2AMLogic/gf180-temp-por/README.md

# gf180-temp-por

A temperature sensor + power-on-reset (POR) pair, targeting the
[gf180mcu](https://gf180mcu-pdk.readthedocs.io/) open PDK.

fleet burndown

## What this is

This is one of 2AM Logic's canary blocks: a small, self-contained analog
IP block used both as a real design deliverable and as a forcing function
for the open-source analog tooling it's built with. The design work —
architecture survey, device characterization, schematic entry, testbench
authoring, simulation, and (eventually) layout — is carried out by AI
agents driving an open-source flow end to end.

## Status: early-stage, in progress

Nothing here should be read as a finished or measured result — there is
no silicon yet, and no tapeout-ready sign-off. As of this writing the
project has:

- ratified a target specification and architecture direction through a
  series of recorded decisions (`spec/decision-records/`),
- characterized the relevant gf180mcu devices (vertical PNP, resistor
  flavors, MOS options) against a bootstrap simulation harness,
- recorded PVT-corner simulation evidence for the schematic-level design
  (`sim/`, append-only),
- entered the block's top-level schematic hierarchy and pad interface in
  xschem, with a reproducible ngspice netlist export (`design/`),
- brought up a repeatable, klayout-tools-driven DRC/LVS flow and drawn
  all four of the block's sub-circuits — `bias_core`, `por_comparator`,
  `por_output_chain` and `temp_core` — plus the top-level assembly
  `temp_por_top`, as real device geometry: DRC clean and LVS-matched
  against their schematic-derived netlists, with the reports committed
  under `layout/reports/` (issues #90, #91, #92, #93 for the cells and
  #97 for the reassembly, all closed), and
- re-run the whole verification suite against a parasitic-extracted
  netlist of that layout, recorded as new append-only evidence in `sim/`
  (issue #18 and its children #82–#87).

**Where that leaves the layout.** It is drawn and assembled. DRC is
clean on all five cells including `temp_por_top` (239 devices, 143
nets), and each is LVS-matched device-for-device and net-for-net against
its schematic-derived reference netlist — **whole**, with no device
excluded. The last exclusion was `temp_core`'s MiM compensation cap
`XCC`, spliced into post-layout netlists at its schematic value rather
than drawn; it is drawn and routed as of #259, executing
[DR-028](spec/decision-records/DR-028-temp-core-xcc-draw-it.md) (issue
#177), which found both of its recorded justifications expired. Nothing
in `layout/postlayout/` is spliced in ideal any more. Recorded `sim/`
results that predate it stay valid for the netlists they name, and say
so in their own provenance lines. The separate
[`ERC supply report`](layout/reports/temp_por_top/erc_supply.json) now
checks four declared well/substrate-tie classes: zero findings, all four
checked, none skipped. This checks connectivity using asserted tap/well
geometry; it does not establish implant correctness or latch-up sign-off.
[`layout/README.md`](layout/README.md#ercmissing_tie-now-computed-310)
documents that scope and the separate `klt` build used for this report.

**The assembled footprint measures 1.059 mm² (1334 × 794 µm), not "tiny."**
This block's stated reason to exist includes that a small, self-contained
design "rides along on any shuttle seat" — that claim had no number behind
it until now. The measured footprint is ~21× the ≤0.05 mm² wave-1 planning
budget `spec/target-spec.md#area` carried before layout (the sum of the
four sub-cells' own boxes is smaller, ~0.34 mm², still ~7× over). The
planning bound is recorded as **not met**, not deleted or relaxed — see
[DR-022](spec/decision-records/DR-022-area-post-layout-measurement.md) for
the measurement convention and the disposition, and
[`layout/reports/temp_por_top/stats.json`](layout/reports/temp_por_top/stats.json)
(regenerated by `layout/run_checks.sh`) for the regenerable evidence.

**Post-layout verification has run, and the suite is not green.** The
roll-up is
[`design/temp_por_top.md`](design/temp_por_top.md) § "Closing roll-up for
issue #18": every testbench with a DUT in the layout has been re-run
against the extracted netlist across the full 81-point PVT grid, and the
results are recorded rather than summarized away. Reset timing lengthens
by a uniform ~2 %, which costs no ratified corner. Several ratified rows
still fail — some from before layout (`spec/` decision records DR-011 and
DR-014/DR-017 own those), some newly under extraction — and each is
routed to its own open issue rather than absorbed. One target was
re-costed against measured evidence through a decision record (DR-018),
not quietly relaxed. And the block's cross-domain IR-drop and crosstalk
question is **not answered by anything in this repository**. The current
`klt 0.6.0` extraction models per-net resistance as a star and includes
vertical-overlap coupling, so first-order rail drop and coupling are now
represented. It still lacks distributed route resistance and lateral/fringe
coupling; the older records used a model with neither effect. As the
[`post-layout roll-up`](design/temp_por_top.md#1-the-ir-drop--crosstalk-watch-item-cannot-be-answered-by-this-repos-tooling-today)
explains, no record in `sim/` may be cited as cross-domain IR-drop or
crosstalk evidence.

Full testbench sign-off has not happened. Every claim this project makes
is expected to be backed by a testbench and by PVT corner data recorded
in `sim/`, not asserted without evidence — until a stage is checked off
above, treat it as not yet done.

## The agent-native build

This block is designed, simulated, and verified with AI agents as the
primary workers, driving the flow directly rather than assisting a human
doing the driving. Decisions are captured as they're made
(`spec/decision-records/`), and simulation results are recorded
append-only as evidence (`sim/`) rather than overwritten, so the design
history stays auditable end to end. That's not a caveat on the work —
it's the point of the project: proving out what an agent-driven,
open-tooling analog design flow can actually deliver.

## Toolchain

- **PDK**: [gf180mcu](https://github.com/google/gf180mcu-pdk) (open PDK)
- **Design / simulation**: [xschem](https://xschem.sourceforge.io/) +
  [ngspice](https://ngspice.sourceforge.io/)
- **Layout**: [klayout-tools](https://github.com/2AMLogic/klayout-tools),
  a companion open-source project built to make KLayout-based DRC/LVS and
  layout automation workable for an agent-driven flow. Wherever
  klayout-tools proves awkward or is missing a capability this design
  needs, that friction gets filed as a public issue there — this project
  is one of the reasons that tool exists.

## Chipalooza

This block is the Phase-1 entry for its class in
[Open Circuit Design's Chipalooza Challenge #3](https://opencircuitdesign.com/chipalooza/challenge-3.html)
(GF180MCU / Wafer.Space). The proposal document —
[`docs/chipalooza/challenge-3-proposal.md`](docs/chipalooza/challenge-3-proposal.md) —
re-derives every numeric claim from this repository's own `sim/` evidence at
the challenge's rails, and explicitly marks the rows and the rail (5.0 V)
that are not yet characterized.

## Layout of this repo

```
spec/          target specification + decision records
design/        schematics / netlists (xschem)
sim/           testbenches + PVT corner results (ngspice)
layout/        GDS + DRC/LVS reports (klayout-tools driven)
signoff/       machine-graded T1 evidence claim + verdict (klt signoff)
measurements/  silicon characterization (empty until tape-out)
```

The block's target specification — one row per spec line, with conditions,
binding corner, and the decision record each value comes from — is
[`spec/target-spec.md`](spec/target-spec.md); the decisions behind it are in
[`spec/decision-records/`](spec/decision-records/).

## Simulation

PVT corner runs go through the harness in `sim/` (stdlib python3, no venv;
needs `ngspice` and a gf180mcu PDK install):

```bash
python3 sim/run_corners.py --check-env     # is ngspice + the PDK present?
python3 sim/run_corners.py --list          # experiments, corners, corner sets
python3 sim/run_corners.py <experiment>    # run the full PVT grid, mint a record
bash sim/selftest.sh                       # prove the harness works end to end
source sim/env.sh                          # same PDK in an interactive ngspice/xschem
```

Every run writes an append-only evidence record under
`sim/<experiment-slug>/records/`. The record format is authoritative in
[`sim/README.md`](sim/README.md); how to run the harness and write a
testbench is in [`sim/harness/README.md`](sim/harness/README.md).

## Layout verification

DRC and LVS run headless through [`klt`](https://github.com/2AMLogic/klayout-tools)
(no GUI, no PDK install needed for the checks themselves):

```bash
bash layout/run_checks.sh --check-env      # which klt / deck / PDK
bash layout/run_checks.sh                  # DRC + LVS + both negative controls
```

Reports land under `layout/reports/` and are committed as evidence. What the
flow proves — and the curated-deck limits that bound it — is documented in
[`layout/README.md`](layout/README.md).

## Evidence maturity: where this block sits on the T1 ladder

klayout-tools defines a four-tier evidence ladder
([`docs/design-evidence-tiers.md`](https://github.com/2AMLogic/klayout-tools/blob/main/docs/design-evidence-tiers.md));
T1, "sim-validated", has an eleven-item checklist. **This repo's answer to
"how far along is it?" is graded mechanically, not written by hand:**

```bash
uv tool install --force klayout-tools==0.7.0   # the pinned grader
python3 signoff/check.py                        # re-grade; fails on evidence rot
```

- [`signoff/block-manifest.json`](signoff/block-manifest.json) is the claim —
  per checklist item, the evidence envelope that backs it.
- [`signoff/tier-report.json`](signoff/tier-report.json) is the verdict
  `klt signoff --manifest` rendered against it, committed as evidence.
- [`signoff/README.md`](signoff/README.md) reads that verdict out item by item,
  with the coverage gaps and disclosed exceptions each `met` row carries.

The verdict today is **`tier: null` — 8 of 11 items met**. That is deliberately
a stricter question than "does the repo contain the artifact?", and the report,
not any prose in this repo, is the answer of record. CI re-runs it on every
push and pull request, so a claim citing an artifact that has since changed
fails rather than quietly rotting.

## Independent verification (Chipalooza)

Written for someone who has never touched this repository. This is what the
Chipalooza schematic-design review's stated bar
([2AMLogic/2am#542](https://github.com/2AMLogic/2am/issues/542), quoted in
full in [issue #292](https://github.com/2AMLogic/gf180-temp-por/issues/292))
needs: clone this repository, install the prerequisites below, and reproduce
the full simulation campaign behind
[`docs/chipalooza/challenge-3-proposal.md`](docs/chipalooza/challenge-3-proposal.md)'s
§4 spec table from three single command-line invocations, with no step that
only works from this repository's already-checked-out state — plus two short
named derivation commands for five rows that need a manual second step (see
"[Mapping the proposal's spec table to output
files](#mapping-the-proposals-spec-table-to-output-files)" below).

### Prerequisites

| Tool | Version | Why | Install |
|---|---|---|---|
| `ngspice` | any recent release (`ngspice-46` is what this repo's own evidence and CI use) | circuit simulation | `apt-get install ngspice` / `brew install ngspice` |
| gf180mcu PDK | `open_pdks` commit `c6d73a35f524070e85faff4a6a9eef49553ebc2b` — the revision this repo's committed `sim/` evidence and `.github/workflows/ci.yml` are taken against | device models | `pip install volare && volare enable --pdk gf180mcu c6d73a35f524070e85faff4a6a9eef49553ebc2b`, or an equivalent [`ciel`](https://github.com/efabless/ciel)/[IIC-OSIC-TOOLS](https://github.com/iic-jku/iic-osic-tools)-provisioned install |
| `xschem` | ≥ 3.4.7 | schematic capture / netlist export — **not** needed to run `make check`/`make smoke`/`make characterize` below, which simulate the netlists already committed under `design/netlist/`; only needed to regenerate them | build from source per [`design/README.md`](design/README.md)'s Requirements note (Ubuntu's apt package below 3.4.7 has a netlisting regression) |
| python3 | ≥ 3.9 | the simulation harness itself | stdlib only — no pip packages needed for `make check`/`make smoke`/`make characterize` |
| `klayout-tools` (`klt`) 0.6.0, KLayout, Magic, Netgen | pinned in [`layout/toolchain.json`](layout/toolchain.json) | layout DRC/LVS/extraction | `uv tool install --force klayout-tools==0.6.0`; KLayout/Magic/Netgen themselves come bundled with a `ciel`/IIC-OSIC-TOOLS PDK install, or install separately per `klayout-tools`' own docs |

The last row is listed for completeness of the open-source flow this project
uses end to end ([`layout/README.md`](layout/README.md)); it is **not**
exercised by the three `make` targets below, which are simulation-only —
layout DRC/LVS is `bash layout/run_checks.sh` (previous section), a separate
entry point with its own toolchain pin. No tool anywhere in this flow is
proprietary.

**PDK environment.** The harness never hardcodes a PDK path. Set **one** of
`GF180_PDK_PATH=/path/to/gf180mcuD` (the variant directory itself) or
`PDK_ROOT=/path/to/pdk/root` (+ optionally `PDK=gf180mcuD`, the
open_pdks/OpenLane convention) before running any target below —
`python3 sim/run_corners.py --check-env` reports exactly what got resolved,
and `sim/harness/README.md`'s "Prerequisites" section documents the full
resolution order (`sim/harness/pdk.py`) if neither is set.

### The three make targets

Run these from the repository root.

| Target | What it does | Measured wall-clock (8-core host, this repo's own dry run below) | Exit code |
|---|---|---|---|
| `make check` | `sim/build_tb.py --check` (testbench fragments match `design/netlist/` exports) + `make test` (`sim/tests`/`layout/tests`/`signoff/tests`/`scripts/tests` unit tests) (headless, no PDK needed) + an explicit environment/PDK report (`sim/run_corners.py --check-env`) | ~2 s | non-zero on any failure, including a missing PDK or ngspice |
| `make smoke` | `sim/selftest.sh`: harness unit tests plus a full-PVT-grid (81-point) run of the harness's own acceptance testbench, `sim/smoke-bias/` (an ideal divider, a PDK poly-resistor/nfet bias, and the same vertical-PNP diode the sensing core's CTAT leg is built from) — proves ngspice, the PDK, and the corner-sweep mechanics all actually work, fast | ~3-4 s | non-zero on any failure |
| `make characterize` | The full campaign behind the proposal's §4 spec table: every **schematic-level** experiment discovered under `sim/*/testbench/` — the full 81-point PVT grid for a deterministic experiment (`sim/run_corners.py`), or the full N≥500-per-binding-point Monte Carlo sweep for one that carries an `"mc"` block (`sim/run_mc.py`) — each minting a new append-only evidence record | see "Fresh-clone dry run" below | non-zero if any experiment fails |

`make characterize` is `python3 sim/characterize.py`, a thin driver over the
two entry points above (`sim/characterize.py`'s module docstring has the
full rationale, including why `testbench-postlayout/` re-runs are
deliberately out of scope — they are triggered by a layout change, not by
routine characterization, and this project's post-layout re-run already
exists as separately-recorded evidence). List what a run would do without
running it (`python3 sim/characterize.py --list`), or run just one
experiment (`python3 sim/characterize.py --only <slug>`) — both useful for
checking one spec row without paying for the whole campaign.

### Where results land

Every `make characterize` run mints one new `<record-id>` per experiment and
writes, under `sim/<experiment-slug>/`:

- `records/<record-id>.md` — the append-only summary record (the field set
  [`sim/README.md`](sim/README.md) defines)
- `netlist-snapshots/<record-id>.spice` — the frozen netlist fragment that
  record was taken against
- `corners/<record-id>/<corner-id>.log` — raw ngspice output, one file per
  PVT point (or per Monte Carlo sample)

Records are **never overwritten**; re-running `make characterize` mints new
record-ids alongside whatever is already committed, per `sim/README.md`'s
append-only rule.

### Mapping the proposal's spec table to output files

[`docs/chipalooza/challenge-3-proposal.md`](docs/chipalooza/challenge-3-proposal.md)
§4's Evidence column already names, for every row, the exact
`sim/<slug>/records/<record-id>.md` file that row's number was measured
from. Because every `make characterize` run mints a **new** record-id by
design (the append-only rule above), the literal filename in that column is
not what your own run will reproduce — the stable mapping is the
**experiment slug**, the path component right after `sim/`. Read the slug
out of an Evidence citation (e.g. `sim/por-vth/records/...` → `por-vth`) and
look in `sim/<that-slug>/records/` for the record your run just wrote.
`python3 sim/run_corners.py --list` / `python3 sim/run_mc.py --list` print
every slug next to the spec claim it substantiates, and
`python3 sim/characterize.py --list` prints the same slugs in the order a
full campaign runs them.

**Two exceptions**, both disclosed at their row in the proposal's §4 table:
`sim/temp-accuracy-mc/`'s `-breakdown.md` attribution file (§4.1) and every
`sim/por-iq/*-derived.md` file (§4.3) are not written directly by
`make characterize` — each is a second, manual derivation step run against a
record `make characterize` did mint (`python3
sim/temp-accuracy-mc/analyze_breakdown.py <record-id> --write` and `python3
sim/por-iq/analyze_por_iq.py <temp-accuracy-vt-record-id> --write`,
respectively). `por-iq` itself has no `testbench/tb.json` and is not one of
the 22 slugs `sim/characterize.py --list` enumerates — do not look for it
there. (§4.4's footprint row is a third exception, but a categorically
different one: it is layout evidence, regenerated by
`bash layout/run_checks.sh`, not simulation evidence at all.)

### Fresh-clone dry run

Performed against a real `git clone --no-local` of this work into `/tmp`
(forces an actual file copy, not a hardlinked shortcut back to the
development checkout), with the environment stripped to `HOME`, `PATH`, and
`GF180_PDK_PATH` only (`env -i`) — nothing else carried over from the
development shell:

```
$ git clone --no-local <this-repo> /tmp/gf180-dry-run/repo    # 7.5s, 22,997 files
$ cd /tmp/gf180-dry-run/repo
$ env -i HOME="$HOME" PATH="$PATH" GF180_PDK_PATH=~/.volare/gf180mcuD make check    # 4.4s, exit 0
$ env -i HOME="$HOME" PATH="$PATH" GF180_PDK_PATH=~/.volare/gf180mcuD make smoke    # 4.6s, exit 0
$ env -i HOME="$HOME" PATH="$PATH" GF180_PDK_PATH=~/.volare/gf180mcuD make characterize
```

`make check` and `make smoke` both passed (exit 0) from a directory tree
that had never seen this repository's development checkout — no absolute
path, cached result, or machine-local script from that checkout was needed.

`make characterize` correctly drove `sim/characterize.py` against the fresh
clone: it discovered all 22 experiments, resolved the same PDK via
`GF180_PDK_PATH`, and began minting real per-corner ngspice logs for the
first experiment. **A clean single-number wall-clock total for the full
22-experiment campaign is not available from this dry run**: the host this
was performed on was, at the time, running roughly two dozen other
unrelated ngspice processes from other agents' concurrent work in sibling
worktrees (visible in `ps aux`) — on an 8-core machine, that is what
actually turned one PVT point's cost from the ~1.5 s measured in relative
isolation (below) into 10-20 s, not anything about this fresh clone or
`sim/characterize.py` itself. The run was stopped after 6m28s, 30/81 points
into the first of 22 experiments, rather than let it continue for an
unbounded time under that contention. A more honest wall-clock reference is
the two full-campaign-representative runs measured earlier in this same
session, in relative isolation, against the same PDK:

| Experiment | Grid | Measured wall-clock (`-j 4` default, 8-core host, uncontended) |
|---|---|---|
| `por-vth` (full-assembly, transient, 81-point PVT grid) | PVT | 127.4 s |
| `por-threshold-mc` (5 binding points × N=500 samples) | Monte Carlo | 181.4 s |
| `smoke-bias` (harness self-test, 81-point PVT grid) | PVT | 1.8 s |

Extrapolating those across the 20 discovered PVT-grid experiments (transient
lengths vary; `por-vth` is a heavier-than-typical full-assembly case, not
the average) plus the 2 Monte Carlo experiments puts a full
`make characterize` campaign at **on the order of 30-60 minutes on an
uncontended host** — this is an estimate from partial, isolated
measurements, not a single measured total, for the reason above. What *is*
directly verified, from this same dry-run clone and from the development
checkout alike: `sim/characterize.py --list` correctly enumerates all 22
experiments (`sim/tests/test_characterize.py`), `--only <slug>` correctly
restricts a run to one experiment, and a representative subset run
(`smoke-bias`, `por-threshold-mc`) completes and exits 0 end to end,
including minting real evidence records.

## License

Apache License 2.0 — see [LICENSE](LICENSE).
