2AMLogic/gf180-temp-por/layout/README.md

# layout/ — DRC/LVS flow for gf180mcu, driven by klayout-tools

This directory holds the block's layout artifacts and the **repeatable DRC/LVS
invocation** they are checked with. It is `klt`-driven end to end: no GUI, no
interactive KLayout session, no netgen/magic.

> **Status: the block's layout is drawn and assembled — as far as the deck can
> see it.**
> #16 brought the flow up on one two-device proof cell. #68 added `bias_core`
> (**34** MOS devices), #69 `por_comparator` (**18**), #70 `por_output_chain`
> (**28**, after issue #56's release latch) and #71 `temp_core` (**55** drawn:
> 39 schematic MOS split into
> interleaved fingers, plus 6 edge dummies). #72 assembles all four into
> **`temp_por_top`** — with the domain-seam moat, the perimeter guard ring and
> the `VDD`/`VSS` rails. #92 then drew `por_output_chain`'s **2 MiM caps** (5
> drawn units) as the first non-MOS devices in the block, and #93 folded
> `temp_core`'s PNP array and `R2` gain ladder into the extracted cell as real
> `bjt`/`ppolyf_u` devices (**114** drawn, up from 55), retiring the sibling
> top cells that used to hold them. #91 then drew `por_comparator`'s
> 3-segment sense divider as real `ppolyf_u_1k`-class poly resistors (**21**
> drawn, up from 18), and #90 drew `bias_core`'s **16**: 10 vertical PNPs, 4
> poly resistors (strung into 24 legs) and 2 MiM caps. Finally #259 drew
> `temp_core`'s own MiM cap `XCC` (**115** drawn, up from 114), which was the
> last golden device anywhere in the block that the layout did not draw.
> **Every sub-circuit is now whole at the *cell* level, with nothing left
> over** — every device in all four schematics is drawn, extracted and
> compared. `temp_por_top` has caught up with all four of #90/#91/#92/#93 and
> issue #56's release latch (#97): re-deriving its floorplan against the four
> grown sub-cell footprints (`por_comparator`'s divider and `bias_core`'s
> passives had each outgrown the #72-era gap between instances) took the
> assembly from **198** to **238** devices and **131** to **159** nets, and
> #259's cap takes it to **239** (the net count is **145** since #264 routed
> the MiM plates onto real nets) — same ratified 5-pad pinout, same
> guard-ring/rail/seam-moat treatment. Every cell under test is
> LVS-clean against the schematic-derived netlist with every applicable
> negative control detected (three per cell where a cell draws a resistor or a
> bipolar: topology, device-param, and passive-param). **DRC is clean
> everywhere, and the committed reports now say so.** `por_comparator`'s
> committed `drc.json` used to read `clean` while recorded under an older
> `klt` whose `"enclosing"` primitive missed zero-overlap escapes
> ([klayout-tools#318](https://github.com/2AMLogic/klayout-tools/issues/318),
> fixed upstream); that cell's *unchanged* committed GDS failed **2×
> `poly2.enclosing.contact.1`** under a newer deck — a real drawing defect
> that was always there, fixed by #102, root-caused by #103 (which also added
> the deck-hash guard that catches this class of stale-report drift), and
> confirmed clean again by #106's whole-flow re-regeneration (which also added
> the GDS-hash guard below, catching the same class of drift one level deeper —
> a report disagreeing with *its own* GDS rather than with another report's
> deck). `temp_por_top`'s own #97 re-derivation picks up that fix by
> rebuilding against `por_comparator`'s current (post-#102) GDS, so the
> reassembled top cell is DRC-clean too, not just its four sub-cells in
> isolation. Every committed report now names the one same `klt` deck and the
> one same GDS it was generated from — the `por_comparator` section and
> [Known deck limits](#known-deck-limits--what-a-clean-lvs-here-does-not-prove)
> have the full trace.
> `temp_core`'s own MiM cap is the one device still outside what the curated
> deck can extract, deliberately not drawn *into the extracted cell*, and
> inherited unchanged by `temp_por_top`, which therefore cannot be LVS'd whole
> either (see
> [The cells under test](#the-cells-under-test) and
> [Known deck limits](#known-deck-limits--what-a-clean-lvs-here-does-not-prove)).
> **What no check in this flow covers** is guard-ring and well-tie
> *correctness*: the deck has no tap or well-label layer, so a broken or
> floating ring is DRC-clean and LVS-match. `temp_por_top` therefore carries
> its own build-time geometric checks for that; see its section below.
> #17's floorplan sketch and matching plan — the ranked, #15-data-driven
> common-centroid/interdigitation/guard-ring plan this flow's cells implement —
> is [`layout/floorplan.md`](floorplan.md).

## Run it

```bash
bash layout/run_checks.sh              # every cell under layout/cells/
bash layout/run_checks.sh <cell>       # one cell
bash layout/run_checks.sh --check-env  # what klt/PDK am I about to use?
bash layout/run_checks.sh --regen-all  # re-stamp every cell onto
                                       # one deck (see 0b below)
```

Exit 0 means, for every cell: the committed GDS and reference netlist are
current, DRC is clean, extraction succeeded, LVS matches, **and** both LVS
negative controls were detected. Every JSON report is rewritten under
`layout/reports/` and committed as evidence.

### The pinned toolchain

Every report under `layout/reports/` is evidence for **one** `klt` build, and
which one is declared in [`layout/toolchain.json`](toolchain.json):

```json
"klt":  { "version": "klt 0.6.0", "install": "uv tool install --force klayout-tools==0.6.0",
          "release": { "package_version": "0.6.0", "git_tag": "v0.6.0", "git_commit": "c622e8ad…" } },
"deck": { "name": "gf180mcu", "content_hash": "sha256:95c2eb91…" }
```

The **deck content hash is the identity**, not the version string. A source
build of `klayout-tools` made after a release tag still reports that tag's
package version, so a post-tag build and the release it was built after both
say `klt 0.6.0` while shipping different decks — which is how this repo's
entire committed evidence base came to name a deck no release ships (#258; see
[Known deck limits](#known-deck-limits--what-a-clean-lvs-here-does-not-prove)
for the full account and the tool-side issue it was filed as). The pin moved
from `klt 0.2.0` to `klt 0.6.0` in #311/#312 — see "Known deck limits" below
for what changed in the deck between those two releases and what it meant for
this block's reference netlists.

Two gates enforce the pin, and they check different things:

- **Live**, before anything is written: `run_checks.sh` probes the `klt` on
  `PATH` (a throwaway `klt drc` on the smallest committed cell) and refuses to
  run unless the deck hash it reports *is* the pinned one. The error names the
  install command. This is what makes the pin a precondition rather than a
  note.
- **Committed**: `python3 layout/lvs_reference.py --check-deck-hash` requires
  every committed `drc.json` to name the pinned hash — not merely to agree
  with its neighbours, which is the check that passed all the way through the
  incident above.

Moving the pin is a deliberate act: edit `layout/toolchain.json`, install that
build, and run `bash layout/run_checks.sh --regen-all` to re-stamp every
cell onto it in one go.

### Prerequisites

| Need | Why | Check |
| ---- | --- | ----- |
| the **pinned** [`klt`](https://github.com/2AMLogic/klayout-tools) on `PATH` | runs DRC, extraction, LVS | `bash layout/run_checks.sh --check-env` |
| the `klayout` python module | only to *rebuild* `layout/cells/*.gds` | `python3 -c "import klayout.db"` |
| a gf180mcu PDK install | not required by this flow | `klt pdk find` |

`klt --version` is deliberately **not** the check in that first row: it cannot
tell the pinned release from a source build made after it. `--check-env`
reports the pin, the live deck hash, and whether they agree.

`run_checks.sh` finds the `klayout` module on `python3`, else on `klt`'s own
interpreter, else via `uv run --with klayout python3`; if none of those work it
skips only the GDS staleness check and still runs DRC/LVS.

The curated `gf180mcu` DRC and extraction decks are self-contained inside
`klt` — **no PDK install is read** by `klt drc`, `klt extract`, or `klt lvs`
here. That is why this flow runs in environments where the simulation flow
(`sim/`, which does need the PDK) cannot.

## What the flow does, step by step

Everything below is what `run_checks.sh` runs; it is spelled out so a step can
be run by hand while debugging a cell.

**0. Live-toolchain gate.** The very first thing, before any staleness check
and before any report is written: the `klt` on `PATH` has to be the one
[`layout/toolchain.json`](toolchain.json) pins, established by the deck
content hash it actually produces rather than by the version string it
reports. See ["The pinned toolchain"](#the-pinned-toolchain) above for why the
version string is not enough. `bash layout/run_checks.sh --check-env` runs the
same gate and prints both sides without running anything else.

**0a. Staleness gates.** Both generated inputs are regenerated and compared
against what is committed, so a recorded clean run can never be a run against
sources that have since moved:

```bash
python3 layout/build_cells.py   --check   # committed GDS still matches its source
python3 layout/lvs_reference.py --check   # reference netlist still matches design/
```

**0b. Deck-hash gate.** A recorded DRC-clean verdict is only meaningful
relative to one `klt` deck revision, so every committed
`layout/reports/*/drc.json` has to agree on `provenance.deck.content_hash` —
otherwise the evidence describes two different rule sets and a clean report
for one cell says nothing about another's — **and** that one hash has to be
the pinned one, or the whole directory can agree perfectly on a deck nobody
can install (#258). Unscoped even for a single-cell run, since it is a
property of the whole `layout/reports/` directory, not of any one cell:

```bash
python3 layout/lvs_reference.py --check-deck-hash
```

##### Repairing a split: `--regen-all`

The gate's remediation is "regenerate every cell's reports against
one deck" — but the command that does that is `run_checks.sh` itself, which
aborted *at the gate* before it could regenerate anything. A directory that had
legitimately drifted (two correct single-cell PRs landing days apart under
different `klt` builds, each regenerating only its own cell as the convention
below requires) therefore could not be repaired with the documented command, and
every invocation of the script — single-cell runs included — was blocked (#108).

`bash layout/run_checks.sh --regen-all` is the way out. It **defers** the gate
to after the per-cell loop rather than skipping it:

| | plain / single-cell run | `--regen-all` |
| --- | --- | --- |
| deck-hash gate | before any per-cell work | after the per-cell loop |
| on failure | aborts (`set -e`), nothing rewritten | non-zero exit, run is a failure |
| cells | as named (all, or the ones given) | every cell, always |

Deferring is not weakening, and the distinction is the whole point of the flag:

- it is opt-in and never the default — a plain run and a single-cell run still
  gate before touching anything, so a genuinely drifted `layout/reports/` fails
  loudly exactly as it did before;
- `--regen-all` rejects cell arguments (exit 2). It can only ever *establish*
  one shared deck across every cell, never re-stamp a subset — a
  partial regeneration is precisely what produces the drift it exists to fix;
- the same check still has to pass on the **result**, and a failure there fails
  the run. Nothing in the script can waive it.

Note that `--regen-all` defers only the deck-hash gate. The GDS-hash gate below
still runs before the per-cell loop on every invocation, including this one: it
guards a different invariant (a committed report describing a GDS it was not
generated from), and letting a regeneration run overwrite that evidence before
it is checked is exactly what it exists to prevent.

**0c. GDS-hash gate.** A recorded report only means something if it is a
description of the GDS actually committed alongside it. `por_comparator`'s
false-clean `drc.json` (`status: clean`, `violation_count: 0`, empty
`violations`) was textually indistinguishable from a genuine clean one before
#102's fix, because nothing in the report recorded which GDS bytes it was run
against — only manual inspection against a rebuilt stream caught it (#106).
Every committed `layout/reports/<cell>/{drc,extract,lvs,stats}.json` now pins a
digest of its source GDS (`drc.json`/`extract.json`/`stats.json`:
`provenance.gds_sha256`, spliced in by `run_checks.sh` right after `klt drc`/
`klt extract`/`klt stats` write the file, since none of them writes it itself;
`lvs.json`: `environment.layout_sha256`, already `klt lvs`'s own output), and
so does `extracted-parasitics.json` (`layout/postlayout.py --extract`'s own record,
which writes the digest itself — see "Post-layout netlists" below). This
recomputes `sha256(layout/cells/<cell>.gds)` and fails if it disagrees with
any of those, so a cell whose GDS moves without its extraction being re-run
cannot ship a post-layout netlist of a layout that no longer exists. Also unscoped even for a single-cell run:

```bash
python3 layout/lvs_reference.py --check-gds-hash
```

All three gates run before the first per-cell check, and `run_checks.sh` is
`set -e`, so a cell that fails one of them used to abort the whole script —
including the cells that were current (#102).

#### Freezing a cell

There is no cell-freeze mechanism any more. It held a cell's committed
artefacts at a pinned digest (`FROZEN_CELLS` in `lvs_reference.py`, read by both
`--check` paths and by a report guard in `run_checks.sh`) while a tracking issue
reworked it; `temp_por_top` was the only cell ever frozen, and that ended with
#97. With no entries it was dead scaffolding, so #411 removed it. If a future
cell needs a freeze, recover the design from history:
`git log -S"FROZEN_CELLS" -- layout/lvs_reference.py` (the removal is the PR
that closed #411).

**1. DRC.**

```bash
klt drc layout/cells/<cell>.gds --deck gf180mcu --format json
```

Exit 0 = clean, 3 = ran and found violations, 1 = failed to run.

**2. Extraction** — the layout side of the compare, recorded for `#18` to reuse:

```bash
klt extract layout/cells/<cell>.gds --deck gf180mcu \
  --top <cell> -o layout/reports/<cell>/extracted.spice --format json
```

**3. LVS** against the schematic-derived reference. `klt lvs` takes a *request
document*, not positional netlist args; the request re-extracts the layout
inline, so step 2 is recorded evidence rather than a dependency:

```bash
klt lvs layout/cells/<cell>.lvs.json --format json
```

Exit 0 = match, 3 = mismatch, 1 = failed to run.

**4. Footprint / drawn-area stats** — the regenerable source of
[`spec/target-spec.md#area`](../spec/target-spec.md#area)'s measured value
(see [DR-022](../spec/decision-records/DR-022-area-post-layout-measurement.md)):

```bash
klt stats layout/cells/<cell>.gds --format json
```

Needs no `--deck` — `klt stats` reads geometry only (bounding box, total
drawn/union-of-layers polygon area, density, polygon/vertex counts), not
device recognition, so it carries no `provenance.deck` block and sits outside
the deck-hash consistency gate above; only the GDS-hash gate applies to its
report (`stats.json`'s spliced-in `provenance.gds_sha256`, same convention as
`drc.json`/`extract.json`).

**5. Negative controls — the part that makes step 3 mean anything.** A
mis-wired LVS invocation that compares nothing also reports `match`, so a clean
run is not by itself evidence. `layout/lvs_reference.py --corrupt` re-derives
the same reference with exactly one defect injected, and the run **requires**
LVS to report a mismatch for both:

| Control | Defect injected | Catches |
| --- | --- | --- |
| `topology` | one device's source re-tied to the other's supply rail | a compare that ignores connectivity |
| `device-param` | one device's `W` doubled | a compare that checks the graph and ignores device sizes |

They fail independently — that is why there are two, per klayout-tools'
`docs/cli/lvs.md` § "Negative controls".

## Files

```
layout/
  run_checks.sh                  the repeatable invocation (source of truth)
  toolchain.json                 the pinned klt build + deck content hash
  build_cells.py                 builds cells/*.gds, byte-reproducibly
  lvs_reference.py               derives cells/*.reference.spice from design/netlist/
  postlayout.py                  derives postlayout/*.spice from the extraction
  cells/
    <cell>.gds                   the layout stream
    <cell>.reference.spice       generated -- do not edit
    <cell>.lvs.json              the klt lvs request document
    temp_por_top.erc-supply-spec.json  T1 item 11's klt erc supply spec (#300)
    temp_por_top.erc-supply-spec-NOTES.md  the spec's field-justification block
                                  (moved out of the spec itself: klt 0.7.0
                                  rejects unknown spec keys, #2243)
  postlayout/
    <cell>.spice                 the simulatable post-layout netlist
    audit.json / AUDIT.md        what is the layout's and what is not
  reports/
    environment.json             klt version + deck hash + release the reports
                                  were produced with (after the fact; the
                                  precondition is toolchain.json above)
    <cell>/drc.json              klt drc report
    <cell>/extract.json          klt extract report
    <cell>/extracted.spice       the layout-side netlist
    <cell>/lvs.json              klt lvs report
    <cell>/stats.json            klt stats report (bbox footprint + drawn area;
                                  spec/target-spec.md#area evidence, DR-022)
    <cell>/negative-controls.json both controls' verdicts
    <cell>/extracted-parasitics.*  the --parasitics extraction (postlayout.py)
    <cell>/postlayout-smoke.json   that cell's smoke result
    temp_por_top/erc_supply.json   T1 item 11's klt erc supply report (#300)
```

`postlayout.py` writes only the `extracted-parasitics.*` pair; the DRC/LVS
flow's own `extracted.spice` / `extract.json` are never touched by it, so the
byte-stability contract above is unaffected.

Reports are regenerated wholesale by `run_checks.sh` and are byte-stable across
runs (paths are repo-relative, digests are content-based), so a re-run that
changes nothing produces an empty `git diff` — that is the repeatability check.

That byte-stability is across runs with the **same** `klt`, which since #258 is
not left to chance: the committed set is homogeneous by construction, because
every report has to name the deck [`layout/toolchain.json`](toolchain.json)
pins and the live gate refuses to write one that would not. A PR that changes
one cell's geometry still regenerates **that cell's** reports and leaves the
rest alone — `reports/` is append-only evidence (`CLAUDE.md`), and restamping
five other cells' recorded runs as a side effect of touching one would destroy
exactly the provenance the directory exists to carry. What has changed is that
a single-cell regeneration can no longer land on a *different* deck than its
neighbours without the gate saying so. Moving to a new `klt` is therefore a
deliberate, separate act: move the pin, then
`bash layout/run_checks.sh --regen-all`.

Every report also records the GDS stream it was generated from
(`drc.json`/`extract.json`/`stats.json`: `provenance.gds_sha256`; `lvs.json`:
`environment.layout_sha256`) — see "0c. GDS-hash gate" above, and #106.

## Post-layout netlists

`layout/postlayout/<cell>.spice` is the layout of each cell as something
ngspice can run: the drawn devices at their drawn dimensions, the drawn
topology, first-order interconnect R/C, and the schematic's own net names.
It is what `sim/` records with **Netlist provenance: extracted** are run
against, and what #83–#87 consume.

#83's four temp-sensing-domain re-runs are among the consumers:
`sim/temp-core-designer-check/` `20260811-075055-b06af8e`,
`sim/temp-core-startup/` `20260811-074657-7c1c116`, `sim/temp-accuracy-vt/`
`20260811-084152-68c0017` and `sim/temp-accuracy-mc/`
`20260811-090721-3ec259f`. The three corner-sweep records each carry a
`<record-id>-postlayout-delta` derived record (`sim/postlayout_delta.py`)
differencing them against the schematic-level record they supersede; zero
checks regressed, and `design/temp_core.md`'s "Post-layout re-run" section
summarises all four.

```bash
python3 layout/postlayout.py --extract   # re-run klt (needs klt + the deck)
python3 layout/postlayout.py             # regenerate layout/postlayout/
python3 layout/postlayout.py --check     # committed artifacts current? (stdlib only)
```

### How it is built, and why there is a build step at all

`klt extract`'s output is a *comparison* netlist, not a simulation netlist,
and three things stand between the two. None of them is a judgement call;
each is either read out of the tool or derived from `lvs_reference.py`'s own
manifest, and all of them are enumerated per cell in
[`postlayout/AUDIT.md`](postlayout/AUDIT.md).

1. **Device cards name the deck's device classes, not the PDK's models.**
   `M$1 ... nfet L=8U W=1U` has to become an `nfet_03v3` subcircuit call.
   `klt extract --pdk` will do this, and it was tried first — it is not used
   because its bound MOS card **drops the extractor's own measured**
   `AS`/`AD`/`PS`/`PD` and the PDK subcircuit defaults all four to zero, i.e.
   the netlist simulates with no junction capacitance whatsoever. Filed as
   [klayout-tools#695](https://github.com/2AMLogic/klayout-tools/issues/695).
   Binding here instead also keeps this whole directory PDK-free, per
   "Prerequisites" above.
2. **Most nets are anonymous.** These cells label only their pins (and, in
   `temp_core`, its 30 tapped nodes), so the rest come out positional — `$10`.
   `klt lvs`'s `net_correspondence` is an LVS-verified map from every
   extracted net to its reference-netlist name, so `$10` becomes `SNS`. This
   is why the old plan of solving the layout↔schematic net correspondence
   here is gone: the tool reports it now
   ([klayout-tools#311](https://github.com/2AMLogic/klayout-tools/issues/311),
   landed in `klt` 0.2.0), and this flow reads it rather than re-deriving it.
   Every cell is required to be `status: match` with every net paired before a
   netlist is written.
3. **Body and well nets come out isolated.** The extraction deck's
   connectivity stack does not join an Nwell, a substrate ring or a bipolar
   base well to the routing that reaches it — which is why every `lvs.json`
   here carries `device.body_unverified`. Honest for a compare; unsimulatable.
   Each is tied to the net the *schematic* puts it on, taken from
   `lvs_reference.py`'s manifest (so a schematic change moves the tie with it)
   and listed per cell in `AUDIT.md` — 3 ties in `por_comparator`, 9 in
   `temp_por_top`. MiM plates used to need the same treatment
   ([klayout-tools#314](https://github.com/2AMLogic/klayout-tools/issues/314),
   **closed and fixed upstream**), but every drawn cap in the block is now
   routed onto its schematic nodes — `bias_core`'s and `por_output_chain`'s
   by #264, `temp_core`'s `XCC` by #259
   ([DR-028](../spec/decision-records/DR-028-temp-core-xcc-draw-it.md)) — so
   their plates are ordinary nets with nothing left to tie.

Two deck substitutions are also undone, both already documented under "Known
deck limits" below: a `ppolyf_u_3k` body recognised as `ppolyf_u_1k`
(klayout-tools#323) and a `..._m3m4_...` MiM recognised as `..._m4m5_...`
(klayout-tools#315). The drawn geometry is the schematic's in both cases and
only the deck's *name* for it differs, so the emitted card carries the
schematic's model at the **drawn** dimensions. Leaving the deck's name in
would simulate this block on a PDK option it is not built for — a 3× error on
every high-sheet-rho resistor, including the POR sense divider.

### What these netlists do and do not prove

| | |
| --- | --- |
| From the layout | every device and its dimensions; the whole topology; first-order R/C on every net with drawn routing (83–97 % of nets per cell — see `AUDIT.md`) |
| From the schematic | the body/well ties above, and net *names* |
| Not present | **nothing.** Every golden device in all four schematics is drawn, extracted and in the netlist; `AUDIT.md`'s "ideal (not drawn)" column reads 0 for every cell. `temp_core`'s `XCC` was the last exception and #259 drew it ([DR-028](../spec/decision-records/DR-028-temp-core-xcc-draw-it.md)) |

So a claim taken on one of these netlists is a post-layout claim about
interconnect loading and device geometry, and a schematic claim about anything
that turns on a body-tie assumption. `sim/README.md`'s **Netlist provenance**
field requires a record to say so. Records written before #259 name netlists
that did splice `XCC` in ideal, and stay valid for those netlists — the
`sim/` set is append-only, and the caveat in each of their provenance lines
still describes the netlist it names.

### Verification

* `klt lvs` must report `match` with every net paired — that is what makes the
  net correspondence, and therefore every net name in the emitted netlist,
  something other than a guess.
* `--extract` refuses to record an extraction whose `--parasitics` coverage
  reads zero (the shape of
  [klayout-tools#283](https://github.com/2AMLogic/klayout-tools/issues/283)),
  and the coverage is reported per cell in `AUDIT.md` so a future silent-zero
  regression is visible rather than merely absent.
* `layout/tests/test_postlayout.py` re-derives every committed artifact from
  the committed extraction and requires a byte-identical result, so the
  staleness gate runs in CI with no `klt`, no PDK and no ngspice. It also
  carries the negative controls: a corrupted net correspondence must move the
  netlist, an unpaired net must be rejected, a wrong emitter area must be
  rejected.
* The golden schematic netlist and the post-layout netlist are compared at
  **every** PVT corner by the `testbench-postlayout/` experiments under
  `sim/` and their `<record-id>-postlayout-delta` records
  (`sim/postlayout_delta.py`), not by a one-point smoke run. An earlier
  nominal-corner script (`postlayout_smoke.py`, with a `SMOKE.md` table) was
  removed once those landed; the `layout/reports/<cell>/postlayout-smoke.json`
  reports it wrote remain as results, and their `note` fields still name it.

The DC quantities agree with the schematic to within a few parts in a
thousand, which is expected and is not a null result. The parasitic model is
one resistive **star** per net — the net's own name is the hub, each device
terminal on it is a `<net>__t<k>` node, and the net's single lumped series
resistance is split across the `R<net>_t<k>` arms joining them, with the net's
lumped C on the hub and vertical-overlap coupling as a direct capacitor
between two nets (`AUDIT.md` → "The parasitic model"). A DC operating point is
therefore *nearly* invariant under it: only the drawn resistance between a
net's own terminals can move one, which is what the residual ≤0.3 % DC deltas
are. What the agreement proves is that the post-layout netlist is the *same
circuit* — `por_comparator`'s `SNS`/`SNSB` carry no drawn label at all, so
reproducing the schematic's 1.61228 V tap to within 0.01 % is only possible if
the correspondence, the divider's restored sheet rho and the body ties are all
right. The reset-release times are where the drawn interconnect actually
bites: `por_output_chain` +4.1 %, `temp_por_top` +4.0 % against the schematic.
Those are the measurements a post-layout claim should be taken on.

Both of those moved from ≈+2 % when the evidence here was regenerated against
the `klt` `layout/toolchain.json` pins (#314), and the reason is the model
rather than the layout: the previous release modelled a net's whole
interconnect as a *dangling* R–C leg (one series R to a synthetic `<net>__par`
node, one C from that node to the substrate), so its resistance sat in no
signal path at all and only its capacitance loaded the circuit. In the star
the same total resistance is in series between each device terminal and the
rest of its net, which is both a larger delay and a more faithful one.

## The cells under test

### `bias_core` — the shared bias/reference core, whole (#68, completed by #90)

`design/bias_core.sch`'s **50 devices** — all of them — drawn from
`design/netlist/bias_core.spice`. 434.9 × 285.7 µm, 3578 polygons.

**What a clean run here covers.** #68 drew the 34 MOS devices and left the
other 16 out, deliberately: the curated deck recognised `nfet`/`pfet` only, so
a drawn poly resistor body extracted as ordinary interconnect and **shorted its
own two terminal nets** (`NB`–`EC`, `VREF`–`ER`, `NBTOP`–`NB`, `NZ`–`N2`),
which then read as a layout bug in the part of the cell that *could* be
checked. The passive/bipolar area was a blank rectangle on annotation layer
200/0 instead. `klt 0.1.0` declares `bjt`, `ppolyf_u_1k` and
`cap_mim_2f0_m4m5_noshield` as well, so #90 drew them:

| Drawn as | Devices | Recognised by |
| --- | --- | --- |
| Vertical PNPs | `XQ1`, `XQ8A`…`XQ8H`, `XQR` (10) | one shared `Nwell` base, a `Comp` emitter window per device, a per-device `DRC_BJT` mark; collector = substrate, not drawn |
| Poly resistors | `XR1`, `XR2`, `XRT`, `XRZ` (4, folded into **24** legs) | `Poly2` + `RES_MK` + `SAB` + `Resistor`, with `Pplus` for the p+ implant; unmarked bends and heads are the terminals |
| MiM caps | `XCC`, `XCOK` (2) | `FuseTop` + `CAP_MK` + `MIM_L_MK` over a `Metal4` bottom plate |

The four formerly-shorted net pairs are now four pairs of **distinct extracted
nets**, and the reserved 200/0 rectangle is gone. Three DRC rules that used to
appear under `rules_skipped` because no stream drew their layers —
`bjt.separation.comp.1`, `mim.space.1`, `mim.enclosing.fusetop.1` — are now
actually exercised.

That the marker geometry is what does it, rather than the compare being
insensitive to it, was confirmed by rebuilding the same cell with one marker
layer moved to a layer no deck reads:

| Defect built | Result |
| --- | --- |
| `RES_MK` removed | 24 `ppolyf_u_1k` devices gone; **54 nets collapse to 30** — the documented short cascade, exactly the failure #68 avoided by not drawing |
| `DRC_BJT` removed | 10 `bjt` devices gone; the base well net disappears (54 → 53 nets) |

Consequences to carry forward, stated so nobody has to re-derive them:

- **Sheet resistance is the PDK's default option, not the schematic's.** The
  schematic instantiates `ppolyf_u_3k`. That whole family — `_1k`/`_2k`/`_3k` —
  is *one drawn device*; which sheet-rho a run gets is a deck-level `POLY_RES`
  option, not drawn geometry. `klt`'s deck models only the PDK's own default
  (`POLY_RES='1k'`), so a drawn leg is recognised as `ppolyf_u_1k` at
  1000 Ω/sq. The compare therefore answers for every leg's **drawn geometry**
  (2 µm wide, exactly the golden `r_length`/legs long) and not for the
  resistance the schematic intends. Known upstream, in
  [klayout-tools#299](https://github.com/2AMLogic/klayout-tools/issues/299)'s
  own non-goals.
- **A fold is N devices, not one.** The deck runs no device-combination step
  and cuts each *marked* leg out of poly separately, so a serpentine extracts
  as one two-terminal device per leg with the unmarked bends as anonymous
  nodes. `lvs_reference.py` emits the same N series legs — the same treatment
  `fingers` gives a multi-finger MOS — so both sides describe the same object.
- **A bipolar's base is an anonymous well and its collector is the substrate
  global.** The deck draws no collector layer and gf180mcu has no well-label or
  tap layer, so the schematic's `VSS` base/collector nodes are rewritten in the
  reference. The drawn Nwell tap ring that ties the base to `VSS` is a
  design-review claim, like every other tie in this repo
  ([klayout-tools#303](https://github.com/2AMLogic/klayout-tools/issues/303)).
- **MiM plates now own the schematic's own net.** At the deck this repo's
  evidence was first produced against, `klt` registered a recognised
  capacitor's plates outside its own metal/via stack, so no drawn routing
  could put a plate on a schematic net
  ([klayout-tools#314](https://github.com/2AMLogic/klayout-tools/issues/314) —
  **closed, fixed upstream** in the pinned `klt 0.2.0`). `XCC`'s two plates
  are now routed (`Metal4`→…→`Metal1` for the bottom plate, `FuseTop`→`Via4`→
  `Metal5`→`Via4`→a second `Metal4` island→…→`Metal1` for the top) onto
  `PG`/`NZ`, and `XCOK`'s onto `VDD`/`NOKX` — the two cards' own golden nodes
  (#264). The drawn device class is still the deck's `m4m5` stack where the
  schematic says `m3m4`
  ([#315](https://github.com/2AMLogic/klayout-tools/issues/315)), undone the
  same way as the resistor sheet-rho substitution above.
- Nothing here says the reference is 1.20 V, that `R2/R1` is 11.726, or that
  the 8:1 emitter ratio *achieves* its target ΔV_BE. Those are `sim/`'s claims,
  unchanged. What the layout now does say is that the 8× leg is drawn as eight
  identical devices centred on the 1× device, and that every resistor leg is
  drawn at the same width.

**Structure.** Routing is Metal1-only throughout; the scheme that makes a
50-device cell routable on one metal is **horizontal Poly2 tracks (one per
signal net) with vertical Metal1 risers**, so a riser crosses every track it
does not belong to with no contact. `VDD` and `VSS` are Metal1 rails above and
below the row (`VSS` now runs the full cell width, because the PNP array's well
tap ties to it). One drawn Nwell holds the whole PMOS row; a second, separate
one is the PNP array's shared base. The passive block sits to the right of the
device row with **its own eight-track band** below it — one track per net a
drawn passive touches — and the five nets that exist in both regions are
carried across by **one Metal1 jog column each**, in the 13 µm gap between
them. The jog columns rise in x with their row track's y, which is what keeps a
jog from ever descending across a track that reaches past it.

**Matching, where the cell actually has a ratio to hold.** `floorplan.md`'s
ranked common-centroid plan prescribes nothing for this cell, and nothing was
invented for the MOS row. The one place a centroid *is* drawn is the pair the
whole reference rests on: **`XQ1` sits at the centre of a 3×3 array whose
perimeter is `XQ8A`…`XQ8H`**, so the 8× leg's centroid is the 1× leg's.
`XQR` — the `VREF` branch's own separate 1× device, not part of that ratio —
takes a fourth column beside the middle row. A unit test asserts the centroid
and the adjacency from the drawn slot table rather than from this paragraph.

The resistors get the matching they *can* get and no more: every leg of every
fold is the golden netlist's own `r_width` (2 µm), the first-order matching
parameter. Leg **lengths** differ per device and have to — `R2/R1` is
4104/350, whose lowest terms need a 2 µm unit leg, i.e. 2227 legs across the
two devices. A non-integer design ratio is a schematic fact, and this layout
does not quietly "fix" it; the fold picks the closest exact division per
device instead (`lvs_reference.resistor_segments`, which also forces an even
leg count so both ends of a fold come out at the same edge).

**Matched pairs** in the MOS row get ordinary matched-pair practice — adjacent
placement, same orientation, identical drawn geometry, common well:
`XMI1`/`XMI2`, `XML1`/`XML2`, `XMOKA`/`XMOKB`, `XMOL1`/`XMOL2`, and the three
core mirror legs `XMP1`/`XMP2`/`XMP3`.

**Guard ring and well ties are drawn, and are a design-review claim, not a
checked one.** A continuous VSS-tied p-substrate guard ring (COMP + Metal1,
contacted at 1 µm pitch, no floating segment) surrounds the cell; the PMOS
Nwell has its own VDD-tied COMP strap and the PNP array's Nwell a VSS-tied tap
ring on three sides (open at the bottom, where every escape riser leaves). Per
[klayout-tools#303](https://github.com/2AMLogic/klayout-tools/issues/303) the
deck has no tap/well-label layer and no ring-continuity rule, so **a mis-tied,
untied, or physically broken ring would compare clean** — this flow does not
verify it. That now bites in one more place than it used to: the PNP base tie
is one of those ties, so a clean LVS says the ten bipolars' bases are one node,
not that that node is `VSS`.

Recorded result (`layout/reports/bias_core/`):

| Check | Result |
| ----- | --- |
| `klt drc --deck gf180mcu` | clean — 0 violations (`bjt.*` and `mim.*` rules now exercised, not skipped) |
| `klt extract --deck gf180mcu` | **70** devices (18 nfet, 16 pfet, 10 bjt, 24 ppolyf_u_1k, 2 MiM), 54 nets, 6 pins |
| `klt lvs` | **match** — 70/70 devices, 54/54 nets, 6/6 pins, 0 errors (2 `device.body_unverified` warnings) |
| negative control `topology` | detected (exit 3; `device.unmatched` 1, `topology` 6) |
| negative control `device-param` | detected (exit 3; `device.property` 5, `topology` 6) |
| negative control `passive-param` | detected (exit 3; `device.property` 11, `topology` 9) |

### `por_comparator` — the POR threshold comparator (#69, sense divider #91)

`design/por_comparator.sch`'s 21 devices, drawn from
`design/netlist/por_comparator.spice`. 445.0 × 164.7 µm, two cells (it
instances the proof cell below).

**All 21 devices are now drawn, extracted and compared.** 18 are MOS. The
other 3 are the sense divider `XRTOP`/`XRBOT`/`XRHYS` (schematic
`ppolyf_u_3k` poly resistors) — reserved as a blank floorplan rectangle
through #69, and drawn for real as of #91: `klt 0.1.0`'s extraction deck
recognises a drawn, `RES_MK`/`SAB`-marked poly resistor as a real
two-terminal device ([klayout-tools#219](https://github.com/2AMLogic/klayout-tools/issues/219)/[#222](https://github.com/2AMLogic/klayout-tools/issues/222)), but only
two flavors of gf180mcu's high-sheet-rho poly family are wired: the base
`ppolyf_u` (350 ohm/sq) and the PDK's own default `ppolyf_u_1k` (1000
ohm/sq, [klayout-tools#299](https://github.com/2AMLogic/klayout-tools/issues/299)). `_2k`/`_3k` are not — filed as
[klayout-tools#323](https://github.com/2AMLogic/klayout-tools/issues/323) since this design specifically needs `_3k`. So each
segment is drawn with `RES_MK`/`SAB`/`Resistor(62,0)` — exactly what a real
`ppolyf_u_3k` resistor's geometry would carry too, since the three flavors
are geometrically identical — and extracts as the deck's `ppolyf_u_1k`
class. `layout/lvs_reference.py`'s reference cards therefore compare each
segment's *drawn* length against the deck's modelled 1000 ohm/sq, not the
schematic's 3000 ohm/sq: a **documented, deliberate fidelity loss**, in the
same spirit as the NMOS/PMOS body-net rewrites below. It is still a
meaningful check for *this* divider specifically: all three segments are
the same poly flavor and width, so the sheet-rho substitution is a common
factor across all three — the check still proves each segment's drawn
length (so its resistance *ratio* against the other two, which is what the
hysteresis ratio actually depends on — `design/por_comparator.md`, "Why the
hysteresis is a resistor ratio") is exactly what the schematic asks for.
What it does not prove is the *absolute* resistance at the schematic's true
3000 ohm/sq corner; that remains `sim/`'s claim, unchanged.

Consequences to carry forward:

- `SNS` and `SNSB` now have **two** terminals each — one MOS (`XMINA`'s
  gate, `XMHSW`'s drain) and one resistor terminal — correcting a stale
  claim from #69 that each had only one (#82's curation of #91 found
  `SNS`/`SNSB` no longer matched that description at all).
- Nothing here says `RTOP/RBOT` is 1.16667, that V_hys is 150 mV, or that
  the three segments match to the schematic's absolute values. Those remain
  `sim/`'s claims.
- Each segment folds into a roughly-square zig-zag serpentine
  (`build_cells.py`'s `_resistor_leg_plan`/`_resistor_string`) whose drawn
  body AREA reconstructs the schematic's own `r_length` exactly (to
  floating-point noise), so no dimension is retyped from the golden
  netlist. The three strings sit side by side past the device row; the
  cell's footprint grew from #69's 313 × 230 µm placeholder-rectangle
  bounding box to 445 × 165 µm as a direct result of drawing real (rather
  than reserved) geometry.
- Routing `SNS`/`SNSB` out to the divider crosses Metal2, not Poly2: a
  Poly2 track spanning the whole divider width would physically cross
  every leg-to-leg gap of all three folded strings, filling each gap with
  unmarked-but-touching Poly2 and bridging every leg together — a real
  short, and the actual root cause of the "resistor shape ignored"
  extraction warnings hit while debugging #91 (the Poly2 track's own
  contacts land within 2, not 20+, distinct clusters once the crossing is
  removed). The two nets instead escape onto Metal2 just past the device
  row (one contact + Via1 each) and cross the divider on that layer, which
  cannot short to the resistor bodies no matter what it passes over. The
  `VDD`/`VSS` supply rails were a second instance of the same class of bug:
  extending either rail's Metal1 all the way to the divider's right edge
  (so `XRTOP`'s `VDD` end and `XRHYS`'s `VSS` end could each reach it with
  a plain riser) meant the rail's own Y-band crossed `XRBOT`'s and
  `XRHYS`'s *other* terminal risers on their way down to the Metal2
  trunks — shorting `SNS`/`SNSB` to `VDD`. Both rails now stop just past
  their own divider terminal instead of reaching the full width.
- That Metal2 escape's own two Poly2 landing contacts were the cell's last
  DRC violations, and the reason this cell is the one that proved a committed
  report can lie (#102): each net's Poly2 track *ended on* its landing
  contact's centre x, so the Poly2 covered only the contact's west half and
  left the east half bare — two `poly2.enclosing.contact.1` (DRM `CO.3`)
  violations in the committed stream, under a committed `drc.json` that said
  `clean`. The report was textually indistinguishable from a genuine clean one
  (`status: clean`, `violation_count: 0`, empty `violations`), which is exactly
  why nothing noticed. Both tracks now run *past* their contact by
  `build_cells.py`'s `_poly2_landing_x1`, which derives the overhang from
  `CO.3` and the contact size rather than from a hand-written coordinate, so
  the enclosure cannot silently go to zero again if the track pitch moves.
- [klayout-tools#288](https://github.com/2AMLogic/klayout-tools/issues/288)'s per-cell warning count for "poly shapes with the
  resistor-body signature but no marker layer at all" is **12** here, not
  lower than #69's baseline of 10 as originally hoped. Root cause: none
  of the 12 are divider geometry — the divider's own marked legs
  contribute *zero* to this count now (down from all of them, since they
  used to be undrawn and so not a factor at all). All 12 are the cell's
  ordinary multi-fanout Poly2 routing tracks (`TN`, `NA`, `CMPO`, `VDDA`,
  `N1`, `POR_RAW`, `NBG`, `IBIAS`, `BIAS_OK`, `BIAS_OKB`, and now `SNS` and
  `SNSB`), which this heuristic cannot distinguish from a resistor body —
  any unmarked Poly2 net touching 2+ separate contacts trips it, resistor
  or not (10 of these tracks already did on #69's committed cell, unrelated
  to the divider; `SNS`/`SNSB` are the two newly added, each because the
  Metal2 escape above gives them a second contact — the one at the
  MOS-gate/drain end they always had, plus the new one where the track
  meets its Via1). A real fix would need the deck to distinguish "this
  candidate is already accounted for by a recognised resistor a few
  microns away" from "this is genuinely unmodelled" — out of scope here.

**The `BIAS_OKB` inverter is instanced, not re-drawn.** `MENP`/`MENN` already
exist as `por_comparator_bias_okb_inv` below, so this cell places one instance
of it. Both `klt drc` and `klt extract` read layers through `begin_shapes_rec`
on the top cell, i.e. flattened, so the instance's geometry — labels included —
joins the parent's own connectivity graph. One consequence is visible in the
reference netlist: the sub-cell carries its own `BIAS_OKB` Metal1 label, a
named top-level net becomes a pin, so `BIAS_OKB` is a **pin** of this cell
rather than an internal node. The manifest declares it as such instead of
deleting a label from an already-proven cell.

**Matching plan — `floorplan.md` rank 4, followed as floorplanned:** standard
practice, **not** common-centroid, for both structures the plan names, because
#15's MC record measures `vth-rise`/`vth-fall`/`v_hys` passing at 100 % yield
regardless of the comparator's own 5.47–6.62 mV offset (the ratio-feedback
hysteresis cancels it architecturally). Concretely: `XMINA`/`XMINB` are
adjacent, same orientation, identical drawn geometry, one substrate context, no
finger splitting and no interleaving, with their gate nets (`SNS`/`VREF`) on
adjacent routing tracks and their drain nets (`NA`/`CMPO`) on the next adjacent
pair, so the two halves' routing differs by one 0.8 µm track pitch; the divider
keeps **W = 2 µm** with same-flavor same-width legs and ordinary serpentine
folding for area — no end-of-string dummy legs, a layout-quality nicety out
of scope for this bring-up pass rather than a tool limit or LVS requirement.
The load mirror `XMLA`/`XMLB` gets the same ordinary matched-pair treatment
although the floorplan names no plan for it. `layout/tests/test_lvs_reference.py`'s
`PorComparatorMatchingPlanTest` asserts each of those properties, so a later
edit that quietly breaks the plan fails a test rather than only a review.

**Guard ring and well ties are drawn, and are a design-review claim, not a
checked one** — same as `bias_core`: a continuous VSS-tied p-substrate ring
(COMP + Metal1, contacted at 1 µm pitch, no floating segment) surrounds the
cell and the parent Nwell has its own VDD-tied COMP strap, but per
[klayout-tools#303](https://github.com/2AMLogic/klayout-tools/issues/303) a
mis-tied, untied, or physically broken ring would compare clean. This cell sits on the always-on
POR domain's side of the block-level domain seam (`floorplan.md`, "Guard-ring /
isolation plan"), so that seam's correctness is exactly what review has to
carry. `klt 0.1.0` still does not emit the `device.body_unverified` warning
klayout-tools#285 added as an extract-time warning — it still only surfaces
as an LVS mismatch category (see the recorded result below).

**`temp_por_top` needed its own follow-up pass, done in #97.** Drawing the
divider for real grew this cell's footprint well beyond #69's placeholder
rectangle, which invalidated `temp_por_top`'s existing instance placement
(confirmed: a `temp_por_top` rebuilt against this change alone was DRC-dirty
at the `por_comparator`/neighbor-cell boundary). #97 re-derived that
placement once all four sub-cells' growth had landed rather than reworking
it once per change — see `temp_por_top`'s own section for the fix and the
2 pre-existing violations (below) it inherits, unrelated to the fix.

**The "clean" DRC row below used to be stale (#102, root-caused by #103, fixed
it; #106's whole-flow regeneration reconfirmed it under the current deck).**
The committed `layout/reports/por_comparator/drc.json` had been recorded
against an installed `klt` build whose `Region.enclosing_check`/
`enclosed_check`-backed `"enclosing"` check primitive only reported *marginal*
violations at facing edges of shapes that already partially overlap — a shape
of the enclosed layer with **zero** overlap with the enclosing layer (the
worst-case enclosure failure, not a lesser one) produced no violation at all.
Filed generically, with no design details, as
[klayout-tools#318](https://github.com/2AMLogic/klayout-tools/issues/318) and
fixed upstream (`klayout-tools` PR #327): the same primitive now also flags
that zero-overlap escape under the same rule id. Rerunning `klt drc` against
this cell's then-*unchanged* committed GDS with the fix installed reported 2
violations of `poly2.enclosing.contact.1` (DRM `CO.3`, 0.07 µm Poly2-over-
Contact — a threshold that has never moved: `gf180mcu.py`'s
`poly2.enclosing.contact.1` entry is unchanged since it was first authored),
both at the `SNS`/`SNSB` Metal2-escape landing contacts. So this was never a
clean layout that a rule tightened against — it was always 0.07 µm short of
the rule, and the "clean" report had been a false negative in the tool, not
evidence the layout ever met the rule. #102 root-caused the exact drawing
defect (`build_cells.py`'s `SNS`/`SNSB` Poly2 track landing its contact with
zero enclosure margin), fixed it, and regenerated this cell's reports; #106
then added `provenance.gds_sha256`/`--check-gds-hash` (see "Known deck
limits" below) precisely so a future recurrence of this class of drift — a
report silently outliving the GDS it was generated from — fails loudly
instead of relying on a manual rebuild-and-diff to catch it again.

Recorded result (`layout/reports/por_comparator/`):

| Check | Result |
| ----- | --- |
| `klt drc --deck gf180mcu` | clean — 0 violations (the #102 fix; reconfirmed under the current deck by #106's regeneration) |
| `klt extract --deck gf180mcu` | 21 devices (12 nfet, 6 pfet, 3 ppolyf_u_1k), 18 nets, 8 pins |
| `klt lvs` | **match** — 21/21 devices, 18/18 nets, 8/8 pins |
| negative control `topology` | detected (exit 3; `device.unmatched` 1, `topology` 2) |
| negative control `device-param` | detected (exit 3; `device.property` 5, `topology` 2) |

### `por_output_chain` — the reset output chain (#70, MiM caps added by #92)

`design/por_output_chain.sch`'s 28 MOS devices **and both of its MiM caps**,
drawn from `design/netlist/por_output_chain.spice`. 225.3 × 105.9 µm, 1493
polygons. The 28th MOS, `XMRLK`, is the release latch issue #56 added
([DR-016](../spec/decision-records/DR-016-por-ramp-rate-chatter-release-latch.md));
it is placed beside `XMDBNI`, whose gate net (`ND1`) and drawn geometry it
shares.

**What a clean run here covers, and what it does not.** The cell has 30
schematic devices and all 30 are drawn: 28 MOS (14 pfet, 14 nfet), plus `XCDG`
(11 × 11 µm) and `XCTIM` (4 × 28 × 28 µm). The extraction sees **33** devices,
because `XCTIM`'s `m=4` draws as four units and the curated deck models no
multiplier — the same treatment `temp_core`'s multi-finger MOS get.

The caps were reserved floor area until #92, when the deck grew a MiM device
class. What each half of the compare now answers for:

| Device | Drawn as | What LVS proves | What it does not |
| --- | --- | --- | --- |
| 28 MOS | Comp/Poly2/Contact/Metal1 | count, sizing, signal-net topology | body ties (see below) |
| 5 MiM units | `FuseTop` + `CAP_MK` + `MIM_L_MK` over `Metal4`, plates routed to `NDG`/`TIM`/`VSS` (#264) | count, **plate area → capacitance** (242 fF and 4 × 1.568 pF, from the golden `c_width`/`c_length`), **and connectivity** — each plate lands on the schematic node its golden card names | — |

The connectivity gap was the deck's, not the drawing's: at the `klt` revision
these plates were first drawn against, `klt` registered a recognised
capacitor's two plates as their own self-connected nodes *outside* its
metal/via stack, with the top plate's layer (`FuseTop`) not in that stack at
all, so **no drawn routing could put a MiM plate on a schematic net** — every
cap extracted as an isolated pair of nets whatever was drawn around it. Filed
generically:
[klayout-tools#314](https://github.com/2AMLogic/klayout-tools/issues/314) —
**closed and fixed upstream**: the deck's `CapacitorDevice` now declares
`top_plate_via` (`Via4`) / `top_plate_via_metal` (`Metal5`), so a routed plate
lands on the connectivity graph. #264 draws that routing: `XCDG`'s bottom
plate (`Metal4`→`Via3`→`Metal3`→`Via2`→`Metal2`→`Via1`→`Metal1`) reaches
`NDG`, and both cards' top plates (`FuseTop`→`Via4`→`Metal5`→`Via4`→a second
`Metal4` island→…→`Metal1`, strapped together on `Metal5` since the two cards
share `VSS`) reach `VSS`; `XCTIM`'s four bottom plates strap onto `TIM` on
`Metal3`. `lvs_reference.py`'s `cap_plate_nets` therefore returns each card's
own golden nodes directly rather than a synthesized per-instance net pair.

A second, smaller substitution: the schematics instantiate the PDK's
**4-metal-level** MiM (`cap_mim_2f0_m3m4_noshield`); the curated deck models
only the DRM's "10.4.2 MIM Option B" **5-metal-level** stack
(`cap_mim_2f0_m4m5_noshield`) and declares no other MiM class, so that is what
the layout draws. Same 2.0 fF/µm² device, same plate geometry, same extracted
capacitance — only the metal pair the stack sits on differs. Filed:
[klayout-tools#315](https://github.com/2AMLogic/klayout-tools/issues/315).

There is **no resistor in this cell** — `por_output_chain.md`'s only mention of
one is in the *negative*, explaining why the ≥1 ms one-shot is a current-starved
ramp rather than an RC ("1 ms into a 6 pF capacitor needs ~160 MΩ, which is not
buildable here"). Confirmed against the current schematic export: the golden
netlist's only non-MOS cards are the two `cap_mim_2f0_m3m4_noshield` calls
above. So the resistor half of the deck's coverage gap
([#222](https://github.com/2AMLogic/klayout-tools/issues/222)) does not bear on
this cell at all.

Even before #264 routed the plates, the (then-synthesized) plate-net gap
**cost no net** in the compare: `NDG` and `TIM` each carry MOS terminals as
well as a cap terminal, so every net in the schematic still existed on both
sides with every one of its MOS connections.
`layout/tests/test_lvs_reference.py` asserts that rather than leaving it to
this paragraph, so a future schematic edit that made a cap the sole owner of a
node fails loudly instead of quietly narrowing what LVS answers for. And the
two **capacitor values** — the deglitch dwell and the one-shot width — are no
longer purely `sim/`'s claim: both the drawn area behind them and, since #264,
the wiring that delivers them to `NDG`/`TIM` are checked against the
schematic.

**Structure.** Same scheme as `bias_core`: **horizontal Poly2 tracks (one per
signal net) with vertical Metal1 risers**. `VDD`/`VSS` are Metal1 rails above
and below the row; one drawn Nwell holds the whole PMOS row. Signal routing
stays Metal1-only — the scheme the cell was drawn with when the deck declared
one metal level, kept because redrawing a proven cell to use a capability it
does not need is a regression risk for no gain. The MiM block's `Metal4` is the
cell's only geometry above Metal1, and it is device geometry, not routing.

**Placement follows `floorplan.md` inside the cell, not just at block level.**
`floorplan.md` puts this cell nearest the `RESETn` pad, "shortest path from the
push-pull output driver", in the always-on POR domain. Both ends are honoured
in the drawn row:

- `XMON` — the push-pull pull-down — is its own region at the **right,
  pad-facing edge**, with `XMOP` the last device of the PMOS row immediately to
  its left. The `RESETn` pin label sits on `XMON`'s own drain riser, the
  right-most Metal1 in the cell on that net; nothing is placed between the
  driver and the pad edge.
- `XMBD` leads the NMOS row at the **left, `bias_core`-facing edge**, where
  `IBIAS` arrives. Per
  [DR-010](../spec/decision-records/DR-010-shared-ibias-disabled-consumer-contract.md)
  `XMBD` is ungated and always on, and is the element that *defines* the shared
  `IBIAS` node's operating point. It is drawn diode-connected (gate and drain on
  the `IBIAS` pin net, source on `VSS`) with **no series device anywhere in that
  path**, and the `IBIAS` pin label is on `XMBD`'s own drain riser, so there is
  nowhere for a gating element to hide. The only other device touching `IBIAS`
  is `XMN1`'s *gate* — a mirror read, not a series element. A unit test asserts
  each clause of that.

**Matched pairs** get ordinary matched-pair practice — adjacent placement, same
orientation, identical drawn geometry, common well: `XMPD`/`XMP2` (the 10 nA
PMOS reference and its copy), `XMPT`/`XMDBPT` (identical 0.5/10 legs off `PDN`),
`XMNAP1`/`XMNAP2` and `XMNAN1`/`XMNAN2` (the release NAND's pull-up pair and
pull-down stack). `floorplan.md`'s ranked common-centroid plan covers
`temp_core` (ranks 1–3) and `por_comparator` (rank 4) only — it prescribes
nothing for this cell, and nothing was invented here to fill the gap.

**Dummy edge devices are not drawn, and that is a tool limit, not a matching
call.** A drawn dummy MOS extracts as an ordinary device; the deck has no way
to mark one non-functional, so it would appear in the extracted netlist as a
device the schematic-derived reference does not have and fail LVS. The only
alternatives are to abandon LVS on the cell or to hand-add fudge devices to the
reference — which would end its mechanical derivability from the schematic and
give a real missing device somewhere to hide. Filed generically:
[klayout-tools#295](https://github.com/2AMLogic/klayout-tools/issues/295).

**Guard ring and well ties are drawn, and are a design-review claim, not a
checked one** — same as `bias_core`, and it matters more here because this cell
sits on the always-on POR domain's outer edge. A continuous VSS-tied
p-substrate guard ring (COMP + Metal1, contacted at 1 µm pitch, no floating
segment) surrounds the cell, and the Nwell has its own VDD-tied COMP strap. Per
[klayout-tools#303](https://github.com/2AMLogic/klayout-tools/issues/303) the
deck has no tap/well-label layer and no ring-continuity rule, so **a mis-tied,
untied, or physically broken ring would compare clean**; `klt 0.1.0` still does not emit the `device.body_unverified` warning
klayout-tools#285 added (`extract.json`'s `warnings` array is empty).

**MiM is drawn as separate floor area, still not stacked.** The two caps need
about 3.26 × 10³ µm² of plate. `design/por_output_chain.md` notes MiM sits high
in the stack and *may* be stackable over neighbouring circuitry, explicitly
deferring that to a DRC/layout call. #92 drew the plates; it did **not** make
that call in the optimistic direction. `XCTIM`'s four units are a 2 × 2 array
with `XCDG` in the column beside them, in the same place the pre-#92 reservation
occupied — above the VDD rail, inside the guard ring — and the block comes out
**74.0 × 60.2 µm** against the 70 × 62 µm that reservation predicted. Plate
spacing and bottom-plate enclosure are drawn to the DRM's own `MIMTM.1` (1.2 µm)
and `MIMTM.3` (0.6 µm) with margin, and `klt`'s `mim.space.1` /
`mim.enclosing.fusetop.1` are the two rules that check them — the whole of the
deck's MiM rule set. Stacking stays unanswered: the deck carries no inter-layer
rule that could say whether MiM over the device row is legal.

The 200/0 annotation rectangle this cell used to carry for that area is **gone**
— `extract.json`'s `ignored_layers` is now empty for this cell. `bias_core`'s is
gone too (#90), and `por_comparator`'s sense-divider reservation went with #91's
drawn divider — no reserved region is left anywhere in the block.

Recorded result (`layout/reports/por_output_chain/`):

| Check | Result |
| ----- | --- |
| `klt drc --deck gf180mcu` | clean — 0 violations (`mim.space.1` / `mim.enclosing.fusetop.1` now exercised) |
| `klt extract --deck gf180mcu` | 33 devices (14 nfet, 14 pfet, 5 `cap_mim_2f0_m4m5_noshield`), 30 nets, 6 pins |
| `klt lvs` | **match** — 33/33 devices, 30/30 nets, 6/6 pins, 0 errors (13 warnings: 2 `device.body_unverified`, 11 ambiguous-pairing `topology`) |
| negative control `topology` | detected (exit 3; `device.unmatched` 1, `topology` 12) |
| negative control `device-param` | detected (exit 3; `device.property` 5, `topology` 12) |

The 11 `topology` entries are `warning` severity, not errors: 10 of them are the
comparer reporting that it paired the 10 isolated MiM plate nets structurally
rather than by name (they are indistinguishable by construction — that *is* the
connectivity gap above), plus the one this cell already had. `klt lvs` still
exits 0 and reports `match`.

What moved in `drc.json`'s own `coverage` block, which is the check that the new
geometry is *checked* rather than merely tolerated:

- `mim.space.1` and `mim.enclosing.fusetop.1` left `rules_skipped` — they are
  now exercised, having previously appeared there only because no stream in the
  repo drew `Metal4`/`FuseTop`.
- `layers_checked` gained `46/0` and `75/0`; `layers_in_stream_without_rules`
  lost `200/0` (the reservation is gone) and gained `117/5` / `117/10`, the two
  marker layers — the extraction deck reads them, the DRC deck has no rule for
  them, and the DRM has none either.
- No new warning of any kind: `extract.json`'s `warnings` array is the same
  single #288 entry, with the same count (see the next section).

Note the deck has **no `metal4` width rule at all** — `mim.space.1` is the only
thing standing over `Metal4` geometry — so bottom-plate width is held to the DRM
by construction here, not by a check. Same posture as the Via1/Via2 sizes.

### `temp_core` — the PTAT/CTAT sensing core (#71, passives folded in by #93)

`design/temp_core.sch`'s 39 MOS devices, drawn from
`design/netlist/temp_core.spice` per `layout/floorplan.md`'s ranked matching
plan: the rank-1 amplifier input pair and load mirror and the rank-2 cascoded
gain mirror are each drawn as **interleaved unit fingers** on a uniform pitch
in the plan's common-centroid order, with edge dummy fingers. The curated deck
runs no device-combination step, so N parallel fingers stay N devices in the
extraction; `lvs_reference.py`'s `fingers` field splits the same schematic
device into the same N devices of W/N in the reference, and its `dummies` field
declares the edge fingers explicitly (they are not in the schematic, so a
derived dummy would be a device LVS accepts that no golden netlist asked for).
39 + 10 extra fingers + 6 dummies = **55** drawn MOS devices.

**The sibling-top-cell split is retired; the passives are folded into this
cell (#93).** Until #93 this GDS stream carried **three** top cells:
`temp_core` (the 55-device MOS network above, the only one `klt
extract`/`klt lvs` ever ran on) plus `temp_core_r2_ladder` and
`temp_core_pnp_array` as undrawn-device *siblings* — `klt drc` checks every
top cell in a stream, so the split let the rank-3 PNP array and the rank-2
`R2` gain ladder be DRC-checked without a drawn, unmarked poly-resistor body
shorting `PTAT` into `VSS` through the trim ladder (`klt extract`/`klt lvs`
take a single `--top` and so never saw them). That constraint was a *deck*
one: at the time, the curated `gf180mcu` extraction deck declared no
`resistor`/`bjt` device class at all, so a drawn resistor body would have
extracted as ordinary interconnect and a drawn bipolar as nothing.

`klt 0.1.0` removed it — `resistor` and `bjt` both landed
(klayout-tools#222/#223/#225) — which turned the split from a necessity into
59 real devices sitting permanently outside the only checks that could answer
for their wiring and sizing. **Decision: fold the PNP array and the `R2`
ladder into `temp_core` and retire the two sibling top cells**, rather than
add marker geometry to them in place and keep the split. A sibling is
DRC-checked but never extracted or LVS'd — keeping it would have kept a
resistor bank that can short `PTAT`/`VSS` and a PNP array with a schematic-set
8:1 ratio both outside the one check that reads device sizing, for no reason
once the deck could model them. Folding costs nothing this repo needs the
split for: the two former siblings carried no independent pin contract of
their own, and DRC on `temp_core` alone still covers the same geometry now
that it is drawn in one stream.

**What is drawn and how.** `XR1`/`XRISO`/`XRZ`/`XR2F`/`XR2T5..T0` (the `R2`
gain ladder plus the isolation and zero resistors) are drawn as
`ppolyf_u`-recognised bodies: `SAB` (49/0) + `RES_MK` (110/5) over Pplus'd
Poly2, so the deck cuts each body out of ordinary poly connectivity and
extracts a resistor instead of shorting its own two terminals. Every resistor
is a **series string of straight segments** at the schematic's own drawn
length (KLayout solves a resistor's `L`/`W` from its recognised region's own
area and perimeter, so a folded/serpentine body would extract the wrong
length), reached from the routing channel on **Metal2 risers rather than poly
crossunders** — deliberately, so the new geometry adds no poly shape that
touches contact at 2+ points and could be mistaken for another unmodelled
resistor body (see "Known deck limits" below). `XQ1`/`XQ8A..H` (the rank-3
PNP centroid array: `XQ1` centre, the eight `XQ8` units around it, both inside
a ring of unmarked dummy units) each get a per-emitter `DRC_BJT` (127/5)
patch scoped to their own emitter, not a blanket over the whole array — a
marker over the shared n+ base ring would extract a 26th device the golden
netlist never asked for, and marking the sixteen dummies would add sixteen
more.

**The MiM cap `XCC` is drawn too, as of #259 — this cell now draws every
golden device it has.** It was the last one out anywhere in the block, and the
last thing any post-layout netlist here spliced in **ideal**; both
`layout/postlayout/temp_core.spice` and `temp_por_top.spice` now read "No
ideal device: every golden device is drawn", and `postlayout/AUDIT.md`'s
"ideal (not drawn)" column is zero for every cell. A 12 × 12 µm plate from the
same `_mim_block()`/`_mim_cap()` helpers the other four cards use, in the free
band above the PMOS row, with its bottom plate routed onto `PG` and its top
plate onto `NZ` (the two nodes its golden card names) through the same
Via4/Metal5 escape #264 established — so the compare answers for its
connectivity, not only its capacitance.

[DR-028](../spec/decision-records/DR-028-temp-core-xcc-draw-it.md) is the
record that decided this, after finding that both blockers this section used
to cite as settled fact had expired:

* **the metal-flavour substitution is real but is not a differentiator.** The
  deck models exactly one MiM device (`cap_mim_2f0_m4m5_noshield`, the DRM's
  5-metal-level Option B) while this cell's cap is the `m3m4` flavour the
  schematic names (klayout-tools#315, closed without the `m3m4` variant being
  modelled). `lvs_reference.CAP_CLASS` already made exactly that substitution
  for the other four golden MiM cards in this block, so applying it to `XCC`
  accepts a fidelity loss this block had already accepted twice. It is the one
  property of this cap that is still not what the schematic names, and it is
  permanent.
* **the plate-net isolation is fixed at the tool, and at the drawing.**
  klayout-tools#314 is closed: the `gf180mcu` deck now carries
  `top_plate_via` (`Via4`) / `top_plate_via_metal` (`Metal5`) on its
  `CapacitorDevice`, so a *routed* MiM cap's plates reach the connectivity
  graph and can be LVS'd against their real schematic nets. "A drawn `XCC`
  would compare as a capacitor floating between two anonymous nets" no
  longer describes the tool, and #264 closed the drawing half too: the four
  other drawn cards' plates are routed onto their schematic nodes directly
  (`lvs_reference.cap_plate_nets` returns each card's own two nodes, not a
  synthesized isolated pair), which is the pattern `XCC` joined as the fifth.

DR-028 also made the sequencing binding, and it held: the drawing waited for
the migration of this repo's layout evidence onto a *published* `klt` release
(#258 — the committed reports used to name a deck content hash `klt deck
resolve` reports never shipped) and then for #264, which routed the four
already-drawn cards and so established the via stack this cap reuses. Both
landed first; #259 is the geometry.

Two deck-imposed rewrites apply to the folded-in passives, mirroring the ones
`lvs_reference.py`'s module docstring already states for the MOS bodies: a
`ppolyf_u` resistor's bulk terminal is rewritten to the deck's global
substrate net (no drawn tap layer to derive anything else from), and a
vertical bipolar's **collector** goes to that same global (the DRM's vertical
device has no drawn collector layer — its collector *is* the substrate) while
its **base** goes to the drawn Nwell's anonymous per-well net (the deck never
joins `Nwell` to `Contact`, so the base ring's `VSS` tie is invisible to it).
The schematic ties both to `VSS`; the layout does too, and no check in this
flow proves it.

Recorded result (`layout/reports/temp_core/`):

| Check | Result |
| ----- | --- |
| `klt drc --deck gf180mcu` | clean — 0 violations |
| `klt extract --deck gf180mcu` | 115 devices (27 nfet, 28 pfet, 50 `ppolyf_u`, 9 `bjt`, 1 `cap_mim_2f0_m4m5_noshield`), 73 nets, 30 pins |
| `klt lvs` | **match** — 115/115 devices, 73/73 nets, 30/30 pins, 0 errors (2 `device.body_unverified` warnings). 114 devices and the same 73 nets before #259 drew `XCC`: the cap landed on `PG`/`NZ`, two nets the compare already had, so it added a device and no net. |
| negative control `topology` | detected (exit 3; `device.unmatched` 1, `topology` 1) |
| negative control `device-param` | detected (exit 3; `device.property` 5, `topology` 1) |
| negative control `passive-param` | detected (exit 3; `device.property` 11, `topology` 3) |

`passive-param` is new here (#93): it doubles the first resistor's value and
halves the first bipolar's emitter area, so a clean run is evidence the
compare reads the passives' **sizes**, not just their topology — the same
role `device-param` plays for the MOS devices, extended to the two device
classes this cell just started drawing. `bias_core` draws marked passives too
(#90) and runs the same control; `por_comparator` and the two MOS-only cells
draw none, so the control reports `n/a` there (see `run_checks.sh`'s per-cell
output).

**The klayout-tools#288 poly-shape warning does not drop, and that is the
expected result, not a regression.** `temp_core`'s `extract.json` still
reports the same **110** "poly shapes with the resistor-body signature" both
before and after this change (see "Known deck limits" below for what the
warning actually counts): those 110 shapes are the routing channel's own
Poly2 gate-to-track crossunders, unrelated to the resistor bank, which was
never drawn as unmarked poly inside this cell before #93 (it lived in the
now-retired siblings). The new resistor and bipolar geometry deliberately
reaches the channel on Metal2 risers rather than poly crossunders
specifically so it cannot add to this count — the same "count is unmoved by
an unrelated device change" result #92 already recorded for
`por_output_chain`'s MiM caps (16 before, 16 after). Drawing the channel's own
tracks on a marked layer would be wrong: they are real interconnect, not
resistor bodies, and marking them would make the deck extract devices no
golden netlist has.

### `temp_por_top` — the block-level assembly (#72, floorplan re-derived #97)

All four sub-circuits instanced into one cell, with the two guard rings, the
`VDD`/`VSS` rails and the ratified 5-pad pinout (`VDD`, `VSS`, `PTAT`, `CTAT`,
`RESETn`). **No sub-circuit is modified to fit**: each of the four functions
this cell calls still produces its own committed GDS byte-for-byte, so
`temp_por_top` inherits their recorded results rather than re-opening them.

**Routing.** This is the first cell in the repo to route above Metal1, and it
is why the "single metal level" limit below now reads differently: the
installed `klt 0.1.0`'s extraction deck declares the full Metal1–Metal5 /
Via1–Via4 stack. Discipline: Metal2 horizontal, Metal3 vertical, one Metal2
trunk per crossing net at its own `y`, one Metal3 column per pin escape at its
own `x`; Metal1 is used **only** for the two guard rings. Every crossing net
reaches an instance by landing a Via1 on that instance's own Metal1 pin
strap — nothing abuts, nothing is redrawn.

The direct consequence, and the reason it matters here: **no guard ring in
this cell has a notch in it.** In a single-metal regime the `IBIAS`
feedthrough would have to break the domain-seam moat to cross it. On Metal3 it
crosses *over* the moat instead, with the moat continuous end to end — which is
what `layout/floorplan.md`'s isolation plan asks for and what a notched ring
only approximates.

**What actually crosses the seam, exactly.** Four left-margin Metal3 columns
straddle the moat's `y`, all of them inside the moat's own `x`-span: two
signals — `IBIAS` (`x = -60`, up to `temp_core`) and `RESETn`/`EN` (`x = -56`) —
and two supplies — `VSS` down to the bottom rail (`x = -48`, which is also the
rings' tie net) and the POR domain's own `VDD` riser up to the top rail
(`x = -64`). `temp_core`'s `VDD` tap (`x = -52`) is the one left-margin column
that does not cross, because the top rail is on its side of the seam. The
isolation claim does not rest on the *count*: it rests on **none of the four
being drawn on Metal1/COMP**, the layers the moat is made of, so every crossing
passes over an unbroken ring rather than through a notch in it. `IBIAS` is
still the only *bias* net that crosses into the temp-sensor domain — `VREF` and
`BIAS_OK` stay POR-domain-internal — which is the part of `floorplan.md`'s plan
that is about coupling rather than about ring continuity.

**The check the deck cannot do.** A guard ring that is broken, or drawn but
never tied to `VSS`, is DRC-clean and LVS-match — both were built and confirmed
clean while developing this cell, and the tool gap is filed generically as
[klayout-tools#303](https://github.com/2AMLogic/klayout-tools/issues/303). `build_cells.py`
therefore checks the geometry itself, at build time, and refuses to write the
stream otherwise:

| Build-time check | What it catches |
| --- | --- |
| every net this cell draws is **one connected group** across the via stack | a guard ring drawn but never joined to `VSS`; any open |
| every connected group carries **one net name** | a via bridging two nets; two same-layer shapes overlapping |
| different-net shapes respect the deck's own spacing rule | under-spacing DRC would catch, caught earlier and by name |
| each guard ring merges to **one polygon with exactly one hole** | a ring with a gap in one segment — still connected, still on `VSS`, but no longer a ring |
| every Via1/Via2 is covered by metal on **both** levels | a via drawn a hair off its landing pad (an open, not a short) |

Each of these was negative-controlled by deliberately introducing the defect it
describes and confirming the check fires. What is *still* a design-review claim,
and the only one left, is that `VSS` is the right net to tie the rings to.

**Coverage — whole.** #97 caught this assembly up with every one of
#90/#91/#92/#93 and issue #56's `XMRLK` in one pass, rather than reworking the
floorplan once per sub-cell change. Extraction being flat, every sub-circuit's
drawn devices flow straight into this compare: `bias_core`'s
`XQ1`/`XQ8A..H`/`XQR` PNPs, `XR1`/`XR2`/`XRT`/`XRZ` resistors and
`XCC`/`XCOK` MiM caps (#90); `por_comparator`'s `XRTOP`/`XRBOT`/`XRHYS`
divider (#91); `por_output_chain`'s `XCDG`/`XCTIM` MiM units (#92) and its
`XMRLK` release latch (issue #56); `temp_core`'s PNP array and `R2` gain
ladder (#93), and its MiM cap `XCC` (#259, executing
[DR-028](../spec/decision-records/DR-028-temp-core-xcc-draw-it.md)). The
**239** devices below are every device in all four schematics, with none left
over: the count moved 238 → 239 when `XCC` was drawn, and the block's
ideal-device count became zero at the same time.

**The floorplan re-derivation itself.** #91's divider and #90's passives each
grew their cell's footprint well past the #72-era placeholder-sized gap
`TOP_PLACEMENT` left for it: rebuilding the assembly against `build_cells.py`
unchanged since #72 (i.e. with every sub-cell's real, grown geometry but the
original instance placement) DRCs **dirty** at 92 violations
(`contact.space.1` ×79, `poly2.enclosing.contact.1` ×11, `contact.width.1`
×2) — a placement collision at the `por_comparator`/`por_output_chain`
instance boundary (`por_comparator` grew from a 313 µm-wide placeholder to a
real 445.0 µm, eating the entire 57 µm gap the old floorplan left and then
75 µm more), not a defect in any individual sub-cell. #97 re-derives only
what needs to change: `TOP_PLACEMENT`'s `por_output_chain` entry moves its
`dx` from 820 to 920, reopening a clean ~25 µm gap past `por_comparator`'s new
right edge, and the perimeter ring / `VDD`-`VSS` rails / domain-seam moat's
right edges (`TOP_PERIM`, `TOP_RAIL_X1`, `TOP_SEAM_X1`, `TOP_RIGHT_PAD_X`) all
move the same +100 µm so each keeps the same margin past the shifted instance
it held before. Every other instance and every adjacency
`layout/floorplan.md`'s ranked plan asks for — `temp_core` alone above the
seam, `bias_core` at the POR row's seam-facing left edge, `por_output_chain`
at the row's `RESETn`-facing right edge — is unchanged; `bias_core`'s own #90
growth already cleared `por_comparator`'s left edge with a 15.1 µm gap, so
that boundary needed no change. See `build_cells.py`'s `TOP_PLACEMENT` comment
for the full derivation and the gap sweep (0–105 µm past the old value) that
picked a value with comfortable margin on both sides rather than the
narrowest one that merely stopped complaining.

**Zero residual violations.** Rebuilding with the re-derived floorplan first
dropped the 92 placement-collision violations to 2 — both
`poly2.enclosing.contact.1`, inherited from `por_comparator`'s own
independent divider-contact finding (#102/#103), reproducing on its committed
GDS whether DRC'd standalone or assembled here. That finding was fixed at the
source (#105, landed in `por_comparator`'s own drawing) before this floorplan
rework itself merged; rebuilding the assembly against the fixed
`por_comparator.gds` needed no further floorplan change — the divider's
contact geometry was a local fix, not a footprint change — and takes the
count from 2 to 0.

Recorded result (`layout/reports/temp_por_top/`):

| Check | Result |
| ----- | --- |
| `klt drc --deck gf180mcu` | **clean** — 0 violations (was 92 before the floorplan re-derivation, then 2 inherited from #102/#103 until #105 fixed `por_comparator` at the source) |
| `klt extract --deck gf180mcu --top-cell-pins` | 239 devices (71 nfet, 64 pfet, 50 `ppolyf_u`, 27 `ppolyf_u_1k`, 19 `bjt`, 8 `cap_mim_2f0_m4m5_noshield`), 145 nets, 6 pins |
| `klt lvs` | **match** — 239/239 devices, 145/145 nets, 6/6 pins, 0 errors (2 warnings: `device.body_unverified`). Net count dropped from 159 to 145 when #264 routed the 7 already-drawn MiM caps' 14 plates onto their schematic nets instead of 14 synthesized isolated ones; #259's 8th cap (`temp_core`'s `XCC`) added a device but no net, landing on `PG`/`NZ`, which the compare already had. |
| negative control `topology` | detected (exit 3; `device.body_unverified` 2, `device.unmatched` 1, `topology` 2) |
| negative control `device-param` | detected (exit 3; `device.body_unverified` 2, `device.property` 5, `topology` 2) |
| negative control `passive-param` | detected (exit 3; `device.body_unverified` 2, `device.property` 11, `topology` 5) |

`bash layout/run_checks.sh temp_por_top` runs end to end unattended and
exits 0 — DRC clean, extraction recorded, LVS match, every applicable
negative control detected.

The 6 pins are the ratified 5 pads plus the deck's `vsubs` global. That set is
exactly what `layout.top_cell_pins` produces: the five Metal2 labels this cell
draws itself are its only labels, and every sub-circuit's own labels stay below
the top cell and stay internal. `lvs_reference.py` asserts the reference's own
port list against `design/netlist/temp_por_top.spice`'s `.subckt` line, in
order — the same ratified-pinout assertion `design/netlist.py --check` makes at
the schematic level.

**Footprint / area — [`spec/target-spec.md#area`](../spec/target-spec.md#area)'s
measured value ([DR-022](../spec/decision-records/DR-022-area-post-layout-measurement.md)).**
`klt stats layout/cells/temp_por_top.gds` (run by `run_checks.sh` step 4,
recorded at `layout/reports/temp_por_top/stats.json`):

```
top_cell: temp_por_top
bbox_um: (-140.0, -540.0) - (1194.0, 254.0)  1334.0 x 794.0
area_um2: 369261.93960000004
density: 0.3486247489605323
```

Three defensible numbers, all measured off the same committed GDS, differ by
up to ~3× — which one the target-spec row means is stated explicitly there,
not left implicit:

| Measure | Value | Source |
| --- | ---: | --- |
| **This cell's bounding-box footprint (the row's measurement convention)** | **1334.0 × 794.0 µm = 1 059 196 µm² ≈ 1.059 mm²** | `stats.json`'s `bbox_um` |
| Sum of the four sub-cells' own bounding boxes (`bias_core` 434.9 × 285.7, `por_comparator` 445.0 × 164.7, `por_output_chain` 225.3 × 105.9, `temp_core` 569.25 × 211.355 µm) | 341 716 µm² ≈ 0.342 mm² | each cell's own `stats.json` |
| Drawn (union-of-layers) polygon area — not a footprint, most of the bbox is unfilled space between instances, rails and the guard rings | 369 262 µm² | `stats.json`'s `total.area_um2` |

The footprint is ~3.1× the sum of the sub-cells' own boxes; the gap is
floorplan spacing (`TOP_PLACEMENT`'s instance layout, the full-width rails,
the perimeter guard ring and the domain-seam moat — see "The floorplan
re-derivation itself" above), not a stray shape inflating the box. Both the
footprint and the sub-cell sum are over the `≤0.05 mm²` wave-1 planning
budget `spec/target-spec.md#area` carried before this measurement (21.2× and
6.8× respectively) — see DR-022 for the full reasoning and the ratified
disposition.

### `por_comparator_bias_okb_inv` — the flow's original proof cell (#16)

`por_comparator_bias_okb_inv` — the local inverter that produces `BIAS_OKB`
inside `por_comparator` (`MENP` / `MENN` in that cell's device table). Two
devices, both gates on one drawn poly strip, both drains on one Metal1 strap.

It was chosen because it is the smallest piece of this block that the curated
`gf180mcu` extraction deck can represent **completely** — every device in it is
a plain single-finger MOS, so a clean LVS is a statement about the whole cell
rather than about the subset the deck happens to understand. Sizing is not
retyped here: `lvs_reference.py` reads `L`/`W` out of
`design/netlist/por_comparator.spice`, which `design/netlist.py` exports from
the schematic. Change the schematic and the reference netlist goes stale, and
`run_checks.sh` fails until it is regenerated.

Recorded result (`layout/reports/por_comparator_bias_okb_inv/`):

| Check | Result |
| ----- | --- |
| `klt drc --deck gf180mcu` | clean — 0 violations |
| `klt extract --deck gf180mcu` | 2 devices (1 nfet, 1 pfet), 6 nets, 5 pins |
| `klt lvs` | **match** — 2/2 devices, 6/6 nets, 5/5 pins, 0 mismatches |
| negative control `topology` | detected (exit 3, mismatch) |
| negative control `device-param` | detected (exit 3, mismatch) |

## Known deck limits — what a clean LVS here does *not* prove

`klt`'s `gf180mcu` decks are curated starter subsets, not the full DRM/LVS rule
set. The limits below are the ones that bear on reading these reports. Each was
hit during this bring-up and, where it is a tool gap rather than a fact of life,
filed upstream per this repo's friction protocol.

- **Device coverage is MOS-only.** The extraction deck recognises `nfet`/`pfet`
  and nothing else in the version this flow was brought up on, so a cell
  containing poly resistors, MiM caps, or vertical bipolars cannot be LVS'd
  whole. That is why the proof cell is an all-MOS one and why `bias_core`'s
  16 non-MOS devices are **not drawn** rather than drawn-and-ignored — a
  drawn poly resistor body extracts as interconnect and shorts its own
  terminal nets. `por_output_chain`'s 2 MiM caps and `por_comparator`'s
  3-segment sense divider were in the same boat through #70/#69; they are
  drawn for real as of #92/#91 (see their own sections above) — the first
  of this block's non-MOS devices to cross out of this bullet.
  **Re-checked at `klt 0.1.0` for #72** — and this has moved. The installed
  deck now *declares* `['nfet', 'pfet', 'bjt', 'cap_mim_2f0_m4m5_noshield',
  'resistor']` (every `lvs.json` records it), so
  [klayout-tools#219](https://github.com/2AMLogic/klayout-tools/issues/219) and
  its sub-issues #222 (resistors) / #225 (MiM caps) have landed here. What did
  **not** move at #72 was these cells: recognising a resistor or a MiM cap needs
  marker layers (`SAB`/`RES_MK`, `CAP_MK`/`MIM_L_MK`) that none of the drawn
  cells carried, and the drawn geometry that *would* become those devices was
  laid out for a deck that could not model them. That left a **drawing** gap
  this repo owns, not a tool gap.
  **#92 closed the first of it**: `por_output_chain` now draws both MiM caps for
  real (`FuseTop` + `CAP_MK` + `MIM_L_MK` over `Metal4`), and they extract as 5
  `cap_mim_2f0_m4m5_noshield` devices with the right capacitance instead of as
  reserved floor area. Two residual tool gaps surfaced doing it, both filed
  generically:
  **~~[klayout-tools#314](https://github.com/2AMLogic/klayout-tools/issues/314)
  — a recognised capacitor's plates sat off the deck's metal/via connectivity
  stack, so no drawn routing could put a MiM plate on a schematic net; the
  compare answered for plate area, never for plate connectivity.~~ Closed and
  fixed upstream** — the deck's `CapacitorDevice` now declares
  `top_plate_via` (`Via4`) and `top_plate_via_metal` (`Metal5`), so a routed
  plate reaches the connectivity graph and a MiM cap can be compared on its
  nets as well as its area. **#264 routes them**: `bias_core`'s `XCC`/`XCOK`
  and `por_output_chain`'s `XCDG`/`XCTIM` are now wired — bottom plate on
  `Metal4`→`Via3`→`Metal3`→`Via2`→`Metal2`→`Via1`→`Metal1`, top plate on
  `FuseTop`→`Via4`→`Metal5`→`Via4`→a second `Metal4` island→…→`Metal1` — onto
  the schematic nodes their golden cards name, and **#259 draws and routes
  `temp_core`'s `XCC` the same way**, so today's compare here answers for
  plate connectivity as well as plate area for every MiM card in the block.
  And
  [klayout-tools#315](https://github.com/2AMLogic/klayout-tools/issues/315) —
  the deck models exactly one of the PDK's MiM stack variants, so a schematic
  instantiating the other (`..._m3m4_...`) has to be drawn as the modelled one.
  **#91, #93 and #90 closed the second, for every cell that has one.**
  #91: `por_comparator` now draws its 3-segment sense divider for real
  (`RES_MK`/`SAB`/`Resistor(62,0)` over `Poly2`), extracting as 3
  `ppolyf_u_1k` devices instead of reserved floor area. #93: `temp_core`'s
  `R2` gain ladder and its rank-3 PNP array are now drawn with `SAB`/`RES_MK`
  and `DRC_BJT` markers and extract as 50 `ppolyf_u` + 9 `bjt` real devices
  instead of sitting outside the compare in retired sibling top cells. #90:
  `bias_core`'s 4 poly resistors, 10 vertical PNPs and 2 MiM caps extract as
  24 `ppolyf_u_1k` + 10 `bjt` + 2 MiM, which makes that cell whole. (See each
  cell's own section above for its marker geometry and drawing decision.)
  **#259 closed the last of it.** `temp_core`'s own MiM cap `XCC` used to be
  the one golden device left out anywhere; it is drawn now, executing
  [DR-028](../spec/decision-records/DR-028-temp-core-xcc-draw-it.md), and it
  is routed onto `PG`/`NZ` rather than floating — the fifth card through the
  via stack the closed #314 opened up and #264 established on the other four.
  **No cell in this block leaves a golden device undrawn any more**, which is
  what takes `temp_por_top` from 238 to 239 devices and every `AUDIT.md`
  ideal-device count to zero.
  Two deck-*option* limits surfaced doing this, neither a missing capability:
  - **The high-rho poly resistor's sheet resistance is a deck option, not
    drawn geometry.** `ppolyf_u_1k`/`_2k`/`_3k` are geometrically identical —
    one `SAB` + `RES_MK` + `Resistor` stack — and which one a run extracts is
    the official runset's `POLY_RES` build option. `klt` models the PDK's own
    default (`_1k`) only, so this repo's `ppolyf_u_3k` devices, in both
    `bias_core` and `por_comparator`, are drawn at their schematic dimensions
    and recognised at 1000 Ω/sq. (`temp_core`'s plain `ppolyf_u` devices are
    unaffected: that class carries no `Resistor` ID layer and the deck's own
    350 Ω/sq applies. `lvs_reference.py`'s single `RESISTOR_CLASS` table
    carries both families and both sheet rhos.) An explicit non-goal of
    [klayout-tools#299](https://github.com/2AMLogic/klayout-tools/issues/299)
    and filed as
    [klayout-tools#323](https://github.com/2AMLogic/klayout-tools/issues/323);
    it is the exact analogue of #315's MiM-stack substitution, and like it, it
    costs the *value* and not the geometry.
  - **A string of marked bodies is N devices.** The deck cuts each *marked*
    body out of poly separately and runs no device-combination step, so a
    resistor drawn as a string of legs extracts as one two-terminal device per
    leg. That is arguably correct behaviour rather than a gap — it is the same
    "no combination step" this repo already handles for multi-finger MOS
    (`fingers`) and multiplied MiM caps — so it is handled the same way, by
    declaring the same N devices in the reference, and no new issue was filed
    for it. It also leaves a cell a genuine choice, and this block makes it
    both ways: `por_comparator` serpentines one continuous body per resistor
    (1 device each, area-derived), `bias_core` and `temp_core` string separate
    legs (N devices each). Both go through the one
    `lvs_reference.resistor_segments()`, with the style and the leg
    ceiling/target in each manifest entry's `resistor_fold`, so the code that
    draws the bodies and the reference that declares them can never disagree.
  The *silence* has moved too, in the right direction:
  [klayout-tools#288](https://github.com/2AMLogic/klayout-tools/issues/288) is
  live in this build — every cell's `extract.json` now carries a warning naming
  the count of poly shapes with "the resistor-body signature" that were
  absorbed into interconnect.
  **These counts are mostly `Poly2` routing tracks, not undrawn devices**, and
  #91/#92/#93/#90 each confirmed it, from four different directions. #92:
  `por_output_chain`'s count is **16 before and 16 after** drawing its MiM
  caps — 16 is exactly the number of horizontal Poly2 signal tracks the cell
  routes on (`POR_OUTPUT_CHAIN_TRACKS`), each a poly run contacted at both ends
  and touching no recognised gate, i.e. the heuristic's stated signature, so it
  flags the routing scheme rather than a missing device; MiM geometry cannot
  move it in either direction. #93: `temp_core`'s is **110 before and 110
  after** folding in its resistor bank and PNP array — because that geometry
  reaches the routing channel on Metal2 risers rather than poly crossunders
  precisely so it draws no *new* poly shape the heuristic could flag; same
  signature, same non-effect. #91: `por_comparator`'s moved from **10 to 12**
  drawing its divider — *up*, not down, and none of the 12 is divider geometry
  (the divider's own marked legs contribute zero); two pre-existing routing
  tracks (`SNS`, `SNSB`) newly trip the heuristic because reaching the divider
  gives each of them a second contact where none existed before. #90:
  `bias_core`'s went **19 → 28** across drawing its 16 devices — again *up*,
  while the cell went from 16 undrawn devices to zero — because the passive
  block adds its own eight-track distribution band and two row tracks (`NB`,
  `VREF`) gained a second contact by finally having a second device to reach.
  Every one of the 28 was enumerated; not one is a device.
  What #90 also showed is that the markers are load-bearing: rebuilding the
  same `bias_core` geometry with `RES_MK` moved to a layer no deck reads drops
  all 24 resistors, collapses **54 nets to 30** — the documented short
  cascade — and pushes that cell's #288 count to 32 as the four folds finally
  trip it. So the heuristic flags the *routing scheme*, and the only way to
  drive these counts toward zero would be to route on a metal the sub-cells
  deliberately do not use. Current per-cell counts: 28 in `bias_core`, 12 in
  `por_comparator`, 16 in `por_output_chain`, 110 in `temp_core` — and, since
  #97 caught `temp_por_top` up with all four, **166** there too, exactly the
  sum of the per-cell counts above (extraction being flat, the same shapes
  counted once each).
  The false-positive rate is filed generically as
  [klayout-tools#324](https://github.com/2AMLogic/klayout-tools/issues/324) —
  which also carries the *other* half of what #90 hit: a correctly recognised
  resistor's own unmarked terminal head is flagged too, if it carries more than
  one contact. That one changed this layout. Each drawn head in `bias_core` has
  **exactly one contact**, not the contact array a 2 µm-wide head would
  normally get, purely to keep the diagnostic quiet — a worse layout for no
  electrical reason, which is precisely the kind of thing this repo exists to
  report.
- **There is no dummy-device concept**, so matched-pair *dummy edges* cannot be
  drawn on any cell that must also LVS: a drawn dummy MOS extracts as a real
  device the schematic-derived reference does not have. The cells here
  therefore stop at adjacency/orientation/geometry matching and draw no
  dummies — a layout decision made by a tool limit, which is exactly the kind
  of thing this repo exists to surface. Filed by #70:
  [klayout-tools#295](https://github.com/2AMLogic/klayout-tools/issues/295).
- **There is no annotation-layer contract.** Every reserved region this block
  ever drew is now gone — #92 replaced `por_output_chain`'s with drawn MiM
  caps, #91 `por_comparator`'s with a drawn divider, and #90 `bias_core`'s
  with its drawn passives and bipolars — so `extract.json` reports an empty
  `ignored_layers` for each of them. The 200/0 layer those regions sat on was
  chosen because no deck reads it today, not because any deck promises not to,
  which is why the gap is still worth tracking even with nothing on it. Filed:
  [klayout-tools#289](https://github.com/2AMLogic/klayout-tools/issues/289).
  Re-check after a `klt` upgrade: if `klt drc`'s or `klt extract`'s layer set
  ever grows to include it, the reports move and `run_checks.sh` says so.
- **A sub-cell's labels become the parent's pins.** Extraction is flat, and it
  ends by promoting *every named net* to a top-level pin — including nets that
  are named only because a label sits inside an instanced sub-cell. So
  `por_comparator` instancing `por_comparator_bias_okb_inv` inherits its
  `BIAS_OKB` label and `BIAS_OKB` becomes a **pin** of `por_comparator`, even
  though the schematic calls it an internal node. Filed:
  [klayout-tools#291](https://github.com/2AMLogic/klayout-tools/issues/291) —
  **now fixed in this build**, and load-bearing for #72: `klt extract
  --top-cell-pins` / `"top_cell_pins": true` in the `klt lvs` request promotes
  only labels drawn *directly in the top cell*. Without it `temp_por_top` would
  have inherited every one of `temp_core`'s 27 routing-channel labels as a
  top-level pin and could not have been compared against the ratified 5-pad
  pinout at all. A cell that instances others should set it (see
  [Adding a cell](#adding-a-cell-for-17--18)); `por_comparator` predates the fix
  and still declares `BIAS_OKB` as a port in its manifest, which remains
  correct for that cell as drawn.
- **Body terminals are synthetic — except where a cell's own drawn taps now
  resolve them, as of #312, and that is a per-cell fact, not a global one.**
  At `klt 0.2.0` the deck drew no substrate/pwell tap layer at all, so NMOS
  bodies, BJT collectors and poly-resistor bulks always landed on a global
  `vsubs` net and `lvs_reference.py` rewrote the schematic's own body nodes to
  match, unconditionally, on every cell. `klt 0.6.0` resolves a *drawn* tap
  where one exists, and whether one exists is a fact about each cell's own
  layout, not about the device class — so #312 made the rewrite conditional,
  declared explicitly per cell in `lvs_reference.BODY_TIES_RESOLVED_CELLS`
  (the shared P+ substrate tie: NMOS body, BJT collector, resistor bulk) and
  `lvs_reference.BJT_WELL_RESOLVED_CELLS` (the separate, local Nwell tie: BJT
  base only). The two do not move together — see the per-cell table below —
  and both are checked against the GDS actually committed, not assumed:

  | cell | substrate tie (NMOS body / BJT collector / resistor bulk) | BJT base (local Nwell tie) |
  | --- | --- | --- |
  | `bias_core` (standalone) | not resolved — no local tap drawn | not resolved — no local Nwell tap drawn |
  | `por_comparator`, `por_comparator_bias_okb_inv`, `por_output_chain` (standalone) | not resolved — no local tap drawn | n/a — no bipolars |
  | `temp_core` (standalone or instanced) | **resolved** — draws its own taps (#93) | **resolved** — draws its own Nwell tap (#93) |
  | `temp_por_top` (the assembly) | **resolved for every instanced sub-cell**, `bias_core`/`por_comparator`/`por_output_chain` included — the block's own continuous seam-ring tie reaches every substrate-tied terminal regardless of which sub-cell drew it | **resolved only for `temp_core`'s own instance** (`xtemp`) — `bias_core`'s instance (`xbias`) still has no local Nwell tap of its own, and the seam ring does not substitute for one (an Nwell tie is a separate, local connection, not a substrate-wide one) |

  The `temp_por_top` row's split is the one genuinely surprising result, and
  it is measured, not assumed: `bias_core`'s ten PNPs, instanced inside
  `temp_por_top`, have their **collector** resolve to the real `VSS` (the
  assembly's own seam ring reaches it, like every other substrate-tied
  terminal in the block) while their shared **base** stays the anonymous,
  deck-synthesized well net — confirmed directly in
  `layout/reports/temp_por_top/extracted.spice`: `Q$136 VSS \$52 ...`
  (collector real, base still `$52`), against `temp_core`'s own instanced
  PNPs a few lines later, `Q$146 VSS VSS ...` (both real). A design that
  collapsed `BODY_TIES_RESOLVED_CELLS` and `BJT_WELL_RESOLVED_CELLS` into one
  flag reproduced this exact split as a false `device.unmatched` ×10 /
  `net.split` pair against a live `klt lvs` run — caught only by that run,
  not by the stdlib unit suite, which has no way to know a geometric fact
  like this one (now covered by `test_lvs_reference.py`'s
  `test_bjt_collector_and_base_resolve_independently`).

  **What a clean LVS proves, stated plainly, for each cell today:**
  - `bias_core`, `por_comparator`, `por_comparator_bias_okb_inv`,
    `por_output_chain` (standalone): exactly what a clean LVS proved before
    #312 — device count, sizing, MiM plate area/geometry (hence
    capacitance) and the nets its plates land on, drawn resistor and bipolar
    geometry, signal-net topology. **Not** NMOS body, BJT collector/base or
    resistor-bulk ties, and **not** a PMOS well tie (never proven on any
    cell in this block, resolved or not — see the next paragraph).
  - `temp_core` (standalone): everything above, **plus** NMOS body, BJT
    collector *and* base, and resistor-bulk ties, for real — this cell's own
    drawn taps carry every one of those terminals to the schematic's own
    `VSS`, and the compare now runs against that real connectivity instead of
    a deck-synthesized stand-in.
  - `temp_por_top` (the assembly): everything the four sub-cells each prove
    on their own, **plus** NMOS body, BJT collector and resistor-bulk ties for
    *every* instanced device regardless of which sub-cell drew it (the seam
    ring's own doing), **plus** BJT base ties for `temp_core`'s own instance
    specifically — **not** BJT base ties for `bias_core`'s instance, which
    still answers only to the anonymous `bjt_well` net the way it does
    standalone.

  **PMOS wells are unaffected by any of this, on every cell in this block,
  resolved or not.** gf180mcu's curated deck still has no well-label or tap
  layer for an Nwell body tie at all, drawn or not, so an extracted Nwell is
  always an anonymous net — confirmed by `device.body_unverified` still
  naming every drawn `pfet` on `temp_core`/`temp_por_top` after #312, same as
  before it, while the `nfet` entry that used to sit beside it is simply
  gone. **Consequence, unchanged by #312: a mis-tied, untied, or physically
  broken PMOS guard ring still compares clean everywhere**, and — outside
  `temp_core`/`temp_por_top`'s own now-resolved terminals — so does an NMOS
  one. Both were built and confirmed during #72: a `temp_por_top` whose seam
  moat is drawn but never tied to `VSS`, and one whose perimeter ring has a
  10 µm gap in a segment, are each `klt drc` clean and `klt lvs` **match**.
  Filed: [klayout-tools#303](https://github.com/2AMLogic/klayout-tools/issues/303)
  — that is the issue that tracks this gap, with those two defect builds as its
  evidence.
  The older [klayout-tools#281](https://github.com/2AMLogic/klayout-tools/issues/281)
  (synthetic body nets) is **closed**, resolved by #285, and its curated scope
  was narrowed to that one warning — so it does **not** track ring continuity or
  the tie, and should not be cited for them. #285 **is** live in this build:
  every `lvs.json` still carries a `device.body_unverified` warning naming
  every PMOS body that went to an anonymous well net (and, on a cell not in
  `BODY_TIES_RESOLVED_CELLS`, every NMOS body that went to `vsubs` alongside
  it). That is a real signal — it says the compare did not check that
  terminal — but it is not a *tie* check, and it says nothing at all about a
  guard ring. So ring correctness stays outside the deck regardless of
  resolution state. `temp_por_top` answers it with build-time geometric
  checks instead (see its section above); every other cell's ring remains a
  design-review claim.
- **The reference netlist has to be converted, not just pointed at.** `klt lvs`
  needs plain-element SPICE (`M1 d g s b nfet L=0.5U W=1U`); `design/netlist.py`
  emits the ngspice simulation form (`XM1 d g s b nfet_03v3 L=0.5u ...`).
  Pointing LVS at the raw export does not error — it silently produces a
  net-merge cascade that reads like a layout bug. `lvs_reference.py` is this
  repo's converter. Filed:
  [klayout-tools#280](https://github.com/2AMLogic/klayout-tools/issues/280).
- **A parameter-only defect is poorly localised on a small cell** — and #68
  measured the size at which that stops being true. On the two-device proof
  cell the `device-param` control is *detected* but reported as
  `device.unmatched` + a `net.unmatched` cascade rather than the documented
  `device.property` entry naming the wrong parameter, so the report points at
  connectivity when the defect is a width. On the 34-device `bias_core` the same
  control reports **`device.property` ×5**, i.e. it classifies correctly — which
  is the first evidence in this repo for the "classifies correctly once the
  circuit is larger" expectation rather than an assumption about it. #70's
  27-device `por_output_chain` and #69's 18-device `por_comparator` both
  reproduce that (`device.property` ×5), so it is not a one-off and the
  cross-over sits below 18 devices, not somewhere between 2 and 34. Filed:
  [klayout-tools#282](https://github.com/2AMLogic/klayout-tools/issues/282).
- **~~Single metal level.~~ Lifted — re-checked at `klt 0.1.0` for #72.**
  #68, #69 and #70 each re-checked this and each found `metals=((34, 0),)`.
  #72 re-checked it again and found the installed build now declares the full
  stack — `metals=((34,0),(36,0),(42,0),(46,0),(81,0))`,
  `vias=((35,0),(38,0),(40,0),(41,0))` — i.e.
  [klayout-tools#220](https://github.com/2AMLogic/klayout-tools/issues/220) /
  #238 have landed here. The DRC deck's `metal2`/`metal3` width and space rules
  are real and now actually exercised (they used to appear under
  `rules_skipped` only because no stream drew those layers).
  Consequences, in order of how much they matter:
  - `temp_por_top` routes on Metal2/Metal3 and so needs **no notch in either
    guard ring** — see its section above. This is the single biggest thing the
    lifted limit bought.
  - `por_comparator` is **unchanged**: it routes on Metal1 with Poly2
    crossunders, its committed GDS is byte-identical, and its recorded results
    stand. Nothing about the lifted limit obliges a redraw, and redrawing a
    proven cell to use a capability it does not need would be a regression risk
    for no gain. `por_output_chain` and `bias_core` keep the same Metal1-only
    *signal* routing too; #92 and #90 added `Metal4` to them only as MiM
    bottom-plate geometry. `temp_core`'s MOS network is likewise unchanged;
    #93 added its `R2` ladder and PNP array on Metal2 risers rather than Poly2
    crossunders specifically to keep the klayout-tools#288 poly-shape count
    from moving (see `temp_core`'s own section above) — the one cell here where
    the lifted limit *was* used, and by choice, not by need.
  - The MiM caps stopped being undrawn: the gf180mcu MiM stack (`Metal4` +
    `FuseTop` + the two marker layers) is in the deck's layer set, which is what
    let #92 draw `por_output_chain`'s and #90 `bias_core`'s. `temp_core`'s cap
    was the last one missing that marker geometry — a gap in *that* cell, not
    in the deck, left by #93, which drew its resistor and bipolar markers but
    deferred the cap. #259 closed it, per
    [DR-028](../spec/decision-records/DR-028-temp-core-xcc-draw-it.md), and
    used the lifted limit for the plate's own `Metal2`–`Metal5` escape route
    (see `temp_core`'s own section above) — the second cell here to route
    above Metal1 inside itself, and again by choice of the device, not of the
    signal routing.
  `layout/floorplan.md`'s "Routing / metal-level note" carries the same
  re-check.
- **DRC is a curated subset.** Width/space/enclosure across Poly2/Comp/Contact/
  Metal1–Metal5, plus Nwell spacing/enclosure, two MiM rules and one BJT rule.
  As of #90 every rule in the deck except the `metal5`/`metaltop` pairs is
  actually exercised by some cell in this repo — `bjt.separation.comp.1`,
  `mim.space.1` and `mim.enclosing.fusetop.1` left `rules_skipped` with the
  geometry that finally drew their layers. Clean here still means clean against
  *that subset*: there is no rule at all for `Pplus`, `SAB`, `RES_MK` or the
  `Resistor` ID layer, so nothing in this flow checks a drawn resistor's own
  DRM rules. It is not a tapeout-grade signoff, and no claim in this repo
  should be written as if it were.
- **~~`"enclosing"`/`"enclosed"` checks missed zero-overlap escapes.~~ Fixed
  upstream, found via `por_comparator` (#102/#103).** `klt drc`'s `"enclosing"`
  check kind (`poly2.enclosing.contact.1` among others) used to dispatch
  straight onto KLayout's `Region.enclosing_check`, which only reports
  *marginal* violations at facing edges of shapes that already partially
  overlap — a shape of the enclosed layer with **zero** overlap with the
  enclosing layer (the worst-case enclosure failure) produced no violation at
  all, so a layout that missed a contact's enclosure entirely could still
  read `status: clean`. Found rerunning `por_comparator`'s committed,
  unchanged GDS through a newer `klt` build and seeing it go from clean to 2
  violations with no layout change on this side. Filed generically (tool gap,
  no design details) as
  [klayout-tools#318](https://github.com/2AMLogic/klayout-tools/issues/318)
  and already fixed upstream (`klayout-tools` PR #327): the same rule id now
  also reports the zero-overlap escape. `por_comparator`'s own section above
  has the full trace; the drawing defect itself (not a tool problem) is #102.
- **Committed reports can silently drift onto two different `klt` deck
  revisions.** `provenance.deck.content_hash` (below) is a hash of the deck's
  own source module, so any change to the file that defines the `gf180mcu`
  deck — including one scoped to extraction, nothing to do with DRC rules —
  moves it, and nothing used to check that every committed
  `layout/reports/*/drc.json` names the *same* one. That is exactly how the
  zero-overlap-escape fix above went undetected here for as long as it did:
  `por_comparator`'s report was regenerated once, under an older deck, and
  never again. #103 added `python3 layout/lvs_reference.py --check-deck-hash`
  (wired into `run_checks.sh`, unscoped even for a single-cell run) so this
  fails loudly instead of drifting silently.
- **A report can also silently drift from *its own* GDS.** The deck-hash
  guard above catches two reports disagreeing with *each other*; it says
  nothing about whether a single report still describes the GDS committed
  alongside it. That is exactly the shape #102's incident took: nothing in
  `drc.json`/`extract.json` recorded which GDS bytes they were run against,
  so a stale report and a fresh one were textually identical. #106 added
  `provenance.gds_sha256` to `drc.json`/`extract.json` (mirroring
  `lvs.json`'s pre-existing `environment.layout_sha256`) and
  `python3 layout/lvs_reference.py --check-gds-hash` (also wired into
  `run_checks.sh`, also unscoped).
- **`klt --version` is not a build identity, and this repo learned it the hard
  way.** *(Diagnosed and fixed by #258; the entry stays because the failure is
  a property of the tool's identity surface, not a one-off mistake.)* A source
  build of `klayout-tools` made *after* a release tag still carries that tag's
  package version, so a post-tag build and the release it was built after both
  self-report the same `klt <version>` string while shipping **different**
  decks. Nothing in this flow could tell them apart, and the whole committed
  evidence base was recorded against an unreleased build: every report named
  `klt 0.1.0` and deck content hash `sha256:be1a89e0…872b1d`, which `klt deck
  resolve` — the tool's own hash → release lookup — reports **no released deck
  ships**. The deck-hash gate did not catch it, because the reports all agreed
  with *each other*; what none of them agreed with was a *release*. Two things
  follow, both now in the flow:
  - **The pin.** [`layout/toolchain.json`](toolchain.json) names the one `klt`
    build this evidence is for, by deck content hash and by release
    coordinates (package version, git tag, git commit) — see
    ["The pinned toolchain"](#the-pinned-toolchain) above. `run_checks.sh`
    probes the live `klt` and refuses to produce evidence against anything
    else, *before* writing a report; `--check-deck-hash` requires every
    committed report to name the pinned hash, not merely to agree with its
    neighbours.
  - **A residual tool gap**, filed generically as
    [klayout-tools#1202](https://github.com/2AMLogic/klayout-tools/issues/1202):
    a consumer has no cheap, first-class way to ask which deck revision the
    installed tool will use. `run_checks.sh` gets it by running a throwaway
    `klt drc` on a committed cell and reading
    `provenance.deck.content_hash` back out of the report — correct, but a
    full DRC run as a version probe. And the release a consumer must pin to in
    order to reproduce this evidence (`klt 0.2.0`) predates `klt deck resolve`
    itself, so the pinned build cannot resolve its own pin; `run_checks.sh`
    runs the resolver opportunistically and reports rather than fails when it
    is absent.

  Every "`klt 0.1.0`" elsewhere in this file and in `layout/floorplan.md` names
  that same unreleased build. Those statements are still accurate about *when*
  a capability first appeared in this repo's working environment; they are not
  statements about a published release, and nothing should be reproduced
  against them. The pinned `klt 0.2.0` is what the committed evidence answers
  to.

  The three failures this was first mistaken for are recorded in #258 and were
  measured against that same unreleased build, not against `klt 0.2.0`: under
  the pinned release every cell is DRC-clean and LVS-match. One of them was a
  real drawing defect all the same — 11 × `metal1.enclosing.contact.1`, the
  0.22 × 0.01 µm contact-landing slivers a `w = 0.5 µm` device's Metal1 riser
  left uncovered — and it is fixed in the drawn geometry
  (`build_cells.RISER_BASE_Y_UM`), so the cells are clean under the newer deck
  that carries the rule as well as under the pinned one. The other two were
  properties of that build, not of this layout: its `CapacitorDevice` refines
  the MiM capacitance model with a perimeter/fringe term the pinned deck does
  not have, which is why `lvs_reference` now writes the deck's law in full
  (`MIM_AREA_CAP_F_UM2` **and** `MIM_PERIM_CAP_F_UM`, the latter pinned at the
  pinned deck's own zero) rather than hard-coding the area-only special case.
  **Update (#312):** the pin has since moved past that point — `klt 0.6.0`'s
  deck carries exactly this perimeter/fringe term (`area_cap_f_um2=1.99e-15`,
  `perim_cap_f_um=2.383e-16`, transcribed from gf180mcu's own
  `sm141064.ngspice` model card), so the "pinned deck's own zero" above is
  itself now historical. `lvs_reference.py`'s `MIM_AREA_CAP_F_UM2`/
  `MIM_PERIM_CAP_F_UM` were re-transcribed to it, and `build_cap_cards` now
  also declares each MiM card's own extracted `A`/`P` geometry parameters,
  which the v0.2.0 deck never checked and the v0.6.0 deck does.

`layout/reports/environment.json` records the `klt` version, the deck content
hash and the release each report was produced with, because several of the
limits above are version-dependent — but it records them *after the fact*,
which is exactly why the pin above exists as well. Re-run `run_checks.sh`
after moving the pin and commit the refreshed reports; `run_checks.sh` checks
that every committed cell's `drc.json` names the pinned deck before running
anything else, so a report regenerated against a different `klt` for only some
cells is caught immediately rather than becoming this section's next entry.
Once that gate is already failing, `bash layout/run_checks.sh --regen-all` is
what repairs it (the plain command aborts at the gate before it can regenerate
anything — #108, extended to the GDS-hash gate by #258 so a deliberate
geometry change can bootstrap too); see "Repairing a split" above for why
deferring the gates that way does not weaken them.

## Item 11 — power delivery (structural): the `klt erc` supply read (#300)

T1 checklist item 11, "Power delivery (structural)"
([klayout-tools#2025](https://github.com/2AMLogic/klayout-tools/issues/2025)),
grades whether a declared supply reaches what it powers as one electrical
island, using a `klt erc` **supply spec** run
([`docs/cli/erc.md`](https://github.com/2AMLogic/klayout-tools/blob/main/docs/cli/erc.md)).
This repo had neither the spec nor the report until #300; both now exist —

- [`layout/cells/temp_por_top.erc-supply-spec.json`](cells/temp_por_top.erc-supply-spec.json)
  — the spec. It carried an inline top-level `_comment` block justifying
  every `stackup` entry, every `label_layer` and the `devices[]` carve-out
  (cross-checked against this block's own merged GDS with `klt layers
  --flattened --include-text`, and against the installed PDK's own
  `libs.tech/klayout/tech/gf180mcu.lyp`, not assumed from another block's
  spec); `klt 0.7.0` rejects any key outside the erc spec schema
  ([klayout-tools#2243](https://github.com/2AMLogic/klayout-tools/issues/2243))
  and has no comment convention, so that block moved verbatim to the sidecar
  [`layout/cells/temp_por_top.erc-supply-spec-NOTES.md`](cells/temp_por_top.erc-supply-spec-NOTES.md)
  when the report was regenerated on the released tool (see the second
  toolchain note below).
- [`layout/reports/temp_por_top/erc_supply.json`](reports/temp_por_top/erc_supply.json)
  — the committed run, `provenance.input.content_hash ==
  sha256:a119a12b1fa2daff64772a4a804a0ea14f17c68dc9357fe167dfd287df0628fd`,
  matching the committed `layout/cells/temp_por_top.gds` (`shasum -a 256`),
  and `provenance.spec.content_hash ==
  sha256:773047b13bc8e858ee6a284d0f6e00843a727bd0bb177267ca8bca24d616b170`,
  matching the committed spec (first recorded for #300, moved by #310's
  `ties[]` additions, and moved again by the `_comment` removal above — see
  "`erc.missing_tie`: now computed" below for what #310 changed and why the
  hash moved then).

**The run is clean: `erc_finding_count: 0`.** Both declared supplies —
`VDD` and `VSS`, each `"kind": "supply"` — resolve to exactly one
electrical island each: zero `erc.unconnected_net` (which fires both on a
net no geometry carries *and* on a net split into islands that never
touch), and zero `erc.supply_short`. That is item 11's structural pass
condition, and it is not the report's overall `status` field, which reads
`not_checked` for an unrelated reason — see "Reading the `status` field"
below.

Getting there took two passes, and the first one is worth keeping on the
record: the original run of this spec (#303) reported one
`erc.supply_short` naming `VDD`/`VSS`, which was *not* a power-delivery
defect but a consequence of `klt erc` having no way to represent a drawn
device body. The section after next explains what changed.

### Toolchain note: why this report was not produced with the pinned `klt 0.5.0`

`signoff/toolchain.json` pins `klt 0.5.0` as this repo's grader, and, **at the
time this report was produced**, `layout/toolchain.json` pinned `klt 0.2.0` as
the build the DRC/LVS evidence under `layout/reports/` answered to (#311/#312
have since moved that pin to `klt 0.6.0` — see "The pinned toolchain" above —
for reasons unrelated to `klt erc`; this report itself has not been
re-examined against the new pin, and may or may not still need a build past
it). This one report answered to neither pin in force at the time, and
deliberately so — it needed two `klt erc` capabilities that postdated both:

1. **`provenance`** (and `status`), added by `klayout-tools#1984`/`#2049`.
   `klt 0.5.0`'s `klt erc` emits neither; its JSON is just
   `{schema_version, file, spec, pdk, gate_role, gate_count, gates,
   erc_findings, erc_finding_count}`, with no way to pin the report to the
   GDS bytes it was run against. Item 11's own acceptance bar requires a
   content-hash-pinned report, so the pinned grader cannot produce one.
2. **`devices[]`**, added by
   [klayout-tools#2205](https://github.com/2AMLogic/klayout-tools/pull/2205)
   at commit `ddf47e78` (2026-09-20), closing
   [klayout-tools#2183](https://github.com/2AMLogic/klayout-tools/issues/2183).
   Without it this block's supply verdict is structurally unavailable, not
   merely unpinned — see the next section.

The committed report was therefore produced with `klayout-tools` built from
`main` at commit `99a5716c` (`klt 0.5.0+g99a5716ccccb`, `klayout_version:
"0.30.12"`), which is the first state of the tree carrying both. `klt
--version` cannot distinguish that build from the released `0.5.0` — the
same identity trap #258 already cost this repo once — so the build is named
here by git commit and echoed in the report's own
`provenance.klt_version`, which carries the `+g99a5716ccccb` suffix.

This mirrors the same class of gap `layout/toolchain.json` vs.
`signoff/toolchain.json` already documents for `klt lvs`'s own missing
`provenance.input` (worked around there by `lvs_reference.py
--check-gds-hash`) — a producer needing a newer, unreleased build than the
grader it will eventually be read by. Nothing else under `layout/reports/`
was regenerated against `99a5716c`; the deck-hash gates that protect the
DRC/LVS evidence are untouched, and this report names no deck at all
(`provenance.deck: null`) because `klt erc` reads only the spec's own declared
layers, never a curated deck — restated, for both toolchain notes together, in
the parenthetical that closes the next section.

### Toolchain note (#310): why `ties[]` needed a build past `klt 0.6.0` too

`layout/toolchain.json` now pins `klt 0.6.0` (moved there by #311/#312,
unrelated to `klt erc`), and at first glance that release looks sufficient
for `ties[]`: it already carries `tap_boxes` (#2234) and `well_layer: null` +
`well_boxes` (#2255), both load-bearing for this spec's `substrate_tie`
entry. It is **not** sufficient for the other three entries, confirmed by
reading `klt erc`'s source directly at the `v0.6.0` tag (commit `c622e8ad`,
2026-09-22): `well_requires`/`well_excludes` (issue #2339, the device-body/
PNP-base class selector) and `well_requires_boxes`/`well_excludes_boxes`
(issue #2540, the same selector for a tub with no marker layer to narrow by —
needed for `nw2_tail_well`'s own well selection) both merged to `main` on
2026-09-30, eight days after the tag. Running this spec against the released
`v0.6.0` reproduces exactly the failure that absence predicts: 16 false
`erc.missing_tie` findings, one per merged polygon the selector could not
narrow, because the unrecognised selector key is accepted but has no effect —
every tie grades every shape of its `well_layer`, the pre-#2339 behaviour.

This re-run therefore answers to `klayout-tools` built from `main` at commit
`af8d6c54312e` (`klt 0.6.0+gaf8d6c54312e`, `klayout_version: "0.30.12"`),
echoed in `provenance.klt_version`, which carries the `+gaf8d6c54312e` suffix
precisely so it is never mistaken for the tagged `v0.6.0` release. As before,
nothing else under `layout/reports/` was regenerated against this build —
`layout/run_checks.sh`'s `toolchain_gate` probes only `klt drc`'s curated
deck (never `klt erc`, which reads only this spec's own declared layers and
names no deck at all), and `layout/lvs_reference.py`'s `GDS_HASH_FIELDS` does
not list `erc_supply.json`, so neither gate is affected by this report
answering to a different build than the one that produced the DRC/LVS
evidence beside it.

### Update (PR #351): the report now answers to the released `klt 0.7.0`

The `af8d6c54312e` build above was the last `klt` that could grade this
spec's `ties[]` declarations when they were written. `klt 0.7.0` has since
been released carrying both selector families (#2339 and #2540), and the
operator ruling on
[PR #351](https://github.com/2AMLogic/gf180-temp-por/pull/351) declined to
keep item 11 graded on an unreleased build: the report was regenerated with
the released `klt 0.7.0` (`provenance.klt_version: "0.7.0"`, no build
suffix). The verdict is unchanged — zero findings, all four ties `checked`,
same GDS pin — and the two notes above stand as the record of why the runs
before this one answered to `main` builds. The regeneration did move the
spec's content hash once more: `klt 0.7.0` enforces strict spec-key
validation ([klayout-tools#2243](https://github.com/2AMLogic/klayout-tools/issues/2243))
and the spec schema has no comment convention, so the inline `_comment`
justification block moved verbatim to the sidecar
[`temp_por_top.erc-supply-spec-NOTES.md`](cells/temp_por_top.erc-supply-spec-NOTES.md)
(`provenance.spec.content_hash` is now `sha256:773047b1…`). `signoff/README.md`'s
item 11 section carries the claim-side half of this account, including the
spec-declaration coverage disclosure (`layers_in_stream_without_declaration`)
that the `klt 0.7.0` tiers doc asks a `met` claim to quote.

**A methodology note worth recording alongside the toolchain one.** Every
`tap_boxes` entry in the committed spec is a narrow, independently-verified
assertion — never the bare, un-narrowed `tap_layer` a quick `tap_is_dedicated:
true` probe would accept. This is not merely the `klayout-tools#2199`
degeneracy rule (an unnarrowed tap on an implant-free stream always grades
`degenerate_tap_declaration`, never `checked`) forcing the hand that wrote it.
Verified directly against this block's own GDS: an un-narrowed tap registered
into `klt erc`'s connectivity graph can **merge unrelated nets** on a stream
whose `_mos_finger` draws no implant layer at all — a drawn gate does not cut
a comp region registered as one conductor, so a well-wide tap conducts across
every source/drain terminal that well's row draws, not just the real tie. A
throwaway two-tie probe against `bias_core.gds` with both taps
`tap_is_dedicated: true` and no narrowing merged `BIAS_OK`/`IBIAS`/`VDD`/
`VREF` into one electrical net and reported *every* declared well tied to
*every* declared net, including a vertical-PNP base tub whose real tie is
`VSS`, not `VDD`. Narrowing every `tap_boxes` entry to the specific comp this
spec's own commentary names (never the whole device row, never a ring's
enclosing rectangle) is what keeps this report's `erc_status: clean` a
statement about real taps rather than an artifact of how broadly they were
declared — confirmed by deleting, one region at a time, the tap box(es) that
tie a single well/tub/ring (leaving the rest of that entry's `tap_boxes`
intact) and checking that exactly that region's `erc.missing_tie` finding
reappears, scoped to its own bbox alone, with every other declared tie —
including ones sharing its `well_layer`, its `net`, or both — unaffected.
Verified that way for each of `device_body_wells`' five wells, each of
`pnp_base_tubs`' two base tubs, and a whole `substrate_tie` ring: one finding
each, `erc_coverage.skipped` still empty.

**Two things that probe does *not* show**, spelled out because the obvious
first experiment runs into both:

- **Emptying a whole `tap_boxes` array reports no finding at all.** A tap
  assertion that narrows nothing grades `degenerate_tap_declaration`
  ([klayout-tools#2199](https://github.com/2AMLogic/klayout-tools/issues/2199)),
  so the entry moves into `erc_coverage.skipped` and `erc_status` degrades to
  `clean_partial` while `erc_findings` / `erc_finding_count` — the fields
  "Reading the `status` field" below names as the ones carrying the verdict —
  stay at zero. Confirmed for all four entries. That is still a real guard,
  because the degradation is loud rather than a silent clean, but it is a
  *coverage* signal, not a verdict finding: item 11's pass condition is
  therefore zero findings **and** `erc_coverage.skipped: []` **and**
  `erc_status: clean`, never the finding count alone.
- **Deleting a single segment of a multi-segment tie leaves the report fully
  clean** (`erc_status: clean`, `skipped: []`) — by construction, not as a
  gap: each `substrate_tie` ring is asserted by four edge segments and the
  remaining three still tie it, and NW2 carries six finger taps for the one
  well. The sensitivity this declaration has is per-region, not per-segment.

The complementary probe — declaring a tie's `net` *wrong* rather than removing
its tap — does report `erc.missing_tie`, under a different description
("well/tub tap is not connected to declared net …"): declaring
`nw2_tail_well`'s net as `VDD` instead of `NT` yields exactly one finding, on
NW2's own bbox. That is the independent check that `NT`, not the supply, really
is that well's body tie.

(The DRC/LVS evidence beside this report is untouched by either toolchain
note above, and this report names no deck at all — `provenance.deck: null`
— because `klt erc` reads only the spec's own declared layers, never a
curated deck.)

### How the false `erc.supply_short` was resolved: `devices[]`

`klt erc`'s connectivity model traces wire/via connectivity only; it
registers **no device extraction** — unlike `klt extract`'s deck-based LVS
extraction, which *does* recognise this PDK's poly-resistor devices
(`docs/cli/erc.md`, "Connectivity model"; this repo's own "Known deck
limits" section above documents the LVS side of that same distinction, and
the pre-#219 era where the LVS deck had the identical gap). This block
draws real `ppolyf_u`/`ppolyf_u_1k` poly-resistor devices whose two
terminals are declared nets — `temp_core`'s R2 gain ladder
(`design/netlist/temp_por_top.spice`: `XR2F PTAT T5 VSS ppolyf_u ...`,
`XR2T5 T5 T4 VSS ppolyf_u ...`, ... down to `XR2T0 T0 VSS VSS ppolyf_u
...`), `bias_core`'s bias resistors, and `por_comparator`'s supply-sensing
sense divider. With no device model, `klt erc` read each resistor's poly
body as a plain wire joining its two terminal nets — which, chained across
an analog bias/reference network and a divider drawn deliberately across
the rails, joins `VDD` and `VSS` into one island. That was the finding the
first committed run reported.

It was filed upstream, generically, as
[klayout-tools#2183](https://github.com/2AMLogic/klayout-tools/issues/2183)
(reopened by that work with an independent second reproduction): *"klt erc
reads a drawn resistor body as a wire, so any rail-to-rail device string
reports a false erc.supply_short."* **Upstream fixed it** in
[klayout-tools#2205](https://github.com/2AMLogic/klayout-tools/pull/2205)
(commit `ddf47e78`, 2026-09-20) by adding an optional `devices[]` array to
the spec: each entry names a drawn device-body **marker** layer and the
`stackup`/`vias` role that body sits on, and that region is subtracted from
the role's conductor region *before* connectivity is registered — so the
body breaks the net instead of bridging it. Crucially it is a declaration
in the spec, not a pre-processing step on the stream: the committed report
still describes the committed GDS byte-for-byte, which a hand-edited stream
would have destroyed.

This spec's declaration is one entry:

```json
"devices": [
  { "name": "poly_resistor_bodies", "body_layer": "110/5", "on": "poly2" }
]
```

**`110/5` is `RES_MK`, and it is deliberately not `62/0`.** #300's own
guidance proposed `62/0` (this repo's `RESISTOR_ID`), which does clear the
finding — but `62/0` is only the *class selector* that picks `ppolyf_u_1k`
out of the resistor family. In this GDS it is drawn on 251 shapes, all in
`bias_core` (24) and `por_comparator` (227) and **none** in `temp_core`,
whose R2 gain-ladder segments are plain `ppolyf_u` bodies marked
`Pplus`/`SAB`/`RES_MK` only (`layout/build_cells.py`'s `_r_segment`).
`RES_MK` is the deck's resistor-*candidate* marker, required for every
recognised flavour, and is drawn on all 301 body shapes (`bias_core` 24 +
`por_comparator` 227 + `temp_core` 50). Measured on this GDS:

| region | area |
| --- | --- |
| `RES_MK ∩ Poly2` (what `110/5` removes) | 50526.34 µm² |
| `Resistor(62/0) ∩ Poly2` (what `62/0` would remove) | 41858.34 µm² |
| difference — real resistor body `62/0` leaves modelled as wire | 8668.00 µm² |

Both declarations clear the false short; only `RES_MK` describes the layout
completely, so `RES_MK` is what is committed.

**Over-coverage cross-check.** `klt erc`'s own docs warn that the
subtraction is purely geometric — "it cuts, so declare it where the device
is" — and that a marker over-covering real routing typically shows up as a
new `erc.unconnected_net` or `erc.floating_gate`. Measured directly:
`RES_MK ∩ (Poly2 ∩ Comp) = 0.000 µm²`, i.e. the carve-out removes no gate
region at all, and the run reports zero findings of either kind. Note that
the report's own `provenance.devices[0].body_area_um2` reads `53126.74`,
which is `RES_MK`'s *own* merged area rather than the 50526.34 µm² actually
subtracted from Poly2 — the 2600.40 µm² difference is `_r_segment`'s
deliberate ±0.3 µm marker overhang in x, sitting over no conductor and so
subtracting nothing. The field documenting itself as the subtracted area
while reporting the marker area is an upstream reporting gap, filed
generically by this work as
[klayout-tools#2226](https://github.com/2AMLogic/klayout-tools/issues/2226);
it does not affect this verdict, but it is why the areas above were measured
independently rather than read out of the report.

### Why the cleared verdict is trustworthy, not just quieter

A carve-out that clears a finding is only as good as the reason it cleared.
Three independent checks — all of which predate `devices[]` and none of
which use `klt erc` — agree that `VDD` and `VSS` are genuinely separate
here, so the cleared run is reporting the truth rather than hiding a defect:

- **`klt lvs`** (`layout/reports/temp_por_top/lvs.json`) reports `status:
  match` over 145/145 nets with device recognition switched on — `VDD` and
  `VSS` both appear in `net_correspondence` as distinct, correctly matched
  nets, paired against the SPICE reference's own `VDD`/`VSS` (which is also
  what item 11's analog column asks for: a supply appearing in an LVS
  reference's `net_correspondence`, which a SPICE reference satisfies by
  construction).
- **Incremental stackup growth localized the mechanism**, back when the
  finding was still present. A Poly2+Metal1-only spec (Contact via only)
  resolved `VDD`/`VSS` into several disconnected islands each — no short.
  Adding Metal2+Via1 is what produced the single `erc.supply_short` — i.e.
  the merge traced to the resistor ladder's own contacts and metal taps, not
  to the top-level VDD/VSS rails' geometry. `klt components` (an independent
  code path, same connectivity contract) corroborated this directly:
  building the identical conductor/via graph by hand and asking which
  component carries both the `VDD` and `VSS` labels found exactly one, whose
  bounding box is a small, localized region — not the full-width supply
  rails. That is precisely the region `devices[]` now carves out.
- **DRC is clean** (`layout/reports/temp_por_top/drc.json`) — no shorted-rail
  spacing violation on Metal1/Metal2, which a real physical short of two
  full-width rails would be expected to produce.

No `erc.floating_gate` finding appears in the committed run, and none
appeared in the pre-`devices[]` run at this build either — the carve-out is
not what removed them. They show up only at the released `klt 0.5.0`, whose
`klt erc` lacks the `active_layer` (`poly ∩ diff`) gate test and therefore
counts four extra "gates" that are not gates: `temp_core`'s intentional,
uncontacted edge-dummy poly legs (`layout/build_cells.py`'s
`_R_DUMMY_LEGS`, "unmarked, uncontacted edge legs at each end of the
bank"), which are matching devices rather than electrical nets, so having no
connected geometry above the gate layer is by design. Item 11's own text
excludes a floating-gate finding from its scope regardless
(`docs/design-evidence-tiers.md` item 11: *"An antenna verdict or a
floating-gate finding in the same report is a real defect but is not this
item's subject and does not block it"*).

`gate_count` moves between runs for a related but distinct reason, and is
not a verdict either: 43 at the original `f2f1d14e` build, 43 at this build
without `devices[]`, and **48** with it — the five extra are poly nets the
resistor bodies previously merged into their neighbours, now separated by
the carve-out.

### Reading the `status` field: `not_checked` is about antennas, not supplies

The committed report's top-level `status` is `not_checked`, and the process
exit code is `4`. Neither is a supply verdict. `klt erc` grades a
*coverage envelope* whose `scope` is `antenna`, and this run was invoked
without `--pdk`, so all 240 per-gate/per-layer antenna checks are recorded
as `skipped` with `reason: "missing_antenna_pdk"` and nothing is `checked`.
Zero checks performed plus zero findings is `not_checked`, not `clean`.

Item 11 is explicit that its pass condition is *not* the overall `status`
(`docs/design-evidence-tiers.md`: every declared supply resolving to exactly
one electrical island, no `erc.unconnected_net` and no `erc.supply_short`
naming it), and equally explicit that an antenna verdict in the same report
"is a real defect but is not this item's subject and does not block it".
The antenna gap is real and separately owned — gf180mcu's antenna rules are
not in this flow's reach today — but it is not what item 11 grades. The
fields that carry item 11's verdict are `erc_findings` and
`erc_finding_count`, and both are empty/zero.

### `erc.missing_tie`: now computed (#310)

The spec declared no `ties[]` until #310, per
[klayout-tools#2169](https://github.com/2AMLogic/klayout-tools/issues/2169):
on the `klt` build this repo could reach at the time, declaring one collapsed
a real design into one electrical island and reported a *different* false
`erc.supply_short`. That bug is fixed upstream (the fix is in every `klt`
build this repo can reach, including the released `v0.6.0` — see "Toolchain
note (#310)" above for the *different* feature gap that build still has), so
the spec now declares four `ties[]` entries and `erc.missing_tie` is
**computed**: zero findings, every tie graded `checked` (none in
`erc_coverage.skipped`), confirmed in the committed report.

The four entries, and what each one is about:

- **`device_body_wells` -> VDD** — every ordinary PMOS device-body Nwell in
  the design (`temp_core`'s NW1, `bias_core`'s and `por_comparator`'s and
  `por_output_chain`'s PMOS rows, `por_comparator_bias_okb_inv`'s own small
  well), via `well_excludes: ["127/5"]` (drops the two PNP base tubs) and
  `well_excludes_boxes` (drops `temp_core`'s NW2 — see `nw2_tail_well`
  below). `tap_boxes` names each well's own dedicated VDD tie-strap comp (or,
  for `temp_core`'s NW1, which draws no separate strap, the source-side half
  of a real VDD-sourced device's own comp) — this stream draws no implant
  layer on any MOS device at all, so `tap_requires` cannot name a real tap
  boolean here (klayout-tools#2199/#2234).
- **`pnp_base_tubs` -> VSS** — the two vertical-PNP arrays' own base tubs
  (`temp_core`'s and `bias_core`'s), selected by `well_requires: ["127/5"]`
  (klayout-tools#2339): both are diode-connected to their own collector
  substrate ring, so the base ties to VSS rather than VDD, unlike every
  device-body well above.
- **`nw2_tail_well` -> NT** — `temp_core`'s differential-pair well, which
  this design deliberately body-ties to the pair's own shared tail node
  rather than to a supply (a standard body-effect-cancellation move),
  confirmed from `_TEMP_CORE_ROW`: none of NW2's six fingers names VDD, and
  `NT` carries its own Metal1 label inside `temp_core`, so the tie is
  independently checkable rather than merely asserted.
- **`substrate_tie` -> VSS**, `well_layer: null` + `well_boxes`
  (klayout-tools#2255) — every native-substrate tie in the design: the outer
  perimeter guard ring, the domain-seam moat, each sub-circuit's own guard
  ring, and the PNP arrays' outer (Pplus) collector rings. The deck draws no
  p-well/p-substrate layer at all (this repo's own "Known deck limits"
  section, item 4's disclosure in `signoff/README.md`), so these ties have
  nothing to name as a drawn well; `well_boxes` asserts each ring's own four
  edge segments (never a ring's enclosing rectangle — for the outer
  perimeter ring that is within 1% of the whole top cell's own extent and
  would grade `degenerate_well_assertion`).

See the spec's own `_comment` block for the full per-entry justification,
including the falsifiability checks run against this GDS before any of the
above was combined into one spec (each class verified to produce a real
`erc.missing_tie` finding when the tap box(es) tying one of its wells/tubs/
rings are deliberately deleted, with every other declared tie unaffected —
and the two near-miss probes that do *not* produce a finding, emptying a whole
`tap_boxes` array and dropping a single segment of a multi-segment ring, which
the methodology note under "Toolchain note (#310)" above spells out) and the
connectivity-corruption risk an unnarrowed tap would have posed on this
specific, implant-free stream.

What this supersedes, from before #310: `layout/floorplan.md`'s guard-ring/
moat prose account is now corroborated by a computed `erc.missing_tie`
result rather than standing in for one, and the gf180mcu curated deck's own
gap — it draws no distinct substrate/well-tap marker layer at all, so
unlike `gf180-drone-fc`'s digital flow (whose fill-tie cell's own `VNW`/
`VPW` well-pin labels are cited as standing-in evidence) this block has no
PDK-marked well/tap geometry to cite directly — is why `substrate_tie`
above asserts the ring geometry with `well_boxes` instead of selecting a
drawn well layer. `layout/build_cells.py`'s own `_top_assert_connected`
build-time check (every via this cell draws is asserted to land inside
metal on both of the levels it bridges) and LVS's independent confirmation
of the same vias are unaffected and still apply.

### Reproducing

```bash
# The build this report answers to -- NOT the pinned `klt`, on purpose (see
# "Toolchain note (#310)" above). Use a throwaway environment: this build
# must not become the `klt` that layout/run_checks.sh sees on PATH.
python3 -m venv /tmp/klt-erc && /tmp/klt-erc/bin/pip install \
  "git+https://github.com/2AMLogic/klayout-tools.git@af8d6c54312e"

/tmp/klt-erc/bin/klt erc layout/cells/temp_por_top.gds \
  layout/cells/temp_por_top.erc-supply-spec.json --format json \
  | diff -u layout/reports/temp_por_top/erc_supply.json - && echo reproduced
```

(The original, `ties`-less version of this report instead answered to commit
`99a5716c` — still the commit named in "Toolchain note: why this report was
not produced with the pinned `klt 0.5.0`" above, which that paragraph's own
history is about, not this one's.)

Exit code `4` (`not_checked`) is expected and is not a failure of item 11 —
see "Reading the `status` field" above. The assertions that matter are
`erc_finding_count == 0` and `provenance.input.content_hash` matching
`shasum -a 256 layout/cells/temp_por_top.gds`.

The area cross-checks quoted above are not produced by `klt erc`; they were
measured directly from the committed GDS:

```python
import klayout.db as db
ly = db.Layout(); ly.read("layout/cells/temp_por_top.gds")
top, dbu = ly.top_cell(), ly.dbu

def region(layer, datatype):
    r = db.Region(top.begin_shapes_rec(ly.find_layer(layer, datatype)))
    r.merge()
    return r

def um2(r):
    return r.area() * dbu * dbu

poly, comp = region(30, 0), region(22, 0)
res_mk, resistor_id = region(110, 5), region(62, 0)
print(um2(poly & res_mk), um2(poly & resistor_id), um2((poly & comp) & res_mk))
# 50526.34  41858.34  0.0
```

## Adding a cell (for #17 / #18)

1. Add a builder function to `layout/build_cells.py` and register it in `CELLS`;
   run `python3 layout/build_cells.py --cell <name>` to write the GDS.
2. Add a manifest entry to `layout/lvs_reference.py`'s `CELLS` — the golden
   netlist it derives from, the devices to take, the layout's own pin set
   (`ports`), its unlabelled internal nets (`internal`), and which PMOS devices
   share which drawn Nwell (`wells`), plus any non-MOS devices the cell draws:
   `caps` (MiM — plate nets are the card's own declared nodes, on the
   assumption the plates are drawn routed onto them (#264); a cell that still
   draws a MiM cap's plates floating needs its own per-instance isolated net
   synthesis instead of `cap_plate_nets`'s current one-line return, because
   the deck cannot connect an unrouted plate to anything), `resistors` (+ an
   optional
   `resistor_fold` — the leg count comes from `resistor_segments`, and the
   nodes between legs are synthesized the same way) and `bipolars` +
   `bjt_well` (vertical bipolars — the collector is rewritten to the substrate
   global and the base to the drawn well, and `AE` is declared from the PDK
   subcircuit's own emitter size; a `Q` card without it does not pair). Run it to
   write the reference. On a cell with more than two devices, check that
   `devices[0]` and `devices[1]` do not share a source net — if they do, the
   `topology` negative control corrupts nothing and silently stops controlling
   anything.
3. Copy an existing `cells/<cell>.lvs.json` and point it at the new names.
   **If the cell instances other cells**, set `"top_cell_pins": true` in its
   `layout` block — otherwise every label inside every instanced sub-cell
   becomes a pin of yours, and the compare is against a pin set nobody
   designed. `run_checks.sh` mirrors that flag onto the recorded `klt extract`
   run and onto both negative-control requests, so all three see the same
   compare.
4. `bash layout/run_checks.sh <name>` — and do not treat a clean LVS as real
   until both negative controls report detected.

An **assembly** cell (one that instances others, like `temp_por_top`) differs in
two further ways:

- Its `lvs_reference.py` manifest lists no devices. It carries an `assembly`
  field naming `(instance, cell)` pairs, and the reference is composed from
  those cells' own manifests with each instance's nets renamed through the
  golden top-level netlist's own instance lines — a formal port maps to whatever
  the top level wires it to, every other net is prefixed with the instance name,
  and the deck's substrate global is never renamed. Nothing is retyped, so the
  assembled reference cannot drift from the cells it assembles.
- Nothing in this flow checks a guard ring, a well tie, or a different-net
  overlap on the same layer (all three are DRC-clean and LVS-match — see
  [Known deck limits](#known-deck-limits--what-a-clean-lvs-here-does-not-prove)).
  If your cell draws rings or rails, check the geometry yourself at build time
  and refuse to write the stream otherwise; `temp_por_top`'s `_TopRoutes.check`
  and `_top_guard_ring` are the pattern, and `layout/tests` covers them without
  needing `klt` or a PDK.

Keep the friction protocol running while you do it: every time `klt` is
awkward, missing something, or wrong, file it generically at
`2AMLogic/klayout-tools` — the tool gap, never the design.
