2AMLogic/gf180-temp-por/sim/harness/README.md

# sim/harness — the PVT corner runner

Reproducible ngspice simulation against the gf180mcu PDK. This document covers
**how to run** the harness and **how to write a testbench**.

The *output* of a run — directory layout, record-id format, the summary record
field set, and the append-only rule — is defined by
[`sim/README.md`](../README.md), not here. That convention is authoritative;
this harness exists to produce records that conform to it.

Ported from the `2AMLogic/gf180-bandgap` sister repo (their issue #2 / PR #23)
per CLAUDE.md's harness-bootstrap rule. Deliberate divergences are recorded in
[`spec/decision-records/DR-006-sim-harness-port.md`](../../spec/decision-records/DR-006-sim-harness-port.md)
— the notable one being that **`full` is this repo's default corner set**,
not `mos`.

```
sim/
  run_corners.py            CLI entry point (stdlib python3, no venv)
  run_mc.py                 Monte Carlo mismatch entry point (see "Monte Carlo" below)
  env.sh                    `source sim/env.sh` to export the same PDK to your shell
  selftest.sh               harness acceptance test (unit tests + end-to-end PVT run)
  pdk.json                  committed PDK defaults (variant, extra search roots)
  harness/                  the runner itself (this directory)
  tests/                    harness unit tests (no PDK, no ngspice required)
  .work/                    generated ngspice decks (git-ignored, disposable)

  <experiment-slug>/        one per claim under test -- see sim/README.md
    testbench/              tb.json + netlist fragment      <- you write these
    netlist-snapshots/      frozen netlist per record       <- the harness writes these
    corners/<record-id>/    raw <corner-id>.log per PVT point
    records/<record-id>.md  append-only summary record
```

## Quick start

```bash
python3 sim/run_corners.py --check-env     # is ngspice + the PDK present?
python3 sim/run_corners.py --list          # experiments, corners, corner sets
python3 sim/run_corners.py smoke-bias      # run the full PVT grid, mint a record
bash sim/selftest.sh                       # prove the harness works (writes nothing)

python3 sim/run_mc.py --list               # Monte Carlo experiments + binding points
python3 sim/run_mc.py temp-accuracy-mc     # N samples per binding point, mint a record
```

## Prerequisites

| Tool | Why | Install |
|---|---|---|
| `ngspice` | simulation | `brew install ngspice` / `apt-get install ngspice` |
| gf180mcu PDK | device models | `pip install volare && volare enable --pdk gf180mcu <hash>` |
| `xschem` | schematic capture (optional for simulation) | `brew install xschem` / distro package |
| python3 ≥ 3.9 | the harness | stdlib only, no packages |

The harness never hardcodes a PDK path. It resolves one, in order:

1. `GF180_PDK_PATH` — the *variant* directory, e.g. `~/.volare/gf180mcuD`
   (the one containing `libs.tech/`).
2. `PDK_ROOT` (+ `PDK`, default `gf180mcuD`) — the open_pdks / OpenLane convention.
3. `sim/pdk.local.json` — machine-local, git-ignored.
4. `sim/pdk.json` — committed defaults.
5. Built-in search roots: `~/.volare`, `~/.ciel`, `/usr/share/pdk`,
   `/usr/local/share/pdk`, `~/share/pdk`, `/opt/pdk`.

If nothing is found the runner exits 3 with install instructions rather than
producing a misleading result. `sim/run_corners.py --print-env` emits the
resolved paths as shell exports; `source sim/env.sh` applies them so that an
interactive ngspice or xschem session uses the identical PDK.

## The PVT grid

`CLAUDE.md` requires PVT corners on every recorded result. The defaults are
baked into `corners.py` and are what a testbench gets unless its manifest says
otherwise:

- **Temperature**: −40, 27, 125 °C (the README spec table's rated range)
- **Voltage**: nominal ±10 % — 3.3 V flavor per DR-001, so 2.97 / 3.3 / 3.63 V
- **Process**: see below

gf180mcu has no single global corner switch — each device family carries its
own `.lib` section in `sm141064.ngspice`, so a named corner here is a bundle of
six sections (MOS, resistor, BJT, diode, MOS cap, MIM cap):

| Corner | Meaning |
|---|---|
| `tt` | everything typical |
| `ff` / `ss` | every device family fast / slow |
| `fs` / `sf` | fast-N/slow-P and slow-N/fast-P, passives typical |
| `res_ff` / `res_ss` | resistor sheet rho skewed, rest typical |
| `bjt_ff` / `bjt_ss` | BJT skewed, rest typical |

Corner sets: `tt` (1), `mos` (5), `full` (9 — **the default in this repo**).
`full` × 3 temperatures × 3 supplies = 81 operating points, about half a
minute at full host parallelism (`-j` matched to the host's logical core
count — see "Job parallelism (`-j`/`--jobs`)" below for what the default
actually resolves to).

`full` is the default here because both circuits in this block ride on
passives, not just on the MOS skew: the sensing core is a vertical-PNP
VBE/ΔVBE pair scaled by a resistor ratio (so `bjt_ff`/`bjt_ss` and
`res_ff`/`res_ss` move the answer directly), and the POR threshold is a
resistor-divided VDD tap compared against that same reference. A `mos`-only
sweep would look green while never touching the devices that set the spec.
`--corner-set mos` remains available for a quick MOS-only iteration, but a
recorded claim should use the default.

Each point becomes one `<corner-id>` — `<process>_<temp>c_<supply>v`, the
naming `sim/README.md` ratifies — and one raw log under
`corners/<record-id>/`.

Override any axis from the command line:

```bash
python3 sim/run_corners.py smoke-bias --corner-set mos -j 4
python3 sim/run_corners.py smoke-bias --corners tt res_ss --temps -40 125
python3 sim/run_corners.py smoke-bias --supply 5.0 --supply-tol 0.10   # 5 V flavor
```

### Job parallelism (`-j`/`--jobs`)

Leave `-j` unset unless you have a specific reason to override it. Both entry
points (`run_corners.py` via `harness/cli.py`, and `run_mc.py`) default to
`sim/harness/cliutil.py`'s `default_jobs()`: half the host's logical cores
(floor), minimum 1 — headroom, not a claim on every core.

**This is a per-process default.** It cannot see other `run_corners.py` /
`run_mc.py` invocations running concurrently on the same host — a second
worktree's designer-check sweep, a third agent's Monte Carlo run, and so on.
N concurrent invocations each independently pick this same per-process
number, so host load still scales with N; halving the per-process default
only buys headroom for a handful of concurrent agents, not an unbounded
number. A host-wide budget shared *across* concurrently running agents is a
fleet-orchestration concern this repo cannot implement on its own — see
[rjwalters/loom#5979](https://github.com/rjwalters/loom/issues/5979).

If you do need to override it (e.g. a known-idle host, or a shared host
where even the default is too much), pass `-j N` explicitly — an explicit
value always wins over the default.

### ngspice's own thread parallelism (and why it must stay off)

A locally-built ngspice can link `libgomp` and, by default, open an OpenMP
team sized to the host's logical core count for device-model loading. That is
a **second, nested** layer of parallelism underneath this harness's own
process-level `-j` — one that only adds contention, since `-j` already runs
one ngspice process per point. Measured on one post-layout point (21.6 ms
transient, 8-core host, #216): 83.9 s wall with ngspice's default thread team
vs. **3.7 s** with `set num_threads=1` — 22x slower, bit-identical results
either way. Across a full grid the effect compounds badly enough to blow past
`--timeout` on every point (`DEFAULT_TIMEOUT_S = 300`) without producing a
single measurement.

**`OMP_NUM_THREADS` does not fix this.** ngspice's own `num_threads` control
variable calls `omp_set_num_threads()` itself at startup, overriding whatever
the environment set. The only lever that works is `set num_threads=1` inside
a `.spiceinit` ngspice reads at startup (or a deck's own `.control` block).

`run_point()` (`sim/harness/runner.py`) handles this for you: before invoking
ngspice, it writes a `.spiceinit` into the point's work directory forcing
`set num_threads=1`. `run_mc_point()` (`sim/harness/montecarlo.py`, the Monte
Carlo path driven by `sim/run_mc.py` and its own `-j`-parallel
`run_mc_grid()`) does the same, via the identical `runner.write_run_spiceinit`
call (#229) -- it is exposed to the same nested-OpenMP contention as the
deterministic-grid path, since it runs under the same process/thread `-j`
model. Because ngspice reads *either* a project-local
`./.spiceinit` *or* `$HOME/.spiceinit` at startup — never both — that per-run
file also carries forward whatever your own `$HOME/.spiceinit` sets verbatim
(the host that surfaced #216 needs `set wnflag=1` there for gf180mcu model
binning; losing it silently would abort every deck). Generated decks
(`sim/.work/<slug>/<record-id>/<corner-id>.spice`) are unaffected — this is a
process-level override, not a deck-text change, so reproducing a failing
corner by hand still needs the same `.spiceinit` alongside it if your
`$HOME/.spiceinit` carries settings the deck depends on.

`sim/run_corners.py --check-env` reports whether this override is actually
taking effect on your host (`threads : OK ... num_threads=1`); a `WARN` there
— on a genuinely broken host, or if you're invoking ngspice by some other
path that bypasses `run_point()` — is the one-call diagnostic for a grid that
would otherwise silently blow through `--timeout` on every point.

**Subsets need a reason.** `sim/README.md` requires every record's *Corner
matrix run* field to be the full mandated matrix "unless the record states why
a subset was used". The runner enforces that: if the grid you asked for is
missing a mandated temperature, a mandated supply, or has fewer than three
process corners, it refuses to write a record unless you supply
`--subset-reason '<why>'` (which is copied verbatim into the record), or pass
`--no-write` because you are only debugging.

```bash
# debugging: runs, records nothing
python3 sim/run_corners.py smoke-bias --corners tt --temps 27 --supply-tol 0 --no-write

# a deliberate, justified subset: runs and records, with the reason on the record
python3 sim/run_corners.py smoke-bias --corners tt --temps 27 \
    --subset-reason "nominal-only mismatch sweep; distribution claim, see Statistical convention"
```

## Writing a testbench

Create `sim/<experiment-slug>/testbench/` with a manifest and a netlist
fragment. The slug is the experiment directory from `sim/README.md`: one per
distinct claim under test, kebab-case.

`tb.json`:

```json
{
  "name": "my-experiment",
  "description": "one line, shows up in --list and in the record",
  "claim": "spec/target-spec.md#temp-accuracy-untrimmed",
  "netlist": "my_tb.spice",
  "nominal_supply_v": 3.3,
  "supply_tolerance": 0.1,
  "temperatures_c": [-40, 27, 125],
  "corners": ["full"],
  "analyses": ["op"],
  "params": {"ibias": "5u"},
  "options": ["reltol=1e-5"],
  "measure": {"vptat": "v(vptat)", "iq_ua": "-i(vsup)*1e6"},
  "checks": {"iq_ua": {"max": 20.0}}
}
```

`claim` is the default for the record's **Claim** field — the ratified spec
line this experiment substantiates. `--claim` overrides it per run.

`netlist_provenance` (optional, default `"schematic"`) and
`netlist_provenance_note` (required, non-empty, when `netlist_provenance` is
`"extracted"`) set the record's **Netlist provenance** field and its caveat —
see `sim/README.md`'s "Netlist provenance" for the convention and what the
note must say. A post-layout re-run of an existing testbench (issues #86,
#84) lives in a sibling `<experiment-slug>/testbench-postlayout/` directory
rather than editing `testbench/` in place — a `POSTLAYOUT_FRAGMENTS` entry in
`sim/build_tb.py` builds its fragment from `layout/postlayout/<cell>.spice`
(sharing the schematic sibling's `testbench/stimulus.spice`), and
`sim/run_corners.py sim/<slug>/testbench-postlayout` (a testbench *directory*
argument, not the bare slug, since `--list`/`discover()` only walk
`testbench/`) runs it.

The netlist is a **fragment**, not a complete deck. It must not contain
`.include`, `.lib`, `.temp`, `.control`, `.endc` or `.end` — the harness owns
all of those, which is what lets one netlist sweep the whole grid unedited.
The loader rejects fragments that break this rule instead of silently pinning
every corner to 27 °C. The harness hands the fragment:

| Parameter | Value |
|---|---|
| `vdd_val` | supply for this PVT point |
| `vdd_nom` | nominal supply, for ratio measurements |
| `temp_c` | temperature for this PVT point (also applied via `.temp`) |

Each `measure` entry becomes `let m_<name> = <expr>` followed by `print` inside
the control block, so the expression must reduce to a **scalar**: fine for
`op`; for `tran`/`ac` reduce with `maximum()`, `mean()`, `v(out)[0]`, etc.
POR work is inherently transient (ramp, brownout dip, reset pulse width), so
expect `"analyses": ["tran 10u 5m"]` plus reducing measure expressions there.

`checks` are evaluated after the sweep:

| Key | Applies to | Meaning |
|---|---|---|
| `min` / `max` | every point | hard limit; failure names the offending corner-id |
| `max_spread_pct` | the grid | `(max−min)/\|mean\|` must stay under the limit |
| `min_spread_pct` | the grid | must *exceed* it — asserts the sweep really moved |

`min_spread_pct` is a harness-integrity check: if `.temp` or a `.lib` section
silently failed to apply, a strongly PVT-sensitive measurement would come back
flat, and this catches that instead of reporting a suspiciously perfect result.
For a temperature sensor that check is doing real work — a PTAT output that
does not move with temperature is broken, not perfect.

## What a run writes

One run mints one `<record-id>` (`<YYYYMMDD>-<HHMMSS>-<short-git-sha>`) and
writes, under `sim/<experiment-slug>/`:

| Path | Contents |
|---|---|
| `records/<record-id>.md` | the append-only summary record (the nine fields from `sim/README.md`, plus an Environment section with PDK / ngspice / harness / git provenance and the per-corner model sections) |
| `netlist-snapshots/<record-id>.spice` | verbatim frozen copy of the testbench fragment, with its sha256 |
| `corners/<record-id>/<corner-id>.log` | raw ngspice output, one file per PVT point |

Nothing is ever overwritten: the runner refuses to write over an existing
record or snapshot, and mints a later record-id if one is somehow already
taken. Corrections and re-runs get a new record-id and reference the prior one
with `--supersedes <record-id>`. Do not edit or delete anything under
`records/`, `netlist-snapshots/` or `corners/` — see the append-only rule in
`sim/README.md`.

**A run where every point failed writes nothing.** If not one point in the
grid produced a measurement — most often because `--timeout` was too short
for the deck's own transient span, so every point died from the same
environmental cause rather than from anything about the circuit — the runner
refuses to write `records/`, `netlist-snapshots/` or `corners/` at all,
including any `--supersedes` the run was asked to record, and exits `3`. That
mirrors the unjustified-subset gate above: a wall-clock timeout is a property
of the machine and the flags, not of the circuit, so it is closer to an
environment problem than to simulation evidence, and it must never be able to
supersede a passing record. `--no-write` (debugging) still runs and reports
normally; it just never had anything to refuse. A record with *some* passing
points and some failed/errored ones is unaffected by this — it still writes,
still reports `status: ERROR`, still exits `2`; only the total-failure case is
refused.

A run taken against a dirty working tree says so in the record's **Netlist
provenance** field and is not citable as a clean-tree result.

Exit codes: `0` pass · `1` a check failed · `2` a simulation failed or did not
converge (including a partial failure — some points ok, some not) · `3`
environment problem (no ngspice, no PDK, bad manifest, unjustified PVT
subset, or every point in the grid failed).

Generated decks land in `sim/.work/<experiment-slug>/<record-id>/` and are
git-ignored, so a failing corner can be reproduced by hand with
`ngspice -b sim/.work/<slug>/<record-id>/<corner-id>.spice`.

## Monte Carlo mismatch (`sim/run_mc.py`)

Everything above sweeps a **deterministic** PVT grid with mismatch off
(`sw_stat_mismatch=0`, the default `design.ngspice` ships). That answers *how
far does the systematic/corner term move the answer*. `spec/target-spec.md` §2
additionally ratifies a **[3σ]** basis for the accuracy and threshold rows —
*process plus local mismatch, Monte Carlo, N ≥ 500, evaluated at the row's
binding corner* — which is a different question and gets a different entry
point:

```bash
python3 sim/run_mc.py --list                    # MC experiments + their binding points
python3 sim/run_mc.py temp-accuracy-mc -j 12    # N per binding point, mint a record
python3 sim/run_mc.py por-threshold-mc --n 20 --no-write   # fast deck iteration
```

| | `run_corners.py` | `run_mc.py` |
|---|---|---|
| grid | process × temperature × supply (81 points, `full`) | binding point × sample (N ≥ 500 each) |
| process | swept, mismatch off | **held** at each row's own named binding corner |
| mismatch | off | **on** (`sw_stat_mismatch=1`) + per-sample `.option seed=` |
| verdict | per-corner pass/fail | per-(binding point, measurement) distribution: mean, σ, empirical yield, parametric mean ± 3σ vs the ratified limits |
| record | `report.py` | `mc_report.py` — same nine `sim/README.md` fields, distribution-shaped Result |

`sw_stat_global` stays at `design.ngspice`'s default `0` on purpose: global
die-to-die spread is exactly what the deterministic corner sweep already
covers, so randomizing it too would double-count the same variation. The two
records compose — the corner sweep owns the process/temperature/rail axis, the
MC record adds the local-mismatch axis on top of it, at the same binding
points.

A testbench opts in by adding an `mc` block to its `tb.json`; `run_corners.py`
ignores the key entirely.

```json
"mc": {
  "n": 500,
  "seed_base": 20260802,
  "derive": "temp_trim",
  "binding_points": [
    {"label": "vth-rise-max", "corner": "ss", "temp_c": -40, "vdd": 3.63}
  ]
}
```

- **`binding_points`** — named, not a grid. Each entry is one row's own "binds
  at" text from `spec/target-spec.md` §4, resolved against the same `CORNERS`
  table `corners.py` defines. A row whose min and max edges bind at different
  corners contributes two entries.
- **`n`** — samples per binding point. A **recorded** run enforces the N ≥ 500
  floor §2 ratifies; `--no-write` lifts it so a deck can be iterated on
  quickly (the same split `run_corners.py --no-write` / `--subset-reason`
  uses).
- **`seed_base`** — seeds are `seed_base + binding_index*100000 + sample`, so
  the sample set is a pure function of the manifest and re-running reproduces
  it exactly.
- **`derive`** *(optional)* — a hook in `montecarlo.DERIVE_HOOKS` that adds
  per-sample computed quantities to each sample's measurements before
  summarization (e.g. `temp_trim`, which renormalizes each die against *its
  own* 25 °C reading to model a one-point production trim).
- `analyses` lines additionally accept Python `%(temp_c)g` / `%(vdd)g`
  placeholders, substituted before the line reaches ngspice — needed because
  ngspice's own `{expr}` substitution is netlist-elaboration-time and does not
  reach into `.control` commands like `dc temp <lo> <hi> <step>`.

One MC sample is one ngspice invocation with its own seed and its own log
under `corners/<record-id>/<label>_<corner>_<temp>c_<vdd>v_s<NNNN>.log`, so a
2000-sample distribution is reproducible from the repository rather than
transcribed into a summary table.

## Batch backend (`--backend batch`)

Local `ngspice -b` stays the default. `klt_batch.py` adds an explicit, fail-closed
path that submits decks through `klt sim --backend batch` (the Spot batch fleet)
instead, for hosts that must not run SPICE grids themselves.

```bash
python3 sim/run_corners.py <testbench> --backend batch
python3 sim/por-brownout-slew/control/run_net_attribution.py --backend batch
python3 sim/por-output-chain-deglitch/control/run_dwell_sweep.py --backend batch
```

* Selection: `--backend local|batch|auto`. `auto` (the default) reads
  `$KLT_SIM_BACKEND` (`local` or `batch`; anything else is an error) and
  otherwise means local. Library calls (`runner.run_grid`, `run_deck`,
  `run_deck_raw`) are local unless called with `backend="batch"` and a
  `klt_batch.BatchConfig`, so importing the harness never changes a caller.
* Once batch is selected there is no local fallback: a missing `klt`, refused
  submission, invalid report, timeout, missing/duplicate/unrequested corner,
  non-`pass` corner, missing log or missing measurement is an `error` result
  (or an exception for `run_deck*`), never `ok`. A report without
  `environment.remote.job_id` is rejected as "not executed on the fleet".
* Runner/client skew: a report whose `environment.remote.runner_compatibility`
  is anything but `match` is rejected, and every later request in the same run
  is refused without being submitted, so a grid does not burn one fleet job
  per deck on a runner that cannot run it. `--klt EXE` selects the `klt`
  client used for submission (default `klt` on `PATH`); point it at a client
  that matches the fleet runner when they differ.
* An aborted analysis is never an absent measurement: a corner whose raw log
  carries ngspice's `simulation(s) aborted` trailer, or for which no requested
  measurement produced a value at all, is an `error` even where an absent
  measurement is otherwise tolerated (below).
* Raw logs: each returned ngspice log is copied byte-for-byte to the path the
  local run would have written (`corners/<record>/<corner>.log`,
  `control/logs/<deck>.log`) and parsed by the existing parsers.
* `klt sim` owns the `.control` block, `.lib`/`.temp` and the analysis, so a
  composed deck is taken apart by `klt_batch.translate_deck()`: the design
  include is inlined, `.lib` sections become a process bundle, `.temp` the
  temperature axis, the analysis and `.meas`/`let`/`print` become the request's
  analysis and measurements (a `let` vector used by a `meas` command is inlined
  as `par('...')`). Anything else in a `.control` block (`write`, `wrdata`,
  `alter`, ...), an include that does not resolve on the host, or a foreign
  `.lib` is rejected before submission.
* `klt sim` runs the analysis as a `.control` command, where ngspice does not
  expand `.param` braces (`tran 2e-06 {stop_s}` is a TSTOP of zero there). A
  `{name}` in the analysis line is therefore replaced with the deck's own
  plain-number `.param` text; an expression, an unknown name or a lifted
  per-corner parameter is rejected before submission.
* The control scripts treat an absent measurement as "never happened" (for
  example `t_trip`), so for `run_deck*` a corner whose only error diagnostics
  are `measurement`/`no_such_vector` stays `ok` with the value absent;
  `run_grid` is strict and requires every measurement.
* Scratch (staged body, `request.json`, klt artifacts) goes under
  `control/batch/` (git-ignored) or `<workdir>/batch/`; `run_grid` also copies
  `klt-*.request.json` / `klt-*.report.json` next to the record's logs.
* Each control deck is its own request (their measurement cards differ), so a
  60- or 324-deck control is that many fleet submissions, bounded by `--jobs`
  / the script's worker count; a fleet concurrency-cap refusal is retried with
  bounded jittered backoff.

Reuse `klt_batch.translate_deck()` / `run_units()` for other `run_deck*`
callers rather than re-implementing request staging.

Before a full grid goes to the fleet, submit one deck first (for example
`run_dwell_sweep.py --backend batch --smoke`) and compare it with the
committed local log of the same deck. A runner/client mismatch or a request
shape that does not translate then shows up after one job instead of 324.

## smoke-bias

`sim/smoke-bias/` is the harness acceptance test, not a circuit deliverable and
not a spec claim. Three independent branches, each proving a different part of
the plumbing and each using a device family this block genuinely depends on:

1. an ideal resistor divider — must read exactly 0.5·vdd at all 81 points,
   proving parameter substitution and measurement parsing (and standing in for
   the POR threshold tap, which is a divider off VDD);
2. a PDK `ppolyf_u` resistor into a diode-connected `nfet_03v3` — proves the
   MOS and resistor `.lib` sections load and actually change between corners;
3. a diode-connected vertical `pnp_10p00x10p00` at 10 µA — V_EB is strongly
   CTAT (~ −2 mV/°C), so it proves `.temp` and the BJT corner take effect. This
   is the same device the sensing core's CTAT leg is built from (DR-005).

Run it end to end with `bash sim/selftest.sh` (no evidence written) or
`bash sim/selftest.sh --record` (mints a record under
`sim/smoke-bias/records/`).

## xschem

`source sim/env.sh` exports `PDK_ROOT`, `PDK`, `GF180_PDK_PATH`,
`GF180_MODELS` and an `XSCHEM_USER_LIBRARY_PATH` covering `design/` and every
`sim/<experiment-slug>/testbench/`, so an interactive xschem or ngspice
session resolves exactly the PDK the corner runner picked:

```bash
source sim/env.sh
cd design && xschem
```

Schematic entry (#8) owns `design/xschemrc` and the netlist-export flow; this
harness does not require xschem at all. To simulate a schematic, strip its
export to a fragment (or netlist a testbench schematic without its
`.control`/`.end` block) and point a `tb.json` at it — the corner runner is
agnostic about whether the fragment was typed or generated.

### `sim/build_tb.py` — inlining an exported cell into a fragment

A fragment may not `.include` anything, so simulating a `design/` cell means
inlining its `.subckt` export into the fragment. Doing that by hand lets the
evidence trail drift silently away from the schematic, so it is generated
instead:

```bash
python3 sim/build_tb.py           # regenerate every experiment's fragment
python3 sim/build_tb.py --check   # fail if any committed fragment is stale
```

Each participating experiment keeps a hand-written
`testbench/stimulus.spice` (sources, loads, probes) and a **generated**
`testbench/<name>.spice` = stimulus + a verbatim copy of one or more
`design/netlist/<cell>.spice`, with each source's sha256 in the header. Add an
experiment by adding a row to `FRAGMENTS` in `sim/build_tb.py`.

`build_tb.py --check` needs neither xschem nor the PDK, so it runs in the
headless CI job; `design/netlist.py --check` (which does need both) closes the
other half of the chain by proving the export reproduces from the `.sch`.
