2AMLogic/gf180-temp-por/design/bias_core.md

# `bias_core` — shared bias / reference core

Sizing rationale, startup analysis and Iq apportionment for
`design/bias_core.sch` (issue #11). Topology per
[DR-005](../spec/decision-records/DR-005-temp-por-architecture-survey.md);
device choices per [`sim/devchar/SUMMARY.md`](../sim/devchar/SUMMARY.md)
(issue #4, PR #22); targets per
[`spec/target-spec.md`](../spec/target-spec.md), ratified via DR-008 on #1.
**This document does not change any ratified value.** Where a ratified row is
not met, it says so and names the owner of the re-cost, which is what
`target-spec.md` §5 asks this issue to do.

Every number below that is not a device dimension comes from a recorded
evidence run, not from an estimate:

| Evidence | What it substantiates |
| --- | --- |
| [`sim/bias-core-designer-check/`](../sim/bias-core-designer-check/) | settled `VREF`, `IBIAS`, always-on Iq against [`por-iq`](../spec/target-spec.md#por-iq), absence of a degenerate DC solution, reference settling and dropout, the rail at which the assembled block would release, and the starved-loop window on a fast ramp and after a brownout — 81-point PVT grid (9 corners × 3 temperatures × 3 supplies) |
| [`sim/bias-core-ibias-sharing/`](../sim/bias-core-ibias-sharing/) | the shared `IBIAS` net in the reset-asserted state, with a disabled `temp_core` and `por_comparator` wired exactly as `design/netlist/temp_por_top.spice` wires them, against a control without `temp_core` — same 81-point grid |
| [`sim/por-output-chain-ibias-sharing/`](../sim/por-output-chain-ibias-sharing/) | the **magnitude** half of the same net that the row above answers the liveness half of: all four cells spliced, a zero-volt ammeter on every `IBIAS` pin, so the current *split* between the consumer diodes is measured leg-by-leg in both `RESETn` states rather than inferred from the node's voltage — same 81-point grid, both netlist levels. Added by #221 / DR-024 |
| [`sim/temp-por-top-release/`](../sim/temp-por-top-release/) | this cell inside the **full four-cell assembly**: whether the shared node survives the reset-asserted state, whether `RESETn` releases and enables the sensor, and the assembled block's `por-iq` — same 81-point grid. Added by #41 / DR-010 |
| [`sim/bias-core-startup/`](../sim/bias-core-startup/) | branch-tracking, **quasi-static transient** rail ramp (not a per-point solve): whether a continuously rising rail leaves this cell on the correct branch and asserts `BIAS_OK` exactly once, whether the answer is ramp-rate independent, and whether all of it repeats after a full rail collapse — 81-point grid (27 distinct corner/temperature combinations, each at three bit-identical supply replicates by construction). Opened as a defect report by #43; **re-founded on a transient and closed by #46** — see [Resolved](#resolved-the-bias_ok-quasi-static-failure-was-a-testbench-artefact-issues-43-46) |

All are **deterministic corner** records: `design.ngspice` sets
`sw_stat_mismatch=0`, so everything below bounds the **systematic + corner**
term only. Local mismatch on the 8:1 PNP ratio, the `R2/R1` ratio and the
amplifier's input pair is issue #15's Monte Carlo job. Full
ramp-rate/brownout envelope against a real assembled block is #14's.

**Two of the recorded checks fail on purpose, and a third — reported by issue
#43 — turned out not to be a circuit defect at all:**

1. [`por-iq`](../spec/target-spec.md#por-iq) **was < 1 µA and not met; it is
   now re-costed to < 3.0 µA and met** — see
   [Iq apportionment](#iq-apportionment) and
   [DR-018](../spec/decision-records/DR-018-por-iq-recost.md).
2. A **starved-loop window** exists at the ratified fast end of
   [`por-ramp-rate`](../spec/target-spec.md#por-ramp-rate) and after a
   brownout, during which `BIAS_OK` can read a false valid — see
   [The starved-loop window](#the-starved-loop-window).
3. ~~**`BIAS_OK` fails to assert, or asserts non-monotonically, at every one
   of the 27 corner/temperature combinations on a quasi-static (branch-
   tracking) rising rail.**~~ **Not a defect in this cell.** Root-caused by
   #46 to the reporting testbench's own `gmin = 1 nS` convergence aid, which
   injected **0.563 nA** of *differential* error into a settle comparator
   whose whole signal is **0.247 nA** (measured by the committed control
   experiment, `sim/bias-core-startup/control/`). Re-measured on a
   quasi-static **transient** ramp at
   ngspice's default `gmin`, the cell asserts `BIAS_OK` exactly once, before
   the ratified release threshold, at **all 81 points** — and does the same
   after a full rail collapse. See
   [Resolved](#resolved-the-bias_ok-quasi-static-failure-was-a-testbench-artefact-issues-43-46).
   **No schematic change was made, and none is warranted on this evidence.**

Plus one integration defect that no single-cell testbench could see, which
this issue surfaced and **#41 has since fixed**:

4. ~~The **shared `IBIAS` net is clamped to `VSS` in the reset-asserted
   state**, which is a closed bias-vs-POR lockup at the top level.~~
   **Resolved** by
   [DR-010](../spec/decision-records/DR-010-shared-ibias-disabled-consumer-contract.md):
   a disabled consumer of the shared node must present high impedance to it,
   so `temp_core`'s `XMDIB` clamp is gone. The shared node now sits at
   0.568–0.861 V in the reset-asserted state (was 1.0–6.6 mV) and the
   assembled block releases `RESETn` at every one of the 81 points — see
   [The shared IBIAS net](#the-shared-ibias-net-–-resolved-by-dr-010). The
   two checks in `sim/bias-core-ibias-sharing/` that were written as the
   requirement and had been failing now pass on their own, exactly as that
   testbench's `tb.json` predicted they would.

## What this cell is and is not

- It is the **always-on** bias/reference core: no enable pin, no off state,
  live from the first millivolt of rail. Everything it draws is therefore
  charged to `por-iq` by `target-spec.md` §5 rule 1, with no apportionment
  argument available or needed.
- It owns **its own startup kick** (DR-005 step 3). The separate below-floor
  `RESETn` pull-down is `por_output_chain`'s (#12, DR-004).
- It owns **`BIAS_OK`** (DR-005 step 4) — the flag that stops
  `por_comparator`'s threshold decision from becoming authoritative before
  the reference is valid. It does **not** own the full startup-ordering AND
  with the pulse timer, which is #12's.

## Interface

Unchanged from the ports-only placeholder committed in PR #29; this issue
replaced the internals only, so `design/bias_core.sym` is untouched.

| Pin | Dir | Meaning |
| --- | --- | --- |
| `VDD`, `VSS` | inout | 3.3 V core-flavour supply pair (DR-001) |
| `IBIAS` | out | shared bias-mirror node. Convention set by #9/#10 and honoured here: `bias_core` **sources 0.5 µA** (nominal, tt/27 °C/3.30 V) **into** the pin. Current output; compliance `V(IBIAS) ≤ VDD − 0.2 V`. |
| `VREF` | out | absolute reference, **1.20 V nominal** — the value `design/por_comparator.md` sized its divider ratio against, so that sizing stands with no re-ratio. |
| `BIAS_OK` | out | "shared core is up and settled", **active high**, rail-to-rail. |

## Topology

```
              VDD ──┬─────┬─────┬──────────────────────────── VDD
                  ┌─┴─┐ ┌─┴─┐ ┌─┴─┐                8u/4u pfet, 100 nA each
             PG ──┤MP1├─┤MP2├─┤MP3├── PG            (+ MPBN, 1/4 scale)
                  └─┬─┘ └─┬─┘ └─┬─┘
                    NA  NBTOP  VREF ──────────────► VREF pad
                    │     │     │
                    │    RT    R2 = 6.30 M
                    │     │     │
                    │     NB   ER
                    │     │     │
                    │    R1    QR                   pnp_10p00x10p00, 1x
                    │     │     │
                   Q1    EC    VSS
                  (1x)   │
                    │  Q8A..Q8H  (8x)
                   VSS   VSS

     NA, NB ──► error amplifier ──► PG        forces V(NA) = V(NB)
     NA, NBTOP ──► settle comparator ──► BIAS_OK
     PB (secondary bias rail) ──► IBIAS output leg, all amplifier tails
```

The amplifier forces `V(NA) = V(NB)`, so the voltage across `R1` is exactly
the emitter-area-ratio ΔV_EB and the branch current is

```
I     = ΔV_EB / R1 = (kT/q)·ln(8) / R1                     (PTAT)
VREF  = V_EB(XQR) + (R2/R1)·ΔV_EB                          (first-order flat)
IBIAS = 20 · (I/4)                                          (via PB)
```

Three properties fall out of writing it this way, and all three are
load-bearing:

- **`VREF` depends on `R2/R1`, not on R.** The absolute value and the
  temperature coefficient of the poly resistor cancel in a same-flavour
  ratio (`sim/devchar/SUMMARY.md` establishes this at the model level). The
  `res_ff`/`res_ss` corners move `R1` by ±25 % and move `VREF` by 0.6 %.
- **The amplifier's inputs are PNP-clamped.** `NA` is a V_EB and `NB` is a
  V_EB plus ΔV_EB, so neither can rail no matter how far the mirror
  over-drives. An earlier revision of this cell used a Kuijk arrangement
  with the amplifier sensing the tops of two large resistors instead; over-
  driving the mirror pushed both inputs to `VDD`, the input pair went into
  triode, the differential signal vanished and the loop sat in a stable
  high-current state at 17–90 µA. Measured on the same grid, not
  hypothetical. The three-leg arrangement here cannot reach that state,
  which is why it was chosen over the two-leg one despite costing an extra
  100 nA branch.
- **The reference leg is separate from the loop.** `XMP3`/`R2`/`XQR` is a
  matched third leg, so `VREF` railing (which it does transiently on a fast
  ramp) cannot destabilise the loop.

## Device sizing and why

### Vertical PNPs — `pnp_10p00x10p00`, 8:1, ~100 nA/branch

Unit cell and ratio come straight from `sim/devchar/SUMMARY.md`
("Recommendation: sensing core"): `pnp_10p00x10p00` in an **8:1
emitter-area pair**, built as **eight unit-cell instances wired in
parallel** (`XQ8A..XQ8H`), not one instance with `par=8` — that parameter
scales only the model's mismatch term, not `Is`. `XQR` is a ninth,
identical device carrying the same current, so its V_EB matches `XQ1`'s by
construction in a deterministic corner.

**Deviation from DR-005's bias-point estimate, stated explicitly.** DR-005
estimates 1–5 µA/branch for the shared core. This cell runs **~100 nA/branch**
at tt/27 °C — 10–50× below that estimate — because the estimate predates
[`por-iq`](../spec/target-spec.md#por-iq)'s original <1 µA row being written
down. Even at 100 nA/branch the row was not met against that original budget
(see below; it is met against the current, DR-018-recosted <3.0 µA budget),
so 1 µA/branch was never a candidate. The property the 8:1 recommendation rests on still holds
at 100 nA: measured ΔV_EB is **41.86 / 53.90 / 71.50 mV** at −40/27/125 °C
against **41.75 / 53.79 / 71.30 mV** of theory — a **0.20–0.29 % error**,
comparable with the 0.33 % `sim/devchar` measured at 10 µA.

### Resistors — `ppolyf_u_3k`, W = 2 µm

| Device | Drawn L | Squares | R at tt/27 °C | Sets |
| --- | ---: | ---: | ---: | --- |
| `R1` | 350.0 µm | 175.0 | 537.6 kΩ | `I = ΔV_EB/R1` = 100 nA |
| `R2` | 4104.0 µm | 2052.0 | 6.304 MΩ | `R2/R1` = 11.726 → the PTAT term that flattens `VREF` |
| `RT` | 17.5 µm | 8.75 | 26.9 kΩ | `RT/R1` = 0.05 → the settle-detect offset |
| `RZ` | 1016.0 µm | 508.0 | 1.561 MΩ | Miller nulling resistor, ≈ 1/gm(`XMS2N`) |

`ppolyf_u_3k` rather than `temp_core`'s `ppolyf_u`: at ~3 kΩ/□ it is the
highest-sheet flavour `sim/devchar` measured, and a `ppolyf_u` `R2` would
need 8.5× the area for the same value. `VREF` only depends on the **ratio**
`R2/R1`, and `SUMMARY.md` shows the body-resistor temperature factor is a
multiplicative function of flavour alone, so the −1545 ppm/°C TC and the
±25 % sheet corner cancel in the ratio exactly as they do for
`por_comparator`'s divider. What does *not* cancel is the effect on the
absolute current — see [Iq apportionment](#iq-apportionment).

`RT` is the only unusual one. It is a 5 % tap on `R1`, placed between
`XMP2`'s drain (`NBTOP`) and `NB`, so that

```
V(NBTOP) − V(NA) = I·(R1 + RT) − ΔV_EB
```

which is **negative until the loop current reaches `R1/(R1+RT)` = 95.2 % of
its settled value** and is `+I·RT` — a PVT-stable, PTAT **2.1 / 2.7 / 3.6 mV**
at −40/27/125 °C — once settled. That is the settle detector's input, and it
is a ratio of same-flavour resistors times ΔV_EB, so it carries no corner
spread of its own. Its cost to the mirror is a 2.1–3.6 mV V_DS mismatch
between `XMP1` and `XMP2`, i.e. under 0.03 % of ratio on a 4 µm-long device.

### Mirror and the secondary bias rail `PB`

| Device | W/L | Role |
| --- | --- | --- |
| `MP1`, `MP2`, `MP3` | 8 µm / 4 µm | the three matched core legs, ~100 nA each |
| `MPBN` | 2 µm / 4 µm | 1/4-scale leg that generates `NBG` → `PB` |
| `MBN`, `MBN2` | 2 µm / 4 µm | `NBG` diode and its mirror into `XMBP` |
| `MBP` | 2 µm / 4 µm | diode-connected pfet defining `PB` |
| `MPIB` | 40 µm / 4 µm | `IBIAS` output leg, 20:1 against `XMBP` → 0.5 µA |

**Only the four core legs hang off `PG`.** Every other current source in the
cell is gated from `PB` instead. That is a compensation decision, not a
stylistic one: `PG` is the amplifier's output node, and `XMPIB`'s gate alone
is 160 µm² of poly. With `XMPIB`, the amplifier tail, the second-stage load
and the settle-comparator tail all on `PG`, the loop's second pole sat about
a decade **below** its unity-gain frequency and the loop **oscillated** —
measured, as a 180 µs-period relaxation with `VREF` swinging 0.46…2.5 V at
every corner. Moving the wide-gate sources to `PB` (a low-impedance diode
node that is not in the loop) cut `C(PG)` by ~4× and the same loop settles
monotonically at all 81 points.

### Error amplifier

PMOS input pair, NMOS mirror load, NMOS common-source second stage,
Miller-compensated with a nulling resistor — the same structure as
`design/temp_core.sch`'s amplifier.

| Device | W/L | Role |
| --- | --- | --- |
| `MPT` | 2 µm / 4 µm | tail from `PB`, ~26 nA |
| `MI1`, `MI2` | 16 µm / 4 µm | input pair, gates on `NA`, `NB` |
| `ML1`, `ML2` | 4 µm / 8 µm | NMOS mirror load |
| `MS2N` | 8 µm / 8 µm | second stage, gate `N2` |
| `MS2P` | 2 µm / 4 µm | second-stage load from `PB` |
| `CC` + `RZ` | 20 × 20 µm MIM (0.8 pF) + 1.56 MΩ | Miller compensation with nulling zero |

A PMOS input pair is required, not preferred: the inputs sit at a V_EB,
which falls to **0.36 V at 125 °C** (measured), far below an NMOS pair's
usable common-mode floor. `XMS2N` is a current-density copy of `XML1`, so
stage 1's output sits at the diode node's own V_GS and the *systematic*
input offset is structurally near zero — measured `|V(NA) − V(NB)| ≤ 1 µV`
in the settled state at every corner.

`RZ` ≈ 1/gm(`XMS2N`) moves the right-half-plane zero out of the way; without
it that zero sits about 2× above the unity-gain frequency and costs ~26° of
phase.

## Startup

A ΔV_EB loop has a degenerate zero-current solution as well as its intended
one. Two independent pieces of evidence say this cell does not sit in it:

- **`vref_op_v`** samples `VREF` in the operating point ngspice solves
  *before* the transient starts, with the static branch already at full
  rail — the same analysis that caught #9's first revision sitting in its
  dead state. Measured **1.18759…1.21024 V at all 81 points**, i.e. bit-identical
  to the settled value: the solver finds the intended solution from cold,
  before the kick has done anything.
- **`bo_shallow_ppm` / `bo_deep_ppm`** compare `VREF` before and after a dip
  to 0.5 V (rail below dropout, nodes still charged — the classic latch
  trap) and after a full collapse to 0 V. Measured **0…13 ppm at 79 of 81
  points**; the two exceptions are recovery-time artefacts, not latches (see
  [The starved-loop window](#the-starved-loop-window)).

  **Both of those checks sample after a recovery, so they can only report a
  latch once the recovery has finished, and issue #185 is what happens when
  it has not.** On the *extracted* netlist the recovery is up to an order of
  magnitude slower, and a fixed wall-clock sample taken mid-recovery reads
  −5·10⁵ ppm — which looks exactly like the latch this bullet is here to rule
  out, and is not one. The deck now samples at 29.9 ms, and the one corner it
  still does not clear was taken out to 120 ms in
  [`control/results.md`](../sim/bias-core-designer-check/control/results.md):
  the reference comes back to **0.000 ppm** of its pre-event value there too.
  The no-latch statement therefore stands under real parasitics — it just
  needs a longer look. See
  [The post-layout brownout regression](#the-post-layout-brownout-regression--it-was-the-deck-issue-185).

The kick itself is a **current-referenced dead-loop detector**, the same
principle `design/temp_core.md` arrived at:

| Device | Size | Role |
| --- | --- | --- |
| `KS0..KS4` | nfet 1 µm / 8 µm ×5, diode-connected | five-deep stack from `VDD`: a rail-referenced pull-up on `NKG`, deliberately deep in subthreshold |
| `KA` | pfet 1 µm / 4 µm, gate `PB` | replica that delivers current only while the loop is biased |
| `KAN` / `KPD` | nfet 2 µm / 4 µm, nfet 8 µm / 4 µm | mirror it into a 4× pull-down on `NKG` |
| `KICK` | nfet 1 µm / 4 µm, gate `NKG` | the kick: pulls the mirror gate `PG` down |

Loop alive: `KPD` beats the stack, `NKG` ≈ 0, `KICK` idle. Loop dead: `PB`
collapses to `VDD`, `KA` delivers nothing, the stack pulls `NKG` up and
`KICK` pulls `PG` down until the loop restarts. The stack is sized so its
current — the only *static* cost of the whole startup block — is **≤ 17.5 nA
at ff/125 °C/3.63 V** and never zero at any corner.

**The comparison is loop current versus a rail-referenced current, not a
voltage level on `VREF`.** An earlier revision gated the detector on
`V(VREF) > Vt` and left the core parked near zero current for ~200 µs after a
deep brownout at `fs`/−40 °C, because 0.7 V of a not-yet-settled `VREF`
already looks like "alive" to an nfet gate — and `BIAS_OK` stayed stale-high
throughout. Measured, then fixed, then re-measured.

`XMOKC` closes the same hole on the `BIAS_OK` side: it forces the settle
comparator's output low whenever `NKG` says the loop is dead. Without it a
collapsed core leaves that output stale — there is no tail current to move
it — and `BIAS_OK` reads a false valid for as long as the restart takes.

## `BIAS_OK`

The settle detector is a PMOS pair comparing `NBTOP` against `NA` (i.e. the
`RT` tap described above), an NMOS-loaded gain stage, and a deliberately
skewed output inverter.

**It is one-sided on purpose.** It asserts when the loop current is **above**
95.2 % of target and says nothing about the current being too high. That is
the correct asymmetry:

- A reference that is **low** lowers `por_comparator`'s threshold
  (`VPOR↑ = 2.16667·VREF`) and releases reset **early**, below the ratified
  [`por-vth-rise`](../spec/target-spec.md#por-vth-rise) minimum. This is the
  failure mode, and it is what the detector catches.
- A reference that is **high** raises the threshold and **delays** release,
  which [`por-reset-pulse`](../spec/target-spec.md#por-reset-pulse)
  explicitly does not bound ("no maximum specified in wave 1").

On a rising ramp the amplifier lags in the direction that over-drives the
loop, so the error is on the safe side — and the record measures that rather
than asserting it.

### The release guard

Timing `BIAS_OK` against `VREF` in isolation is the wrong question, because
`BIAS_OK` going valid while `VREF` is still **rail-limited** is harmless: a
rail-limited `VREF` makes `2.16667·VREF` larger than `VDD` by construction.
The record therefore measures the thing that matters — the rail at which
(`BIAS_OK` is a valid high) **and** (`VDD ≥ 2.16667·VREF`) first hold
together, i.e. the `VDD` at which the assembled block would actually release:

| | Measured over the 81-point grid | Bound |
| --- | --- | --- |
| `relv_slow_v` (500 µs ramp) | **2.800…3.117 V** | ≥ 2.47 V ✅ |
| `relv_fast_v` (1.0 V/µs ramp) | **= VDD at every point** (2.97/3.30/3.63 V) | ≥ 2.47 V ✅ |
| `okf_at_1v_mv` (`BIAS_OK` at VDD = 1.0 V, fast ramp) | **−0.088…+0.107 mV** | ≤ 300 mV ✅ |

The `relv_slow_v` numbers sit **above** the ratified 2.60 V typ, by
93…239 mV (`err_at_relv_mv`). That is not a threshold error: it is the
reference reading high while the rail is still slewing, and it is a *late*
release. Its coefficient is worth stating because #14 needs it —

> **Ramp-rate feedthrough.** The mirror gate `PG` has to track `VDD`, so the
> Miller capacitor injects `Cc·dVDD/dt` into the amplifier's stage-1 output,
> which the loop can only absorb as an input-referred offset of
> `(Cc/gm1)·dVDD/dt`.
>
> **Measured directly on `bias_core` alone — not inferred from a downstream
> threshold — across the full 81-point PVT grid, on both ramp directions**
> ([issue #208](https://github.com/2AMLogic/gf180-temp-por/issues/208),
> [`control/ramp_feedthrough_results.md`](../sim/bias-core-designer-check/control/ramp_feedthrough_results.md)).
> This supersedes the single **≈ 2.4 µs** figure this note previously quoted,
> which undershoots the measured coefficient at **every** corner in the
> grid — not only at the `ss`/-40 °C corner issue #208 was filed from:
>
> | | Up-ramp (`VREF` high) | Down-ramp (`VREF` low) |
> | --- | --- | --- |
> | Schematic | **17.31…47.45 µs** | **17.54…51.08 µs** |
> | Extracted | **17.31…47.40 µs** | **17.59…51.27 µs** |
>
> The coefficient's **sign reverses with ramp direction** — toward more loop
> current (`VREF` high) on a rising rail, toward less (`VREF` low) on a
> falling one — rather than "always toward more loop current", which this
> note previously stated on the strength of a rising-ramp-only measurement.
> The worst corner in both directions is `ss`/-40 °C, which independently
> reproduces [`sim/por-vth/control/results.md`](../sim/por-vth/control/results.md)'s
> own **~49 µs** figure (measured indirectly, through the full four-cell
> assembly, issue #187/#218/[DR-021](../spec/decision-records/DR-021-por-hysteresis-quasi-static-scope.md))
> to within ~1 µs on both netlists — two independent methodologies agreeing
> at the one point they share. `ff`/125 °C is the best corner in both
> directions, at roughly a third of `ss`/-40 °C's magnitude: the coefficient
> tracks the reference's own node impedances, which rise at cold/slow
> corners for the same reason a nA-scale bias network's settling time does.

`BIAS_OK` itself asserts at `t_ok_us` = **193…307 µs** into the 500 µs ramp,
with the reference then **45…407 mV** from its settled value
(`err_at_ok_mv`) — almost all of that being the feedthrough term above.
`ok_droop_mv` ≤ 0.016 mV: the flag is a hard rail-to-rail logic level for
`por_comparator`'s inverter, never a partially resolved analog one.

### Settling and dropout

| Property | Measured | Note |
| --- | --- | --- |
| Settling after the rail stops moving (`t_settle_us`) | **10.9…33.4 µs** | to within 0.1 % of the settled value |
| Core minimum operating voltage (`vdd_ref90_v`) | **1.127…1.788 V** | rail at which `VREF` first reaches 90 % of settled |
| Brownout recovery (`t_bo_recover_us`) | **0…655 µs** | rail return → `BIAS_OK` valid again, after a full collapse |

The dropout number is the important one for block self-consistency: at
≤ 1.79 V it sits comfortably below
[`por-vth-fall`](../spec/target-spec.md#por-vth-fall)'s 2.22 V minimum, so on
a falling rail the assert edge is set by `por_comparator`'s divider, not by
the reference collapsing underneath it.

## Resolved: the `BIAS_OK` quasi-static failure was a testbench artefact (issues #43, #46)

**Issue #43 reported, and record `20260801-111049-bc599be` measured, that
`BIAS_OK` fails to assert or asserts non-monotonically at every one of the 27
corner/temperature combinations on a quasi-static rising rail. Issue #46
root-caused that result to the reporting deck's own convergence aid. The cell
is not defective; the deck was. No change was made to
`design/bias_core.sch`.**

This section replaces the "Open defect" write-up PR #47 put here. The
superseded finding is not deleted — its record, its raw per-corner logs and
its netlist snapshot all remain under `sim/bias-core-startup/`, because
`sim/` is append-only. What changed is the *interpretation*, and the
interpretation is now backed by a controlled experiment rather than by
inference.

### The root cause, in one paragraph

The superseded deck swept the rail with `.dc` and could only be made to
converge by raising `gmin` from ngspice's default `1e-12` to `1e-9`. `GMIN`
is a conductance the simulator places across **every device junction** to
keep the Jacobian non-singular. At 1 nS and 3.3 V of rail that is **~2.7 nA
per junction**. The settle comparator this experiment exists to test runs its
input pair at **4.728 and 4.481 nA**, and the whole signal it resolves is the
**0.247 nA** difference between them — a fraction of one junction's worth of
aid. Worse, the aid is not common-mode: the comparator's output node `NOKO`
carries one junction its reference-side counterpart `NOKL` does not
(`XMOKC`'s drain, the dead-loop detector's forced-low path), so **0.563 nA**
of the injected current appears as a pure **differential** error, of the sign
that opposes assertion — more than twice the signal. The deck was measuring
its own crutch.

### The controlled experiment

One variable, one deck, `tt` / −40 °C / `VDD` = 3.3 V, plain `op` on
`design/netlist/bias_core.spice` with the same `IBIAS` consumer-diode load
the testbenches use. The only difference between the two columns is the
`.options gmin` line.

**The experiment is committed and re-runnable** —
`sim/bias-core-startup/control/`: the stimulus fragment, the script that
composes and runs both variants in one process, the two exact decks as run,
both raw ngspice logs, and
[`control/results.md`](../sim/bias-core-startup/control/results.md), which is
generated from those logs. Every number in this section is transcribed from
`results.md` and from nowhere else; re-run it with

```
python3 sim/bias-core-startup/control/run_gmin_control.py
```

It is a *diagnosis*, not a recorded result — one PVT point cannot substantiate
a spec row — so it deliberately does not mint a record; see `sim/README.md`,
"Control experiments". The corner-grid evidence is the 81-point record below.

| | ngspice default (`gmin = 1e-12`) | the superseded deck (`gmin = 1e-9`) |
| --- | ---: | ---: |
| `V(NOKO)` — settle comparator output | **1.643 V** (resolved high) | **0.605 V** (unresolved) |
| `V(NOKL)` — its diode-load reference | 0.602 V | 0.626 V |
| `V(NOKX)` — threshold-stage output | 94 µV | 3.256 V |
| **`BIAS_OK`** | **3.29999985 V — asserted** | **1.54 µV — not asserted** |
| `VREF` | 1.1978 V | 1.2121 V (+1.2 %) |
| `I(XMOKA)` (gate `NA`) | 4.728 nA | 7.799 nA |
| `I(XMOKB)` (gate `NBTOP`) | 4.481 nA | 7.247 nA |
| `I(XMOL1)` (diode load, mirrors `XMOKB`) | 4.483 nA | 9.295 nA |
| `I(XMOL2)` (mirror output, loads `XMOKA`) | 4.727 nA | 9.284 nA |

Read the last four rows as KCL and the artefact is explicit. At the default
`gmin` the loads carry what the input pair delivers, to three digits
(4.483 vs 4.481 nA; 4.727 vs 4.728 nA) — the comparator sees only its own
signal, **`I(XMOKA) − I(XMOKB)` = +0.247 nA**, and `NOKO` resolves high. At
`gmin = 1e-9` the loads carry **2.048 nA and 1.485 nA more** than the pair
delivers; the **0.563 nA** difference between those two excesses is the
unbalanced part, and it is `XMOKC`'s drain junction hanging on `NOKO` with no
counterpart on `NOKL` (`V(NOKO)` × 1 nS = 0.605 nA of `gmin` current at that
one junction). That 0.563 nA exceeds even the 0.552 nA the pair delivers *at
the perturbed operating point*, and it is more than twice the 0.247 nA of
real signal at the true one, so the comparator lands on the wrong side.

Those last two figures are the number this document previously reported two
ways, and they are two different quantities: **0.247 nA is the signal** — what
the pair produces in the circuit as it actually operates — while 0.552 nA is
what the pair produces in the deck the aid has already displaced, and is not
a property of the circuit at all. The claim "the aid is larger than the
signal" holds on either, by 2.3× on the one that matters.

`VREF` moving 1.2 % between the two columns is the same effect on the main
loop, and it is why the superseded record's "`VREF` settles correctly at
every point that could be measured" was true only approximately.

### Why the `.dc` sweep could not simply be re-run without the aid

It does not converge. At `gmin = 1e-12` the `.dc` continuation hits the
harness's 300 s per-point timeout at **all 27** corner/temperature
combinations. A DC continuation is the wrong tool for a circuit whose
operating point below ~1 V of rail has the startup stack and all three main
legs near cutoff simultaneously. The experiment therefore had to change
method, not just options.

### What replaces it

`sim/bias-core-startup/` is now a **quasi-static transient rail ramp** at
ngspice's default `gmin` — the same "slow ramp, not a DC sweep" argument
`sim/por-output-chain-floor/` already makes in this repo — with three DUTs in
one `tran`:

| DUT | Rail | Purpose |
| --- | --- | --- |
| `xqs` | 0 → 3.63 V over 30 ms (**121 V/s**) | the primary quasi-static cold start; every branch-tracking, ordering and release-rail measurement |
| `xqf` | the same, 4× faster (**484 V/s**) | measures ramp-rate independence, i.e. proves the primary result really is in the quasi-static limit |
| `xbo` | the `xqs` ramp, then a **full collapse to 0 V**, 3 ms of dead rail, then the same quasi-static ramp again | the brownout-restart branch #43's acceptance criteria asked for and #46 inherited |

Both rates sit 3–4 decades below the **0.36 V/µs** boundary at which this
document's own [starved-loop window](#the-starved-loop-window) measures the
loop starting to lag, and inside the ratified
[`por-ramp-rate`](../spec/target-spec.md#por-ramp-rate) envelope — whose full
sweep remains #14's chartered row and is deliberately not pre-empted here.

### The result: 81 of 81 points pass

Record `20260801-230642-c320628` (`sim/bias-core-startup/records/`), full
81-point grid, **status PASS, every check green at every point**. This
record **supersedes** the original 27/27-FAIL record
`20260801-111049-bc599be` via `--supersedes`, closing issue #50's evidence-
hygiene gap: the record that first reported this 81/81 PASS result,
`20260801-144500-ab081eb`, carried `Supersedes: (none)`, so a reader landing
on `bc599be` had no pointer in `sim/` to the record that corrects it. Every
measurement in the table below is bit-identical between `ab081eb` and
`c320628` — the re-run changes only the record's evidence-chain metadata, not
the circuit result:

| | Measured over the 81-point grid | Bound |
| --- | --- | --- |
| `ok_chatter_mv` — rail between the first and last upward crossing of `BIAS_OK` | **0 at all 81 points** | ≤ 1.0 mV ✅ |
| `v_bias_ok_v` — rail at which `BIAS_OK` asserts | **1.000…1.581 V** | ≤ 2.45 V ✅ |
| `release_margin_v` — how far below the ratified 2.47 V minimum it asserts | **0.889…1.470 V** | ≥ 0.02 V ✅ |
| `relv_qs_v` — rail at which the assembled block would actually release | **2.583…2.629 V** | ≥ 2.47 V ✅ |
| `vref_at_ok_pct` — `VREF` at the instant the flag asserts, vs. its settled value | **78.6…107.0 %** | ≥ 70 % ✅ |
| `vref_final_v` | **1.1876…1.2090 V** | 1.14…1.26 V ✅ |
| `noko_final_v` — the settle comparator's own resolved output level | **1.376…1.817 V** | ≥ 1.0 V ✅ |
| `nkg_final_v` — startup kick idle at the top of the ramp | **≤ 5.5 mV** | ≤ 0.5 V ✅ |
| `qs_rate_delta_mv` — assertion rail, 484 V/s minus 121 V/s | **0.001…131.7 mV** | ±250 mV ✅ |
| `v_core_up_v` — rail at which `VREF` first reaches 1.10 V | **1.145…1.569 V** | ≤ 1.9 V ✅ |

Two of those rows say more than their tick does.

**`relv_qs_v` is stronger than "above the minimum".** At 2.583–2.629 V it
sits inside the *full* ratified
[`por-vth-rise`](../spec/target-spec.md#por-vth-rise) window — 2.47 / **2.60**
/ 2.73 V — and within 30 mV of its **typical**, at every one of the 81 points.
The check only asks that the assembled block not release below the 2.47 V
minimum; what the grid actually shows is a release rail landing on the
ratified target, not merely on the legal side of its edge.

**`vref_at_ok_pct` is bounded as of issue #50**, having been recorded
unbounded in the #46 revision (`ab081eb`) and checked against the bound for
the first time in the `--supersedes` re-run cited above (`c320628`) — the
78.6…107.0 % row clears the new floor by 8.6 points. It needs a bound of its
own because
`relv_qs_v` is a *conjunction*: at the 9 hot combinations `BIAS_OK` reads a
valid high from about 1.0 V of rail, so the `v(bias_okq) > 0.5·v(vddq)` term
in `Brelq` is satisfied from the bottom of the ramp and `relv_qs_v` is set
**entirely** by the `VDD ≥ 2.16667·VREF` term. That is harmless — a
rail-limited `VREF` makes `2.16667·VREF` exceed `VDD` by construction, which
is the argument [The release guard](#the-release-guard) makes — but at those
points `relv_qs_v` carries no information about whether the *flag* is early,
and `vref_at_ok_pct` was then the only evidence on that question: recorded,
argued, untested. The bound is a floor on "the reference is substantially
there when the flag goes true", set 8.6 points below the worst measured point
(78.6 % at `res_ff`/125 °C). It is not spec-derived — no ratified row is
involved, and `relv_qs_v` remains the pass/fail that carries `por-vth-rise`.

and, on the brownout-restart branch:

| | Measured over the 81-point grid | Bound |
| --- | --- | --- |
| `ok_bo_dip_mv` — `BIAS_OK` with the rail collapsed to 0 V | **−61.2…+33.6 mV** | ±300 mV ✅ |
| `v_bias_ok_restart_v` — rail at which it re-asserts on the restart ramp | **1.000…2.338 V** | ≤ 2.45 V ✅ |
| `ok_bo_end_droop_mv` — `VDD` − `BIAS_OK` after the restart | **≤ 0.015 mV** | ≤ 1.0 mV ✅ |
| `vref_bo_end_delta_ppm` — `VREF` after the restart vs. after the cold start | **−0.83…+0.83 ppm** | ±1000 ppm ✅ |

That last row is the strongest single statement in the record. Two
quasi-static approaches to the same rail — one from a cold cell, one from a
cell that has been up, fully collapsed and restarted — land on the same
reference to **better than one part per million**. A second reachable
operating branch cannot survive that. What it does *not* say is that the
restart began from a completely discharged cell: `vref_bo_dip_v` measures
`VREF` still at **0.518 V** two-thirds of the way through the 3 ms dead-rail
window at `ss`/−40 °C, so the restart is a genuine repeat, not a proof that no
second branch exists. That stronger statement is
`sim/bias-core-designer-check/`'s `vref_op_v`, which *seeds* the DC solve in
the degenerate zero-current state at all 81 points.

#### The one tight number

`v_bias_ok_restart_v` = **2.338 V at `ss`/−40 °C** leaves **112 mV** to its
2.45 V bound. That is the tightest rail margin in the record — its only peer
is `relv_qs_v`'s 113 mV above the ratified 2.47 V floor (2.583 V at
`bjt_ff`/125 °C), and the same flag on the *cold* start clears the *same*
2.45 V bound by 869 mV. The restart therefore asserts roughly **750 mV
later** than the cold start at that corner. It passes, and
the mechanism is understood — `ss`/−40 °C is the slowest corner, and after a
collapse the cell restarts from a partly-discharged state with the same
nA-class currents having to re-charge `PG` and the settle comparator's nodes —
but it is the number to watch. Anything that slows the restart further (a
larger `XCC`, a weaker startup kick, a colder or slower corner added to the
grid) spends this margin first, and it is the only measurement in the record
where a modest regression would cross a bound. It is called out in
`tb.json`'s own check description for the same reason.

`qs_lag_est_mv` — the residual distance between the primary 121 V/s result
and the true quasi-static limit, extrapolated from the two measured rates —
is **≤ 43.9 mV of rail**, against release margins of about a volt. The
method's own error is three orders of magnitude smaller than the margin it is
measuring.

### No regression in the sibling records

`design/bias_core.sch` is untouched, so `design/netlist/bias_core.spice` is
byte-identical (sha256 `87b6f943…`) and the two sibling experiments cannot in
principle have moved. Both were re-run anyway, on a clean tree, because
"cannot in principle" is not evidence:

| Experiment | Re-run record | Result | Against its pre-#46 record |
| --- | --- | --- | --- |
| `sim/bias-core-designer-check/` | `20260801-150709-5a013e8` | **FAIL**, unchanged — `por-iq` and the starved-loop window, the two conflicts this document already owns | **Bit-identical to `20260801-053019-732a894`**: every measurement's min, max, mean, spread and the corner each extremum lands on |
| `sim/bias-core-ibias-sharing/` | `20260801-152327-b72c10c` | **PASS**, 81/81, unchanged | Identical to `20260801-073555-8b7e57f` on six of eight measurements; the two that differ are `por_raw_shared_droop_mv` / `por_raw_control_droop_mv`, whose extremes move by **1 µV** against a 20 mV bound |

That 1 µV is **not unexplained nondeterminism**: the two records' own
environment blocks say the baseline `20260801-073555-8b7e57f` ran on
**ngspice-42 / Linux / python 3.12.3** and the re-run
`20260801-152327-b72c10c` on **ngspice-46 / macOS / python 3.14.6**, against
the *same* testbench netlist (sha256 `072b8fc4…`) and the same pinned PDK. A
1 µV difference on a 20 mV bound between two simulator versions on two
platforms is the floating-point noise floor of the measurement, and it is the
only place a re-run on the same netlist can move at all. The harness records
that environment on every run precisely so a reader can settle this question
from the evidence rather than by assumption.

### What changed in the testbench's checks, and why

The method change forced a re-derivation of the check bounds, and three of
them moved. All three are stated here rather than left in the diff, because
"a bound moved and the result now passes" is exactly the thing a reader
should be suspicious of. Every bound that carries a **ratified spec row** is
unchanged.

| Check | Was | Now | Why |
| --- | --- | --- | --- |
| `v_bias_ok_v` | min 1.5 V, max 2.45 V | **max 2.45 V only** | The max is spec-facing and unchanged. The min assumed the core's dropout is above 1.5 V. It is not — this document's own `vdd_ref90_v` measures **1.127–1.788 V**, and quasi-statically the loop is up and merely rail-limited from ~0.95 V at hot corners, so a *correct* flag legitimately asserts near 1.0 V there. Replaced by `relv_qs_v`. |
| `startup_margin_v` | min 0.1 V | **recorded, unbounded** | In the quasi-static limit this is not a margin. `v_core_up_v` and `v_bias_ok_v` are two points on the *same* steep transition, so demanding 100 mV of rail between them demands that the flag be **late**. The old bound encodes a 500 µs-ramp intuition — the very lag this experiment exists to remove. Measured: **−0.181…+0.045 V**. |
| `ok_at_140_mv` | max 300 mV | **removed; `ok_at_100_mv` recorded, unbounded** | Its stated premise, "1.40 V of rail is below the core's dropout at every corner", is contradicted by `vdd_ref90_v` above. There is no fixed rail at which "the core is definitely not up" holds across all 27 combinations *and* the output stage is still driven, so no honest fixed-rail bound exists. Replaced by `relv_qs_v`. |

All three removals are covered by **one** new check that is strictly stronger
because it is *reference-referred* instead of rail-referred:

> **`relv_qs_v ≥ 2.47 V`** — the rail at which (`BIAS_OK` is a valid high)
> **and** (`VDD ≥ 2.16667·VREF`) first hold together, i.e. the rail at which
> the assembled block would actually release. It fails if and only if
> `BIAS_OK` vouches for a reference low enough to pull `por_comparator`'s
> threshold below the ratified
> [`por-vth-rise`](../spec/target-spec.md#por-vth-rise) minimum. A `BIAS_OK`
> that goes valid while `VREF` is still merely **rail-limited** cannot trip
> it — correctly, because a rail-limited `VREF` makes `2.16667·VREF` larger
> than `VDD` by construction, which is the argument
> [The release guard](#the-release-guard) already makes. Same B-source
> construction as `sim/bias-core-designer-check/`'s `relv_slow_v`, evaluated
> in the quasi-static limit instead of on a 500 µs ramp.

Five further checks are **added**, not relaxed: `qs_rate_delta_mv`
(ramp-rate independence), `noko_final_v` (below), and the three
brownout-restart checks `ok_bo_dip_mv`, `v_bias_ok_restart_v` and
`vref_bo_end_delta_ppm`.

### The permanent guard against this recurring

`noko_final_v` is new and deliberately chosen. `NOKO` is the settle
comparator's own output — the node the `RT` tap's 2.1–3.6 mV differential is
amplified to before `XMOK2` turns it into a logic level. Because that first
stage is a **linear OTA, not a regenerative comparator**, `NOKO`'s settled
level *is* the margin: it has to sit well above the ~0.6 V at which `XMOK2`
starts to conduct, or the assertion is a coin flip. It is also the single
number that separates the artefact from the circuit at `tt`/−40 °C —
**0.605 V** with the aid, **1.643 V** without — so any future re-introduction
of a nA-scale numerical crutch, or any erosion of the comparator's drive,
fails this check first instead of surfacing as an unexplained `BIAS_OK`
failure. Measured: **1.376…1.817 V** across the grid.

### What this does *not* claim

- It does **not** claim the settle comparator has generous margin. It has
  0.78–1.22 V of `NOKO` headroom over `XMOK2`'s threshold, from a
  2.1–3.6 mV input differential amplified by a single stage. That is enough
  in a deterministic corner and it is now measured on every run, but **local
  mismatch on the comparator's input pair and load mirror is #15's Monte
  Carlo job**, not this record's, and a few millivolts of random offset is
  the same size as the signal. #15 should treat this pair as a priority
  instance.
- It does **not** retract [the starved-loop window](#the-starved-loop-window).
  That is a separate, still-open, *fast*-ramp finding measured by
  `sim/bias-core-designer-check/` at the default `gmin`, and it is untouched
  by any of this.
- It does **not** claim the superseded record was worthless. It is the
  evidence that produced the question, and its raw logs are what made the
  root cause findable. The lesson it carries forward is narrower and more
  useful than "the cell is broken": **a convergence aid whose injected
  current is comparable with the signal under test is not a convergence aid,
  it is a different circuit** — and at this block's nA-class bias currents,
  ngspice's default `gmin` is already 2.7 pA/junction at 2.7 V, so the
  headroom to abuse is smaller here than in almost any other analog block.

## The starved-loop window

**This is a measured defect, not a modelling artefact, and it is the second
of the two conflicts this document exists to surface.**

At the ratified fast end of
[`por-ramp-rate`](../spec/target-spec.md#por-ramp-rate) — **1.0 V/µs** — the
amplifier cannot slew `PG`. `PG` must track `VDD`, `C(PG)` is ~0.45 pF plus
0.8 pF of Miller capacitor, and the second stage sources ~26 nA: the
available slew rate is ~21 mV/µs against a rail moving at 1000 mV/µs. The
loop is therefore driven far past its operating point during the ramp,
parks at a small fraction of its intended current when the ramp stops, and
crawls back over hundreds of microseconds to milliseconds. Worst observed:
`VREF` sitting at **0.54 V** (45 % of nominal) for **4.4 ms** at `sf`/−40 °C.

While it is parked, **every** recovery mechanism in the cell is starved with
it — the amplifier tail, the settle comparator's tail and the dead-loop
detector's replica are all biased from the loop — so the settle comparator's
high-impedance output cannot be pulled down and `BIAS_OK` reads a **false
valid**. Measured, as the time-integral of (`BIAS_OK` valid) ∧ (`VREF` more
than 100 mV below settled):

| Branch | `t_false_ok_*_us` over the 81-point grid | Bound |
| --- | --- | --- |
| 500 µs ramp (≤ 7.3 V/ms) | **0…45.7 µs** (45.7 µs at `ff`/125 °C only; 0 at 78 of 81 points) | ≤ 5 µs ❌ at 3 points |
| 1.0 V/µs ramp | **11…1989 µs** | ≤ 5 µs ❌ at all 81 points |
| brownout branch (0.5 V dip, then full collapse) | **326…1567 µs** | ≤ 5 µs ❌ at all 81 points |

> **The two figures above that end near 2 ms are floors, not measurements
> (issue #185).** They were taken on a 2 ms transient, and the window they
> measure is longer than that at the cold corners — the same 4.4 ms this
> paragraph already quotes. On the 30 ms deck that replaced it, and against
> the *extracted* netlist, the fast-ramp branch reads **27.99…6584.96 µs** and
> the brownout branches **359.267…39866.3 µs**. The conclusion is unchanged
> and the direction is unchanged; only the magnitude was being clipped. See
> [The post-layout brownout regression](#the-post-layout-brownout-regression--it-was-the-deck-issue-185).

**Measured boundary.** Correct at ramps of **0.36 V/µs and slower** (10 µs
to full rail) at every corner, including −40 °C; false-valid at 1.0 V/µs.
`por-ramp-rate` ratifies 1 V/µs, so the cell is **~3× short of the ratified
fast limit**.

#### The same window on a *falling* rail — and it is far narrower (#55)

Issue #55 root-caused `sim/por-brownout/`'s 0/81 failure to this same
mechanism, running the other way. On a brownout the rail falls, `PG` again
cannot follow, and `V_sg` — the overdrive on the whole PMOS mirror bank —
does not merely shrink but **inverts**: measured **776.2 mV pre-dip →
−74.4 mV** 8 µs into a 1 µs edge. The bank is driven fully off, every bias
derived from it dies, and (as on the rising edge) the settle comparator dies
with it, so `BIAS_OK` reads a **false valid** for the whole collapse.

The falling boundary is **much lower than the rising one**, and this is the
number that matters for [`por-brownout`](../spec/target-spec.md#por-brownout):

| Direction | Boundary (correct behaviour at or below) | Source |
| --- | --- | --- |
| Rising (`por-ramp-rate`) | **0.36 V/µs** | `sim/bias-core-designer-check/`, 81 points |
| Falling (`por-brownout`) | **3.40 mV/µs**, binds at `ss`/−40 °C/2.97 V (FAIL confirmed from 3.4795 mV/µs) | `sim/por-brownout-slew/`, full 81-point grid (#60) |

The ~31× asymmetry is expected rather than surprising: on a rising rail the
loop is driven toward *more* current and recovers by settling down onto its
operating point, while on a falling rail it is driven toward *less* and
recovers only by charging `PG` back up through a second stage that the
collapse has already starved. The falling boundary sits at roughly half this
document's own independently derived ~21 mV/µs `PG` slew capability, which is
the corroboration that the two are the same mechanism rather than two
coincidences.

Two consequences worth stating plainly:

- **The dip's depth is not what breaks it.** A dip to 2.30 V — above
  `vdd_ref90_v`'s 1.788 V worst case at every corner — fails identically to
  one at 1.0 V. The "below its own operating floor" caveat DR-005 wrote, and
  which `design/bias_core.md` inherited, names the wrong variable: the
  collapse is dynamic, not static.
- **Waiting does not help.** Held below VPOR↓,min for 5 ms at a 1 µs edge —
  500× the then-ratified 10 µs `T_dip,min`, 167× the 30 µs [DR-027](../spec/decision-records/DR-027-por-brownout-tdip-recost.md) re-cost it to — the loop never recovers while the rail stays down, so
  reset still never asserts. Only the *recovery* edge restarts it.

The boundary above was originally a **one-corner** number, not fit to ratify
against; [DR-011](../spec/decision-records/DR-011-brownout-falling-slew-limit.md)
recorded it as `[TBD-#60]` pending an 81-point characterization. #60's full
grid (`sim/por-brownout-slew/`) has since supplied that characterization:
the boundary binds at `ss`/−40 °C/2.97 V, PASS at every one of 81 corners
confirmed at 3.40 mV/µs and FAIL (that same corner, and its 3.30/3.63 V
siblings) confirmed from 3.4795 mV/µs — a knife-edge, non-monotonic
transition rather than a single clean threshold (see
`sim/por-brownout-slew/records/*-boundary.md`), so the ratified bound sits on
the safe side of the whole transition band rather than at a bisected
midpoint. The "why it cannot be fixed inside this cell's Iq budget"
arithmetic below applies unchanged — it is the same detector that would be
needed.

**The non-monotonic band's mechanism, root-caused (#74).** A follow-up
characterization — three additional full-grid rungs at 3.42/3.44/3.46 mV/µs
(the last one moving the earliest observed failure down from 3.4795 to
**3.46 mV/µs**, at `ss`/−40 °C/3.30 V) plus an event-timing control at the
binding corner family — confirms the transition-zone hypothesis above and
turns it into a concrete mechanism rather than an analogy. It is a race
between two things this same starved loop drives: the dip window (fixed by
the falling edge's own duration) and `por_output_chain`'s deglitch dwell
(`design/por_output_chain.md`), realized here not at its documented
1.86–8.88 µs ceiling but at whatever current survives a bias collapse that is
**still in progress** when `POR_RAW` trips — the near-boundary edge has not
finished falling, so the deglitch tail keeps losing current for hundreds of
microseconds after the decision instant, stretching the measured dwell to
several hundred microseconds and, in a few cases, past 1 ms. That is
materially slower than either `design/por_output_chain.md`'s own
IBIAS-envelope characterization or
[DR-011](../spec/decision-records/DR-011-brownout-falling-slew-limit.md)'s
control C (valid-low in 3.70–7.30 µs down to zero `IBIAS`) — neither of which
is contradicted, because both hold the rail static once collapsed, and this
regime never gets there before the window closes. Because the collapse
trajectory behind that race differs slightly with the starting supply
(a higher `vdd_val` buys a longer absolute edge for the same mV/µs), the
race's winner is not a function of slew rate alone: `ss`/−40 °C/3.30 V and
/3.63 V cross it at slightly different slews, which is the non-monotonicity
itself. Full data, the per-supply event timeline, and the "is it the solver"
check that rules out an integration artefact are in
[`sim/por-brownout-slew/records/20260802-134958-dd0cd60-transition-band.md`](../sim/por-brownout-slew/records/20260802-134958-dd0cd60-transition-band.md).
This does not touch the ratified 3.40 mV/µs bound — every PASS margin at or
below it is 108.7 µs or more, well clear of the band, which only opens at
3.46 mV/µs — and it is not a claim that `por_output_chain` is defective: its
own characterization and DR-011's control both stand for the static condition
they measured.

#### An intermediate falling-slew band with a different symptom (#61)

DR-011's Consequences section flagged, but deliberately left open, a second
falling-edge finding: at falling rates **slower** than the boundary above
(so `RESETn` does reach a valid low and the dip is not the DR-005-owned
below-`vdd_ref90_v` failure), `POR_RAW` can still assert at a rail **above**
`VPOR-uparrow,max` = 2.73 V — a spurious reset while the supply is still
comfortably inside the ratified operating range.
[DR-013](../spec/decision-records/DR-013-por-brownout-spurious-assert.md)
confirms this across the full 81-point grid, and it is pervasive rather than
a corner curiosity: **45/81 (56 %)** of corners fail at 7.67 mV/µs, **74/81
(91 %)** at 2.30 mV/µs, and even the control's own "correct" 0.77 mV/µs
reference point fails at **15/81 (19 %)** of corners — overwhelmingly
`−40 °C` combined with the two higher supplies. The assert rail **tracks
`VDD`** rather than sitting at a fixed absolute threshold: holding process
and temperature fixed and sweeping only supply, the 2.30 mV/µs branch's
assert rail sits within 9 mV of 160 mV below whichever `VDD` it started
from, while the supply itself moves by 660 mV across the grid's three
points — a ratiometric trip, not a threshold pinned to a device voltage.

The obvious candidate explanation — this section's own ramp-rate `VREF`
feedthrough coefficient, extended to a falling edge — **substantially closes
once corner- and direction-matched, though not completely**
([DR-025](../spec/decision-records/DR-025-bias-core-ramp-feedthrough-grid-and-dr013-recheck.md),
issue #208). DR-013's original check used the single ≈2.4 µs figure this
section used to quote, which "Ramp-rate feedthrough" above now shows was
wrong at every corner in the grid, applied with the rising-edge sign to a
falling event. Using the corner- and direction-matched coefficient instead —
**−30.7 µs** at `tt`/27 °C/3.30 V (schematic), not +2.4 µs — the predicted
`VREF` offset is **−235 mV** at the 7.67 mV/µs branch and **−71 mV** at the
2.30 mV/µs branch, against DR-013's own measured **−467 mV** and **−81 mV**:
within a factor of ~2 and within 13 % respectively, not one to two orders of
magnitude off, and now the **same sign** — `VREF` depressed in both the
prediction and the measurement. That resolves the "wrong order of magnitude"
and "wrong sign of the `VREF` offset" objections DR-013 raised.

**It does not resolve the separate paradox DR-013 also raised.** A depressed
`VREF` still predicts, via the static `VPOR-downarrow = VREF ·
(RTOP+RBOT+RHYS)/(RBOT+RHYS)` divider algebra in `design/por_comparator.md`,
a *lower* assert threshold — yet the assert rail measures *above*
`VPOR-uparrow,max`. That is a property of the comparator/divider's dynamic
response during a fast dip, not of this cell's own reference feedthrough,
and it remains unidentified — see DR-025.

### Not the same defect as `por-ramp-rate`'s release-edge chatter (issue #56)

`sim/por-ramp-rate/records/20260802-000004-32fbaa0.md`'s full-assembly sweep
also measures `RESETn` **chattering** (crossing its release threshold more
than once) at up to 60 of 81 points per rate, at all four tested rates
including the two slow ones (1 V/s, 10 V/s) where this section's slew-rate
argument does not apply. It was an open question whether that is this window
operating at smaller scale on a slow ramp, or a distinct effect. **It is
distinct, and it is not owned by this cell.** `sim/por-ramp-rate/control/`
traces the release path on a slow ramp and finds `VREF`/`BIAS_OK`/`POR_RAW`
each cross their threshold once, cleanly, well before `RESETn` starts
toggling — this cell is settled throughout the chatter window, and the
mechanism is ramp-rate independent (same window width a decade apart in
rate), the opposite signature from this section's slew-limited one.

**What it actually is** (
[DR-016](../spec/decision-records/DR-016-por-ramp-rate-chatter-release-latch.md),
superseding DR-015's narrower localisation): a relaxation loop through the
**shared `IBIAS` node**. `RESETn`'s release enables `temp_core`, whose mirror
diode joins the shared node and steps it down by ~34 mV; `por_output_chain`'s
nA starve references follow, walking its trip detector's decision point back
until `RESETn` re-asserts — which disables `temp_core` again. Cutting the
`RESETn` → `temp_core.EN` → `IBIAS` path in a control arm removes the chatter
without any device in `por_output_chain` changing. Fixed by a release latch
(`XMRLK`) inside `por_output_chain`; see
[`design/por_output_chain.md`, "The release-edge chatter"](por_output_chain.md#the-release-edge-chatter--a-relaxation-loop-through-the-shared-ibias-node-not-a-local-instability).

**This cell is implicated only as the shared node's owner, not as the
defect.** The ~34 mV step is the correct, expected behaviour of a sub-µA
mirror reference when a third diode load is switched onto it — the arithmetic
in [Why it cannot be fixed inside this cell's Iq budget](#why-it-cannot-be-fixed-inside-this-cells-iq-budget)
applies equally to any proposal to stiffen the node so the step goes away.
The defence belongs downstream, in whichever consumer's decision the step can
walk back.

### Why it cannot be fixed inside this cell's Iq budget

The obvious fix is a "core is starved" detector that does not depend on the
core's own bias — i.e. a rail-referenced reference current. There is no such
thing available in this PDK at this current level, and the arithmetic says
so rather than the intuition:

- The only rail-referenced element that costs nA is a subthreshold
  diode-connected MOS stack. The five-deep stack used for the kick measures
  **12.6 pA (ss/−40 °C) … 17.5 nA (ff/125 °C)** — a **1390:1** corner
  spread. A four-deep stack is worse (**19.8 pA … 181 nA**, 9100:1).
- For a detector that trips at a fixed fraction of the loop current, the
  reference must satisfy `k·I_min > S_max` (so it does not fire when the
  loop is healthy at its weakest corner) and `k·0.001·I_max < S_min` (so it
  *does* fire when the loop is parked at its strongest corner). With
  `I` spanning 8…25 nA per unit leg and `S` spanning 12.6 pA…17.5 nA, those
  two inequalities require `k > 2.19` and `k < 0.50` simultaneously. **No
  value of `k` exists.**
- A resistor is the corner-stable alternative (±25 %, not 1390:1), but a
  rail-referenced 20 nA needs ~150 MΩ, which is ~49 000 □ of `ppolyf_u_3k` —
  about **twice the entire `area` planning budget** for one bias element.
- The remedy that does work is **more amplifier current**: the slew problem
  scales directly with the second stage's drive, and a detector referenced
  to a 100 nA-class rail current is buildable. That is exactly the budget
  [`por-iq`](../spec/target-spec.md#por-iq) has already run out of.

**So this is an architecture-level tension between two ratified rows**, not a
sizing miss: `por-iq` (originally <1 µA) and `por-ramp-rate`'s 1 V/µs fast
limit cannot both be met by a bandgap-referenced always-on core in gf180mcu
at this scale, **for the incremental Iq a rail-referenced starve detector
would need on top of what the cell already draws**. `target-spec.md` §5
already withdrew the <0.3 µA stretch with the words "requires architecture
revision"; this is the same finding one row further out. Resolving it is a
decision-record question for #1/#14, and the options are:

1. **Re-cost `por-iq`** upward (the §5 mechanism, and see
   [Iq apportionment](#iq-apportionment) — the row is already missed by 2.3×
   for unrelated reasons). **Partially taken by
   [DR-018](../spec/decision-records/DR-018-por-iq-recost.md)**: it re-costs
   `por-iq` to <3.0 µA, which covers the "unrelated reasons" apportionment
   overrun above (2371 nA measured, 20.5 % margin under the new ceiling) —
   but DR-018 explicitly does **not** fold in any additional current for a
   rail-referenced starve detector, because none has been designed or built.
   Whether the ~615 nA of headroom DR-018 leaves at the binding corner
   (3000 − 2385 nA) is enough for that detector, or whether `por-iq` would
   need a further re-cost to afford one, remains open — see DR-018's
   Consequences and the still-open starved-loop window below.
2. **Re-cost `por-ramp-rate`**'s fast limit down to the measured 0.36 V/µs.
   Still open; DR-018 explicitly declines to take this option (see that
   record's "Alternatives considered" — recasting the ramp-rate row, on its
   own, would not reduce the currently-measured `por-iq` by any amount, since
   no detector current is in that measurement today).
3. **Change the architecture.** ~~E.g. a `RESETn`-gated `IBIAS` (see below),
   which frees ~1 µA of budget that could be spent on amplifier drive.~~
   **That particular architecture change is now ruled out**: DR-010 rejects a
   `RESETn`-gated `IBIAS` because `por_comparator` and `por_output_chain`
   consume `IBIAS` precisely while `RESETn` is asserted, so gating it there
   would starve the POR decision itself. The ~1 µA it appeared to free is the
   current that biases them. Some other architecture change may still do it;
   this one does not.

Nothing here relaxes either row to make the result pass. The static
apportionment overrun (why `por-iq` misses regardless of ramp-rate) is closed
by DR-018; the starved-loop window itself (why a fast ramp or brownout can
read a false-valid `BIAS_OK`) is not, and remains open for a future decision
record.
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
