2AMLogic/gf180-temp-por/layout/cells/temp_por_top.erc-supply-spec-NOTES.md

# `temp_por_top.erc-supply-spec.json` — why each field is shaped this way

This file is the justification block that used to live inside the spec
itself as a top-level `_comment` key. `klt 0.7.0` rejects unknown spec keys
(klayout-tools#2243 strict spec validation) and its erc spec schema has no
comment convention, so the text moved here verbatim when the report was
regenerated on the released tool. The spec file cannot even name this
sidecar (any key outside the schema is a hard error); it is found by name.
The text below is unchanged from the `_comment` block the #310-era run read.

---

klt erc supply spec for the merged top cell -- T1 checklist item 11
('Power delivery, structural', klayout-tools#2025/#2057) requires a
supply-net read of this shape for every block (issue #300). See
layout/README.md's 'Item 11' section for the full account of what this
run showed and does not show; this block only justifies each field.

Run it against the committed top-cell GDS:

    klt erc layout/cells/temp_por_top.gds \
      layout/cells/temp_por_top.erc-supply-spec.json --format json

producing layout/reports/temp_por_top/erc_supply.json.

Why each field is shaped this way:

- `stackup[0]` MUST carry `role: "gate"` (klt erc's own contract), so the
  stack starts at Poly2 rather than at Metal1. `active_layer` (Comp) makes
  the gate-identification test `poly AND diff` instead of raw poly area,
  which is what keeps this block's poly-resistor legs (temp_core's R2
  ladder and bias_core's bias resistors -- real poly with no gate oxide)
  out of `gates[]` (klayout-tools docs/cli/erc.md, 'Gate area: poly n diff
  vs. raw poly area', issue #1979). This block has no filler/filltie
  masters (it is hand-drawn analog, not a placed-and-routed standard-cell
  flow), but the same poly-without-oxide shape appears here as resistors.
- Metal1 through Metal5 is this block's full drawn interconnect stack
  (layout/build_cells.py's own header comment: 'Nwell 21/0 . Comp 22/0 .
  ... Metal1 34/0 . Metal2 36/0 ... Via3 40/0 . Via4 41/0 . Metal5 81/0'),
  so the supply read has to cover every level a rail or a riser could be
  drawn on, not just the levels the top-level VDD/VSS rails happen to use.
- `label_layer` is declared on Metal1 (34/10) and Metal2 (36/10), and
  deliberately NOT on Metal3/Metal4/Metal5 -- verified against this
  block's own merged GDS with `klt layers --flattened --include-text`
  rather than assumed from another block's spec:
    * 34/10 carries 48 text occurrences, including 5 VDD + 5 VSS --
      layout/build_cells.py's per-sub-cell internal net labels (each
      sub-cell's own VDD/VSS pin, dropped on its own Metal1 riser; see
      METAL1_LABEL, e.g. the bias_core/por_comparator/por_output_chain/
      temp_core instances' own `b.label("VDD", ...)` / `b.label("VSS",
      ...)` calls).
    * 36/10 carries 5 text occurrences: CTAT, PTAT, RESETn, VDD, VSS --
      this is `_top_cell`'s own METAL2_LABEL set, i.e. the block's
      RATIFIED 5-PAD PINOUT (layout/build_cells.py: 'the ratified 5-pad
      pinout ... VDD/VSS are labelled on their rails ... the *only*
      labels drawn directly in this cell'). This is the label set
      `top_cell_pins` (klayout-tools#291) turns into the chip's own pin
      list.
    * Metal3 (42/0), Metal4 (46/0) and Metal5 (81/0) carry NO text at
      all in this GDS (`text_count: 0` for every layer/datatype pair on
      those levels) -- Metal5 in particular is drawn only as the MiM
      capacitor plates' Via4 escape route in bias_core and
      por_output_chain (layout/build_cells.py: 'Via3 40/0 . Via4 41/0 .
      Metal5 81/0 (the drawn MiM units' plate routing, #264 -- ... the
      top plate's only escape is Via4 -> Metal5 -> a second Via4 down a
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
