2AMLogic/gf180-temp-por/sim/por-brownout-slew/control/net_attribution_results.md

# Which extracted nets carry the post-layout falling-slew shift — results

> **Which netlist and which parasitic model these rows belong to** (hand-added
> by [#316](https://github.com/2AMLogic/gf180-temp-por/issues/316),
> 2026-10-02; the next re-run regenerates this file and drops this note).
> Every row below was measured against `layout/postlayout/temp_por_top.spice`
> at **sha256 `b04ec65d9bdc…`**, named in the "Anchor netlists" bullet below —
> the extraction as it stood before
> [#314](https://github.com/2AMLogic/gf180-temp-por/issues/314) regenerated it
> against the `klt` pinned in `layout/toolchain.json`. That netlist used the
> **dangling-leg** parasitic model (`R<net> <net> <net>__par` plus `C<net>
> <net>__par VSS`, with every device terminal left on `<net>` itself), which
> is what §1 below describes and what "comments out that pair" means there.
> The committed netlist today is a per-net **star** and hashes differently, so
> these rows are evidence about the netlist they name and not about the one in
> `layout/postlayout/` now. `sim/` is append-only: the way to get rows for the
> current netlists is to re-run the control, which mints a new version of this
> file (`run_net_attribution.py`'s manipulation was re-derived for the star
> model in #316; the re-run itself is a PVT-grid job and has not been made).
>
> **The re-run is now a named gap, not an open-ended one**
> ([#321](https://github.com/2AMLogic/gf180-temp-por/issues/321), split out of
> [#319](https://github.com/2AMLogic/gf180-temp-por/issues/319) 2026-10-02).
> `run_net_attribution.py` spawns its 60 decks as local `ngspice -b`
> subprocesses at a hardcoded 8-way parallelism (`runner.run_deck` →
> `subprocess.run([NGSPICE, "-b", …])`), with no concurrency knob and no
> remote/batch path, so it cannot be taken from a shared dispatch host; #321
> carries both the re-run and the execution-path decision. When it lands, it
> must also say whether the per-net attribution **ranking** moved — the star
> model can express in-path resistance between a net's own device terminals,
> which is a term the dangling-leg model these rows were measured under had
> no way to represent.

**Generated by `run_net_attribution.py`. Do not edit — re-run it.** Every number below is read out of `logs/na-*.log` by that script; nothing here is transcribed by hand.

[DR-019](../../../spec/decision-records/DR-019-brownout-falling-slew-postlayout-recost.md) re-cost `spec/target-spec.md#por-brownout` clause (c)'s `dVDD/dt|fall,max` from 3.4 mV/µs to 2.3 mV/µs on the extracted netlist's measured transition edge, and left open which nets' parasitics carry the shift. This control answers that one question by making named nets' interconnect ideal, one group at a time, and re-running the binding family at the two rungs that bracket the disagreement. **It does not, and cannot, change DR-019's ratified bound** — that is settled on the corner-grid records under `../records/`; what is decided here is only whether a *better* bound is reachable by re-routing.

- PVT points: `ss` / -40 °C / 2.97 V, 3.3 V, 3.63 V (one corner family — a control is not corner evidence, see `sim/README.md`; the corner-grid evidence for the post-layout transition edge is the rung records under `../records/`)
- Rungs: 2.5 mV/µs, 3.4 mV/µs
- PDK: `gf180mcuD` @ `c6d73a35f524070e85faff4a6a9eef49553ebc2b`
- Harness version: `0.1.0`
- Solver options (from `../testbench/tb.json`): `reltol=1e-4`, `abstol=1e-13`, `vntol=1e-8`, `method=gear`
- Anchor netlists: `sch` = `design/netlist/temp_por_top.spice` (sha256 `ae7021b9e44f…`); `ext` = `layout/postlayout/temp_por_top.spice` (sha256 `b04ec65d9bdc…`), which carries `layout/postlayout/AUDIT.md`'s `temp_por_top` caveats — 238 drawn devices, 1 ideal (`temp_core`'s undrawn `XCC`, #177, not on any node in this path), 136/159 nets carrying parasitics.
- `PASS`/`FAIL` is `resetn_ratio_min_in_dip ≤ 0.1`, the grid's own checked discriminator, recomputed from this control's own trace over the same window `../testbench/tb.json` uses.

## 1 — what each arm made ideal

`layout/postlayout.py` models a net's whole drawn interconnect as one lumped series R to a `<net>__par` stub plus one lumped C from that stub to `VSS`, and nothing else in the netlist references the stub. Each arm below comments out that pair for the named nets and changes nothing else — the generated netlists under `netlists/` diff against the source in exactly 2 × *nets* lines, so those nets carry no interconnect load and every other net keeps the extraction's.

| arm | nets made ideal | ΣC removed (fF) | ΣR removed (Ω) | share of cell ΣC | what it is |
|---|---:|---:|---:|---:|---|
| `sch` | — | — | — | — | the schematic export — upper anchor |
| `ext` | — | — | — | — | the extraction, untouched — lower anchor |
| `pg` | `xbias__PG` | 68.1 | 5084 | 1.2 % | `bias_core`'s PMOS mirror gate — the node DR-011 measures the starved-loop collapse on |
| `nbg` | `xbias__NBG` | 55.9 | 4872 | 0.9 % | `bias_core`'s NMOS mirror gate |
| `nz` | `xbias__NZ` | 25.5 | 2787 | 0.4 % | `bias_core`'s compensation node (`XCC`/`XRZ`) |
| `ibias` | `IBIAS` | 122.6 | 10642 | 2.1 % | the top-level bias current the other three cells run on |
| `loop` | `xbias__PG`, `xbias__NBG`, `xbias__NZ`, `IBIAS` | 272.1 | 23385 | 4.6 % | all four of the above together |
| `bias` | 44 nets | 1582.8 | 132948 | 26.9 % | every net `bias_core` owns (`xbias__*`), plus the top-level nets it drives |
| `por` | 13 nets | 522.9 | 53563 | 8.9 % | every net `por_output_chain` owns (`xpor__*`) — the deglitch ramp that never starts |
| `all` | 136 nets | 5880.2 | 280923 | 100.0 % | every parasitic-carrying net — the method control |

Cell total for reference: 5880.2 fF of interconnect capacitance over 136 nets.

## 2 — does the boundary come back?

Supply points passing out of 3, per arm per rung. The question the whole control exists to answer is the 3.4 mV/µs column: `sch` passes all three there and `ext` fails all three, so an arm that passes all three has given the pre-DR-019 bound back, and an arm that still fails all three has not.

| arm | 2.5 mV/µs | 3.4 mV/µs | worst min `V_sg` at 3.4 mV/µs (mV) | reading at 3.4 mV/µs |
|---|---:|---:|---:|---|
| `sch` | 3/3 | 3/3 | -116.0 | the upper anchor |
| `ext` | 2/3 | 0/3 | -297.5 | the lower anchor |
| `pg` | 2/3 | 0/3 | -291.3 | not the carrier |
| `nbg` | 2/3 | 0/3 | -304.9 | not the carrier |
| `nz` | 2/3 | 0/3 | -298.3 | not the carrier |
| `ibias` | 2/3 | 0/3 | -296.6 | not the carrier |
| `loop` | 2/3 | 0/3 | -296.8 | not the carrier |
| `bias` | 3/3 | 0/3 | -106.9 | dominant, not sufficient alone |
| `por` | 3/3 | 0/3 | -297.6 | not the carrier |
| `all` | 3/3 | 1/3 | -106.8 | dominant, not sufficient alone |

## 3 — margin at each point

All times are µs after the dip starts. *window closes* is `edge + 50 µs dwell`, the end of the window `../testbench/tb.json` measures `resetn_ratio_min_in_dip` over, so a positive margin is a PASS at that point and a negative one — or a `RESETn` that never reaches valid-low — is the FAIL the grid records.

| rung (mV/µs) | supply | arm | window closes | `POR_RAW` asserts | `PGDG` falls | `RESETn` valid-low | margin | Δ vs `ext` | verdict |
|---:|---:|---|---:|---:|---:|---:|---:|---:|---|
| 2.5 | 2.97 V | `sch` | 838.0 | 67.6 | 499.9 | 501.1 | +336.9 | +381.9 | PASS |
| 2.5 | 2.97 V | `ext` | 838.0 | 143.5 | 813.3 | 883.0 | -45.0 | — | **FAIL** |
| 2.5 | 2.97 V | `pg` | 838.0 | 143.8 | 813.0 | 882.8 | -44.8 | +0.2 | **FAIL** |
| 2.5 | 2.97 V | `nbg` | 838.0 | 143.5 | 814.7 | 884.1 | -46.1 | -1.1 | **FAIL** |
| 2.5 | 2.97 V | `nz` | 838.0 | 143.3 | 813.6 | 883.3 | -45.3 | -0.3 | **FAIL** |
| 2.5 | 2.97 V | `ibias` | 838.0 | 143.5 | 813.6 | 883.3 | -45.3 | -0.3 | **FAIL** |
| 2.5 | 2.97 V | `loop` | 838.0 | 143.7 | 814.8 | 884.2 | -46.2 | -1.2 | **FAIL** |
| 2.5 | 2.97 V | `bias` | 838.0 | 73.7 | 621.3 | 632.8 | +205.2 | +250.2 | PASS |
| 2.5 | 2.97 V | `por` | 838.0 | 143.5 | 533.2 | 534.6 | +303.4 | +348.4 | PASS |
| 2.5 | 2.97 V | `all` | 838.0 | 73.7 | 496.5 | 497.6 | +340.4 | +385.4 | PASS |
| 2.5 | 3.30 V | `sch` | 970.0 | 67.9 | 581.6 | 582.8 | +387.2 | +170.5 | PASS |
| 2.5 | 3.30 V | `ext` | 970.0 | 144.2 | 743.8 | 753.3 | +216.7 | — | PASS |
| 2.5 | 3.30 V | `pg` | 970.0 | 144.5 | 743.9 | 753.4 | +216.6 | -0.1 | PASS |
| 2.5 | 3.30 V | `nbg` | 970.0 | 144.3 | 743.9 | 753.5 | +216.5 | -0.2 | PASS |
| 2.5 | 3.30 V | `nz` | 970.0 | 144.1 | 743.6 | 753.1 | +216.9 | +0.2 | PASS |
| 2.5 | 3.30 V | `ibias` | 970.0 | 144.2 | 743.9 | 753.5 | +216.5 | -0.2 | PASS |
| 2.5 | 3.30 V | `loop` | 970.0 | 144.4 | 744.0 | 753.6 | +216.4 | -0.3 | PASS |
| 2.5 | 3.30 V | `bias` | 970.0 | 74.2 | 673.4 | 675.8 | +294.2 | +77.5 | PASS |
| 2.5 | 3.30 V | `por` | 970.0 | 144.2 | 622.0 | 623.1 | +346.9 | +130.2 | PASS |
| 2.5 | 3.30 V | `all` | 970.0 | 74.2 | 575.4 | 576.6 | +393.4 | +176.7 | PASS |
| 2.5 | 3.63 V | `sch` | 1102.0 | 68.1 | 656.2 | 657.4 | +444.6 | +139.4 | PASS |
| 2.5 | 3.63 V | `ext` | 1102.0 | 144.6 | 794.7 | 796.8 | +305.2 | — | PASS |
| 2.5 | 3.63 V | `pg` | 1102.0 | 144.9 | 794.8 | 796.9 | +305.1 | -0.1 | PASS |
| 2.5 | 3.63 V | `nbg` | 1102.0 | 144.7 | 794.8 | 796.9 | +305.1 | -0.1 | PASS |
| 2.5 | 3.63 V | `nz` | 1102.0 | 144.5 | 794.8 | 796.9 | +305.1 | -0.1 | PASS |
| 2.5 | 3.63 V | `ibias` | 1102.0 | 144.6 | 794.7 | 796.8 | +305.2 | +0.0 | PASS |
| 2.5 | 3.63 V | `loop` | 1102.0 | 144.8 | 795.1 | 797.1 | +304.9 | -0.3 | PASS |
| 2.5 | 3.63 V | `bias` | 1102.0 | 74.2 | 742.6 | 743.8 | +358.2 | +53.0 | PASS |
| 2.5 | 3.63 V | `por` | 1102.0 | 144.6 | 700.3 | 701.5 | +400.5 | +95.3 | PASS |
| 2.5 | 3.63 V | `all` | 1102.0 | 74.2 | 644.9 | 646.2 | +455.8 | +150.6 | PASS |
| 3.4 | 2.97 V | `sch` | 629.4 | 74.0 | 504.0 | 520.1 | +109.3 | +637.9 | PASS |
| 3.4 | 2.97 V | `ext` | 629.4 | 1109.6 | 1158.0 | 1158.0 | -528.6 | — | **FAIL** |
| 3.4 | 2.97 V | `pg` | 629.4 | 1098.5 | 1159.2 | 1159.3 | -529.9 | -1.3 | **FAIL** |
| 3.4 | 2.97 V | `nbg` | 629.4 | 1124.0 | 1153.8 | 1153.9 | -524.5 | +4.1 | **FAIL** |
| 3.4 | 2.97 V | `nz` | 629.4 | 1119.7 | 1155.9 | 1155.9 | -526.5 | +2.1 | **FAIL** |
| 3.4 | 2.97 V | `ibias` | 629.4 | 1109.6 | 1157.7 | 1157.7 | -528.3 | +0.3 | **FAIL** |
| 3.4 | 2.97 V | `loop` | 629.4 | 1123.1 | 1154.6 | 1154.6 | -525.2 | +3.4 | **FAIL** |
| 3.4 | 2.97 V | `bias` | 629.4 | 83.5 | 1154.8 | 1154.9 | -525.5 | +3.1 | **FAIL** |
| 3.4 | 2.97 V | `por` | 629.4 | 1110.5 | 1164.8 | 1164.8 | -535.4 | -6.8 | **FAIL** |
| 3.4 | 2.97 V | `all` | 629.4 | 83.7 | 1158.1 | 1158.2 | -528.8 | -0.2 | **FAIL** |
| 3.4 | 3.30 V | `sch` | 726.5 | 72.6 | 541.4 | 545.4 | +181.1 | — | PASS |
| 3.4 | 3.30 V | `ext` | 726.5 | 1256.9 | **never** | **never** | — | — | **FAIL** |
| 3.4 | 3.30 V | `pg` | 726.5 | 1255.9 | **never** | **never** | — | — | **FAIL** |
| 3.4 | 3.30 V | `nbg` | 726.5 | 1299.3 | **never** | **never** | — | — | **FAIL** |
| 3.4 | 3.30 V | `nz` | 726.5 | 1286.2 | **never** | **never** | — | — | **FAIL** |
| 3.4 | 3.30 V | `ibias` | 726.5 | 1257.8 | **never** | **never** | — | — | **FAIL** |
| 3.4 | 3.30 V | `loop` | 726.5 | 1303.2 | **never** | **never** | — | — | **FAIL** |
| 3.4 | 3.30 V | `bias` | 726.5 | 81.7 | **never** | **never** | — | — | **FAIL** |
| 3.4 | 3.30 V | `por` | 726.5 | 1256.9 | **never** | **never** | — | — | **FAIL** |
| 3.4 | 3.30 V | `all` | 726.5 | 81.7 | **never** | **never** | — | — | **FAIL** |
| 3.4 | 3.63 V | `sch` | 823.5 | 71.5 | 601.2 | 602.9 | +220.6 | — | PASS |
| 3.4 | 3.63 V | `ext` | 823.5 | 1342.0 | **never** | **never** | — | — | **FAIL** |
| 3.4 | 3.63 V | `pg` | 823.5 | 1335.9 | **never** | **never** | — | — | **FAIL** |
| 3.4 | 3.63 V | `nbg` | 823.5 | 1362.6 | **never** | **never** | — | — | **FAIL** |
| 3.4 | 3.63 V | `nz` | 823.5 | 1355.4 | **never** | **never** | — | — | **FAIL** |
| 3.4 | 3.63 V | `ibias` | 823.5 | 1343.0 | **never** | **never** | — | — | **FAIL** |
| 3.4 | 3.63 V | `loop` | 823.5 | 1365.9 | **never** | **never** | — | — | **FAIL** |
| 3.4 | 3.63 V | `bias` | 823.5 | 79.5 | **never** | **never** | — | — | **FAIL** |
| 3.4 | 3.63 V | `por` | 823.5 | 1342.1 | **never** | **never** | — | — | **FAIL** |
| 3.4 | 3.63 V | `all` | 823.5 | 79.1 | 735.1 | 800.3 | +23.2 | — | PASS |

## 4 — the state behind it, at 3.4 mV/µs

`V_sg` (= VDD − `PG`) is the overdrive on `bias_core`'s PMOS mirror bank — the state variable [DR-011](../../../spec/decision-records/DR-011-brownout-falling-slew-limit.md) measures the starved-loop collapse on, where a NEGATIVE value means the bank is driven fully off and every bias below it is dead. *recovered* is the fraction of the `sch`−`ext` gap in that number the arm gives back: 1.00 would be the schematic's own collapse, 0.00 the extraction's. It is computed on `V_sg` rather than on the margin because `V_sg` is defined for every run, including the ones where `RESETn` never reaches valid-low and the margin has no value at all. `ndg_r_max` is how far `por_output_chain`'s deglitch ramp got inside the window (≈0.6–0.7 is the level the PASS rows cross; 0.000 means it never moved).

| arm | min `V_sg` (mV), 2.97 V | min `V_sg` (mV), 3.3 V | min `V_sg` (mV), 3.63 V | recovered, 2.97 V | recovered, 3.3 V | recovered, 3.63 V | peak `NDG`/VDD, 2.97 V | peak `NDG`/VDD, 3.3 V | peak `NDG`/VDD, 3.63 V |
|---|---|---|---|---|---|---|---|---|---|
| `sch` | +22.7 | -85.8 | -116.0 | +1.00 | +1.00 | +1.00 | 0.626 | 0.670 | 0.706 |
| `ext` | -100.5 | -252.4 | -297.5 | +0.00 | +0.00 | +0.00 | 0.000 | 0.000 | 0.000 |
| `pg` | -31.5 | -199.4 | -291.3 | +0.56 | +0.32 | +0.03 | 0.000 | 0.000 | 0.000 |
| `nbg` | -101.1 | -257.8 | -304.9 | -0.00 | -0.03 | -0.04 | 0.000 | 0.000 | 0.000 |
| `nz` | -92.3 | -249.0 | -298.3 | +0.07 | +0.02 | -0.00 | 0.000 | 0.000 | 0.000 |
| `ibias` | -100.5 | -251.8 | -296.6 | -0.00 | +0.00 | +0.01 | 0.000 | 0.000 | 0.000 |
| `loop` | -19.7 | -186.0 | -296.8 | +0.66 | +0.40 | +0.00 | 0.000 | 0.000 | 0.000 |
| `bias` | +17.7 | -89.0 | -106.9 | +0.96 | +0.98 | +1.05 | 0.458 | 0.416 | 0.475 |
| `por` | -100.7 | -252.4 | -297.6 | -0.00 | -0.00 | -0.00 | 0.000 | 0.000 | 0.000 |
| `all` | +18.1 | -89.2 | -106.8 | +0.96 | +0.98 | +1.05 | 0.493 | 0.510 | 0.574 |

## 5 — the reading, arm by arm

Each row states what shorting that arm's nets did to the 3.4 mV/µs boundary, classified from the two columns above and nothing else:

- **restores the bound** — passes all 3 supply points at 3.4 mV/µs. The loss is dominated by these nets and is a layout problem.
- **dominant, not sufficient alone** — still fails, but gives back ≥ 50% of the `V_sg` gap at every supply.
- **contributes** — gives back ≥ 10% of the gap at every supply, but not the bulk of it.
- **not the carrier** — gives back < 10% of the gap at one or more supplies. Removing this net's parasitics entirely does not move the boundary; the loss is elsewhere, or spread.

| arm | nets | worst recovered | verdict at 3.4 mV/µs | reading |
|---|---:|---:|---:|---|
| `pg` | 1 | +0.03 | 0/3 | not the carrier |
| `nbg` | 1 | -0.04 | 0/3 | not the carrier |
| `nz` | 1 | -0.00 | 0/3 | not the carrier |
| `ibias` | 1 | -0.00 | 0/3 | not the carrier |
| `loop` | 4 | +0.00 | 0/3 | not the carrier |
| `bias` | 44 | +0.96 | 0/3 | dominant, not sufficient alone |
| `por` | 13 | -0.00 | 0/3 | not the carrier |
| `all` | 136 | +0.96 | 1/3 | dominant, not sufficient alone |

*worst recovered* is over the supply axis, because the binding point is the one that fails hardest, not the average: an arm that gives the collapse back at 2.97 V and nothing at 3.63 V has not moved the boundary, and the per-supply columns in section 4 are where that asymmetry is visible.

**Read `all` first.** It is the method control: it makes every one of the 136 parasitic-carrying nets ideal at once, which is the most any amount of re-routing could ever recover. If `all` does not restore the bound, then no subset of it can, and the residue is not carried by interconnect parasitics at all — it is one of the other ways the extraction differs from the schematic export (per-device junction areas and perimeters taken from drawn geometry rather than from the schematic's formulas, plus `layout/postlayout/AUDIT.md`'s substitutions), which this control does not decompose further.

**Bottom line, from the two tables above.** The method control `all` passes 1/3 at 3.4 mV/µs against `sch`'s 3/3, so removing every parasitic in the extraction does not reproduce the schematic arm's behaviour at this rung and no subset of those nets can either. The best single net is `pg` at +0.03 worst recovered. Note that at this rung the block is inside the non-monotonic PASS/FAIL band `results.md` (#74) documents, so a partial pass count is a knife-edge, not a graded improvement — which is exactly why the `V_sg` column, and not the pass count, is what the classification above is computed from.

### The 2.5 mV/µs rung — a different question

3.4 mV/µs asks whether the PRE-DR-019 bound is recoverable. 2.5 mV/µs asks something else and more immediately useful: it is the extracted netlist's own transition edge — the lowest rung #188 recorded a failure at — so it is the rung that put DR-019's bound at 2.3 mV/µs rather than higher. An arm that converts its failure is a lever on the ratified number even if it does nothing at 3.4 mV/µs. Δ margin is against `ext` at the same point; only the supplies where `ext` does not already pass can move.

| arm | margin at 2.97 V (µs) | margin at 3.3 V (µs) | margin at 3.63 V (µs) | passing | changes the 2.5 mV/µs edge? |
|---|---:|---:|---:|---:|---|
| `sch` | +336.9 (+381.9) | +387.2 (+170.5) | +444.6 (+139.4) | 3/3 | anchor |
| `ext` | -45.0 | +216.7 | +305.2 | 2/3 | anchor |
| `pg` | -44.8 (+0.2) | +216.6 (-0.1) | +305.1 (-0.1) | 2/3 | no |
| `nbg` | -46.1 (-1.1) | +216.5 (-0.2) | +305.1 (-0.1) | 2/3 | no |
| `nz` | -45.3 (-0.3) | +216.9 (+0.2) | +305.1 (-0.1) | 2/3 | no |
| `ibias` | -45.3 (-0.3) | +216.5 (-0.2) | +305.2 (+0.0) | 2/3 | no |
| `loop` | -46.2 (-1.2) | +216.4 (-0.3) | +304.9 (-0.3) | 2/3 | no |
| `bias` | +205.2 (+250.2) | +294.2 (+77.5) | +358.2 (+53.0) | 3/3 | **yes — converts every point `ext` fails** |
| `por` | +303.4 (+348.4) | +346.9 (+130.2) | +400.5 (+95.3) | 3/3 | **yes — converts every point `ext` fails** |
| `all` | +340.4 (+385.4) | +393.4 (+176.7) | +455.8 (+150.6) | 3/3 | **yes — converts every point `ext` fails** |

`ext` fails 2.97 V at 2.5 mV/µs; `sch` passes every point. An arm marked **yes** above removes the parasitics that carry that failure — which is a layout lever on where the extracted transition edge sits, and therefore on how much of the 2.3 mV/µs bound is recoverable. Where the edge would land after such a re-route is not answered here: two rungs bracket a boundary, they do not locate it, and locating it is a corner-grid ladder's job (`../records/`), not a control's. That is filed as [#232](https://github.com/2AMLogic/gf180-temp-por/issues/232), which proposes re-laddering against this control's own `netlists/na-por.spice` first, before any layout is touched.

## 6 — probe integrity

`run_band_mechanism.internal()` resolves the sub-cell node paths for either netlist flavour, and its docstring names the failure this section exists to rule out: if a probe below the cell boundary does not resolve, ngspice reports *vector … is not available*, the derived `let` fails, and the row reads as "the deglitch never started" rather than as "this arm never looked". Every generated netlist is a flat extraction with the same net names as its source, so the paths should resolve identically — this table is the check, not the claim.

| arm | decks with all of `vsg_pre`, `vsg_min`, `pgdg_r_min`, `ndg_r_max` |
|---|---:|
| `sch` | 6/6 |
| `ext` | 6/6 |
| `pg` | 6/6 |
| `nbg` | 6/6 |
| `nz` | 6/6 |
| `ibias` | 6/6 |
| `loop` | 6/6 |
| `bias` | 6/6 |
| `por` | 6/6 |
| `all` | 6/6 |

## 7 — ss/-40°C/2.97V ideal-`por`-interconnect edge check
<!-- run_por_edge_check.py:2026-08-11 -->

**Generated by `run_por_edge_check.py` on 2026-08-11. Do not edit — re-run it.** Sections 1–6 above are `run_net_attribution.py`'s and are not touched by this script; this section is appended, and a rerun on the same date replaces only this section (see the marker comment above), per `sim/`'s append-only-evidence convention.

[#232](https://github.com/2AMLogic/gf180-temp-por/issues/232) asks how far past 2.50 mV/µs the `por`-ideal edge reaches, at the one supply where `ext` fails at 2.5 mV/µs (2.97 V — the other two, 3.30 V and 3.63 V, already pass there, see §3 above). This is a cheap gate-check ahead of any layout re-route, not a corner-grid ladder: it does not touch `spec/target-spec.md`, DR-019, or any `../records/` entry.

- PVT point: `ss` / -40 °C / 2.97 V only — the failing corner, not the three-supply family §2–§6 keep (one supply is not corner evidence either; see `sim/README.md`)
- Rungs: 2.5 mV/µs (reproduction) and 2.8, 3 mV/µs (new), `por` arm; 2.5 mV/µs only, `ext` arm
- PDK: `gf180mcuD` @ `c6d73a35f524070e85faff4a6a9eef49553ebc2b`
- Harness version: `0.1.0`
- Solver options (from `../testbench/tb.json`): `reltol=1e-4`, `abstol=1e-13`, `vntol=1e-8`, `method=gear`
- `PASS`/`FAIL` is `resetn_ratio_min_in_dip ≤ 0.1`, the grid's own checked discriminator, recomputed from this control's own trace over the same window `../testbench/tb.json` uses.
- `por` = `netlists/na-por.spice` (`run_net_attribution.py`'s 13-net, 522.9 fF / 8.9 % ΣC ideal-`por_output_chain`-interconnect netlist); `ext` = `layout/postlayout/temp_por_top.spice`, untouched.

### Reproduction check

Before trusting the new 2.8, 3 mV/µs points, 2.5 mV/µs must reproduce `net_attribution_results.md` §3's already-published baselines at 2.97 V: `ext` −45.0 µs **FAIL**, `por` +303.4 µs PASS.

| arm | margin at 2.5 mV/µs (µs) | verdict | published margin (µs) | published verdict | reproduces? |
|---|---:|---|---:|---|---|
| `ext` | -45.0 | **FAIL** | -45.0 | FAIL | yes |
| `por` | +303.4 | PASS | +303.4 | PASS | yes |

### `por`-ideal edge: 2.5–3.00 mV/µs

All times are µs after the dip starts, same convention as §3. A positive margin is a PASS within the window; `ext` is included at 2.5 mV/µs only, for the Δ column.

| rung (mV/µs) | arm | window closes | `POR_RAW` asserts | `PGDG` falls | `RESETn` valid-low | margin | Δ vs `ext` @ 2.5 | verdict |
|---:|---|---:|---:|---:|---:|---:|---:|---|
| 2.5 | `ext` | 838.0 | 143.5 | 813.3 | 883.0 | -45.0 | +0.0 | **FAIL** |
| 2.5 | `por` | 838.0 | 143.5 | 533.2 | 534.6 | +303.4 | +348.4 | PASS |
| 2.8 | `por` | 753.6 | 151.9 | 567.6 | 575.6 | +178.0 | +223.0 | PASS |
| 3 | `por` | 706.7 | 1172.4 | 1286.4 | 1286.4 | -579.7 | -534.7 | **FAIL** |

### Go / no-go

**GO on further characterization, NO-GO on drawing a re-route from this control alone.** `por` passes through 2.8 mV/µs and fails by 3 mV/µs, so the ideal-`por`-interconnect edge is bracketed between 2.8 and 3 mV/µs — already at or above the ~2.6 mV/µs this issue's own order-of-magnitude estimate treated as the not-worth-it threshold, and meaningfully past the extracted netlist's own 2.45–2.5 mV/µs edge (+0.3 mV/µs at the lower bound alone). That is far enough past 2.5 mV/µs to justify scoping a corner-grid re-ladder against a real re-route candidate before any layout is drawn — but this control only brackets the edge between 2.8 and 3 mV/µs, it does not locate it, and it says nothing about whether 522.9 fF / 8.9 % of `por_output_chain`'s ΣC is actually drawable (#214 found no single dominant net in this group to widen or shield).

*This section answers only the pre-layout gate-check step 1 of #232's own "Suggested approach" — it does not decide whether a re-route is drawable (step 2) or ratify any spec change (step 3, which needs its own decision record and its own corner-grid ladder). DR-019's 2.30 mV/µs bound is unchanged by this control.*
