2AMLogic/gf180-temp-por/sim/por-output-chain-deglitch/control/dwell_results.md

# por-output-chain-deglitch qualifying-dip dwell sweep — generated, do not edit

Generated by `sim/por-output-chain-deglitch/control/run_dwell_sweep.py` (issue #251). Re-run it to regenerate this file, the decks under `decks/` and the raw ngspice logs under `logs/`. Every number quoted elsewhere for this sweep — the record minted at the value pinned below, `spec/target-spec.md#por-brownout`, DR-027 — is transcribed from here, and from nowhere else.

This is a **control experiment, not a record**: it is overwritten in place on every run, and it substantiates no spec row on its own. The append-only corner-grid evidence for [`por-brownout`](../../../spec/target-spec.md#por-brownout) is the record `sim/por-output-chain-deglitch/` mints at the value pinned here (`sim/README.md`, "Control experiments"). It covers the full 81-point grid, which most controls do not, because the quantity it looks for is a worst-**corner** one.

- ngspice: `ngspice-46 : Circuit level simulation program`
- PDK: `gf180mcuD@c6d73a35f524070e85faff4a6a9eef49553ebc2b` (search_root:~/.volare)
- harness: `0.1.0`
- probe dip: 600 µs (open-ended — the crossing time, not the dip, is what is read)
- stress bias: 91.0251 nA (`sim/por-output-chain-ibias-sharing/`, DR-024); nominal reference arm: 500 nA (DR-005)
- trip point: `PGDG` = 1 V falling, the same threshold `../testbench/tb.json`'s own check is written on

## The pinned value

The rule, fixed in the script before the sweep ran (see its module docstring): `T_dip,min(new)` is the smallest multiple of 5 µs that is at least 1.1× the slowest crossing time measured at the stress bias, across both netlist levels and all 81 points.

- Slowest measured crossing (stress bias): **23.110 µs**
- **`T_dip,min(new)` = 30 µs**
- Realized margin over the slowest corner: **29.8 %** (6.890 µs)

Every one of the 324 (point, netlist, bias) runs reached the trip point inside the 600 µs probe dip — DR-027 §1's reading (the filter is still on its way down when the old 10 µs window closes, not sitting on an asymptotic floor above trip) holds across the whole grid, and §5's contingency is not triggered.

## Part A — crossing time, full grid

How long `POR_RAW` must stay low before `PGDG` falls through 1 V. Nothing in the filter depends on when the dip *ends*, so this crossing time **is** the minimum qualifying-dip duration at that point; Part B confirms that equivalence against finite dips. `PGDG` pre-dip is the initial condition — the filter output settled at the rail — and is there so a run that started from a not-yet-settled filter would be visible rather than silently biasing the answer.

| point | `schematic` stress | `postlayout` stress | `schematic` nominal | `postlayout` nominal | stress/nominal (`postlayout`) |
| --- | ---: | ---: | ---: | ---: | ---: |
| `tt_-40c_2.97v` | 17.78 µs | 15.59 µs | 3.48 µs | 3.13 µs | 4.98× |
| `tt_-40c_3.30v` | 18.09 µs | 15.23 µs | 3.56 µs | 3.07 µs | 4.96× |
| `tt_-40c_3.63v` | 18.34 µs | 14.83 µs | 3.63 µs | 3.00 µs | 4.94× |
| `tt_27c_2.97v` | 15.40 µs | 12.98 µs | 3.02 µs | 2.63 µs | 4.94× |
| `tt_27c_3.30v` | 15.78 µs | 12.74 µs | 3.11 µs | 2.59 µs | 4.92× |
| `tt_27c_3.63v` | 16.10 µs | 12.45 µs | 3.19 µs | 2.55 µs | 4.88× |
| `tt_125c_2.97v` | 12.67 µs | 9.95 µs | 2.47 µs | 2.03 µs | 4.90× |
| `tt_125c_3.30v` | 13.09 µs | 9.81 µs | 2.56 µs | 2.01 µs | 4.88× |
| `tt_125c_3.63v` | 13.47 µs | 9.64 µs | 2.65 µs | 1.99 µs | 4.84× |
| `ff_-40c_2.97v` | 13.73 µs | 11.08 µs | 2.68 µs | 2.23 µs | 4.97× |
| `ff_-40c_3.30v` | 13.99 µs | 10.70 µs | 2.75 µs | 2.16 µs | 4.95× |
| `ff_-40c_3.63v` | 14.20 µs | 10.30 µs | 2.80 µs | 2.10 µs | 4.90× |
| `ff_27c_2.97v` | 11.79 µs | 8.97 µs | 2.31 µs | 1.82 µs | 4.93× |
| `ff_27c_3.30v` | 12.10 µs | 8.70 µs | 2.38 µs | 1.78 µs | 4.89× |
| `ff_27c_3.63v` | 12.37 µs | 8.40 µs | 2.45 µs | 1.73 µs | 4.86× |
| `ff_125c_2.97v` | 9.58 µs | 6.50 µs | 1.86 µs | 1.34 µs | 4.85× |
| `ff_125c_3.30v` | 9.93 µs | 6.33 µs | 1.93 µs | 1.31 µs | 4.83× |
| `ff_125c_3.63v` | 10.25 µs | 6.14 µs | 2.01 µs | 1.28 µs | 4.80× |
| `ss_-40c_2.97v` | 22.42 µs | 20.77 µs | 4.41 µs | 4.17 µs | 4.98× |
| `ss_-40c_3.30v` | 22.80 µs | 20.46 µs | 4.50 µs | 4.12 µs | 4.97× |
| `ss_-40c_3.63v` | 23.11 µs | 20.08 µs | 4.59 µs | 4.06 µs | 4.95× |
| `ss_27c_2.97v` | 19.57 µs | 17.62 µs | 3.86 µs | 3.57 µs | 4.94× |
| `ss_27c_3.30v` | 20.02 µs | 17.43 µs | 3.96 µs | 3.54 µs | 4.92× |
| `ss_27c_3.63v` | 20.41 µs | 17.17 µs | 4.06 µs | 3.50 µs | 4.91× |
| `ss_125c_2.97v` | 16.30 µs | 13.98 µs | 3.20 µs | 2.85 µs | 4.91× |
| `ss_125c_3.30v` | 16.80 µs | 13.89 µs | 3.30 µs | 2.84 µs | 4.89× |
| `ss_125c_3.63v` | 17.25 µs | 13.75 µs | 3.41 µs | 2.82 µs | 4.88× |
| `fs_-40c_2.97v` | 15.69 µs | 13.52 µs | 3.07 µs | 2.72 µs | 4.97× |
| `fs_-40c_3.30v` | 15.98 µs | 13.15 µs | 3.14 µs | 2.66 µs | 4.94× |
| `fs_-40c_3.63v` | 16.22 µs | 12.74 µs | 3.20 µs | 2.59 µs | 4.92× |
| `fs_27c_2.97v` | 13.41 µs | 11.02 µs | 2.63 µs | 2.24 µs | 4.92× |
| `fs_27c_3.30v` | 13.75 µs | 10.77 µs | 2.71 µs | 2.20 µs | 4.90× |
| `fs_27c_3.63v` | 14.06 µs | 10.48 µs | 2.78 µs | 2.15 µs | 4.87× |
| `fs_125c_2.97v` | 10.80 µs | 8.13 µs | 2.10 µs | 1.67 µs | 4.87× |
| `fs_125c_3.30v` | 11.20 µs | 7.98 µs | 2.19 µs | 1.65 µs | 4.84× |
| `fs_125c_3.63v` | 11.55 µs | 7.81 µs | 2.27 µs | 1.62 µs | 4.82× |
| `sf_-40c_2.97v` | 19.91 µs | 17.72 µs | 3.91 µs | 3.55 µs | 4.99× |
| `sf_-40c_3.30v` | 20.25 µs | 17.38 µs | 3.99 µs | 3.50 µs | 4.97× |
| `sf_-40c_3.63v` | 20.53 µs | 16.98 µs | 4.07 µs | 3.44 µs | 4.94× |
| `sf_27c_2.97v` | 17.46 µs | 15.01 µs | 3.43 µs | 3.03 µs | 4.95× |
| `sf_27c_3.30v` | 17.86 µs | 14.78 µs | 3.53 µs | 3.00 µs | 4.93× |
| `sf_27c_3.63v` | 18.21 µs | 14.51 µs | 3.61 µs | 2.96 µs | 4.90× |
| `sf_125c_2.97v` | 14.62 µs | 11.84 µs | 2.86 µs | 2.41 µs | 4.91× |
| `sf_125c_3.30v` | 15.06 µs | 11.72 µs | 2.96 µs | 2.39 µs | 4.90× |
| `sf_125c_3.63v` | 15.47 µs | 11.56 µs | 3.05 µs | 2.37 µs | 4.88× |
| `res_ff_-40c_2.97v` | 17.78 µs | 15.59 µs | 3.48 µs | 3.13 µs | 4.98× |
| `res_ff_-40c_3.30v` | 18.09 µs | 15.23 µs | 3.56 µs | 3.07 µs | 4.96× |
| `res_ff_-40c_3.63v` | 18.34 µs | 14.83 µs | 3.63 µs | 3.00 µs | 4.94× |
| `res_ff_27c_2.97v` | 15.40 µs | 12.98 µs | 3.02 µs | 2.63 µs | 4.94× |
| `res_ff_27c_3.30v` | 15.78 µs | 12.74 µs | 3.11 µs | 2.59 µs | 4.92× |
| `res_ff_27c_3.63v` | 16.10 µs | 12.45 µs | 3.19 µs | 2.55 µs | 4.88× |
| `res_ff_125c_2.97v` | 12.67 µs | 9.95 µs | 2.47 µs | 2.03 µs | 4.90× |
| `res_ff_125c_3.30v` | 13.09 µs | 9.81 µs | 2.56 µs | 2.01 µs | 4.88× |
| `res_ff_125c_3.63v` | 13.47 µs | 9.64 µs | 2.65 µs | 1.99 µs | 4.84× |
| `res_ss_-40c_2.97v` | 17.78 µs | 15.59 µs | 3.48 µs | 3.13 µs | 4.98× |
| `res_ss_-40c_3.30v` | 18.09 µs | 15.23 µs | 3.56 µs | 3.07 µs | 4.96× |
| `res_ss_-40c_3.63v` | 18.34 µs | 14.83 µs | 3.63 µs | 3.00 µs | 4.94× |
| `res_ss_27c_2.97v` | 15.40 µs | 12.98 µs | 3.02 µs | 2.63 µs | 4.94× |
| `res_ss_27c_3.30v` | 15.78 µs | 12.74 µs | 3.11 µs | 2.59 µs | 4.92× |
| `res_ss_27c_3.63v` | 16.10 µs | 12.45 µs | 3.19 µs | 2.55 µs | 4.88× |
| `res_ss_125c_2.97v` | 12.67 µs | 9.95 µs | 2.47 µs | 2.03 µs | 4.90× |
| `res_ss_125c_3.30v` | 13.09 µs | 9.81 µs | 2.56 µs | 2.01 µs | 4.88× |
| `res_ss_125c_3.63v` | 13.47 µs | 9.64 µs | 2.65 µs | 1.99 µs | 4.84× |
| `bjt_ff_-40c_2.97v` | 17.78 µs | 15.59 µs | 3.48 µs | 3.13 µs | 4.98× |
| `bjt_ff_-40c_3.30v` | 18.09 µs | 15.23 µs | 3.56 µs | 3.07 µs | 4.96× |
| `bjt_ff_-40c_3.63v` | 18.34 µs | 14.83 µs | 3.63 µs | 3.00 µs | 4.94× |
| `bjt_ff_27c_2.97v` | 15.40 µs | 12.98 µs | 3.02 µs | 2.63 µs | 4.94× |
| `bjt_ff_27c_3.30v` | 15.78 µs | 12.74 µs | 3.11 µs | 2.59 µs | 4.92× |
| `bjt_ff_27c_3.63v` | 16.10 µs | 12.45 µs | 3.19 µs | 2.55 µs | 4.88× |
| `bjt_ff_125c_2.97v` | 12.67 µs | 9.95 µs | 2.47 µs | 2.03 µs | 4.90× |
| `bjt_ff_125c_3.30v` | 13.09 µs | 9.81 µs | 2.56 µs | 2.01 µs | 4.88× |
| `bjt_ff_125c_3.63v` | 13.47 µs | 9.64 µs | 2.65 µs | 1.99 µs | 4.84× |
| `bjt_ss_-40c_2.97v` | 17.78 µs | 15.59 µs | 3.48 µs | 3.13 µs | 4.98× |
| `bjt_ss_-40c_3.30v` | 18.09 µs | 15.23 µs | 3.56 µs | 3.07 µs | 4.96× |
| `bjt_ss_-40c_3.63v` | 18.34 µs | 14.83 µs | 3.63 µs | 3.00 µs | 4.94× |
| `bjt_ss_27c_2.97v` | 15.40 µs | 12.98 µs | 3.02 µs | 2.63 µs | 4.94× |
| `bjt_ss_27c_3.30v` | 15.78 µs | 12.74 µs | 3.11 µs | 2.59 µs | 4.92× |
| `bjt_ss_27c_3.63v` | 16.10 µs | 12.45 µs | 3.19 µs | 2.55 µs | 4.88× |
| `bjt_ss_125c_2.97v` | 12.67 µs | 9.95 µs | 2.47 µs | 2.03 µs | 4.90× |
| `bjt_ss_125c_3.30v` | 13.09 µs | 9.81 µs | 2.56 µs | 2.01 µs | 4.88× |
| `bjt_ss_125c_3.63v` | 13.47 µs | 9.64 µs | 2.65 µs | 1.99 µs | 4.84× |

The last column is the measured 1/`IBIAS` scaling DR-027 §3 argues from. The current ratio is 5.49× (500 nA / 91.0251 nA); a measured dwell ratio near it means the deglitch node really is a capacitor discharged by the bias, which is the premise the estimate rested on.

### Where the sweep binds

- `schematic`: slowest `ss_-40c_3.63v` (23.11 µs), `ss_-40c_3.30v` (22.80 µs), `ss_-40c_2.97v` (22.42 µs); fastest `ff_125c_2.97v` (9.58 µs).
- `postlayout`: slowest `ss_-40c_2.97v` (20.77 µs), `ss_-40c_3.30v` (20.46 µs), `ss_-40c_3.63v` (20.08 µs); fastest `ff_125c_3.63v` (6.14 µs).

## Part B — finite-width ladder at the slowest points

The parent testbench's own check (`PGDG` reaches 1 V *within the dip window itself*) re-applied at a ladder of finite dip widths, at the points Part A found slowest. `trips` must appear exactly from the first width at or above that point's Part A crossing time — that is what makes the crossing time a `T_dip,min` rather than merely a number measured under a long dip.

| variant | point | Part A crossing | 10 µs | 15 µs | 20 µs | 25 µs | 30 µs | 35 µs | 40 µs | 50 µs |
| --- | --- | ---: | ---: | ---: | ---: | ---: | ---: | ---: | ---: | ---: |
| `schematic` | `ss_-40c_3.63v` | 23.11 µs | 3.63 V | 3.63 V | 3.52 V | **trips** (0.08 V) | **trips** (0.03 V) | **trips** (0.01 V) | **trips** (0.01 V) | **trips** (0.00 V) |
| `schematic` | `ss_-40c_3.30v` | 22.80 µs | 3.30 V | 3.30 V | 3.21 V | **trips** (0.06 V) | **trips** (0.02 V) | **trips** (0.01 V) | **trips** (0.00 V) | **trips** (0.00 V) |
| `schematic` | `ss_-40c_2.97v` | 22.42 µs | 2.97 V | 2.97 V | 2.90 V | **trips** (0.03 V) | **trips** (0.01 V) | **trips** (0.00 V) | **trips** (0.00 V) | **trips** (0.00 V) |
| `postlayout` | `ss_-40c_2.97v` | 20.77 µs | 2.97 V | 2.96 V | 2.55 V | **trips** (0.02 V) | **trips** (0.01 V) | **trips** (0.00 V) | **trips** (0.00 V) | **trips** (0.00 V) |
| `postlayout` | `ss_-40c_3.30v` | 20.46 µs | 3.30 V | 3.28 V | 2.47 V | **trips** (0.03 V) | **trips** (0.01 V) | **trips** (0.01 V) | **trips** (0.00 V) | **trips** (0.00 V) |
| `postlayout` | `ss_-40c_3.63v` | 20.08 µs | 3.63 V | 3.58 V | 1.37 V | **trips** (0.04 V) | **trips** (0.02 V) | **trips** (0.01 V) | **trips** (0.01 V) | **trips** (0.00 V) |

Cells show the `PGDG` floor reached inside the dip; **trips** marks a width at which it reaches the 1 V trip point, i.e. a width at which the parent testbench's `por-brownout` check passes at that point. The outgoing `T_dip,min` is the 10 µs column.
