2AMLogic/gf180-temp-por/sim/bias-core-designer-check/control/ramp_feedthrough_results.md

# `bias_core` ramp-rate feedthrough coefficient — full-grid control results

**Generated by `run_ramp_feedthrough.py`. Do not edit — re-run it.**
Every number below is read out of `logs/` by that script; nothing here
is transcribed by hand. This is a SECOND control under this
directory (`sim/README.md`'s "one `control/` may hold more than one
control" rule) — `run_starved_window.py`'s `results.md` diagnoses the
brownout-recovery window; this one diagnoses the ramp-rate feedthrough
coefficient `design/bias_core.md`'s "Ramp-rate feedthrough" note
quotes. Its own `decks/`/`logs/` filenames are `ft_`-prefixed so they
never collide with that script's outputs in this shared directory.

- PDK: `gf180mcuD` @ `c6d73a35f524070e85faff4a6a9eef49553ebc2b`
- Harness version: `0.1.0`
- Solver options (from `../testbench/tb.json`): `reltol=1e-4`, `abstol=1e-15`, `vntol=1e-8`
- DUT netlists: `design/netlist/bias_core.spice` (schematic), `layout/postlayout/bias_core.spice` (extracted)
- Corner grid: the full 81-point PVT grid (9 process corners x 3 temperatures x 3 supplies), per `sim/README.md` -- a deliberate widening of the "control" convention's usual one/two-point scope; see this script's own module docstring for why.
- `tramp` values: 4 ms and 16 ms -- chosen to reproduce `sim/por-vth/control/results.md` Arm A's own 407.5 / 101.9 V/s rungs at `vdd_val` = 3.63 V, for direct cross-check.
- Motivating measurement: `design/bias_core.md`'s "Ramp-rate feedthrough" note (**~2.4 us** x rate, at `tt`/27C) vs. `sim/por-vth/control/results.md`'s **~49 us** at `ss`/-40C (issue #208).

## What the columns are

Two `tramp` points per (netlist, corner) give a rate (V/s) pair per direction. `sim/por-vth/control/results.md` already demonstrated the displacement is proportional to rate through the origin (intercept -0.097/-0.096 mV against tens-of-mV signals, at `ss`/-40C on both netlists) -- so the SECANT slope between this control's two points is the coefficient, reported as an equivalent time constant in us (`slope_mV_per_(V/s) * 1000`), matching that control's own unit convention (0.04861 mV/(V/s) -> 49 us).

## schematic — 81/81 corners

- Up-ramp coefficient: **17.31 … 47.45 us** (worst: `ss_-40c_2.97v` at 47.45 us, best: `ff_125c_3.63v` at 17.31 us)
- Down-ramp coefficient magnitude: **17.54 … 51.08 us** (worst: `ss_-40c_3.63v` at -51.08 us)

| corner | temp (C) | VDD (V) | tau_up (us) | tau_dn (us) | VREF settled (V) |
|---|---:|---:|---:|---:|---:|
| `bjt_ff_-40c_2.97v` | -40 | 2.97 | 33.98 | -35.24 | 1.193240 |
| `bjt_ff_-40c_3.30v` | -40 | 3.30 | 33.76 | -35.49 | 1.193290 |
| `bjt_ff_-40c_3.63v` | -40 | 3.63 | 33.54 | -35.76 | 1.193160 |
| `bjt_ff_27c_2.97v` | 27 | 2.97 | 29.80 | -30.57 | 1.193140 |
| `bjt_ff_27c_3.30v` | 27 | 3.30 | 29.70 | -30.69 | 1.193160 |
| `bjt_ff_27c_3.63v` | 27 | 3.63 | 29.55 | -30.85 | 1.192780 |
| `bjt_ff_125c_2.97v` | 125 | 2.97 | 25.90 | -26.28 | 1.189030 |
| `bjt_ff_125c_3.30v` | 125 | 3.30 | 25.81 | -26.38 | 1.188890 |
| `bjt_ff_125c_3.63v` | 125 | 3.63 | 25.75 | -26.44 | 1.187590 |
| `bjt_ss_-40c_2.97v` | -40 | 2.97 | 33.98 | -35.24 | 1.204340 |
| `bjt_ss_-40c_3.30v` | -40 | 3.30 | 33.76 | -35.49 | 1.204390 |
| `bjt_ss_-40c_3.63v` | -40 | 3.63 | 33.54 | -35.76 | 1.204270 |
| `bjt_ss_27c_2.97v` | 27 | 2.97 | 29.80 | -30.52 | 1.208300 |
| `bjt_ss_27c_3.30v` | 27 | 3.30 | 29.66 | -30.69 | 1.208340 |
| `bjt_ss_27c_3.63v` | 27 | 3.63 | 29.55 | -30.85 | 1.207990 |
| `bjt_ss_125c_2.97v` | 125 | 2.97 | 25.84 | -26.28 | 1.210240 |
| `bjt_ss_125c_3.30v` | 125 | 3.30 | 25.81 | -26.38 | 1.210130 |
| `bjt_ss_125c_3.63v` | 125 | 3.63 | 25.72 | -26.44 | 1.208950 |
| `ff_-40c_2.97v` | -40 | 2.97 | 22.71 | -23.26 | 1.199040 |
| `ff_-40c_3.30v` | -40 | 3.30 | 22.61 | -23.34 | 1.199090 |
| `ff_-40c_3.63v` | -40 | 3.63 | 22.48 | -23.46 | 1.198960 |
| `ff_27c_2.97v` | 27 | 2.97 | 19.96 | -20.29 | 1.200610 |
| `ff_27c_3.30v` | 27 | 3.30 | 19.94 | -20.35 | 1.200640 |
| `ff_27c_3.63v` | 27 | 3.63 | 19.83 | -20.45 | 1.200270 |
| `ff_125c_2.97v` | 125 | 2.97 | 17.37 | -17.54 | 1.198990 |
| `ff_125c_3.30v` | 125 | 3.30 | 17.35 | -17.60 | 1.198860 |
| `ff_125c_3.63v` | 125 | 3.63 | 17.31 | -17.64 | 1.197620 |
| `fs_-40c_2.97v` | -40 | 2.97 | 34.47 | -35.74 | 1.197750 |
| `fs_-40c_3.30v` | -40 | 3.30 | 34.22 | -36.02 | 1.197800 |
| `fs_-40c_3.63v` | -40 | 3.63 | 34.00 | -36.29 | 1.197680 |
| `fs_27c_2.97v` | 27 | 2.97 | 30.24 | -31.01 | 1.199330 |
| `fs_27c_3.30v` | 27 | 3.30 | 30.11 | -31.14 | 1.199370 |
| `fs_27c_3.63v` | 27 | 3.63 | 29.94 | -31.31 | 1.199010 |
| `fs_125c_2.97v` | 125 | 2.97 | 26.23 | -26.61 | 1.197720 |
| `fs_125c_3.30v` | 125 | 3.30 | 26.13 | -26.75 | 1.197610 |
| `fs_125c_3.63v` | 125 | 3.63 | 26.08 | -26.80 | 1.196380 |
| `res_ff_-40c_2.97v` | -40 | 2.97 | 26.17 | -26.94 | 1.203550 |
| `res_ff_-40c_3.30v` | -40 | 3.30 | 26.09 | -27.08 | 1.203600 |
| `res_ff_-40c_3.63v` | -40 | 3.63 | 25.91 | -27.26 | 1.203480 |
| `res_ff_27c_2.97v` | 27 | 2.97 | 23.04 | -23.42 | 1.206810 |
| `res_ff_27c_3.30v` | 27 | 3.30 | 22.93 | -23.51 | 1.206850 |
| `res_ff_27c_3.63v` | 27 | 3.63 | 22.84 | -23.62 | 1.206500 |
| `res_ff_125c_2.97v` | 125 | 2.97 | 20.01 | -20.23 | 1.207680 |
| `res_ff_125c_3.30v` | 125 | 3.30 | 19.94 | -20.27 | 1.207580 |
| `res_ff_125c_3.63v` | 125 | 3.63 | 19.89 | -20.32 | 1.206440 |
| `res_ss_-40c_2.97v` | -40 | 2.97 | 41.51 | -43.49 | 1.193240 |
| `res_ss_-40c_3.30v` | -40 | 3.30 | 41.19 | -43.90 | 1.193290 |
| `res_ss_-40c_3.63v` | -40 | 3.63 | 40.90 | -44.34 | 1.193150 |
| `res_ss_27c_2.97v` | 27 | 2.97 | 36.45 | -37.61 | 1.193510 |
| `res_ss_27c_3.30v` | 27 | 3.30 | 36.27 | -37.83 | 1.193540 |
| `res_ss_27c_3.63v` | 27 | 3.63 | 36.09 | -38.05 | 1.193150 |
| `res_ss_125c_2.97v` | 125 | 2.97 | 31.62 | -32.27 | 1.189970 |
| `res_ss_125c_3.30v` | 125 | 3.30 | 31.51 | -32.41 | 1.189820 |
| `res_ss_125c_3.63v` | 125 | 3.63 | 31.41 | -32.49 | 1.188490 |
| `sf_-40c_2.97v` | -40 | 2.97 | 33.54 | -34.75 | 1.197730 |
| `sf_-40c_3.30v` | -40 | 3.30 | 33.31 | -34.99 | 1.197780 |
| `sf_-40c_3.63v` | -40 | 3.63 | 33.08 | -35.27 | 1.197640 |
| `sf_27c_2.97v` | 27 | 2.97 | 29.42 | -30.13 | 1.199300 |
| `sf_27c_3.30v` | 27 | 3.30 | 29.29 | -30.28 | 1.199330 |
| `sf_27c_3.63v` | 27 | 3.63 | 29.15 | -30.40 | 1.198950 |
| `sf_125c_2.97v` | 125 | 2.97 | 25.51 | -25.95 | 1.197680 |
| `sf_125c_3.30v` | 125 | 3.30 | 25.44 | -26.01 | 1.197550 |
| `sf_125c_3.63v` | 125 | 3.63 | 25.42 | -26.11 | 1.196270 |
| `ss_-40c_2.97v` | -40 | 2.97 | 47.45 | -49.98 | 1.199870 |
| `ss_-40c_3.30v` | -40 | 3.30 | 47.02 | -50.54 | 1.199920 |
| `ss_-40c_3.63v` | -40 | 3.63 | 46.59 | -51.08 | 1.199800 |
| `ss_27c_2.97v` | 27 | 2.97 | 41.57 | -43.05 | 1.202530 |
| `ss_27c_3.30v` | 27 | 3.30 | 41.27 | -43.32 | 1.202570 |
| `ss_27c_3.63v` | 27 | 3.63 | 41.03 | -43.62 | 1.202210 |
| `ss_125c_2.97v` | 125 | 2.97 | 35.96 | -36.78 | 1.202540 |
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
 Both controls should read the same coefficient at that shared
 point, to within run-to-run/precision noise:

| netlist | this control (tau_up / tau_dn, us) | `por-vth` control (~49 us, both directions) |
|---|---:|---:|
| schematic | 46.59 / -51.08 | ~49 |
| postlayout | 46.53 / -51.27 | ~49 |
