2AMLogic/gf180-temp-por/sim/por-vth/control/rate_selection_results.md

# `por-vth` ramp-rate SELECTION control — results

**Generated by `run_rate_ladder.py`. Do not edit — re-run it.** Every
number below is read out of `logs/` by that script; nothing here is
transcribed by hand. This is the SECOND control under this
directory (`sim/README.md`'s "one `control/` may hold more than one
control" rule) — `run_ramp_rate_probe.py`'s `results.md` (issue
#187/#218, DR-021) already root-causes *why* the post-layout reading
exceeded its ceiling; this one measures the two specific rates
(242.5 / 121.25 V/s) the fixed production stimulus now uses, which
are not rungs on that script's dyadic ladder. Its own `decks/`/`logs/`
filenames are `sel_`-prefixed so they never collide with that
script's outputs in this shared directory.

- PVT point: `ss` / -40 °C — the binding corner of `../records/20260811-073945-12473c3.md` (one corner: a control is not corner evidence, see `sim/README.md`)
- PDK: `gf180mcuD` @ `c6d73a35f524070e85faff4a6a9eef49553ebc2b`
- Harness version: `0.1.0`
- Solver options (from `../testbench/tb.json`): `reltol=1e-5`, `abstol=1e-15`, `vntol=1e-9`
- DUT netlists: `layout/postlayout/temp_por_top.spice` (extracted), `design/netlist/temp_por_top.spice` (schematic)
- Decision this control informs: `sim/por-vth/testbench/stimulus.spice`'s chosen `dvdd_dt_v_per_s` (issue #206)
- Companion control: `sim/por-vth/control/results.md` (`run_ramp_rate_probe.py`, issue #187/#218, DR-021) -- the decomposition this selection builds on.

## A/B — ramp-rate ladder at the binding corner, VDD = 3.63 V

One variable: how long each quasi-static segment takes. The 407.5 V/s row **is** the historical parent deck (`tramp` = 4 ms) and reproduces its record: 261.092 mV (extracted), 248.740/248.741 mV (schematic).

### postlayout

| tramp | dVDD/dt | VPOR↑ | VPOR↓ | V_hys | VREF (settled) |
|---:|---:|---:|---:|---:|---:|
| 4.000 ms | 407.50 V/s | 2.64873 V | 2.38764 V | **261.090 mV** | 1.199870 V |
| 6.722 ms | 242.50 V/s | 2.62809 V | 2.41243 V | **215.660 mV** | 1.199870 V |
| 13.443 ms | 121.25 V/s | 2.61201 V | 2.43118 V | **180.830 mV** | 1.199870 V |
| 26.887 ms | 60.62 V/s | 2.60353 V | 2.44102 V | **162.510 mV** | 1.199870 V |

Zero-rate limit (extrapolated from the two slowest rungs): **144.190 mV**, local slope **0.3022 mV/(V/s)**.

### schematic

| tramp | dVDD/dt | VPOR↑ | VPOR↓ | V_hys | VREF (settled) |
|---:|---:|---:|---:|---:|---:|
| 4.000 ms | 407.50 V/s | 2.64453 V | 2.39579 V | **248.740 mV** | 1.199800 V |
| 6.722 ms | 242.50 V/s | 2.62504 V | 2.41819 V | **206.850 mV** | 1.199800 V |
| 13.443 ms | 121.25 V/s | 2.61014 V | 2.43460 V | **175.540 mV** | 1.199800 V |
| 26.887 ms | 60.62 V/s | 2.60246 V | 2.44284 V | **159.620 mV** | 1.199800 V |

Zero-rate limit (extrapolated from the two slowest rungs): **143.700 mV**, local slope **0.2626 mV/(V/s)**.

## C — supply swept at ONE ramp rate (242.5 V/s), extracted netlist

One variable: the supply. The historical parent deck could not do this -- its fixed 4 ms ramp made rate a function of supply -- so this arm stretches `tramp` instead, to hold dVDD/dt at the parent grid's own slowest value (its native 2.97 V rate).

| VDD | tramp | dVDD/dt | VPOR↑ | VPOR↓ | V_hys |
|---|---:|---:|---:|---:|---:|
| 2.97 V | 4.000 ms | 242.50 V/s | **2.62809 V** | 2.41671 V | **211.380 mV** |
| 3.30 V | 5.361 ms | 242.50 V/s | **2.62809 V** | 2.41243 V | **215.660 mV** |
| 3.63 V | 6.722 ms | 242.50 V/s | **2.62809 V** | 2.41243 V | **215.660 mV** |

Rate-matched, `VPOR↑` spreads **0.000 mV** and `V_hys` spreads **4.280 mV** over the whole ±10 % supply window, against the historical parent record's 20.64 mV / 49.710 mV (`vpor_rise_v` 2.62809-2.64873 V, `v_hys_mv` 211.382-261.092 mV, same corner, fixed-4ms deck).
