2AMLogic/gf180-temp-por/sim/bias-core-startup/control/dip_results.md

# `ok_bo_dip_mv` dead-rail decay control -- generated, do not edit

Generated by `sim/bias-core-startup/control/run_ok_dip_decay.py`. Re-run it to
regenerate this file, the decks under `decks/` and the raw ngspice logs under
`logs/`. The numbers quoted in `design/bias_core.md` and in the issue #185 PR
are transcribed from here, and from nowhere else.

One variable: the DUT netlist (`design/netlist/bias_core.spice` vs.
`layout/postlayout/bias_core.spice`). Same fragment, same PDK, same corner
sections, same solver tolerances, same process. The dead-rail window is
stretched from the parent testbench's 3 ms to 17 ms (33 ->
50 ms) so the discharge is sampled as a CURVE rather than
at the single 35 ms point `ok_bo_dip_mv` uses.

ngspice: ngspice-46 : Circuit level simulation program · PDK: gf180mcuD@c6d73a35f524070e85faff4a6a9eef49553ebc2b · harness 0.1.0
· VDD before the collapse: 3.63 V (the parent testbench's supply axis is
degenerate here -- see `ok_dip_decay.spice`).

## V(BIAS_OK) with the rail held at 0 V

`t - 33 ms` is time since the rail reached 0 V. The row marked **parent** is the
instant `ok_bo_dip_mv` samples; the parent testbench's window ends at
36 ms and everything below that row is outside it.

### ss / -40 C  (the failing family)

| t | t − 33 ms | schematic export | klt-extracted | ratio |
| ---: | ---: | ---: | ---: | ---: |
| 33.5 ms | 0.5 ms | 53.56 mV | 327.8 mV | 6.12x |
| 34 ms | 1 ms | 45.64 mV | 317.6 mV | 6.96x |
| 35 ms **(parent)** | 2 ms | 33.63 mV | 303.4 mV | 9.02x |
| 36 ms | 3 ms | 25.6 mV | 291.7 mV | 11.4x |
| 38 ms | 5 ms | 16 mV | 270.9 mV | 16.9x |
| 40 ms | 7 ms | 10.81 mV | 252.1 mV | 23.3x |
| 45 ms | 12 ms | 5.356 mV | 210.8 mV | 39.4x |
| 50 ms | 17 ms | 3.554 mV | 176.4 mV | 49.6x |

V(VREF) on the same DUT over the same window, as the control that the *core* is discharging the same way on both netlists:

| t | schematic export | klt-extracted |
| ---: | ---: | ---: |
| 33.5 ms | 0.53176 V | 0.53036 V |
| 34 ms | 0.52643 V | 0.5259 V |
| 35 ms | 0.51838 V | 0.51888 V |
| 36 ms | 0.51228 V | 0.51341 V |
| 38 ms | 0.5031 V | 0.50499 V |
| 40 ms | 0.49609 V | 0.49848 V |
| 45 ms | 0.48304 V | 0.48628 V |
| 50 ms | 0.47313 V | 0.47701 V |

### tt / +27 C  (reference)

| t | t − 33 ms | schematic export | klt-extracted | ratio |
| ---: | ---: | ---: | ---: | ---: |
| 33.5 ms | 0.5 ms | -27.56 mV | -0.7336 mV | 0.0266x |
| 34 ms | 1 ms | -17.09 mV | -0.1594 mV | 0.00933x |
| 35 ms **(parent)** | 2 ms | -7.668 mV | -0.03528 mV | 0.0046x |
| 36 ms | 3 ms | -3.764 mV | -0.02831 mV | 0.00752x |
| 38 ms | 5 ms | -1.07 mV | -0.02804 mV | 0.0262x |
| 40 ms | 7 ms | -0.4061 mV | -0.02934 mV | n/a (both < 1 mV) |
| 45 ms | 12 ms | -0.17 mV | -0.03435 mV | n/a (both < 1 mV) |
| 50 ms | 17 ms | -0.15 mV | -0.0406 mV | n/a (both < 1 mV) |

V(VREF) on the same DUT over the same window, as the control that the *core* is discharging the same way on both netlists:

| t | schematic export | klt-extracted |
| ---: | ---: | ---: |
| 33.5 ms | 0.21779 V | 0.24372 V |
| 34 ms | 0.21046 V | 0.23386 V |
| 35 ms | 0.20453 V | 0.22518 V |
| 36 ms | 0.20122 V | 0.21999 V |
| 38 ms | 0.19644 V | 0.21262 V |
| 40 ms | 0.19257 V | 0.20701 V |
| 45 ms | 0.18471 V | 0.19661 V |
| 50 ms | 0.17838 V | 0.18895 V |

## What this settles

1. **The extracted node is not stuck.** Its discharge at ss/-40 C is monotonically falling across all 8 samples: confirmed, 327.8 mV at +0.5 ms down to 176.4 mV at +17 ms. It is the same monotonic discharge as the schematic export, on a longer time constant -- not a held stale valid.
2. **The time constant, not the endpoint, is what moved.** At the parent testbench's own sample instant the two netlists read 33.63 mV (schematic) and 303.4 mV (extracted), a factor of 9.02; the extracted node needs roughly the whole 17 ms window to reach the level the schematic export reaches in 2 ms.
3. **The core's own discharge is not what moved.** Over the same window V(VREF) on the same DUT differs between the two netlists by at most 26 mV anywhere on the grid sampled here (3.9 mV at ss/-40 C, the failing family), against a `BIAS_OK` difference that reaches 270 mV at the same instant and the same corner. The reference core gives up its charge at essentially the same rate on both netlists; what changed by an order of magnitude is the `BIAS_OK`/`NOKX` output net's own parasitic RC. (At tt/+27 C both `BIAS_OK` readings are sub-millivolt on both netlists -- that corner is a reference point showing the check has nothing to measure where it passes, not a second data point about the mechanism.)
