2AMLogic/gf180-temp-por/sim/por-brownout-slew/control/postlayout_margin_results.md

# Post-layout deglitch-race margin at the ratified bound — results

**Generated by `run_postlayout_margin.py`. Do not edit — re-run it.** Every number below is read out of `logs/pl-*.log` by that script; nothing here is transcribed by hand.

The post-layout counterpart of `results.md`'s (#74) event-timeline margin column, at the binding family `ss` / −40 °C, for the five rungs at and around `spec/target-spec.md#por-brownout` clause (c)'s ratified `dVDD/dt|fall,max = 3.4 mV/µs`. See this script's module docstring for why the schematic arm is re-run here rather than quoted.

PDK `gf180mcuD` @ `c6d73a35f524070e85faff4a6a9eef49553ebc2b`, harness 0.1.0. `sch` = `design/netlist/temp_por_top.spice`; `ext` = `layout/postlayout/temp_por_top.spice` (#82/PR #180), which carries `layout/postlayout/AUDIT.md`'s `temp_por_top` caveats — 238 drawn devices, 1 ideal (`temp_core`'s undrawn `XCC`, #177, not on any node in this path).

## Margin: dip window close − `RESETn` valid-low

All times are µs after the dip starts. *window closes* is `edge + 50 µs dwell`, the end of the window `../testbench/tb.json` measures `resetn_ratio_min_in_dip` over — so a positive margin is a PASS at that point and a negative one (or a `RESETn` that never reaches valid-low) is the FAIL the grid records.

| slew (mV/µs) | supply | arm | window closes | `POR_RAW` asserts | `PGDG` falls | `RESETn` valid-low | margin | Δ margin (ext − sch) |
|---:|---:|---|---:|---:|---:|---:|---:|---:|
| 2.3 | 2.97 V | sch | 906.5 | 69.2 | 516.1 | 517.2 | +389.3 | — |
| 2.3 | 2.97 V | ext | 906.5 | 147.2 | 682.9 | 696.7 | +209.8 | -179.5 |
| 2.3 | 3.30 V | sch | 1050.0 | 69.6 | 598.8 | 600.1 | +449.9 | — |
| 2.3 | 3.30 V | ext | 1050.0 | 149.0 | 743.9 | 746.9 | +303.1 | -146.8 |
| 2.3 | 3.63 V | sch | 1193.5 | 70.2 | 670.5 | 671.9 | +521.6 | — |
| 2.3 | 3.63 V | ext | 1193.5 | 150.3 | 816.5 | 817.8 | +375.7 | -145.9 |
| 2.4 | 2.97 V | sch | 870.8 | 68.4 | 507.8 | 508.9 | +361.9 | — |
| 2.4 | 2.97 V | ext | 870.8 | 144.7 | 713.4 | 751.2 | +119.6 | -242.3 |
| 2.4 | 3.30 V | sch | 1008.3 | 68.9 | 590.3 | 591.5 | +416.8 | — |
| 2.4 | 3.30 V | ext | 1008.3 | 146.2 | 738.9 | 743.8 | +264.5 | -152.3 |
| 2.4 | 3.63 V | sch | 1145.8 | 69.2 | 663.6 | 664.9 | +480.9 | — |
| 2.4 | 3.63 V | ext | 1145.8 | 147.0 | 804.5 | 806.1 | +339.7 | -141.2 |
| 2.45 | 2.97 V | sch | 854.1 | 68.1 | 503.8 | 504.9 | +349.2 | — |
| 2.45 | 2.97 V | ext | 854.1 | 144.0 | 750.2 | 824.4 | +29.7 | -319.5 |
| 2.45 | 3.30 V | sch | 988.8 | 68.3 | 585.9 | 587.0 | +401.8 | — |
| 2.45 | 3.30 V | ext | 988.8 | 145.1 | 739.8 | 746.4 | +242.4 | -159.4 |
| 2.45 | 3.63 V | sch | 1123.5 | 68.7 | 660.0 | 661.3 | +462.2 | — |
| 2.45 | 3.63 V | ext | 1123.5 | 145.8 | 799.4 | 801.1 | +322.4 | -139.8 |
| 2.5 | 2.97 V | sch | 838.0 | 67.6 | 500.0 | 501.1 | +336.9 | — |
| 2.5 | 2.97 V | ext | 838.0 | 143.5 | 813.0 | 882.8 | -44.8 **FAIL** | -381.7 |
| 2.5 | 3.30 V | sch | 970.0 | 67.9 | 581.7 | 582.8 | +387.2 | — |
| 2.5 | 3.30 V | ext | 970.0 | 144.2 | 743.9 | 753.4 | +216.6 | -170.6 |
| 2.5 | 3.63 V | sch | 1102.0 | 68.4 | 656.4 | 657.7 | +444.3 | — |
| 2.5 | 3.63 V | ext | 1102.0 | 144.6 | 794.9 | 796.9 | +305.1 | -139.2 |
| 3.4 | 2.97 V | sch | 629.4 | 74.1 | 504.4 | 520.6 | +108.8 | — |
| 3.4 | 2.97 V | ext | 629.4 | 1109.6 | 1158.0 | 1158.0 | -528.6 **FAIL** | -637.4 |
| 3.4 | 3.30 V | sch | 726.5 | 72.6 | 541.6 | 545.5 | +181.0 | — |
| 3.4 | 3.30 V | ext | 726.5 | 1258.2 | **never** | **never** | — **FAIL** | — |
| 3.4 | 3.63 V | sch | 823.5 | 71.3 | 601.0 | 602.6 | +220.9 | — |
| 3.4 | 3.63 V | ext | 823.5 | 1342.1 | **never** | **never** | — **FAIL** | — |

## The state behind the verdict

`V_sg` (= VDD − `PG`) is the overdrive on `bias_core`'s PMOS mirror bank — the state variable [DR-011](../../../spec/decision-records/DR-011-brownout-falling-slew-limit.md) measures its starved-loop collapse on, where a NEGATIVE value means the bank is driven fully off and every bias below it is dead. `ndg_r_max` is how far `por_output_chain`'s deglitch ramp actually got inside the window (≈0.5–0.7 is the level the PASS rows cross; 0 means it never moved); `rst_r_min` is the grid's own checked discriminator over the same window, bounded at 0.1.

| slew (mV/µs) | supply | arm | min `V_sg` (mV) | peak `NDG`/VDD | min `POR_RAW`/VDD | min `BIAS_OK`/VDD | min `RESETn`/VDD | grid verdict |
|---:|---:|---|---:|---:|---:|---:|---:|---|
| 2.3 | 2.97 V | sch | +647.2 | 0.808 | -0.0040 | -0.0000 | -0.0000 | PASS |
| 2.3 | 2.97 V | ext | +643.4 | 0.640 | -0.0001 | -0.0000 | -0.0000 | PASS |
| 2.3 | 3.30 V | sch | +647.1 | 0.839 | -0.0038 | -0.0000 | -0.0000 | PASS |
| 2.3 | 3.30 V | ext | +645.6 | 0.687 | -0.0001 | -0.0000 | -0.0000 | PASS |
| 2.3 | 3.63 V | sch | +648.4 | 0.867 | -0.0037 | -0.0000 | -0.0000 | PASS |
| 2.3 | 3.63 V | ext | +645.0 | 0.738 | -0.0001 | -0.0000 | -0.0000 | PASS |
| 2.4 | 2.97 V | sch | +644.0 | 0.794 | -0.0038 | -0.0000 | -0.0000 | PASS |
| 2.4 | 2.97 V | ext | +636.8 | 0.622 | -0.0001 | -0.0000 | -0.0000 | PASS |
| 2.4 | 3.30 V | sch | +643.8 | 0.826 | -0.0037 | -0.0000 | -0.0000 | PASS |
| 2.4 | 3.30 V | ext | +637.6 | 0.669 | -0.0001 | -0.0000 | -0.0000 | PASS |
| 2.4 | 3.63 V | sch | +643.8 | 0.855 | -0.0038 | -0.0000 | -0.0000 | PASS |
| 2.4 | 3.63 V | ext | +638.1 | 0.722 | -0.0001 | -0.0000 | -0.0000 | PASS |
| 2.45 | 2.97 V | sch | +640.7 | 0.787 | -0.0037 | -0.0000 | -0.0000 | PASS |
| 2.45 | 2.97 V | ext | +625.5 | 0.612 | -0.0001 | -0.0000 | -0.0000 | PASS |
| 2.45 | 3.30 V | sch | +640.1 | 0.819 | -0.0038 | -0.0000 | -0.0000 | PASS |
| 2.45 | 3.30 V | ext | +625.0 | 0.659 | -0.0001 | -0.0000 | -0.0000 | PASS |
| 2.45 | 3.63 V | sch | +639.1 | 0.850 | -0.0038 | -0.0000 | -0.0000 | PASS |
| 2.45 | 3.63 V | ext | +626.4 | 0.713 | -0.0001 | -0.0000 | -0.0000 | PASS |
| 2.5 | 2.97 V | sch | +632.5 | 0.781 | -0.0037 | -0.0000 | -0.0000 | PASS |
| 2.5 | 2.97 V | ext | +564.5 | 0.601 | -0.0001 | -0.0000 | 0.9987 | **FAIL** |
| 2.5 | 3.30 V | sch | +631.1 | 0.815 | -0.0038 | -0.0000 | -0.0000 | PASS |
| 2.5 | 3.30 V | ext | +560.9 | 0.649 | -0.0001 | -0.0000 | -0.0000 | PASS |
| 2.5 | 3.63 V | sch | +632.5 | 0.843 | -0.0038 | -0.0000 | -0.0000 | PASS |
| 2.5 | 3.63 V | ext | +563.2 | 0.704 | -0.0001 | -0.0000 | -0.0000 | PASS |
| 3.4 | 2.97 V | sch | +22.7 | 0.626 | -0.0035 | -0.0402 | -0.0000 | PASS |
| 3.4 | 2.97 V | ext | -100.5 | 0.000 | 0.9990 | 0.9990 | 0.9986 | **FAIL** |
| 3.4 | 3.30 V | sch | -85.8 | 0.670 | -0.0036 | -0.0609 | -0.0001 | PASS |
| 3.4 | 3.30 V | ext | -252.5 | 0.000 | 0.9990 | 0.9990 | 0.9987 | **FAIL** |
| 3.4 | 3.63 V | sch | -116.1 | 0.706 | -0.0036 | -0.0627 | -0.0000 | PASS |
| 3.4 | 3.63 V | ext | -297.5 | 0.000 | 0.9990 | 0.9990 | 0.9987 | **FAIL** |
