2AMLogic/gf180-temp-por/sim/por-brownout/control/recovery_results.md

# `por-brownout` recovery-edge control — results

**Generated by `run_recovery_reassert.py`. Do not edit — re-run it.** Every number below is read out of `logs/` by that script; nothing here is transcribed by hand.

Diagnosis of the two *incidental* numbers that moved between `../records/20260801-233807-32fbaa0.md` and `../records/20260811-065930-35a87a6.md`: the `t_reassert_us` slip and the `ss_-40c_2.97v` ERROR. Those two records differ by **two** changes, not one — `XMRLK` ([DR-016](../../../spec/decision-records/DR-016-por-ramp-rate-chatter-release-latch.md), #56) landed between them, and it is the entire textual difference between the `pre` and `sch` fragments below — so this control adds the missing third arm and attributes each delta to one of them. See this script's module docstring for why neither number is a bound this deck is entitled to pass — its 1 µs dip edge is ~580× faster than `spec/target-spec.md#por-brownout` clause (c)'s ratified `dVDD/dt|fall,max = 3.40 mV/µs`, so re-assertion here is explicitly not guaranteed by [DR-011](../../../spec/decision-records/DR-011-brownout-falling-slew-limit.md).

PDK `gf180mcuD` @ `c6d73a35f524070e85faff4a6a9eef49553ebc2b`, harness 0.1.0. All three arms share one stimulus, one corner grid definition, one set of solver options and one transient window — the DUT netlist is the only variable. `pre` = the frozen deck of record `20260801-233807-32fbaa0` (schematic, no `XMRLK`); `sch` = the same deck today (schematic, with `XMRLK`); `ext` = the deck of record `20260811-065930-35a87a6` (extracted, with `XMRLK` drawn), which carries `layout/postlayout/AUDIT.md`'s `temp_por_top` caveats — 238 drawn devices, 1 ideal (`temp_core`'s undrawn `XCC`, #177, not on any node in this path).

## Where the decision is lost

All times are µs after the dip starts (20 ms). The dip floor is held 20.001–20.051 ms and the rail is fully recovered at 20.052 ms, so anything past **+52 µs** is a recovery-edge event, not a response to the dip.

| point | arm | `POR_RAW` asserts | `POR_RAW` pulse width | min `POR_RAW`/VDD, recovery | min `BIAS_OK`/VDD, recovery | `RESETn` valid-low | `RESETn` 0.3 V crossing | min `RESETn`/VDD |
|---|---|---:|---:|---:|---:|---:|---:|---:|
| `ss_-40c_2.97v` | pre | 53.00 | **never** | -0.0000 | 0.9990 | 51.60 | 51.60 | -0.0000 |
| `ss_-40c_2.97v` | sch | 53.10 | **never** | -0.0000 | 0.9990 | **never** | **never** | 0.7136 |
| `ss_-40c_2.97v` | ext | 53.20 | **never** | -0.0000 | 0.9966 | **never** | **never** | 0.7120 |
| `ss_27c_2.97v` | pre | 52.90 | **never** | -0.0000 | 0.9988 | 51.60 | 51.50 | -0.0000 |
| `ss_27c_2.97v` | sch | 53.00 | **never** | -0.0000 | 0.9988 | **never** | **never** | 0.7111 |
| `ss_27c_2.97v` | ext | 52.60 | **never** | -0.0000 | 0.9958 | 64.20 | 64.20 | -0.0000 |
| `sf_-40c_2.97v` | pre | 46.00 | **never** | -0.0055 | -0.0000 | 51.50 | 51.50 | -0.0000 |
| `sf_-40c_2.97v` | sch | 46.00 | **never** | -0.0057 | -0.0000 | 66.20 | 66.20 | -0.0000 |
| `sf_-40c_2.97v` | ext | 52.20 | **never** | -0.0001 | -0.0000 | 51.90 | 51.90 | -0.0000 |
| `tt_27c_3.30v` | pre | 52.10 | **never** | -0.0026 | -0.0000 | 51.40 | 51.40 | -0.0000 |
| `tt_27c_3.30v` | sch | 52.20 | **never** | -0.0027 | -0.0000 | 55.00 | 55.00 | -0.0000 |
| `tt_27c_3.30v` | ext | 52.10 | **never** | -0.0000 | 0.9966 | 51.90 | 51.90 | -0.0000 |

`por_output_chain`'s measured deglitch dwell at the cell level is **1.86–8.88 µs** with idealised bias (`sim/por-output-chain-deglitch/`, `design/por_output_chain.md`) — the yardstick the `POR_RAW` pulse width column is read against. A `POR_RAW` pulse narrower than the dwell is filtered by design; one wider than it is not.

## Inside the dip, for completeness

DR-011's falling-slew collapse is what neither change touches: all three arms ride the dip with `BIAS_OK` reading a false valid and `POR_RAW` never leaving the rail, at every point. Whatever the recovery edge does above, the dip response itself is the same starved loop it was.

| point | arm | min `POR_RAW`/VDD, in dip | min `BIAS_OK`/VDD, in dip |
|---|---|---:|---:|
| `ss_-40c_2.97v` | pre | 0.9980 | 0.9726 |
| `ss_-40c_2.97v` | sch | 0.9980 | 0.9726 |
| `ss_-40c_2.97v` | ext | 0.9920 | 0.9162 |
| `ss_27c_2.97v` | pre | 0.9983 | 0.9778 |
| `ss_27c_2.97v` | sch | 0.9983 | 0.9781 |
| `ss_27c_2.97v` | ext | 0.9943 | 0.9253 |
| `sf_-40c_2.97v` | pre | -0.0029 | 0.9901 |
| `sf_-40c_2.97v` | sch | -0.0023 | 0.9901 |
| `sf_-40c_2.97v` | ext | 0.9973 | 0.9632 |
| `tt_27c_3.30v` | pre | 0.9986 | 0.9847 |
| `tt_27c_3.30v` | sch | 0.9986 | 0.9848 |
| `tt_27c_3.30v` | ext | 0.9962 | 0.9445 |

`RESETn` ends the run at 2.970 V (`ss_-40c_2.97v`, pre), 2.970 V (`ss_-40c_2.97v`, sch), 2.970 V (`ss_-40c_2.97v`, ext), 2.970 V (`ss_27c_2.97v`, pre), 2.970 V (`ss_27c_2.97v`, sch), 2.970 V (`ss_27c_2.97v`, ext), 2.970 V (`sf_-40c_2.97v`, pre), 2.970 V (`sf_-40c_2.97v`, sch), 2.970 V (`sf_-40c_2.97v`, ext), 3.300 V (`tt_27c_3.30v`, pre), 3.300 V (`tt_27c_3.30v`, sch), 3.300 V (`tt_27c_3.30v`, ext) — nothing latches up asserted, on any arm.
