2AMLogic/gf180-temp-por/sim/por-output-chain-deglitch/control/cdg_results.md

# por-output-chain-deglitch CDG-resize tradeoff -- generated, do not edit

Generated by `sim/por-output-chain-deglitch/control/run_cdg_tradeoff.py` (issue #182). Re-run it to regenerate this file, the decks under `decks/` and the raw ngspice logs under `logs/`. The numbers quoted in `design/por_output_chain.md` are transcribed from here, and from nowhere else.

**A what-if on the extracted netlist, not a proposed layout.** `XCDG`'s drawn MiM dimensions are rewritten in a copy of `layout/postlayout/por_output_chain.spice`; the surrounding interconnect parasitics are left at the values extracted for the 11 um x 11 um capacitor that is actually drawn. A real resize would redraw the MiM, carry more interconnect of its own, and require re-extraction -- so both bounds below are *optimistic* for a given size.

This is a **control experiment, not a record** -- overwritten in place on every run (`sim/README.md`, "Control experiments").

- ngspice: `ngspice-46 : Circuit level simulation program`
- PDK: `gf180mcuD@c6d73a35f524070e85faff4a6a9eef49553ebc2b` (search_root:~/.volare)
- harness: `0.1.0`

## Ceiling: `dwell_pgdg_halfib_us` vs. the ratified 10 us `T_dip,min`

| `XCDG` | drawn area | `CDG` | corner | dwell, nominal `IBIAS` | dwell, half `IBIAS` | vs. 10 us |
| --- | ---: | ---: | --- | ---: | ---: | --- |
| 11 um x 11 um (as drawn) | 121 um^2 | 242 fF | `ss_-40c_2.97v` | 4.170 us | **8.020 us** | +19.8 % headroom |
| 12 um x 12 um | 144 um^2 | 288 fF | `ss_-40c_2.97v` | 5.080 us | **9.770 us** | +2.3 % headroom |
| 13 um x 13 um | 169 um^2 | 338 fF | `ss_-40c_2.97v` | 6.080 us | **11.680 us** | -16.8 % headroom |
| 14 um x 14 um | 196 um^2 | 392 fF | `ss_-40c_2.97v` | 7.160 us | **13.750 us** | -37.5 % headroom |

## Floor: the glitch width the filter stops rejecting

`rejected` = the one-shot's `TIM` keeps its charge; `partial` = `TIM` lost 1-50 % of it; `**through**` = `TIM` lost more than half, i.e. `XMDIS` fired and the reset pulse restarted.

### `ff_125c_2.97v`

| `XCDG` | 1 us | 1.25 us | 1.5 us | 1.75 us | 2 us | 2.25 us |
| --- | --- | --- | --- | --- | --- | --- |
| 11 um (as drawn) | rejected | partial | **through** | **through** | **through** | **through** |
| 12 um | rejected | rejected | rejected | **through** | **through** | **through** |
| 13 um | rejected | rejected | rejected | rejected | partial | **through** |
| 14 um | rejected | rejected | rejected | rejected | rejected | rejected |

### `ff_125c_3.63v`

| `XCDG` | 1 us | 1.25 us | 1.5 us | 1.75 us | 2 us | 2.25 us |
| --- | --- | --- | --- | --- | --- | --- |
| 11 um (as drawn) | rejected | **through** | **through** | **through** | **through** | **through** |
| 12 um | rejected | rejected | partial | **through** | **through** | **through** |
| 13 um | rejected | rejected | rejected | rejected | **through** | **through** |
| 14 um | rejected | rejected | rejected | rejected | rejected | rejected |
