2AMLogic/gf180-temp-por/sim/por-output-chain-deglitch/control/results.md

# por-output-chain-deglitch asymmetry probe -- generated, do not edit

Generated by `sim/por-output-chain-deglitch/control/run_deglitch_asym_probe.py` (issue #182). Re-run it to regenerate this file, the decks under `decks/`, the raw ngspice logs under `logs/` and the cropped traces under `traces/`. The numbers quoted in `design/por_output_chain.md` are transcribed from here, and from nowhere else.

This is a **control experiment, not a record**: three PVT points tracing internal nodes is a diagnosis, and this directory is overwritten in place on every run. The corner-grid evidence for [`por-brownout`](../../../spec/target-spec.md#por-brownout) stays in `sim/por-output-chain-deglitch/records/` (`sim/README.md`, "Control experiments").

- ngspice: `ngspice-46 : Circuit level simulation program`
- PDK: `gf180mcuD@c6d73a35f524070e85faff4a6a9eef49553ebc2b` (search_root:~/.volare)
- harness: `0.1.0`

## The decomposition

Each POR_RAW edge starts a slow `I/C` ramp on `NDG` that ends when `XMG1` flips `PGDG` through the records' own 1.0 V measurement threshold, so

```
dwell = (V_trip - V0) / slope
```

where `V0` is the level the ramp actually starts from -- the ramp fitted over its middle half and extrapolated back to the edge -- **not** the pre-edge rail. `step = V0 - V(NDG) just before the edge` is therefore the charge dumped onto (or pulled off) `NDG` at the instant the input pair switches.

### POR_RAW falling (`dwell_pgdg_1x_us`) -- the por-brownout direction

| corner | variant | dwell | pre-edge `NDG` | step | `V0` | slope | `V_trip` | `(V_trip-V0)/slope` |
| --- | --- | ---: | ---: | ---: | ---: | ---: | ---: | ---: |
| `ff_125c_3.63v` | `schematic` | 2.009 us | 0.0000 V | +0.1012 V | 0.1012 V | +0.31625 V/us | 0.7144 V | 1.939 us |
| `ff_125c_3.63v` | `postlayout` | 1.277 us | 0.0000 V | +0.3833 V | 0.3833 V | +0.26965 V/us | 0.7207 V | 1.251 us |
| `ff_125c_3.63v` | `sch+cndg` | 2.403 us | 0.0000 V | +0.0941 V | 0.0941 V | +0.26675 V/us | 0.7136 V | 2.323 us |
| `ff_125c_3.63v` | `sch+ctail` | 1.000 us | 0.0000 V | +0.3952 V | 0.3952 V | +0.32764 V/us | 0.7148 V | 0.975 us |
| `ff_125c_3.63v` | `sch+call` | 1.356 us | 0.0000 V | +0.3478 V | 0.3478 V | +0.27768 V/us | 0.7139 V | 1.319 us |
| `tt_27c_3.30v` | `schematic` | 3.111 us | 0.0000 V | +0.0972 V | 0.0972 V | +0.25041 V/us | 0.8501 V | 3.007 us |
| `tt_27c_3.30v` | `postlayout` | 2.593 us | 0.0000 V | +0.3019 V | 0.3019 V | +0.22068 V/us | 0.8563 V | 2.512 us |
| `tt_27c_3.30v` | `sch+cndg` | 3.658 us | 0.0000 V | +0.0926 V | 0.0926 V | +0.21359 V/us | 0.8494 V | 3.543 us |
| `tt_27c_3.30v` | `sch+ctail` | 2.139 us | 0.0000 V | +0.3104 V | 0.3104 V | +0.26181 V/us | 0.8503 V | 2.062 us |
| `tt_27c_3.30v` | `sch+call` | 2.658 us | 0.0000 V | +0.2790 V | 0.2790 V | +0.22235 V/us | 0.8495 V | 2.566 us |
| `ss_-40c_2.97v` | `schematic` | 4.408 us | 0.0000 V | +0.0963 V | 0.0963 V | +0.20176 V/us | 0.9624 V | 4.293 us |
| `ss_-40c_2.97v` | `postlayout` | 4.167 us | 0.0000 V | +0.2423 V | 0.2423 V | +0.17917 V/us | 0.9692 V | 4.057 us |
| `ss_-40c_2.97v` | `sch+cndg` | 5.101 us | 0.0000 V | +0.0918 V | 0.0918 V | +0.17467 V/us | 0.9618 V | 4.981 us |
| `ss_-40c_2.97v` | `sch+ctail` | 3.538 us | 0.0000 V | +0.2496 V | 0.2496 V | +0.20789 V/us | 0.9625 V | 3.429 us |
| `ss_-40c_2.97v` | `sch+call` | 4.217 us | 0.0000 V | +0.2283 V | 0.2283 V | +0.17892 V/us | 0.9618 V | 4.100 us |

Cross-check against the two records at the same corners:

| corner | this probe, `schematic` | record `20260802-205904-bdc077d` | this probe, `postlayout` | record `20260811-055634-d0ee17d` |
| --- | ---: | ---: | ---: | ---: |
| `ff_125c_3.63v` | 2.009 us | 2.01 us | 1.277 us | 1.28 us |
| `tt_27c_3.30v` | 3.111 us | 3.11 us | 2.593 us | 2.6 us |
| `ss_-40c_2.97v` | 4.408 us | 4.41 us | 4.167 us | 4.17 us |

### POR_RAW rising (`dwell_rise_1x_us`)

| corner | variant | dwell | pre-edge `NDG` | step | `V0` | slope | `V_trip` | `(V_trip-V0)/slope` |
| --- | --- | ---: | ---: | ---: | ---: | ---: | ---: | ---: |
| `ff_125c_3.63v` | `schematic` | 10.719 us | 3.6299 V | -0.4030 V | 3.2269 V | -0.23840 V/us | 0.7040 V | 10.583 us |
| `ff_125c_3.63v` | `postlayout` | 12.407 us | 3.6299 V | -0.7029 V | 2.9270 V | -0.18129 V/us | 0.7005 V | 12.281 us |
| `ff_125c_3.63v` | `sch+cndg` | 12.553 us | 3.6299 V | -0.3574 V | 3.2726 V | -0.20684 V/us | 0.7044 V | 12.416 us |
| `ff_125c_3.63v` | `sch+ctail` | 10.544 us | 3.6299 V | -0.7488 V | 2.8811 V | -0.20843 V/us | 0.7043 V | 10.444 us |
| `ff_125c_3.63v` | `sch+call` | 12.367 us | 3.6299 V | -0.6692 V | 2.9607 V | -0.18394 V/us | 0.7047 V | 12.265 us |
| `tt_27c_3.30v` | `schematic` | 10.271 us | 3.3000 V | -0.3308 V | 2.9692 V | -0.21157 V/us | 0.8392 V | 10.067 us |
| `tt_27c_3.30v` | `postlayout` | 11.556 us | 3.3000 V | -0.6076 V | 2.6924 V | -0.16294 V/us | 0.8353 V | 11.397 us |
| `tt_27c_3.30v` | `sch+cndg` | 11.882 us | 3.3000 V | -0.2930 V | 3.0070 V | -0.18576 V/us | 0.8396 V | 11.667 us |
| `tt_27c_3.30v` | `sch+ctail` | 9.941 us | 3.3000 V | -0.6451 V | 2.6549 V | -0.18497 V/us | 0.8396 V | 9.814 us |
| `tt_27c_3.30v` | `sch+call` | 11.545 us | 3.3000 V | -0.5760 V | 2.7240 V | -0.16529 V/us | 0.8399 V | 11.399 us |
| `ss_-40c_2.97v` | `schematic` | 9.345 us | 2.9700 V | -0.2413 V | 2.7287 V | -0.19675 V/us | 0.9495 V | 9.043 us |
| `ss_-40c_2.97v` | `postlayout` | 10.232 us | 2.9700 V | -0.4468 V | 2.5232 V | -0.16124 V/us | 0.9442 V | 9.793 us |
| `ss_-40c_2.97v` | `sch+cndg` | 10.712 us | 2.9700 V | -0.2154 V | 2.7546 V | -0.17349 V/us | 0.9499 V | 10.403 us |
| `ss_-40c_2.97v` | `sch+ctail` | 8.875 us | 2.9700 V | -0.4768 V | 2.4932 V | -0.18177 V/us | 0.9498 V | 8.491 us |
| `ss_-40c_2.97v` | `sch+call` | 10.237 us | 2.9700 V | -0.4207 V | 2.5493 V | -0.16295 V/us | 0.9502 V | 9.813 us |

Cross-check against the two records at the same corners:

| corner | this probe, `schematic` | record `20260802-205904-bdc077d` | this probe, `postlayout` | record `20260811-055634-d0ee17d` |
| --- | ---: | ---: | ---: | ---: |
| `ff_125c_3.63v` | 10.719 us | 10.7191 us | 12.407 us | 12.4069 us |
| `tt_27c_3.30v` | 10.271 us | 10.2709 us | 11.556 us | 11.5561 us |
| `ss_-40c_2.97v` | 9.345 us | 9.3447 us | 10.232 us | 10.2313 us |

## Tail-node levels

| corner | variant | edge | `NDGP` before | `NDGP` mid-ramp | `NDGN` before | `NDGN` mid-ramp |
| --- | --- | --- | ---: | ---: | ---: | ---: |
| `ff_125c_3.63v` | `schematic` | fall | 3.6300 V | 1.1674 V | 0.0000 V | 0.0002 V |
| `ff_125c_3.63v` | `schematic` | rise | 3.6299 V | 3.6300 V | 0.0000 V | 1.9444 V |
| `ff_125c_3.63v` | `postlayout` | fall | 3.6300 V | 1.1692 V | 0.0000 V | 0.0004 V |
| `ff_125c_3.63v` | `postlayout` | rise | 3.6299 V | 3.6300 V | 0.0000 V | 1.7992 V |
| `ff_125c_3.63v` | `sch+cndg` | fall | 3.6300 V | 1.1664 V | 0.0000 V | 0.0001 V |
| `ff_125c_3.63v` | `sch+cndg` | rise | 3.6299 V | 3.6300 V | 0.0000 V | 1.9702 V |
| `ff_125c_3.63v` | `sch+ctail` | fall | 3.6300 V | 1.1713 V | 0.0000 V | 0.0006 V |
| `ff_125c_3.63v` | `sch+ctail` | rise | 3.6299 V | 3.6300 V | 0.0000 V | 1.7793 V |
| `ff_125c_3.63v` | `sch+call` | fall | 3.6300 V | 1.1700 V | 0.0000 V | 0.0004 V |
| `ff_125c_3.63v` | `sch+call` | rise | 3.6299 V | 3.6300 V | 0.0000 V | 1.8209 V |
| `tt_27c_3.30v` | `schematic` | fall | 3.3000 V | 1.3374 V | 0.0000 V | -0.0000 V |
| `tt_27c_3.30v` | `schematic` | rise | 3.3000 V | 3.3000 V | 0.0000 V | 1.8745 V |
| `tt_27c_3.30v` | `postlayout` | fall | 3.3000 V | 1.3386 V | 0.0000 V | 0.0000 V |
| `tt_27c_3.30v` | `postlayout` | rise | 3.3000 V | 3.3000 V | 0.0000 V | 1.7465 V |
| `tt_27c_3.30v` | `sch+cndg` | fall | 3.3000 V | 1.3366 V | 0.0000 V | -0.0000 V |
| `tt_27c_3.30v` | `sch+cndg` | rise | 3.3000 V | 3.3000 V | 0.0000 V | 1.8956 V |
| `tt_27c_3.30v` | `sch+ctail` | fall | 3.3000 V | 1.3398 V | 0.0000 V | 0.0001 V |
| `tt_27c_3.30v` | `sch+ctail` | rise | 3.3000 V | 3.3000 V | 0.0000 V | 1.7315 V |
| `tt_27c_3.30v` | `sch+call` | fall | 3.3000 V | 1.3386 V | 0.0000 V | 0.0000 V |
| `tt_27c_3.30v` | `sch+call` | rise | 3.3000 V | 3.3000 V | 0.0000 V | 1.7657 V |
| `ss_-40c_2.97v` | `schematic` | fall | 2.9700 V | 1.4597 V | 0.0000 V | -0.0001 V |
| `ss_-40c_2.97v` | `schematic` | rise | 2.9700 V | 2.9700 V | 0.0000 V | 1.7115 V |
| `ss_-40c_2.97v` | `postlayout` | fall | 2.9700 V | 1.4603 V | 0.0000 V | -0.0000 V |
| `ss_-40c_2.97v` | `postlayout` | rise | 2.9700 V | 2.9700 V | 0.0000 V | 1.6729 V |
| `ss_-40c_2.97v` | `sch+cndg` | fall | 2.9700 V | 1.4591 V | 0.0000 V | -0.0001 V |
| `ss_-40c_2.97v` | `sch+cndg` | rise | 2.9700 V | 2.9700 V | 0.0000 V | 1.7120 V |
| `ss_-40c_2.97v` | `sch+ctail` | fall | 2.9700 V | 1.4609 V | 0.0000 V | -0.0000 V |
| `ss_-40c_2.97v` | `sch+ctail` | rise | 2.9700 V | 2.9700 V | 0.0000 V | 1.6634 V |
| `ss_-40c_2.97v` | `sch+call` | fall | 2.9700 V | 1.4601 V | 0.0000 V | -0.0000 V |
| `ss_-40c_2.97v` | `sch+call` | rise | 2.9700 V | 2.9700 V | 0.0000 V | 1.6856 V |

## Variants

| variant | DUT netlist |
| --- | --- |
| `schematic` | `design/netlist/por_output_chain.spice`, unmodified |
| `postlayout` | `layout/postlayout/por_output_chain.spice`, unmodified |
| `sch+cndg` | schematic + the extraction's NDG shunt only (38.58 fF) |
| `sch+ctail` | schematic + the extraction's NDGP/NDGN tail shunts only (34.12 / 34.26 fF) |
| `sch+call` | schematic + all three of those shunts (38.58 / 34.12 / 34.26 fF) |
