2AMLogic/gf180-temp-por/sim/por-output-chain-deglitch/control/width_results.md

# por-output-chain-deglitch glitch-width sweep -- generated, do not edit

Generated by `sim/por-output-chain-deglitch/control/run_glitch_width_sweep.py` (issue #182). Re-run it to regenerate this file, the decks under `decks/` and the raw ngspice logs under `logs/`. The numbers quoted in `design/por_output_chain.md` are transcribed from here, and from nowhere else.

This is a **control experiment, not a record**: two corners walking one stimulus parameter is a diagnosis, and this directory is overwritten in place on every run. The corner-grid evidence for [`por-brownout`](../../../spec/target-spec.md#por-brownout) stays in `sim/por-output-chain-deglitch/records/` (`sim/README.md`, "Control experiments").

- ngspice: `ngspice-46 : Circuit level simulation program`
- PDK: `gf180mcuD@c6d73a35f524070e85faff4a6a9eef49553ebc2b` (search_root:~/.volare)
- harness: `0.1.0`

`rejected` = the one-shot's `TIM` keeps its charge (it loses under 1 %); `partial` = `TIM` lost 1-50 % of it, i.e. the pulse was set back but not restarted; `**through**` = `TIM` lost more than half its pre-glitch charge, i.e. `XMDIS` fired and the reset pulse restarted -- the failure mode `design/por_output_chain.md` records at `CDG` = 98 fF.

## `ff_125c_2.97v`

| glitch width | `schematic` `PGDG` min | verdict | `postlayout` `PGDG` min | verdict |
| ---: | ---: | --- | ---: | --- |
| 0.5 us | 2.9683 V | rejected | 2.9123 V | rejected |
| 0.75 us | 2.9634 V | rejected | 2.7996 V | rejected |
| 1 us **(the testbench's chatter width)** | 2.9413 V | rejected | 2.5362 V | rejected |
| 1.25 us | 2.8645 V | rejected | 1.8207 V | partial |
| 1.5 us | 2.6506 V | rejected | 0.1104 V | **through** |
| 1.75 us | 2.0728 V | rejected | 0.0707 V | **through** |
| 2 us | 0.1179 V | **through** | 0.0515 V | **through** |
| 2.25 us | 0.0701 V | **through** | 0.0398 V | **through** |
| 2.5 us | 0.0493 V | **through** | 0.0318 V | **through** |
| 3 us | 0.0291 V | **through** | 0.0220 V | **through** |
| 4 us | 0.0133 V | **through** | 0.0123 V | **through** |

- `schematic`: rejects cleanly up to 1.75 us and is disturbed by 2 us -- i.e. 1.75x the 1 us glitch ../testbench/stimulus.spice applies.
- `postlayout`: rejects cleanly up to 1 us and is disturbed by 1.25 us -- i.e. 1.00x the 1 us glitch ../testbench/stimulus.spice applies.

## `ff_125c_3.63v`

| glitch width | `schematic` `PGDG` min | verdict | `postlayout` `PGDG` min | verdict |
| ---: | ---: | --- | ---: | --- |
| 0.5 us | 3.6281 V | rejected | 3.4645 V | rejected |
| 0.75 us | 3.6218 V | rejected | 3.2332 V | rejected |
| 1 us **(the testbench's chatter width)** | 3.5948 V | rejected | 2.7953 V | rejected |
| 1.25 us | 3.5076 V | rejected | 1.2734 V | **through** |
| 1.5 us | 3.2949 V | rejected | 0.1398 V | **through** |
| 1.75 us | 2.8609 V | rejected | 0.0985 V | **through** |
| 2 us | 0.9468 V | **through** | 0.0762 V | **through** |
| 2.25 us | 0.1349 V | **through** | 0.0617 V | **through** |
| 2.5 us | 0.0931 V | **through** | 0.0514 V | **through** |
| 3 us | 0.0567 V | **through** | 0.0378 V | **through** |
| 4 us | 0.0289 V | **through** | 0.0238 V | **through** |

- `schematic`: rejects cleanly up to 1.75 us and is disturbed by 2 us -- i.e. 1.75x the 1 us glitch ../testbench/stimulus.spice applies.
- `postlayout`: rejects cleanly up to 1 us and is disturbed by 1.25 us -- i.e. 1.00x the 1 us glitch ../testbench/stimulus.spice applies.
