2AMLogic/gf180-temp-por/sim/por-glitch/control/depth_results.md

# por-glitch depth / duration sweep -- generated, do not edit

Generated by `sim/por-glitch/control/run_depth_sweep.py`. Re-run it to regenerate this file, the `sweep_*` decks under `decks/`, the raw ngspice logs under `logs/` and the traces under `traces/`. The numbers quoted in `design/por_output_chain.md` and `spec/decision-records/DR-017-por-glitch-representative-depth.md` are transcribed from here, and from nowhere else.

Companion to `results.md` (the internal-node mechanism probe). That one asks *why* the block responds to `sim/por-glitch/`'s glitch; this one asks *which glitches it responds to at all*, on two axes, one variable per run:

- **depth** — rail floor from 0.2 V (the testbench's own choice) toward the rail, at the testbench's own 300 ns total duration;
- **duration** — the 0.2 V floor held from 10 ns to 30 us, spanning both sides of `por_output_chain`'s characterized 1.86–8.88 µs deglitch dwell.

Each axis is run in two **arms**, the same two `sim/por-ramp-rate/control/` defines: `asbuilt` (the committed netlist) and `nokeeper` (the same netlist with issue #56's `XMRLK` release latch removed by an asserted single-line edit — the circuit record `20260801-233813-32fbaa0` measured). Each arm's exact DUT is committed as `decks/sweep_dut_<arm>.spice`.

Both at two PVT points, each run held 30 ms so a regenerated reset pulse (≥1 ms ratified, 4.2–17.0 ms measured) cannot hide in the post-glitch window. "assert" below means `RESETn` fell below 1.65 V at any time from 100 µs after the rail recovered to the end of the run.

## Depth axis (300 ns total, floor swept)

### `tt_27c_3.30v` -- arm `asbuilt`

| glitch floor | min `PGDG` | min `POR_RAW` | `TIM` before -> after | min `RESETn` after | verdict |
| --- | ---: | ---: | ---: | ---: | --- |
| 0.2 V | 0.496 V | -0.027 V | 3.300 -> 0.927 V | -0.000 V | **assert** |
| 0.35 V | 0.558 V | -0.030 V | 3.300 -> 1.076 V | -0.000 V | **assert** |
| 0.5 V | 0.619 V | -0.001 V | 3.300 -> 1.225 V | -0.000 V | **assert** |
| 0.65 V | 0.683 V | 0.650 V | 3.300 -> 1.374 V | 3.300 V | no assert |
| 0.8 V | 0.801 V | 0.800 V | 3.300 -> 1.523 V | 3.300 V | no assert |
| 1.4 V | 1.400 V | 1.400 V | 3.300 -> 2.120 V | 3.300 V | no assert |
| 2 V | 2.000 V | 2.000 V | 3.300 -> 2.717 V | 3.300 V | no assert |
| 2.4 V | 2.400 V | 2.400 V | 3.300 -> 3.114 V | 3.300 V | no assert |
| 2.8 V | 2.800 V | 2.800 V | 3.300 -> 3.292 V | 3.300 V | no assert |

### `tt_27c_3.30v` -- arm `nokeeper`

| glitch floor | min `PGDG` | min `POR_RAW` | `TIM` before -> after | min `RESETn` after | verdict |
| --- | ---: | ---: | ---: | ---: | --- |
| 0.2 V | 0.496 V | -0.027 V | 3.300 -> 0.927 V | -0.000 V | **assert** |
| 0.35 V | 0.558 V | -0.028 V | 3.300 -> 1.076 V | -0.000 V | **assert** |
| 0.5 V | 0.619 V | -0.001 V | 3.300 -> 1.225 V | -0.000 V | **assert** |
| 0.65 V | 0.682 V | 0.650 V | 3.300 -> 1.374 V | -0.000 V | **assert** |
| 0.8 V | 0.801 V | 0.800 V | 3.300 -> 1.523 V | -0.000 V | **assert** |
| 1.4 V | 1.400 V | 1.400 V | 3.300 -> 2.120 V | -0.000 V | **assert** |
| 2 V | 2.000 V | 2.000 V | 3.300 -> 2.717 V | 3.300 V | no assert |
| 2.4 V | 2.400 V | 2.400 V | 3.300 -> 3.114 V | 3.300 V | no assert |
| 2.8 V | 2.800 V | 2.800 V | 3.300 -> 3.292 V | 3.300 V | no assert |

### `ss_125c_2.97v` -- arm `asbuilt`

| glitch floor | min `PGDG` | min `POR_RAW` | `TIM` before -> after | min `RESETn` after | verdict |
| --- | ---: | ---: | ---: | ---: | --- |
| 0.2 V | 0.508 V | -0.001 V | 2.970 -> 0.760 V | -0.000 V | **assert** |
| 0.35 V | 0.574 V | -0.021 V | 2.970 -> 0.908 V | -0.000 V | **assert** |
| 0.5 V | 0.637 V | -0.024 V | 2.970 -> 1.057 V | -0.000 V | **assert** |
| 0.65 V | 0.702 V | -0.023 V | 2.970 -> 1.205 V | 2.970 V | no assert |
| 0.8 V | 0.807 V | 0.800 V | 2.970 -> 1.354 V | 2.970 V | no assert |
| 1.4 V | 1.400 V | 1.400 V | 2.970 -> 1.950 V | 2.970 V | no assert |
| 2 V | 2.000 V | 2.000 V | 2.970 -> 2.546 V | 2.970 V | no assert |
| 2.4 V | 2.400 V | 2.400 V | 2.970 -> 2.924 V | 2.970 V | no assert |
| 2.8 V | 2.800 V | 2.800 V | 2.970 -> 2.969 V | 2.970 V | no assert |

### `ss_125c_2.97v` -- arm `nokeeper`

| glitch floor | min `PGDG` | min `POR_RAW` | `TIM` before -> after | min `RESETn` after | verdict |
| --- | ---: | ---: | ---: | ---: | --- |
| 0.2 V | 0.507 V | -0.001 V | 2.970 -> 0.760 V | -0.000 V | **assert** |
| 0.35 V | 0.574 V | -0.020 V | 2.970 -> 0.908 V | -0.000 V | **assert** |
| 0.5 V | 0.637 V | -0.024 V | 2.970 -> 1.057 V | -0.000 V | **assert** |
| 0.65 V | 0.702 V | -0.026 V | 2.970 -> 1.206 V | -0.000 V | **assert** |
| 0.8 V | 0.807 V | 0.800 V | 2.970 -> 1.354 V | -0.000 V | **assert** |
| 1.4 V | 1.400 V | 1.400 V | 2.970 -> 1.950 V | -0.000 V | **assert** |
| 2 V | 2.000 V | 2.000 V | 2.970 -> 2.546 V | 2.970 V | no assert |
| 2.4 V | 2.400 V | 2.400 V | 2.970 -> 2.924 V | 2.970 V | no assert |
| 2.8 V | 2.800 V | 2.800 V | 2.970 -> 2.969 V | 2.970 V | no assert |

## Duration axis (0.2 V floor, hold swept)

### `tt_27c_3.30v` -- arm `asbuilt`

| hold at 0.2 V | min `PGDG` | min `POR_RAW` | `TIM` before -> after | min `RESETn` after | verdict |
| --- | ---: | ---: | ---: | ---: | --- |
| 10 ns | 0.547 V | -0.030 V | 3.300 -> 0.992 V | -0.000 V | **assert** |
| 100 ns | 0.496 V | -0.027 V | 3.300 -> 0.927 V | -0.000 V | **assert** |
| 1000 ns | 0.423 V | -0.011 V | 3.300 -> 0.827 V | -0.000 V | **assert** |
| 3000 ns | 0.391 V | -0.000 V | 3.300 -> 0.734 V | -0.000 V | **assert** |
| 30000 ns | 0.334 V | -0.000 V | 3.300 -> 0.505 V | -0.000 V | **assert** |

### `tt_27c_3.30v` -- arm `nokeeper`

| hold at 0.2 V | min `PGDG` | min `POR_RAW` | `TIM` before -> after | min `RESETn` after | verdict |
| --- | ---: | ---: | ---: | ---: | --- |
| 10 ns | 0.546 V | -0.030 V | 3.300 -> 0.992 V | -0.000 V | **assert** |
| 100 ns | 0.496 V | -0.027 V | 3.300 -> 0.927 V | -0.000 V | **assert** |
| 1000 ns | 0.422 V | -0.011 V | 3.300 -> 0.827 V | -0.000 V | **assert** |
| 3000 ns | 0.391 V | -0.000 V | 3.300 -> 0.734 V | -0.000 V | **assert** |
| 30000 ns | 0.334 V | -0.000 V | 3.300 -> 0.505 V | -0.000 V | **assert** |

### `ss_125c_2.97v` -- arm `asbuilt`

| hold at 0.2 V | min `PGDG` | min `POR_RAW` | `TIM` before -> after | min `RESETn` after | verdict |
| --- | ---: | ---: | ---: | ---: | --- |
| 10 ns | 0.574 V | -0.002 V | 2.970 -> 0.838 V | -0.000 V | **assert** |
| 100 ns | 0.508 V | -0.001 V | 2.970 -> 0.760 V | -0.000 V | **assert** |
| 1000 ns | 0.415 V | -0.000 V | 2.970 -> 0.667 V | -0.000 V | **assert** |
| 3000 ns | 0.374 V | -0.000 V | 2.970 -> 0.619 V | -0.000 V | **assert** |
| 30000 ns | 0.298 V | -0.000 V | 2.970 -> 0.516 V | -0.000 V | **assert** |

### `ss_125c_2.97v` -- arm `nokeeper`

| hold at 0.2 V | min `PGDG` | min `POR_RAW` | `TIM` before -> after | min `RESETn` after | verdict |
| --- | ---: | ---: | ---: | ---: | --- |
| 10 ns | 0.573 V | -0.002 V | 2.970 -> 0.838 V | -0.000 V | **assert** |
| 100 ns | 0.507 V | -0.001 V | 2.970 -> 0.760 V | -0.000 V | **assert** |
| 1000 ns | 0.414 V | -0.000 V | 2.970 -> 0.667 V | -0.000 V | **assert** |
| 3000 ns | 0.374 V | -0.000 V | 2.970 -> 0.619 V | -0.000 V | **assert** |
| 30000 ns | 0.298 V | -0.000 V | 2.970 -> 0.516 V | -0.000 V | **assert** |

## What the numbers say

- 38 of 56 sweep runs regenerate a reset pulse. The tables above are what
  DR-017 is decided on; read the boundary off them rather than from this
  prose, which is generated from the same numbers.
- The DEPTH axis is the answer to issue #56's third question. Where the
  block stops responding, it stops because the rail never got far enough
  below the logic's own switching point for PGDG to fall -- not because a
  300 ns event is 'well under the deglitch dwell'. The dwell (CDG, 242 fF on
  NDG) is on POR_RAW's input side and is not in this path at all.
- The DURATION axis is the direct test of DR-014's strongest claim -- that
  the dwell provides zero protection against a VDD-level disturbance of any
  duration. If the response is identical from 10 ns to 30 us, i.e. across
  por_output_chain's whole characterized 1.86-8.88 us dwell, then the
  testbench's '300 ns is well under the dwell' framing was never a testable
  premise on this axis and the duration is not what needs choosing.
- TIM before -> after is the mechanism read-out: the one-shot capacitor is
  parked near its trip point while RESETn is released, and reads ~0 V
  immediately after any glitch that fired XMDIS. A run where TIM survives
  the glitch is a run where the rail never took PGDG down with it.

## Environment

- PDK: gf180mcuD @ open_pdks `c6d73a35f524070e85faff4a6a9eef49553ebc2b` (/Users/rwalters/.volare/gf180mcuD, found via search_root:~/.volare)
- ngspice: ngspice-46 : Circuit level simulation program
- Harness: sim/harness 0.1.0 (corner sections and solver options only), python 3.14.6
- git: `4cc7acd62b39b957189579dd7f3725ac01cdef27 (clean apart from this experiment's own outputs)`
- Solver options (from `../testbench/tb.json`): reltol=1e-5 abstol=1e-15 vntol=1e-9
- `depth_sweep.spice` sha256: `4f5c36739d302f3bdf7342b61e110e5f74ebc083158d989f2592ba8d7e80d222`
- `design/netlist/temp_por_top.spice` sha256: `ae7021b9e44f38c5b0d14cfc73e0e2eaec23ae2f0498bfcbe09849b40f67526e`
