2AMLogic/gf180-temp-por/sim/por-ramp-rate/control/results.md

# por-ramp-rate release-chatter probe -- generated, do not edit

Generated by `sim/por-ramp-rate/control/run_chatter_probe.py`. Re-run it to regenerate this file, the decks under `decks/`, the raw ngspice logs under `logs/` and the traces under `traces/`. The numbers quoted in `design/por_output_chain.md` are transcribed from here, and from nowhere else.

Three PVT + rate points from record `20260802-000004-32fbaa0`: `tt_27c_3.30v` at 10 V/s and 1 V/s (both chatter in that record), and `tt_-40c_3.30v` at 10 V/s (does not). Every DUT is a single-rate, single-corner cold-start ramp on the real four-cell assembly, with the full release path AND the shared-bias nodes behind it traced.

Four arms, each one asserted single-line edit away from the committed `design/netlist/temp_por_top.spice` (each arm's exact DUT is committed as `decks/dut_<arm>.spice`):

| arm | edit | what it isolates |
| --- | --- | --- |
| `asbuilt` | none | the circuit as drawn, with the `XMRLK` release latch |
| `nokeeper` | `XMRLK` deleted | the pre-fix circuit record `20260802-000004-32fbaa0` measured |
| `nokeeper_en_vdd` | `XMRLK` deleted, `temp_core.EN` tied to `VDD` | breaks the `RESETn` -> `temp_core.EN` -> `IBIAS` loop (temp_core permanently enabled) |
| `nokeeper_en_vss` | `XMRLK` deleted, `temp_core.EN` tied to `VSS` | breaks the same loop the other way (temp_core permanently disabled) |

## Result

### arm `asbuilt`

| point | rate | `RESETn` crossings of 1.0 V | first-to-last window | other-node crossing counts |
| --- | ---: | ---: | ---: | --- |
| `tt_27c_3.30v_10vs` | 10 V/s | 1 | n/a (single crossing) | POR_RAW=1, PGDG=3, VREF=1, BIAS_OK=1, TIM=1, TRIP=1, RSTB=2 |
| `tt_-40c_3.30v_10vs` | 10 V/s | 1 | n/a (single crossing) | POR_RAW=1, PGDG=3, VREF=1, BIAS_OK=1, TIM=1, TRIP=1, RSTB=2 |
| `tt_27c_3.30v_1vs` | 1 V/s | 1 | n/a (single crossing) | POR_RAW=1, PGDG=1, VREF=1, BIAS_OK=1, TIM=1, TRIP=1, RSTB=2 |

### arm `nokeeper`

| point | rate | `RESETn` crossings of 1.0 V | first-to-last window | other-node crossing counts |
| --- | ---: | ---: | ---: | --- |
| `tt_27c_3.30v_10vs` | 10 V/s | 3 | 36.85 us | POR_RAW=1, PGDG=3, VREF=1, BIAS_OK=1, TIM=1, TRIP=3, RSTB=4 |
| `tt_-40c_3.30v_10vs` | 10 V/s | 1 | n/a (single crossing) | POR_RAW=1, PGDG=3, VREF=1, BIAS_OK=1, TIM=1, TRIP=1, RSTB=2 |
| `tt_27c_3.30v_1vs` | 1 V/s | 3 | 36.32 us | POR_RAW=1, PGDG=1, VREF=1, BIAS_OK=1, TIM=1, TRIP=3, RSTB=4 |

### arm `nokeeper_en_vdd`

| point | rate | `RESETn` crossings of 1.0 V | first-to-last window | other-node crossing counts |
| --- | ---: | ---: | ---: | --- |
| `tt_27c_3.30v_10vs` | 10 V/s | 1 | n/a (single crossing) | POR_RAW=1, PGDG=3, VREF=1, BIAS_OK=1, TIM=1, TRIP=1, RSTB=2 |
| `tt_-40c_3.30v_10vs` | 10 V/s | 1 | n/a (single crossing) | POR_RAW=1, PGDG=3, VREF=1, BIAS_OK=1, TIM=1, TRIP=1, RSTB=2 |
| `tt_27c_3.30v_1vs` | 1 V/s | 1 | n/a (single crossing) | POR_RAW=1, PGDG=1, VREF=1, BIAS_OK=1, TIM=1, TRIP=1, RSTB=2 |

### arm `nokeeper_en_vss`

| point | rate | `RESETn` crossings of 1.0 V | first-to-last window | other-node crossing counts |
| --- | ---: | ---: | ---: | --- |
| `tt_27c_3.30v_10vs` | 10 V/s | 1 | n/a (single crossing) | POR_RAW=1, PGDG=3, VREF=1, BIAS_OK=1, TIM=1, TRIP=1, RSTB=2 |
| `tt_-40c_3.30v_10vs` | 10 V/s | 1 | n/a (single crossing) | POR_RAW=1, PGDG=3, VREF=1, BIAS_OK=1, TIM=1, TRIP=1, RSTB=2 |
| `tt_27c_3.30v_1vs` | 1 V/s | 1 | n/a (single crossing) | POR_RAW=1, PGDG=1, VREF=1, BIAS_OK=1, TIM=1, TRIP=1, RSTB=2 |

## The shared-bias step across the release edge (mV)

Sampled 20 us before the first `RESETn` release edge and 300 us after it. `VDD` is carried in the same table on purpose: it is still ramping, and its own movement across that window (a few mV) is the yardstick the `IBIAS` step has to beat to mean anything. The `ND1` column is different -- it is the trip detector's stage-A node 2 us after the release, and its PEAK over the same 300 us. That drift is the chatter mechanism: without `XMRLK` it walks back up to `XMDBNI`'s conduction point and collapses `TRIP`.

| point | arm | `VDD` | `IBIAS` | `PDN` | `NDL` | `ND1` (post-release -> peak) |
| --- | --- | --- | --- | --- | --- | --- |
| `tt_27c_3.30v_10vs` | `asbuilt` | 2665.0 -> 2668.2 (+3.2) | 666.4 -> 632.0 (-34.4) | 1909.8 -> 1942.1 (+32.3) | 554.4 -> 528.9 (-25.5) | 0.0 -> 0.0 |
| `tt_27c_3.30v_10vs` | `nokeeper` | 2665.0 -> 2668.2 (+3.2) | 666.4 -> 632.0 (-34.4) | 1909.8 -> 1942.1 (+32.3) | 554.4 -> 528.9 (-25.5) | 28.3 -> 569.0 |
| `tt_-40c_3.30v_10vs` | `asbuilt` | 2675.2 -> 2678.4 (+3.2) | 718.9 -> 690.9 (-28.0) | 1854.7 -> 1880.5 (+25.7) | 625.6 -> 604.9 (-20.6) | 0.0 -> 0.0 |
| `tt_-40c_3.30v_10vs` | `nokeeper` | 2676.9 -> 2680.1 (+3.2) | 718.9 -> 690.9 (-28.0) | 1856.4 -> 1882.1 (+25.7) | 625.6 -> 604.9 (-20.6) | 18.9 -> 425.7 |
| `tt_27c_3.30v_1vs` | `asbuilt` | 2598.0 -> 2598.3 (+0.3) | 666.2 -> 631.8 (-34.4) | 1843.1 -> 1872.5 (+29.4) | 554.2 -> 528.7 (-25.5) | 0.0 -> 0.0 |
| `tt_27c_3.30v_1vs` | `nokeeper` | 2598.0 -> 2598.3 (+0.3) | 666.2 -> 631.8 (-34.4) | 1843.1 -> 1872.5 (+29.4) | 554.2 -> 528.7 (-25.5) | 28.6 -> 571.6 |

## What the numbers say

- POR_RAW, PGDG, VREF and BIAS_OK cross the 1.0 V threshold at most once at
  every point and in every arm, including the ones that show RESETn chatter
  -- bias_core and por_comparator are firmly settled well before the chatter
  window opens, so neither design/bias_core.md's starved-loop window nor
  comparator threshold noise is the mechanism.
- In the nokeeper arm (the circuit record 20260802-000004-32fbaa0 measured)
  TRIP and RSTB chatter in lock-step with RESETn at the tt/27C points and
  settle cleanly at tt/-40C, at BOTH 10 V/s and 1 V/s -- a decade apart,
  with comparable window widths. Ramp rate is not the variable.
- The shared-bias table below is what the variable actually is. RESETn's own
  release enables temp_core (at the top level, temp_core's EN pin IS
  RESETn), which adds a second mirror diode to the shared IBIAS node and
  steps IBIAS DOWN. por_output_chain's starve references follow (PDN up, NDL
  down), which weakens the nA sink XMDANT that sets ND1's balance point, so
  ND1 drifts back UP after the release until XMDBNI re-conducts, TRIP
  collapses and RESETn re-asserts -- which disables temp_core again,
  restores IBIAS and restarts the cycle. A relaxation oscillation whose loop
  leaves por_output_chain entirely.
- The two nokeeper_en_* arms cut exactly that loop and nothing else: with
  temp_core's EN tied to a rail instead of to RESETn, RESETn no longer
  modulates the shared-node load, and the chatter disappears completely at
  every point -- in BOTH directions (permanently enabled and permanently
  disabled), which rules out 'temp_core enabled is simply a harder operating
  point' and leaves only the RESETn-driven modulation itself.
- The asbuilt arm is the fix: XMRLK (ND1 -> VSS, gated by RESETn) makes the
  release one-way, so the post-release bias drift can no longer walk the
  decision back. Single crossing at every point, including the two that
  chatter without it. It cannot arm prematurely because RSTB = NAND(TRIP,
  PGDG): PGDG low forces RSTB high and RESETn low regardless of TRIP.

## Environment

- PDK: gf180mcuD @ open_pdks `c6d73a35f524070e85faff4a6a9eef49553ebc2b` (/Users/rwalters/.volare/gf180mcuD, found via search_root:~/.volare)
- ngspice: ngspice-46 : Circuit level simulation program
- Harness: sim/harness 0.1.0 (corner sections and solver options only), python 3.14.6
- git: `1938c862237813778a022a26ea2dfbe532acad73 (clean apart from this experiment's own outputs)`
- Solver options (from `../testbench/tb.json`): reltol=1e-4 abstol=1e-13 vntol=1e-8 method=gear
- `chatter_probe.spice` sha256: `48309acc242c20afeebff7da7fcde40a2c563948077f9b13bd7cd0e08f06ea11`
- `design/netlist/temp_por_top.spice` sha256: `ae7021b9e44f38c5b0d14cfc73e0e2eaec23ae2f0498bfcbe09849b40f67526e`
