2AMLogic/gf180-temp-por/sim/por-brownout-slew/control/results.md

# `por-brownout-slew` non-monotonic-band mechanism control — results

**Generated by `run_band_mechanism.py`. Do not edit — re-run it.** Every number below is read out of `logs/` by that script; nothing here is transcribed by hand.

- PVT points: `ss` / -40 °C / 2.97 V, 3.3 V, 3.63 V (one corner family — a control is not corner evidence, see `sim/README.md`; the corner-grid evidence for this band is the rung records under `../records/`)
- PDK: `gf180mcuD` @ `c6d73a35f524070e85faff4a6a9eef49553ebc2b`
- Harness version: `0.1.0`
- Solver options (from `../testbench/tb.json`): `reltol=1e-4`, `abstol=1e-13`, `vntol=1e-8`, `method=gear`
- DUT netlist: `design/netlist/temp_por_top.spice` (sha256 `1cb191d10e6a…`)
- Diagnoses: the non-monotonic band reported in `../records/20260802-120940-3c3e728-boundary.md` § *Non-monotonic transition zone*
- `PASS`/`FAIL` below is `resetn_ratio_min_in_dip ≤ 0.1`, recomputed from this control's own trace over the same window `../testbench/tb.json` uses — so each row is directly checkable against the rung record at the same slew.

All times are **µs after the dip starts** (the dip start, 20 ms, is the same in every deck). *window closes* is the end of the dip window the grid measures over, `t_dip + edge + 50 µs dwell`; a `RESETn` valid-low later than that is a FAIL no matter how close it came.

## A — event timeline vs falling slew

One variable per table: the falling slew rate. Reading the columns left to right is reading the causal chain — rail crosses VPOR↓,min → `POR_RAW` asserts → the bias-starved deglitch finishes (`PGDG` falls) → `RESETn` reaches 0.1×VDD — against the clock that decides the verdict (*window closes*).

### ss / -40 °C / 2.97 V

| slew (mV/µs) | edge (µs) | window closes | VDD<VPOR↓,min at | `POR_RAW` asserts | rail there | `PGDG` falls | deglitch Δ | `RESETn` valid-low | margin to close | min `POR_RAW`/VDD | min `RESETn`/VDD | verdict |
|---|---|---|---|---|---|---|---|---|---|---|---|---|
| 3.351 | 587.9 | 637.9 | 223.8 | 72.9 | 2.7258 V | 492.6 | 419.7 | 503.6 | +134.3 | -0.0035 | -0.0000 | PASS |
| 3.4 | 579.4 | 629.4 | 220.6 | 74.1 | 2.7180 V | 504.5 | 430.4 | 520.7 | +108.7 | -0.0035 | -0.0000 | PASS |
| 3.42 | 576.0 | 626.0 | 219.3 | 74.7 | 2.7145 V | 511.7 | 437.0 | 531.1 | +94.9 | -0.0035 | -0.0000 | PASS |
| 3.44 | 572.7 | 622.7 | 218.0 | 75.3 | 2.7109 V | 518.5 | 443.2 | 542.2 | +80.5 | -0.0035 | -0.0000 | PASS |
| 3.46 | 569.4 | 619.4 | 216.8 | 76.0 | 2.7070 V | 528.3 | 452.3 | 557.5 | +61.9 | -0.0035 | -0.0000 | PASS |
| 3.4795 | 566.2 | 616.2 | 215.5 | 76.7 | 2.7031 V | 1124.8 | 1048.1 | 883.8 | -267.6 | -0.0051 | 0.9987 | **FAIL** |
| 3.52 | 559.7 | 609.7 | 213.1 | 78.4 | 2.6941 V | 1116.7 | 1038.3 | 874.1 | -264.4 | -0.0034 | 0.9987 | **FAIL** |
| 3.56 | 553.4 | 603.4 | 210.7 | 80.4 | 2.6839 V | 1108.2 | 1027.8 | 864.6 | -261.2 | -0.0034 | 0.9987 | **FAIL** |
| 3.613 | 545.3 | 595.3 | 207.6 | 82.6 | 2.6716 V | 1096.6 | 1014.0 | 852.8 | -257.5 | -0.0034 | 0.9987 | **FAIL** |
| 3.7 | 532.4 | 582.4 | 202.7 | 92.2 | 2.6288 V | 1071.8 | 979.6 | 832.9 | -250.5 | -0.0032 | 0.9987 | **FAIL** |
| 3.85 | 511.7 | 561.7 | 194.8 | 907.1 | 2.3297 V | 1046.5 | 139.4 | 802.1 | -240.4 | 0.9990 | 0.9987 | **FAIL** |
| 4 | 492.5 | 542.5 | 187.5 | 877.2 | 2.3387 V | 1014.4 | 137.2 | 774.1 | -231.6 | 0.9990 | 0.9987 | **FAIL** |
| 4.2 | 469.0 | 519.0 | 178.6 | 838.4 | 2.3414 V | 974.3 | 135.9 | 741.0 | -222.0 | 0.9990 | 0.9987 | **FAIL** |

### ss / -40 °C / 3.3 V

| slew (mV/µs) | edge (µs) | window closes | VDD<VPOR↓,min at | `POR_RAW` asserts | rail there | `PGDG` falls | deglitch Δ | `RESETn` valid-low | margin to close | min `POR_RAW`/VDD | min `RESETn`/VDD | verdict |
|---|---|---|---|---|---|---|---|---|---|---|---|---|
| 3.351 | 686.4 | 736.4 | 322.3 | 72.0 | 3.0586 V | 540.4 | 468.4 | 543.5 | +192.9 | -0.0037 | -0.0001 | PASS |
| 3.4 | 676.5 | 726.5 | 317.6 | 73.1 | 3.0515 V | 542.3 | 469.2 | 546.4 | +180.1 | -0.0034 | -0.0001 | PASS |
| 3.42 | 672.5 | 722.5 | 315.8 | 73.6 | 3.0484 V | 543.6 | 470.0 | 548.3 | +174.2 | -0.0035 | -0.0001 | PASS |
| 3.44 | 668.6 | 718.6 | 314.0 | 74.1 | 3.0452 V | 545.7 | 471.6 | 551.0 | +167.6 | -0.0036 | -0.0001 | PASS |
| 3.46 | 664.7 | 714.7 | 312.1 | 74.6 | 3.0418 V | **never** | — | 984.2 | -269.5 | -0.0034 | 0.9987 | **FAIL** |
| 3.4795 | 661.0 | 711.0 | 310.4 | 75.2 | 3.0382 V | **never** | — | 979.1 | -268.1 | -0.0034 | 0.9988 | **FAIL** |
| 3.52 | 653.4 | 703.4 | 306.8 | 76.6 | 3.0304 V | **never** | — | 968.8 | -265.4 | -0.0036 | 0.9988 | **FAIL** |
| 3.56 | 646.1 | 696.1 | 303.4 | 78.1 | 3.0218 V | 573.9 | 495.8 | 590.5 | +105.6 | -0.0036 | -0.0000 | PASS |
| 3.613 | 636.6 | 686.6 | 298.9 | 80.7 | 3.0085 V | 606.1 | 525.4 | 641.7 | +44.9 | -0.0032 | -0.0000 | PASS |
| 3.7 | 621.6 | 671.6 | 291.9 | 86.7 | 2.9791 V | 707.4 | 620.7 | 737.7 | -66.1 | -0.0035 | 0.9987 | **FAIL** |
| 3.85 | 597.4 | 647.4 | 280.5 | 1005.8 | 2.3797 V | **never** | — | 889.2 | -241.8 | 0.9990 | 0.9988 | **FAIL** |
| 4 | 575.0 | 625.0 | 270.0 | 970.5 | 2.3820 V | **never** | — | 858.1 | -233.1 | 0.9990 | 0.9987 | **FAIL** |
| 4.2 | 547.6 | 597.6 | 257.1 | 927.4 | 2.3850 V | **never** | — | 819.2 | -221.6 | 0.9990 | 0.9987 | **FAIL** |

### ss / -40 °C / 3.63 V

| slew (mV/µs) | edge (µs) | window closes | VDD<VPOR↓,min at | `POR_RAW` asserts | rail there | `PGDG` falls | deglitch Δ | `RESETn` valid-low | margin to close | min `POR_RAW`/VDD | min `RESETn`/VDD | verdict |
|---|---|---|---|---|---|---|---|---|---|---|---|---|
| 3.351 | 784.8 | 834.8 | 420.8 | 70.9 | 3.3926 V | 602.3 | 531.4 | 603.7 | +231.1 | -0.0036 | -0.0000 | PASS |
| 3.4 | 773.5 | 823.5 | 414.7 | 71.7 | 3.3862 V | 601.2 | 529.5 | 602.9 | +220.6 | -0.0034 | -0.0000 | PASS |
| 3.42 | 769.0 | 819.0 | 412.3 | 72.1 | 3.3834 V | 601.6 | 529.5 | 603.3 | +215.7 | -0.0035 | -0.0000 | PASS |
| 3.44 | 764.5 | 814.5 | 409.9 | 72.5 | 3.3805 V | 601.7 | 529.2 | 603.6 | +210.9 | -0.0042 | -0.0000 | PASS |
| 3.46 | 760.1 | 810.1 | 407.5 | 73.0 | 3.3775 V | 661.1 | 588.1 | 675.6 | +134.5 | -0.0033 | -0.0000 | PASS |
| 3.4795 | 755.9 | 805.9 | 405.2 | 73.4 | 3.3744 V | **never** | — | 1074.4 | -268.5 | -0.0034 | 0.9986 | **FAIL** |
| 3.52 | 747.2 | 797.2 | 400.6 | 74.5 | 3.3677 V | **never** | — | 1062.8 | -265.6 | -0.0036 | 0.9986 | **FAIL** |
| 3.56 | 738.8 | 788.8 | 396.1 | 75.8 | 3.3603 V | 606.7 | 530.9 | 610.4 | +178.4 | -0.0034 | -0.0001 | PASS |
| 3.613 | 727.9 | 777.9 | 390.3 | 77.8 | 3.3491 V | 614.3 | 536.5 | 620.0 | +157.9 | -0.0033 | -0.0001 | PASS |
| 3.7 | 710.8 | 760.8 | 381.1 | 82.1 | 3.3261 V | 643.8 | 561.7 | 661.6 | +99.2 | -0.0032 | -0.0000 | PASS |
| 3.85 | 683.1 | 733.1 | 366.2 | 101.4 | 3.2395 V | **never** | — | 975.7 | -242.6 | -0.0033 | 0.9986 | **FAIL** |
| 4 | 657.5 | 707.5 | 352.5 | 1061.8 | 2.4174 V | **never** | — | 940.4 | -232.9 | 0.9990 | 0.9987 | **FAIL** |
| 4.2 | 626.2 | 676.2 | 335.7 | 1014.4 | 2.4204 V | **never** | — | 897.9 | -221.7 | 0.9990 | 0.9986 | **FAIL** |

A **never** in the `POR_RAW` column is DR-011's starved loop: no decision was taken during the dip at all. A `POR_RAW` time with a negative *margin to close* is the other failure mode entirely — the decision was taken, and the output chain, starved by the same collapse, did not finish propagating it before the dip window ran out.

`VPOR↑`/`VPOR↓` are ratified at 2.47–2.73 V / 2.22–2.63 V, so a *rail there* entry above 2.63 V is an assertion earlier than the ratified band allows — the separate defect DR-011 filed as #61, visible here but not this control's subject.

## B — is it the solver? 4× finer maximum timestep

One variable: the integration's maximum timestep. Part A runs the grid's own `tran 20u` with no `tmax`; the rows below are the same decks with `tmax = 5 µs`. The two rungs chosen are the pair whose disagreement **is** the reported non-monotonicity. If a knife-edge verdict were an artefact of where the timestep grid lands relative to the 50 µs dwell, tightening the bound would move it.

| slew (mV/µs) | supply | `RESETn` valid-low, coarse | fine | Δ | min `RESETn`/VDD, coarse | fine | verdict, coarse | fine |
|---|---|---|---|---|---|---|---|---|
| 3.4795 | 2.97 V | 883.80 | 884.40 | +0.60 | 0.9987 | 0.9987 | **FAIL** | **FAIL** |
| 3.4795 | 3.3 V | 979.10 | 979.80 | +0.70 | 0.9988 | 0.9988 | **FAIL** | **FAIL** |
| 3.4795 | 3.63 V | 1074.40 | 1075.40 | +1.00 | 0.9986 | 0.9987 | **FAIL** | **FAIL** |
| 3.613 | 2.97 V | 852.80 | 681.40 | -171.40 | 0.9987 | 0.9987 | **FAIL** | **FAIL** |
| 3.613 | 3.3 V | 641.70 | 646.00 | +4.30 | -0.0000 | -0.0000 | PASS | PASS |
| 3.613 | 3.63 V | 620.00 | 619.90 | -0.10 | -0.0001 | -0.0001 | PASS | PASS |

## C — the collapse itself

`V_sg` = `VDD − PG` is the overdrive on `bias_core`'s PMOS mirror bank, the node DR-011 measures the starved-loop collapse on (776.2 mV pre-dip → −74.4 mV, 8 µs into a 1 µs edge). Here it is at the instant `POR_RAW` asserts and at its worst point inside the dip window, for every Part A deck — the state variable the timeline above is a consequence of.

| slew (mV/µs) | V_sg @ `POR_RAW`, 2.97 V | V_sg @ `POR_RAW`, 3.3 V | V_sg @ `POR_RAW`, 3.63 V | min V_sg in dip, 2.97 V | min V_sg in dip, 3.3 V | min V_sg in dip, 3.63 V |
|---|---|---|---|---|---|---|
| 3.351 | 911.1 mV | 914.1 mV | 917.1 mV | 29.6 mV | -84.0 mV | -113.5 mV |
| 3.4 | 908.1 mV | 911.6 mV | 915.0 mV | 22.8 mV | -85.8 mV | -116.0 mV |
| 3.42 | 906.8 mV | 910.4 mV | 914.0 mV | 20.1 mV | -86.3 mV | -116.9 mV |
| 3.44 | 905.4 mV | 909.2 mV | 913.0 mV | 17.5 mV | -87.4 mV | -118.6 mV |
| 3.46 | 903.9 mV | 908.0 mV | 911.9 mV | 15.1 mV | -88.4 mV | -119.5 mV |
| 3.4795 | 902.3 mV | 906.6 mV | 910.8 mV | 12.9 mV | -89.2 mV | -120.1 mV |
| 3.52 | 898.7 mV | 903.6 mV | 908.3 mV | 9.0 mV | -91.0 mV | -121.9 mV |
| 3.56 | 894.5 mV | 900.2 mV | 905.6 mV | 5.6 mV | -92.5 mV | -123.7 mV |
| 3.613 | 888.7 mV | 894.8 mV | 901.2 mV | 1.6 mV | -93.8 mV | -125.7 mV |
| 3.7 | 869.9 mV | 882.1 mV | 891.8 mV | -5.0 mV | -93.5 mV | -127.1 mV |
| 3.85 | 702.5 mV | 680.7 mV | 852.6 mV | -20.0 mV | -91.8 mV | -126.2 mV |
| 4 | 700.3 mV | 677.7 mV | 657.8 mV | -28.0 mV | -92.9 mV | -126.5 mV |
| 4.2 | 694.9 mV | 674.3 mV | 659.1 mV | -36.5 mV | -94.3 mV | -127.4 mV |

V_sg pre-dip, for reference: 2.97 V → 951.6 mV, 3.3 V → 951.5 mV, 3.63 V → 951.4 mV (identical at every slew — the dip has not started yet).

## D — the deglitch ramp that runs out of time

`NDG` is `por_output_chain`'s deglitch capacitor node: it has to traverse `CDG` at I/C before `XMG1` flips `PGDG`, and both the current and `XMG1`'s trip point are collapsing with the rail while it does. `design/por_output_chain.md` sizes that dwell at 1.86–4.58 µs at nominal `IBIAS` (8.88 µs at half) — the numbers below are the same dwell running on whatever bias survives the brownout. *ramp at close* is `NDG`/VDD at the instant the dip window ends; *lowest PGDG* is how far `PGDG` was dragged down before the window closed (1.0 = never moved, ~0 = flipped).

### ss / -40 °C / 2.97 V

| slew (mV/µs) | peak `NDG`/VDD in dip | ramp at close | lowest `PGDG`/VDD in dip | verdict |
|---|---|---|---|---|
| 3.351 | 0.6377 | 0.6413 | -0.0038 | PASS |
| 3.4 | 0.6257 | 0.6286 | -0.0044 | PASS |
| 3.42 | 0.6209 | 0.6230 | -0.0052 | PASS |
| 3.44 | 0.6171 | 0.6171 | -0.0056 | PASS |
| 3.46 | 0.6090 | 0.6108 | -0.0012 | PASS |
| 3.4795 | 0.5177 | 0.4972 | 0.9197 | **FAIL** |
| 3.52 | 0.4063 | 0.3879 | 0.9983 | **FAIL** |
| 3.56 | 0.3319 | 0.3137 | 0.9985 | **FAIL** |
| 3.613 | 0.2652 | 0.2473 | 0.9991 | **FAIL** |
| 3.7 | 0.5161 | 0.5181 | 0.9992 | **FAIL** |
| 3.85 | 0.0000 | -0.0003 | 0.9990 | **FAIL** |
| 4 | 0.0000 | -0.0003 | 0.9990 | **FAIL** |
| 4.2 | 0.0000 | -0.0003 | 0.9990 | **FAIL** |

### ss / -40 °C / 3.3 V

| slew (mV/µs) | peak `NDG`/VDD in dip | ramp at close | lowest `PGDG`/VDD in dip | verdict |
|---|---|---|---|---|
| 3.351 | 0.6801 | 0.6801 | -0.0015 | PASS |
| 3.4 | 0.6688 | 0.6688 | -0.0023 | PASS |
| 3.42 | 0.6639 | 0.6639 | -0.0024 | PASS |
| 3.44 | 0.6571 | 0.6588 | -0.0027 | PASS |
| 3.46 | 0.5410 | 0.5256 | 0.7831 | **FAIL** |
| 3.4795 | 0.5023 | 0.4878 | 0.9978 | **FAIL** |
| 3.52 | 0.4383 | 0.4242 | 0.9983 | **FAIL** |
| 3.56 | 0.6225 | 0.6225 | -0.0050 | PASS |
| 3.613 | 0.6001 | 0.6018 | -0.0015 | PASS |
| 3.7 | 0.5647 | 0.5667 | 0.7959 | **FAIL** |
| 3.85 | 0.0000 | -0.0006 | 0.9990 | **FAIL** |
| 4 | 0.0000 | -0.0006 | 0.9990 | **FAIL** |
| 4.2 | 0.0000 | -0.0006 | 0.9990 | **FAIL** |

### ss / -40 °C / 3.63 V

| slew (mV/µs) | peak `NDG`/VDD in dip | ramp at close | lowest `PGDG`/VDD in dip | verdict |
|---|---|---|---|---|
| 3.351 | 0.7167 | 0.7167 | -0.0001 | PASS |
| 3.4 | 0.7049 | 0.7064 | -0.0002 | PASS |
| 3.42 | 0.7020 | 0.7020 | -0.0002 | PASS |
| 3.44 | 0.6311 | 0.6169 | -0.0019 | PASS |
| 3.46 | 0.5798 | 0.5670 | -0.0088 | PASS |
| 3.4795 | 0.5508 | 0.5388 | 0.6694 | **FAIL** |
| 3.52 | 0.4968 | 0.4855 | 0.9985 | **FAIL** |
| 3.56 | 0.6644 | 0.6662 | -0.0019 | PASS |
| 3.613 | 0.6470 | 0.6496 | -0.0029 | PASS |
| 3.7 | 0.6143 | 0.6170 | -0.0055 | PASS |
| 3.85 | 0.5346 | 0.5362 | 0.9993 | **FAIL** |
| 4 | 0.0000 | -0.0009 | 0.9990 | **FAIL** |
| 4.2 | 0.0000 | -0.0009 | 0.9990 | **FAIL** |

A FAIL row whose peak `NDG`/VDD sits just short of the level the PASS rows cross at is a **near-tangency**, not a dead circuit: the ramp and the falling trip point it is chasing come close and separate again. That is the shape that makes the verdict non-monotonic in slew while every state variable in section C stays monotone.
