2AMLogic/gf180-temp-por/sim/por-brownout/control/results.md

# `por-brownout` root-cause control — results

**Generated by `run_dip_rootcause.py`. Do not edit — re-run it.** Every number below is read out of `logs/` by that script; nothing here is transcribed by hand.

- PVT point: `tt` / 27 °C / 3.3 V (one point — a control is not corner evidence, see `sim/README.md`)
- PDK: `gf180mcuD` @ `c6d73a35f524070e85faff4a6a9eef49553ebc2b`
- Harness version: `0.1.0`
- Solver options (from `../testbench/tb.json`): `reltol=1e-4`, `abstol=1e-13`, `vntol=1e-8`, `method=gear`
- DUT netlists: `design/netlist/temp_por_top.spice` (sha256 `1cb191d10e6a…`), `design/netlist/por_output_chain.spice` (sha256 `b9e04ce52c0d…`)
- Diagnoses: `../records/20260801-233807-32fbaa0.md` (`resetn_floor_in_dip_mv` = 999.959–1000 mV, 0/81 PASS)
- Conclusion drawn from these tables: `spec/decision-records/DR-011-brownout-falling-slew-limit.md`

## A — dip depth (parent deck's 1 µs edge)

One variable: how deep the dip goes. `bias_core`'s measured operating floor is `vdd_ref90_v` = 1.127–1.788 V (`design/bias_core.md`), so 2.30 V and 1.90 V are **above** it and 1.50 V / 1.00 V are **below** it. `V_sg` is `VDD − PG`, the overdrive on `bias_core`'s PMOS mirror bank.

| dip depth | VREF @ VDD=2.39 V | SNS @ VDD=2.39 V | V_sg pre-dip | V_sg @ +8 µs | VREF @ +8 µs | POR_RAW asserts | min RESETn/VDD in dip | RESETn asserts |
|---|---|---|---|---|---|---|---|---|
| 2.30 V | 1.0067 V | 1.5857 V | 776.2 mV | 207.1 mV | 0.5401 V | **never** | 0.9993 | 3.1922 V, +51.9 µs, **on recovery** |
| 1.90 V | 1.0524 V | 1.5926 V | 776.2 mV | 23.4 mV | 0.5395 V | **never** | 0.9993 | 2.8132 V, +51.7 µs, **on recovery** |
| 1.50 V | 1.0810 V | 1.5969 V | 776.2 mV | -49.6 mV | 0.5391 V | 3.3000 V, +52.7 µs, **on recovery** | 0.9993 | 2.4299 V, +51.5 µs, **on recovery** |
| 1.00 V | 1.1036 V | 1.6001 V | 776.2 mV | -74.4 mV | 0.5384 V | 3.3000 V, +52.1 µs, **on recovery** | 0.9990 | 1.9483 V, +51.4 µs, **on recovery** |

VREF pre-dip is 1.1993 V and V_sg pre-dip is 776.2 mV at every depth — the dip has not started yet, so those two columns are a fixed reference point, not a variable.

## B — dip edge rate (parent deck's 1.0 V depth)

One variable: how fast the rail falls. The parent deck's 1 µs edge is 2.30 V/µs; `spec/target-spec.md#por-ramp-rate` ratifies an envelope only for 0 → VDD **rising** ramps (1 V/s … 1 V/µs), so no ratified value governs this column.

| edge | slew | t below VPOR↓,min | VREF @ VDD=2.39 V | V_sg @ VDD=2.39 V | min BIAS_OK/VDD in dip | min POR_RAW/VDD in dip | POR_RAW asserts | min RESETn/VDD in dip | RESETn asserts |
|---|---|---|---|---|---|---|---|---|---|
| 1 µs | 2.300 V/µs | 51.0 µs | 1.1036 V | 362.5 mV | 0.9990 | 0.9990 | 3.3000 V, +52.1 µs, **on recovery** | 0.9990 | 1.9483 V, +51.4 µs, **on recovery** |
| 100 µs | 23.00 mV/µs | 156.0 µs | 0.4501 V | 277.4 mV | 0.9990 | 0.9990 | 2.7877 V, +227.7 µs, **on recovery** | 0.9986 | 1.7555 V, +182.8 µs, **on recovery** |
| 150 µs | 15.33 mV/µs | 209.2 µs | 0.4412 V | 302.7 mV | 0.9990 | 0.9990 | 2.7755 V, +315.8 µs, **on recovery** | 0.9987 | 1.7441 V, +248.5 µs, **on recovery** |
| 200 µs | 11.50 mV/µs | 262.2 µs | 0.4370 V | 332.1 mV | 0.9990 | 0.9990 | 2.7122 V, +398.9 µs, **on recovery** | 0.9987 | 1.7344 V, +313.9 µs, **on recovery** |
| 300 µs | 7.67 mV/µs | 368.2 µs | 0.4417 V | 434.0 mV | 0.0005 | -0.0036 | 2.9941 V, +39.9 µs, in dip | -0.0000 | 2.1704 V, +147.3 µs, in dip |
| 1 ms | 2.30 mV/µs | 1110.8 µs | 1.1195 V | 769.6 mV | -0.0000 | -0.0039 | 3.1385 V, +70.2 µs, in dip | -0.0000 | 3.0333 V, +115.9 µs, in dip |
| 3 ms | 0.77 mV/µs | 3232.6 µs | 1.1747 V | 774.5 mV | -0.0000 | -0.0001 | 2.3828 V, +1.196 ms, in dip | -0.0000 | 2.3757 V, +1.206 ms, in dip |

The two rail-normalised minima are the diagnostic pair. A value near **1.0** means the node rode the rail down without ever resolving — for `BIAS_OK` that is a **false valid**, `bias_core` asserting *bias is good* throughout the very collapse that starves it. A value near **0** means the node actually resolved.

`VPOR↑`/`VPOR↓` are ratified at 2.47–2.73 V / 2.22–2.63 V, so a `POR_RAW asserts` entry above 2.73 V is a **spurious** assertion at a rail that is still inside the ratified operating range, not a correct one.

## C — `por_output_chain` alone at the 1.0 V dip rail

One variable: the current still reaching `IBIAS` during the dip. `POR_RAW` is **driven** low here, i.e. this half assumes the comparator did its job (on the assembly it does not). *Reachability* is the free-running DUT into 5 pF; *capability* is the twin DUT with `RESETn` clamped at the 100 mV valid-low bound.

| IBIAS in dip | RESETn pre-dip | RESETn reaches 0.1×VDD at | min RESETn in dip | RESETn @ end of 50 µs dwell | NDG @ end | PGDG @ end | I sunk @ 100 mV, released | I sunk @ 100 mV, in dip |
|---|---|---|---|---|---|---|---|---|
| 1x (500 nA) | 3.3000 V | 3.70 µs | -0.000011 V | 0.000000 V | 1.0000 V | 0.0000 V | -69.9 µA | +71.1 µA |
| 0.5x (250 nA) | 3.3000 V | 4.60 µs | -0.000011 V | 0.000000 V | 1.0000 V | 0.0000 V | -69.9 µA | +71.1 µA |
| 0.1x (50 nA) | 3.3000 V | 6.40 µs | -0.000011 V | 0.000000 V | 1.0000 V | 0.0000 V | -69.9 µA | +71.1 µA |
| 0x (0 nA) | 3.3000 V | 7.30 µs | -0.000010 V | 0.000000 V | 1.0018 V | 0.0000 V | -69.9 µA | +71.1 µA |

Sign convention: **positive = the cell is sinking**, i.e. pulling `RESETn` down against the clamp. The negative pre-dip column is the released state doing the opposite — `XMOP` sourcing into a clamp held 3.2 V below the rail — and is there only to show the probe is reading a real, state-dependent current.

## D — counterfactual: hold `bias_core`'s mirror gate to VDD

One variable: a VDD-referenced MIM capacitor added on `PG`, `bias_core`'s PMOS mirror gate. **This is a hypothesis probe, not a proposed design** — 20 pF is 10 000 µm² of MIM, three times the whole one-shot capacitor, and nothing in `design/` is changed by this control. Its only purpose is to test whether `PG`'s inability to follow a falling rail is the *cause* of the collapse, by removing it.

| PG hold cap | dwell | VREF @ +8 µs | V_sg @ +8 µs | POR_RAW asserts | min RESETn/VDD in dip | RESETn asserts |
|---|---|---|---|---|---|---|
| none | 50 µs | 0.5384 V | -74.4 mV | 3.3000 V, +52.1 µs, **on recovery** | 0.9990 | 1.9483 V, +51.4 µs, **on recovery** |
| 20p | 50 µs | 0.7266 V | 706.7 mV | 1.0000 V, +19.6 µs, in dip | 0.9989 | 1.9392 V, +51.4 µs, **on recovery** |
| 20p-long | 5 ms | 0.7266 V | 706.7 mV | 1.0000 V, +19.6 µs, in dip | -0.0000 | 1.0000 V, +52.3 µs, in dip |

The 50 µs `20p` row restores `POR_RAW` but **not** `RESETn`. The `20p-long` row is the same counterfactual against a 100× longer dwell, and it is what distinguishes *`por_output_chain` has an independent defect* from *`POR_RAW` simply arrived too late for a bias-starved deglitch to finish inside 50 µs*.

## E — dip duration (parent deck's 1 µs edge and 1.0 V depth)

One variable: how long the dip lasts. A and B cannot separate *the rail fell too fast to track* from *the dip was over before the loop could respond*, because lengthening B's edge lengthens the time below VPOR↓ too. E holds the edge at the parent deck's own 1 µs and varies only the dwell, so the boundary it finds is a **response time** — the quantity `spec/target-spec.md#por-brownout`'s `T_dip,min` row is written against. `t below VPOR↓,min` is the spec's own clock (rail below the ratified 2.22 V), which exceeds the programmed dwell by the two edge transits.

| dwell | t below VPOR↓,min | POR_RAW asserts | min RESETn/VDD in dip | min RESETn in dip | RESETn asserts |
|---|---|---|---|---|---|
| 50 µs | 51.0 µs | 3.3000 V, +52.1 µs, **on recovery** | 0.9990 | 0.999970 V | 1.9483 V, +51.4 µs, **on recovery** |
| 200 µs | 201.0 µs | 3.3000 V, +202.1 µs, **on recovery** | 0.9990 | 0.999970 V | 1.8991 V, +201.4 µs, **on recovery** |
| 500 µs | 501.0 µs | 3.3000 V, +502.1 µs, **on recovery** | 0.9990 | 0.999970 V | 1.8833 V, +501.4 µs, **on recovery** |
| 1 ms | 1001.0 µs | 3.3000 V, +1.002 ms, **on recovery** | 0.9990 | 0.999970 V | 1.8738 V, +1.001 ms, **on recovery** |
| 2 ms | 2001.0 µs | 3.3000 V, +2.002 ms, **on recovery** | 0.9990 | 0.999970 V | 1.8699 V, +2.001 ms, **on recovery** |
| 5 ms | 5001.0 µs | 3.3000 V, +5.002 ms, **on recovery** | 0.9990 | 0.999970 V | 1.8599 V, +5.001 ms, **on recovery** |

The parent record's own deck is the first row. `T_dip,min` is ratified at 10 µs; the spec's qualifying-dip clock for that row is the ~51 µs of `t below VPOR↓,min`, i.e. 5× the ratified minimum.
