2AMLogic/gf180-temp-por/sim/temp-accuracy-mc/control/results.md

# mismatch-switch control -- generated, do not edit

Generated by `sim/temp-accuracy-mc/control/run_mismatch_switch.py`. Re-run it
to regenerate this file, the six decks under `decks/` and the six raw ngspice
logs under `logs/`. The numbers quoted in `sim/harness/montecarlo.py`'s module
docstring and in `../testbench/stimulus.spice` are transcribed from here, and
from nowhere else.

Two variables, one at a time: the `.param sw_stat_mismatch` override (absent /
present-after-the-`.include` / present-before-it) and `.option seed`. All six
decks are composed from `mismatch_switch.spice` +
`design/netlist/temp_core.spice` in the same process, at tt / 27 C /
VDD = 3.3 V, plain `op`.

## Result

| | off, seed 1001 | off, seed 2002 | **on**, seed 1001 | **on**, seed 1001 (re-run) | **on**, seed 2002 | on *before* the .include, seed 1001 |
| --- | ---: | ---: | ---: | ---: | ---: | ---: |
| `V(PTAT)` -- the PTAT output | 1.293341335 V | 1.293341335 V | 1.273292249 V | 1.273292249 V | 1.29664858 V | 1.293341335 V |
| `V(CTAT)` -- the CTAT output | 0.6533472409 V | 0.6533472409 V | 0.6528124965 V | 0.6528124965 V | 0.65337988 V | 0.6533472409 V |
| `V(NA)` -- amplifier input, PTAT side | 0.6533472671 V | 0.6533472671 V | 0.6528125227 V | 0.6528125227 V | 0.6533799062 V | 0.6533472671 V |
| `V(NB)` -- amplifier input, 1x PNP side | 0.6533496535 V | 0.6533496535 V | 0.6521713104 V | 0.6521713104 V | 0.6528817949 V | 0.6533496535 V |
| `V(NC)` -- 8x PNP emitter | 0.5994708368 V | 0.5994708368 V | 0.5990840675 V | 0.5990840675 V | 0.5993274142 V | 0.5994708368 V |
| `V(NA) - V(NB)` -- amplifier input-referred offset | -2.39 uV | -2.39 uV | 641.21 uV | 641.21 uV | 498.11 uV | -2.39 uV |

## The three mechanism claims

| comparison | expected | observed | status | why it matters |
| --- | --- | --- | --- | --- |
| `off-seedA` vs `off-seedB` | identical | **identical** | OK | with the switch off, the seed changes nothing -- so any spread seen below is the mismatch models, not run-to-run solver noise |
| `off-seedA` vs `on-seedA` | differ | **differ** | OK | **claim 1**: `.param sw_stat_mismatch=1` really does engage the PDK's `statistical` models |
| `on-seedA` vs `on-seedA-repeat` | identical | **identical** | OK | **claim 2a**: a seed reproduces its die exactly, so an N-sample population is re-derivable from the manifest |
| `on-seedA` vs `on-seedB` | differ | **differ** | OK | **claim 2b**: a different seed draws a different die, so N samples are N dice and not one die N times |
| `off-seedA` vs `on-before-includes-seedA` | identical | **identical** | OK | **claim 3**: an override placed *before* the `.include` is overwritten by `design.ngspice`'s own `sw_stat_mismatch=0` and has no effect -- the harness's after-the-includes ordering is load-bearing, not cosmetic |

All five comparisons came out as expected.

## What the numbers say

- With mismatch **off** the amplifier's input-referred offset is the
  systematic **-2.39 uV** `design/temp_core.md` quotes, and it is the same
  number at either seed. With mismatch **on** the same node pair reads
  **641.21 uV** at seed 1001 and **498.11 uV** at seed 2002 -- three orders
  of magnitude larger, and seed-dependent. That size gap is the whole reason
  the [3sigma] rows cannot be closed on deterministic corners.
- `V(PTAT)` moves from **1.293341 V** (mismatch off) to **1.273292 V** /
  **1.296649 V** on the two mismatched dice: -20.049 mV and +3.307 mV. At
  the cell's ~4.31 mV/K that is -4.65 C and +0.77 C of untrimmed temperature
  error from two arbitrary dice -- consistent in magnitude with the sigma
  the N>=500 records report, from two samples instead of two thousand.
- Every deck under `decks/` is byte-identical apart from the `.option seed=`
  line and the presence/position of one `.param sw_stat_mismatch=1` line;
  `diff` them to confirm the control really is one-variable.

## Environment

- PDK: gf180mcuD @ open_pdks `c6d73a35f524070e85faff4a6a9eef49553ebc2b` (/Users/rwalters/.volare/gf180mcuD, found via search_root:~/.volare)
- ngspice: ngspice-46 : Circuit level simulation program
- Harness: sim/harness 0.1.0 (corner sections and solver options only), python 3.14.6
- git: `21e48c55b273c3f2cfcb7f2af31a0aec9e8d622c (clean apart from this experiment's own outputs)`
- Corner sections: typical res_typical bjt_typical diode_typical moscap_typical mimcap_typical
- Solver options (from `../testbench/tb.json`): reltol=1e-5 abstol=1e-15 vntol=1e-9
- `mismatch_switch.spice` sha256: `741d7879b5a7256457d18aba00193b25cdd6859518ea992c9d3e7890779155d8`
- `design/netlist/temp_core.spice` sha256: `c017e15399812a21ff04ac037d785e3c6b1fa77b5b0c45080fcacf6b9a5e64d4`
