2AMLogic/gf180-temp-por/sim/devchar/results/derived_metrics_20260731T145914Z.md

# Derived metrics (auto-generated by run_devchar.py)

## PNP
- VBE(27C, typical, pnp_10p00x10p00, x1, 10uA) = 0.689299 V
- dVBE/dT (typical, pnp_10p00x10p00, x1, 10uA, linear fit over -40..125 C) = -1.8319 mV/C
- delta-VBE(27C, typical, 8:1 ratio) = 53.964 mV (Vt*ln(8) = 53.785 mV, error = 0.33%)
- delta-VBE(27C, typical, 4:1 ratio) = 35.999 mV (Vt*ln(4) = 35.856 mV, error = 0.40%)
- bjt_typical: VBE(-40C)=0.8091V, VBE(125C)=0.5070V, avg dVBE/dT=-1.8310 mV/C
- bjt_ss: VBE(-40C)=0.8156V, VBE(125C)=0.5193V, avg dVBE/dT=-1.7957 mV/C
- bjt_ff: VBE(-40C)=0.8046V, VBE(125C)=0.4984V, avg dVBE/dT=-1.8559 mV/C

## Resistors
- ppolyf_u: res_typical=9038.7 ohm, res_ss=10834.2 ohm, res_ff=7243.3 ohm
    typical TC (-40..125 C, endpoint) = -74.8 ppm/C
- ppolyf_u_1k: res_typical=25413.5 ohm, res_ss=30479.2 ohm, res_ff=20347.9 ohm
    typical TC (-40..125 C, endpoint) = -871.8 ppm/C
- ppolyf_u_2k: res_typical=51207.7 ohm, res_ss=61442.4 ohm, res_ff=40972.9 ohm
    typical TC (-40..125 C, endpoint) = -1545.2 ppm/C
- ppolyf_u_3k: res_typical=76794.9 ohm, res_ss=95984.9 ohm, res_ff=57604.4 ohm
    typical TC (-40..125 C, endpoint) = -1544.7 ppm/C
- nplus_u: res_typical=1450.1 ohm, res_ss=1808.2 ohm, res_ff=1092.0 ohm
    typical TC (-40..125 C, endpoint) = 1373.3 ppm/C
- pplus_u: res_typical=4819.2 ohm, res_ss=5849.8 ohm, res_ff=3788.4 ohm
    typical TC (-40..125 C, endpoint) = 1365.2 ppm/C
- npolyf_u: res_typical=7979.8 ohm, res_ss=9516.3 ohm, res_ff=6443.2 ohm
    typical TC (-40..125 C, endpoint) = -1324.0 ppm/C
- nwell: res_typical=32591.0 ohm, res_ss=39044.8 ohm, res_ff=26137.4 ohm
    typical TC (-40..125 C, endpoint) = 2609.6 ppm/C

## MOS
- nfet_03v3: Vt(27C,typical)=0.6444 V, SS(27C,typical)=85.14 mV/dec, Ion(27C,typical)=2.4972e-03 A
    dVt/dT (-40..125 C) = -1.0062 mV/C
    typical: Vt(27C)=0.6444 V
    ss: Vt(27C)=0.7547 V
    ff: Vt(27C)=0.5341 V
    fs: Vt(27C)=0.5641 V
    sf: Vt(27C)=0.7248 V
- nfet_06v0_nvt: Vt(27C,typical)=-0.1202 V, SS(27C,typical)=79.57 mV/dec, Ion(27C,typical)=2.5827e-03 A
    dVt/dT (-40..125 C) = -1.2210 mV/C
    typical: Vt(27C)=-0.1202 V
    ss: Vt(27C)=0.0984 V
    ff: Vt(27C)=-0.3401 V
    fs: Vt(27C)=-0.2674 V
    sf: Vt(27C)=0.0251 V
- pfet_03v3: Vt(27C,typical)=-0.8429 V, SS(27C,typical)=90.44 mV/dec, Ion(27C,typical)=7.3041e-04 A
    dVt/dT (-40..125 C) = 0.9339 mV/C
    typical: Vt(27C)=-0.8429 V
    ss: Vt(27C)=-0.9697 V
    ff: Vt(27C)=-0.7162 V
    fs: Vt(27C)=-0.9345 V
    sf: Vt(27C)=-0.7513 V
