2AMLogic/gf180-temp-por/work_log/WORK_LOG_2026-09.md

# Work Log Archive — 2026-09

Sections moved byte-for-byte from [WORK_LOG.md](../WORK_LOG.md) by `loom-daemon work-docs archive`.

### 2026-09-10

- **PR #299**: sim: post-layout re-run of temp_core's loop-stability testbench (#298)
- **Issue #298** (closed): sim: post-layout re-run of temp_core's .ac loop-stability testbench against layout/postlayout/temp_core.spice (closes the one temp_core testbench without an extracted sibling)

### 2026-09-09

- **Issue #297** (closed): Champion: Merge-Risk Hold Digest
- **Issue #145** (closed): Track the gap to T1 sim-validated / bronze (klayout-tools design-evidence tiers)
