2AMLogic/gf180-temp-por/sim/temp-core-loop-stability/testbench-postlayout/tb_temp_core_loop_stability_postlayout.spice

* tb_temp_core_loop_stability_postlayout -- HAND-MAINTAINED, not
* sim/build_tb.py output.
*
* POST-LAYOUT SIBLING (issue #298) of
* sim/temp-core-loop-stability/testbench/tb_temp_core_loop_stability.spice
* (issue #274, the schematic-level loop-break testbench) -- read that file's
* header first for the full method: why the loop is broken at PG, why PG
* itself stays put and only the two feedback-closing gates move, and the
* algebra showing the measured ratio T(jw) = V(xdut.pg)/V(pg_fb) does not
* depend on the injection source's polarity or amplitude. This file applies
* the identical break technique to the EXTRACTED netlist instead of the
* schematic export, so it cannot be sim/build_tb.py output either:
* build_tb.py only ever appends a cell VERBATIM after the stimulus, and this
* fragment edits lines *inside* the subcircuit body -- a verbatim copy has
* nothing to attach that edit to.
*
* ---- Forked from ------------------------------------------------------
*
* Forked from layout/postlayout/temp_core.spice (sha256
* 3478dd380f65b23d0a257c7b6948b24cbc395b475061bba1a584490570164e92)
*
* That digest is checked on every CI run by sim/tests/test_postlayout_forks.py:
* if layout/postlayout/temp_core.spice is regenerated (new layout, new klt)
* the test fails, naming this file, so the drift cannot go unnoticed the way
* it did between #314 and #316. `python3 sim/build_tb.py --check` cannot
* catch it -- this fragment is deliberately outside that mechanism, exactly
* like its schematic sibling. When it does fail: re-diff this file against
* the regenerated netlist, re-apply the four edits below by hand, and update
* the digest.
*
* ---- What changed vs layout/postlayout/temp_core.spice -------------------
*
* THE PARASITIC MODEL MATTERS HERE, so state it first. layout/postlayout.py
* models each net's drawn interconnect as one resistive STAR
* (layout/postlayout/AUDIT.md -> "The parasitic model"): the net's own name
* is the hub, each device terminal on it is a <net>__t<k> node, the net's one
* lumped series resistance is split across the R<net>_t<k> arms joining them,
* and its lumped capacitance sits on the hub. So PG's twelve device terminals
* are PG__t0 .. PG__t11, each behind its own arm to the hub node PG, and no
* device card names PG directly.
*
* In the extracted netlist, XMP1/XMP2 -- the schematic's names for the two
* mirror legs whose gates actually close the loop -- are each split by the
* layout into two parallel unit devices: XMP1 -> X36 + X47 (drain M1D),
* XMP2 -> X38 + X45 (drain M2D). XMP3, the dead-end PTAT-readout leg that
* does NOT feed back into the amplifier's own inputs (see the schematic
* fragment's header), is likewise split into X40 + X43 (drain M3D) and is
* deliberately left on PG here, exactly as the schematic fragment leaves
* XMP3 on PG. So this fork, applied to a verbatim copy of
* layout/postlayout/temp_core.spice, changes exactly:
*   1. `.subckt temp_core VDD VSS IBIAS EN PTAT CTAT` ->
*      `.subckt temp_core_loopbreak_postlayout VDD VSS IBIAS EN PTAT CTAT
*      PG_FB` (rename + one new port, so this can never be confused with the
*      real extracted temp_core.spice or accidentally instantiated in its
*      place)
*   2. `RPG_t7  PG__t7  PG 151.271388757` -> `... PG_FB`   (X47's gate arm)
*   3. `RPG_t8  PG__t8  PG 234.368666133` -> `... PG_FB`   (X45's gate arm)
*   4. `RPG_t10 PG__t10 PG 599.142193276` -> `... PG_FB`   (X36's gate arm)
*   5. `RPG_t11 PG__t11 PG 514.848951694` -> `... PG_FB`   (X38's gate arm)
*   6. `.ends temp_core` -> `.ends temp_core_loopbreak_postlayout`
*
* WHY THE ARMS AND NOT THE DEVICE CARDS. The four broken gates sit on
* PG__t7/t8/t10/t11, and each of those nodes is on exactly two cards: its own
* device and its own arm. Moving the DEVICE card's gate to PG_FB would leave
* its arm hanging off PG on a single card -- a node connected to one element,
* which is not what the break means and is worse conditioned besides. Moving
* the ARM's hub end instead keeps each gate behind its own drawn interconnect
* resistance, on the receiving side of the break where that metal physically
* is, and leaves no node with fewer connections than it had. Both spellings
* remove the same feedback path; only this one leaves the netlist a connected
* graph. (Issue #316, which re-derived the same hub-collapse reasoning for
* sim/por-brownout-slew/control/run_net_attribution.py's net-shorting
* manipulation.)
*
* X40 and X43 (M3D, the dead-end leg) are untouched: their arms RPG_t2 and
* RPG_t9 stay on PG, as do the other six PG arms (X7, X15, X49, X54, X55 and
* the XCC plate X65). Nothing else in the subcircuit body was touched -- in
* particular `CPG PG VSS 6.8139567e-14`, PG's lumped interconnect
* capacitance, and `Ccc_NZ_PG NZ PG`, its coupling to the compensation node,
* both stay on PG: that is the amplifier's own output metal, which is on the
* driving side of the break. PG_FB carries no interconnect model of its own
* (it is not a drawn net at all -- it exists only in this fork); its only
* load is the four gate arms above plus the injection source.
*
* Verified against the mapping the Curator spot-checked in issue #298's own
* review comment, re-applied to the regenerated netlist in #316.
*
* Netlist FRAGMENT: no .include / .lib / .temp / .control / .end -- the
* harness owns those (sim/harness/README.md). Parameters it supplies:
* vdd_val, vdd_nom, temp_c.

* ---- stimulus: one enabled DUT, PG broken out for AC injection ----------
* Identical to the schematic sibling's stimulus (same DUT port list and
* same 1 Tohm effectively-unloaded pad convention), except the instantiated
* subcircuit is this file's extracted temp_core_loopbreak_postlayout.
vsup  vdd 0 dc {vdd_val}
ven   en  0 dc {vdd_val}
xdut  vdd 0 ibias en ptat ctat pg_fb temp_core_loopbreak_postlayout
ibref vdd ibias dc 500n
Rlp   ptat 0 1T
Rlc   ctat 0 1T

* Loop-break injection: DC 0 (so the DC operating point is unaffected -- see
* the schematic sibling's header for the algebra, unchanged here) / AC 1
* (the small-signal stimulus the .ac sweep uses).
vac   pg_fb xdut.pg dc 0 ac 1

* temp_core_loopbreak_postlayout -- hand-forked from
* layout/postlayout/temp_core.spice (see header above for exactly what
* changed and why).
.subckt temp_core_loopbreak_postlayout VDD VSS IBIAS EN PTAT CTAT PG_FB

* --- drawn devices ---
X1 VSS__t87 VSS__t88 VSS__t86 VSS__t59 nfet_03v3 L=8u W=4u nf=1 ad=3.2p as=3.2p pd=9.6u ps=9.6u m=1
X2 N1__t7 N1__t5 VSS__t119 VSS__t60 nfet_03v3 L=8u W=4u nf=1 ad=3.2p as=3.2p pd=9.6u ps=9.6u m=1
X3 N2__t5 N1__t2 VSS__t115 VSS__t61 nfet_03v3 L=8u W=4u nf=1 ad=3.2p as=3.2p pd=9.6u ps=9.6u m=1
X4 N2__t6 N1__t3 VSS__t116 VSS__t62 nfet_03v3 L=8u W=4u nf=1 ad=3.2p as=3.2p pd=9.6u ps=9.6u m=1
X5 N1__t6 N1__t4 VSS__t117 VSS__t63 nfet_03v3 L=8u W=4u nf=1 ad=3.2p as=3.2p pd=9.6u ps=9.6u m=1
X6 VSS__t114 VSS__t113 VSS__t118 VSS__t64 nfet_03v3 L=8u W=4u nf=1 ad=3.2p as=3.2p pd=9.6u ps=9.6u m=1
X7 PG__t0 N2__t0 VSS__t89 VSS__t65 nfet_03v3 L=8u W=8u nf=1 ad=6.4p as=6.4p pd=17.6u ps=17.6u m=1
X8 IBIAS__t1 NBG__t0 VSS__t90 VSS__t66 nfet_03v3 L=2u W=4u nf=1 ad=3.2p as=3.2p pd=9.6u ps=9.6u m=1
X9 IBIAS__t0 EN__t0 NBG__t1 VSS__t69 nfet_03v3 L=0.5u W=2u nf=1 ad=1.6p as=1.6p pd=5.6u ps=5.6u m=1
X10 NBG__t2 ENB__t6 VSS__t92 VSS__t70 nfet_03v3 L=0.5u W=2u nf=1 ad=1.6p as=1.6p pd=5.6u ps=5.6u m=1
X11 PB__t5 NBG__t4 VSS__t112 VSS__t67 nfet_03v3 L=2u W=4u nf=1 ad=3.2p as=3.2p pd=9.6u ps=9.6u m=1
X12 PCAS__t0 NBG__t3 VSS__t111 VSS__t68 nfet_03v3 L=2u W=4u nf=1 ad=3.2p as=3.2p pd=9.6u ps=9.6u m=1
X13 ENB__t0 EN__t1 VSS__t93 VSS__t72 nfet_03v3 L=0.5u W=1u nf=1 ad=0.8p as=0.8p pd=3.6u ps=3.6u m=1
X14 ND__t2 NR__t0 VSS__t94 VSS__t73 nfet_03v3 L=2u W=2u nf=1 ad=1.6p as=1.6p pd=5.6u ps=5.6u m=1
X15 PG__t1 ND__t0 VSS__t91 VSS__t75 nfet_03v3 L=1u W=4u nf=1 ad=3.2p as=3.2p pd=9.6u ps=9.6u m=1
X16 NR__t1 NR__t3 VSS__t109 VSS__t74 nfet_03v3 L=2u W=2u nf=1 ad=1.6p as=1.6p pd=5.6u ps=5.6u m=1
X17 ND__t3 ENB__t7 VSS__t110 VSS__t71 nfet_03v3 L=0.5u W=2u nf=1 ad=1.6p as=1.6p pd=5.6u ps=5.6u m=1
X18 PTAT__t0 ENB__t1 VSS__t95 VSS__t76 nfet_03v3 L=1u W=1u nf=1 ad=0.8p as=0.8p pd=3.6u ps=3.6u m=1
X19 CTAT__t1 ENB__t5 VSS__t108 VSS__t77 nfet_03v3 L=1u W=1u nf=1 ad=0.8p as=0.8p pd=3.6u ps=3.6u m=1
X20 N2__t1 ENB__t2 VSS__t96 VSS__t78 nfet_03v3 L=1u W=2u nf=1 ad=1.6p as=1.6p pd=5.6u ps=5.6u m=1
X21 NT__t11 ENB__t4 VSS__t107 VSS__t79 nfet_03v3 L=1u W=2u nf=1 ad=1.6p as=1.6p pd=5.6u ps=5.6u m=1
X22 T5__t0 VDD__t0 T4__t0 VSS__t80 nfet_03v3 L=0.5u W=32u nf=1 ad=25.6p as=25.6p pd=65.6u ps=65.6u m=1
X23 T3__t2 VSS__t121 T2__t3 VSS__t81 nfet_03v3 L=0.5u W=32u nf=1 ad=25.6p as=25.6p pd=65.6u ps=65.6u m=1
X24 T1__t2 VSS__t122 T0__t3 VSS__t82 nfet_03v3 L=0.5u W=32u nf=1 ad=25.6p as=25.6p pd=65.6u ps=65.6u m=1
X25 T0__t2 VSS__t123 VSS__t120 VSS__t83 nfet_03v3 L=0.5u W=32u nf=1 ad=25.6p as=25.6p pd=65.6u ps=65.6u m=1
X26 T2__t2 VSS__t124 T1__t3 VSS__t84 nfet_03v3 L=0.5u W=32u nf=1 ad=25.6p as=25.6p pd=65.6u ps=65.6u m=1
X27 T4__t3 VSS__t125 T3__t3 VSS__t85 nfet_03v3 L=0.5u W=32u nf=1 ad=25.6p as=25.6p pd=65.6u ps=65.6u m=1
X28 NT__t1 NT__t10 NT__t0 NT pfet_03v3 L=4u W=16u nf=1 ad=12.8p as=12.8p pd=33.6u ps=33.6u m=1
X29 N1__t0 NA__t0 NT__t4 NT pfet_03v3 L=4u W=16u nf=1 ad=12.8p as=12.8p pd=33.6u ps=33.6u m=1
X30 N2__t4 NB__t4 NT__t8 NT pfet_03v3 L=4u W=16u nf=1 ad=12.8p as=12.8p pd=33.6u ps=33.6u m=1
X31 N2__t3 NB__t3 NT__t7 NT pfet_03v3 L=4u W=16u nf=1 ad=12.8p as=12.8p pd=33.6u ps=33.6u m=1
X32 N1__t1 NA__t5 NT__t6 NT pfet_03v3 L=4u W=16u nf=1 ad=12.8p as=12.8p pd=33.6u ps=33.6u m=1
X33 NT__t3 NT__t9 NT__t5 NT pfet_03v3 L=4u W=16u nf=1 ad=12.8p as=12.8p pd=33.6u ps=33.6u m=1
X34 NT__t2 PB__t0 VDD__t2 VDD pfet_03v3 L=4u W=20u nf=1 ad=16p as=16p pd=41.6u ps=41.6u m=1
X35 VDD__t17 VDD__t19 VDD__t12 VDD pfet_03v3 L=4u W=4u nf=1 ad=3.2p as=3.2p pd=9.6u ps=9.6u m=1
X36 M1D__t0 PG__t10 VDD__t13 VDD pfet_03v3 L=4u W=4u nf=1 ad=3.2p as=3.2p pd=9.6u ps=9.6u m=1
X37 NA__t1 PCAS__t1 M1D__t1 VDD pfet_03v3 L=1u W=4u nf=1 ad=3.2p as=3.2p pd=9.6u ps=9.6u m=1
X38 M2D__t3 PG__t11 VDD__t15 VDD pfet_03v3 L=4u W=4u nf=1 ad=3.2p as=3.2p pd=9.6u ps=9.6u m=1
X39 NB__t2 PCAS__t8 M2D__t1 VDD pfet_03v3 L=1u W=4u nf=1 ad=3.2p as=3.2p pd=9.6u ps=9.6u m=1
X40 M3D__t3 PG__t2 VDD__t14 VDD pfet_03v3 L=4u W=4u nf=1 ad=3.2p as=3.2p pd=9.6u ps=9.6u m=1
X41 PTAT__t3 PCAS__t7 M3D__t1 VDD pfet_03v3 L=1u W=4u nf=1 ad=3.2p as=3.2p pd=9.6u ps=9.6u m=1
X42 PTAT__t2 PCAS__t6 M3D__t0 VDD pfet_03v3 L=1u W=4u nf=1 ad=3.2p as=3.2p pd=9.6u ps=9.6u m=1
X43 M3D__t2 PG__t9 VDD__t1 VDD pfet_03v3 L=4u W=4u nf=1 ad=3.2p as=3.2p pd=9.6u ps=9.6u m=1
X44 NB__t1 PCAS__t4 M2D__t0 VDD pfet_03v3 L=1u W=4u nf=1 ad=3.2p as=3.2p pd=9.6u ps=9.6u m=1
X45 M2D__t2 PG__t8 VDD__t11 VDD pfet_03v3 L=4u W=4u nf=1 ad=3.2p as=3.2p pd=9.6u ps=9.6u m=1
X46 NA__t4 PCAS__t5 M1D__t2 VDD pfet_03v3 L=1u W=4u nf=1 ad=3.2p as=3.2p pd=9.6u ps=9.6u m=1
X47 M1D__t3 PG__t7 VDD__t10 VDD pfet_03v3 L=4u W=4u nf=1 ad=3.2p as=3.2p pd=9.6u ps=9.6u m=1
X48 VDD__t18 VDD__t20 VDD__t16 VDD pfet_03v3 L=4u W=4u nf=1 ad=3.2p as=3.2p pd=9.6u ps=9.6u m=1
X49 PG__t3 PB__t1 VDD__t3 VDD pfet_03v3 L=4u W=10u nf=1 ad=8p as=8p pd=21.6u ps=21.6u m=1
X50 PB__t4 PB__t2 VDD__t9 VDD pfet_03v3 L=4u W=10u nf=1 ad=8p as=8p pd=21.6u ps=21.6u m=1
X51 PCAS__t3 PCAS__t2 VDD__t4 VDD pfet_03v3 L=8u W=1u nf=1 ad=0.8p as=0.8p pd=3.6u ps=3.6u m=1
X52 ENB__t3 EN__t2 VDD__t5 VDD pfet_03v3 L=0.5u W=2u nf=1 ad=1.6p as=1.6p pd=5.6u ps=5.6u m=1
X53 ND__t1 PB__t3 VDD__t8 VDD pfet_03v3 L=8u W=1u nf=1 ad=0.8p as=0.8p pd=3.6u ps=3.6u m=1
X54 NR__t2 PG__t4 VDD__t6 VDD pfet_03v3 L=4u W=1u nf=1 ad=0.8p as=0.8p pd=3.6u ps=3.6u m=1
X55 PG__t5 EN__t3 VDD__t7 VDD pfet_03v3 L=0.5u W=4u nf=1 ad=3.2p as=3.2p pd=9.6u ps=9.6u m=1
X56 VSS__t0 VSS__t97 NC__t1 pnp_10p00x10p00
X57 VSS__t1 VSS__t105 NC__t8 pnp_10p00x10p00
X58 VSS__t2 VSS__t98 NC__t2 pnp_10p00x10p00
X59 VSS__t3 VSS__t99 NC__t3 pnp_10p00x10p00
X60 VSS__t4 VSS__t100 NA__t3 pnp_10p00x10p00
X61 VSS__t5 VSS__t101 NC__t4 pnp_10p00x10p00
X62 VSS__t6 VSS__t102 NC__t5 pnp_10p00x10p00
X63 VSS__t7 VSS__t103 NC__t6 pnp_10p00x10p00
X64 VSS__t8 VSS__t104 NC__t7 pnp_10p00x10p00
X65 PG__t6 NZ__t1 cap_mim_2f0_m3m4_noshield c_width=12u c_length=12u
X66 NB__t0 XR1__1__t0 VSS__t9 ppolyf_u r_width=2u r_length=59.735u
X67 NC__t0 XR1__1__t1 VSS__t10 ppolyf_u r_width=2u r_length=59.735u
X68 NA__t2 XRISO__1__t0 VSS__t11 ppolyf_u r_width=2u r_length=55.525u
X69 CTAT__t0 XRISO__1__t1 VSS__t12 ppolyf_u r_width=2u r_length=55.525u
X70 NZ__t0 XRZ__1__t0 VSS__t13 ppolyf_u r_width=2u r_length=100u
X71 XRZ__2__t0 XRZ__1__t1 VSS__t14 ppolyf_u r_width=2u r_length=100u
X72 XRZ__2__t1 XRZ__3__t1 VSS__t15 ppolyf_u r_width=2u r_length=100u
X73 XRZ__4__t1 XRZ__3__t0 VSS__t16 ppolyf_u r_width=2u r_length=100u
X74 XRZ__4__t0 XRZ__5__t1 VSS__t17 ppolyf_u r_width=2u r_length=100u
X75 XRZ__6__t1 XRZ__5__t0 VSS__t18 ppolyf_u r_width=2u r_length=100u
X76 XRZ__6__t0 XRZ__7__t1 VSS__t19 ppolyf_u r_width=2u r_length=100u
X77 XRZ__8__t1 XRZ__7__t0 VSS__t20 ppolyf_u r_width=2u r_length=100u
X78 XRZ__8__t0 XRZ__9__t1 VSS__t21 ppolyf_u r_width=2u r_length=100u
X79 N2__t2 XRZ__9__t0 VSS__t22 ppolyf_u r_width=2u r_length=100u
X80 PTAT__t1 XR2F__1__t0 VSS__t23 ppolyf_u r_width=2u r_length=110.525u
X81 XR2F__2__t1 XR2F__1__t1 VSS__t24 ppolyf_u r_width=2u r_length=110.525u
X82 XR2F__2__t0 XR2F__3__t1 VSS__t25 ppolyf_u r_width=2u r_length=110.525u
X83 XR2F__4__t1 XR2F__3__t0 VSS__t26 ppolyf_u r_width=2u r_length=110.525u
X84 XR2F__4__t0 XR2F__5__t1 VSS__t27 ppolyf_u r_width=2u r_length=110.525u
X85 XR2F__6__t1 XR2F__5__t0 VSS__t28 ppolyf_u r_width=2u r_length=110.525u
X86 XR2F__6__t0 XR2F__7__t1 VSS__t29 ppolyf_u r_width=2u r_length=110.525u
X87 XR2F__8__t1 XR2F__7__t0 VSS__t30 ppolyf_u r_width=2u r_length=110.525u
X88 XR2F__8__t0 XR2F__9__t1 VSS__t31 ppolyf_u r_width=2u r_length=110.525u
X89 XR2F__10__t1 XR2F__9__t0 VSS__t32 ppolyf_u r_width=2u r_length=110.525u
X90 XR2F__10__t0 XR2F__11__t1 VSS__t33 ppolyf_u r_width=2u r_length=110.525u
X91 XR2F__12__t1 XR2F__11__t0 VSS__t34 ppolyf_u r_width=2u r_length=110.525u
X92 XR2F__12__t0 XR2F__13__t1 VSS__t35 ppolyf_u r_width=2u r_length=110.525u
X93 XR2F__14__t1 XR2F__13__t0 VSS__t36 ppolyf_u r_width=2u r_length=110.525u
X94 XR2F__14__t0 XR2F__15__t1 VSS__t37 ppolyf_u r_width=2u r_length=110.525u
X95 XR2F__16__t1 XR2F__15__t0 VSS__t38 ppolyf_u r_width=2u r_length=110.525u
X96 XR2F__16__t0 XR2F__17__t1 VSS__t39 ppolyf_u r_width=2u r_length=110.525u
X97 XR2F__18__t0 XR2F__17__t0 VSS__t40 ppolyf_u r_width=2u r_length=110.525u
X98 XR2F__18__t1 XR2F__19__t1 VSS__t41 ppolyf_u r_width=2u r_length=110.525u
X99 XR2F__20__t0 XR2F__19__t0 VSS__t42 ppolyf_u r_width=2u r_length=110.525u
X100 XR2F__20__t1 XR2F__21__t0 VSS__t43 ppolyf_u r_width=2u r_length=110.525u
X101 XR2F__22__t0 XR2F__21__t1 VSS__t44 ppolyf_u r_width=2u r_length=110.525u
X102 XR2F__22__t1 XR2F__23__t0 VSS__t45 ppolyf_u r_width=2u r_length=110.525u
X103 T5__t2 XR2F__23__t1 VSS__t46 ppolyf_u r_width=2u r_length=110.525u
X104 T5__t1 XR2T5__1__t0 VSS__t47 ppolyf_u r_width=2u r_length=114.855u
X105 T4__t2 XR2T5__1__t1 VSS__t48 ppolyf_u r_width=2u r_length=114.855u
X106 T4__t1 XR2T4__1__t0 VSS__t49 ppolyf_u r_width=2u r_length=57.345u
X107 T3__t1 XR2T4__1__t1 VSS__t50 ppolyf_u r_width=2u r_length=57.345u
X108 T3__t0 XR2T3__1__t0 VSS__t51 ppolyf_u r_width=2u r_length=28.59u
X109 T2__t1 XR2T3__1__t1 VSS__t52 ppolyf_u r_width=2u r_length=28.59u
X110 T2__t0 XR2T2__1__t0 VSS__t53 ppolyf_u r_width=2u r_length=14.21u
X111 T1__t1 XR2T2__1__t1 VSS__t54 ppolyf_u r_width=2u r_length=14.21u
X112 T1__t0 XR2T1__1__t0 VSS__t55 ppolyf_u r_width=2u r_length=7.015u
X113 T0__t1 XR2T1__1__t1 VSS__t56 ppolyf_u r_width=2u r_length=7.015u
X114 T0__t0 XR2T0__1__t0 VSS__t57 ppolyf_u r_width=2u r_length=3.425u
X115 VSS__t106 XR2T0__1__t1 VSS__t58 ppolyf_u r_width=2u r_length=3.425u
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
