2AMLogic/gf180-temp-por/layout/reports/bias_core/extracted-parasitics.spice

* extracted by klt extract --deck gf180mcu
* parasitic model (--parasitics):
* - capacitance: net-to-ground for every net's own (non-coupled) area/perimeter, plus net-to-net for the vertical-overlap coupling `coupling` describes below -- a coupled net pair gets a direct capacitor between their two hub nodes, not just capacitors to the deck's ground/substrate net
* - coupling: vertical overlap (crossover) unconditionally -- where one net's conductor on an adjacent metal level sits directly over another *distinct* net's conductor, that overlap area is charged between the two nets instead of to ground (issue #760) -- plus lateral (same-layer, sidewall) coupling, but only for a net pair naming one of the caller's declared `--critical-net` nets (issue #976): facing-edge length within that layer's own minimum-spacing lookback is charged between the two nets, *additively* (not deducted from either net's substrate fringe term, unlike the vertical case -- a known simplification). Any same-layer pair with neither side named `--critical-net`, and fringe shielding in general, are still not modelled
* - resistance: single lumped series resistance per net, distributed as a star across that net's device terminals (issue #592) -- not a per-segment, distributed RC ladder, *unless* `--distributed-rc` names this net via `--critical-net` (issue #977, Epic #709 Phase 2b): then the net's terminals are ordered along their approximate physical spread and its total R/C is broken into a chain of per-segment resistors (segment length proportional to inter-terminal distance) with a ground capacitor at each terminal node (proportional to its adjacent segment length/2), instead of one star hub -- still an approximation (terminal position is a device-placement proxy, not true per-segment routing geometry), but a strictly finer-grained one than the single-hub star
* - frequency: quasi-static -- one frequency-independent R and C per net; no skin effect, no distributed transmission-line behavior
.GLOBAL vsubs

* cell bias_core
* pin BIAS_OK
* pin IBIAS
* pin VDD
* pin VREF
* pin VSS
* pin vsubs
.SUBCKT bias_core BIAS_OK IBIAS VDD VREF VSS vsubs
* device instance $1 r0 *1 159.4,0.5 nfet
M$1 VDD__t6 VDD__t5 \$18__t2 vsubs nfet L=8U W=1U AS=0.8P AD=0.8P PS=3.6U
+ PD=3.6U
* device instance $2 r0 *1 170,0.5 nfet
M$2 \$18__t1 \$18__t0 \$19__t2 vsubs nfet L=8U W=1U AS=0.8P AD=0.8P PS=3.6U
+ PD=3.6U
* device instance $3 r0 *1 180.6,0.5 nfet
M$3 \$19__t1 \$19__t0 \$20__t2 vsubs nfet L=8U W=1U AS=0.8P AD=0.8P PS=3.6U
+ PD=3.6U
* device instance $4 r0 *1 191.2,0.5 nfet
M$4 \$20__t0 \$20__t1 \$21__t0 vsubs nfet L=8U W=1U AS=0.8P AD=0.8P PS=3.6U
+ PD=3.6U
* device instance $5 r0 *1 201.8,0.5 nfet
M$5 \$21__t2 \$21__t1 \$22__t3 vsubs nfet L=8U W=1U AS=0.8P AD=0.8P PS=3.6U
+ PD=3.6U
* device instance $6 r0 *1 223.6,0.5 nfet
M$6 \$3__t3 \$22__t1 VSS__t4 vsubs nfet L=4U W=1U AS=0.8P AD=0.8P PS=3.6U
+ PD=3.6U
* device instance $7 r0 *1 112.4,1 nfet
M$7 \$7__t3 \$7__t1 VSS__t0 vsubs nfet L=4U W=2U AS=1.6P AD=1.6P PS=5.6U PD=5.6U
* device instance $8 r0 *1 119,1 nfet
M$8 \$8__t2 \$7__t2 VSS__t8 vsubs nfet L=4U W=2U AS=1.6P AD=1.6P PS=5.6U PD=5.6U
* device instance $9 r0 *1 210.4,1 nfet
M$9 \$13__t3 \$13__t2 VSS__t9 vsubs nfet L=4U W=2U AS=1.6P AD=1.6P PS=5.6U
+ PD=5.6U
* device instance $10 r0 *1 230.2,1 nfet
M$10 \$16__t2 \$16__t0 VSS__t10 vsubs nfet L=4U W=2U AS=1.6P AD=1.6P PS=5.6U
+ PD=5.6U
* device instance $11 r0 *1 236.8,1 nfet
M$11 \$15__t2 \$16__t1 VSS__t12 vsubs nfet L=4U W=2U AS=1.6P AD=1.6P PS=5.6U
+ PD=5.6U
* device instance $12 r0 *1 241.9,1 nfet
M$12 \$15__t0 \$22__t2 VSS__t5 vsubs nfet L=1U W=2U AS=1.6P AD=1.6P PS=5.6U
+ PD=5.6U
* device instance $13 r0 *1 247,1 nfet
M$13 \$17__t2 \$15__t1 VSS__t11 vsubs nfet L=4U W=2U AS=1.6P AD=1.6P PS=5.6U
+ PD=5.6U
* device instance $14 r0 *1 127.6,2 nfet
M$14 \$11__t3 \$11__t1 VSS__t1 vsubs nfet L=8U W=4U AS=3.2P AD=3.2P PS=9.6U
+ PD=9.6U
* device instance $15 r0 *1 138.2,2 nfet
M$15 \$12__t0 \$11__t2 VSS__t7 vsubs nfet L=8U W=4U AS=3.2P AD=3.2P PS=9.6U
+ PD=9.6U
* device instance $16 r0 *1 251.85,2 nfet
M$16 BIAS_OK__t0 \$17__t0 VSS__t6 vsubs nfet L=0.5U W=4U AS=3.2P AD=3.2P
+ PS=9.6U PD=9.6U
* device instance $17 r0 *1 148.8,4 nfet
M$17 \$3__t2 \$12__t1 VSS__t2 vsubs nfet L=8U W=8U AS=6.4P AD=6.4P PS=17.6U
+ PD=17.6U
* device instance $18 r0 *1 217,4 nfet
M$18 \$22__t0 \$13__t1 VSS__t3 vsubs nfet L=4U W=8U AS=6.4P AD=6.4P PS=17.6U
+ PD=17.6U
* device instance $19 r0 *1 68.8,0.5 pfet
M$19 \$13__t0 \$8__t1 VDD__t3 \$38 pfet L=4U W=1U AS=0.8P AD=0.8P PS=3.6U
+ PD=3.6U
* device instance $20 r0 *1 75.4,0.5 pfet
M$20 \$14__t0 \$8__t4 VDD__t9 \$38 pfet L=4U W=1U AS=0.8P AD=0.8P PS=3.6U
+ PD=3.6U
* device instance $21 r0 *1 95.2,0.5 pfet
M$21 \$17__t3 \$8__t3 VDD__t7 \$38 pfet L=4U W=1U AS=0.8P AD=0.8P PS=3.6U
+ PD=3.6U
* device instance $22 r0 *1 101.8,0.5 pfet
M$22 BIAS_OK__t1 \$17__t4 VDD__t8 \$38 pfet L=4U W=1U AS=0.8P AD=0.8P PS=3.6U
+ PD=3.6U
* device instance $23 r0 *1 22.6,1 pfet
M$23 \$7__t0 \$3__t1 VDD__t1 \$38 pfet L=4U W=2U AS=1.6P AD=1.6P PS=5.6U PD=5.6U
* device instance $24 r0 *1 29.2,1 pfet
M$24 \$8__t5 \$8__t8 VDD__t12 \$38 pfet L=4U W=2U AS=1.6P AD=1.6P PS=5.6U
+ PD=5.6U
* device instance $25 r0 *1 42.4,1 pfet
M$25 \$10__t2 \$8__t7 VDD__t11 \$38 pfet L=4U W=2U AS=1.6P AD=1.6P PS=5.6U
+ PD=5.6U
* device instance $26 r0 *1 62.2,1 pfet
M$26 \$3__t5 \$8__t6 VDD__t10 \$38 pfet L=4U W=2U AS=1.6P AD=1.6P PS=5.6U
+ PD=5.6U
* device instance $27 r0 *1 2.8,4 pfet
M$27 \$4__t0 \$3__t0 VDD__t0 \$38 pfet L=4U W=8U AS=6.4P AD=6.4P PS=17.6U
+ PD=17.6U
* device instance $28 r0 *1 9.4,4 pfet
M$28 \$5__t1 \$3__t7 VDD__t14 \$38 pfet L=4U W=8U AS=6.4P AD=6.4P PS=17.6U
+ PD=17.6U
* device instance $29 r0 *1 16,4 pfet
M$29 VREF__t1 \$3__t6 VDD__t13 \$38 pfet L=4U W=8U AS=6.4P AD=6.4P PS=17.6U
+ PD=17.6U
* device instance $30 r0 *1 82,4 pfet
M$30 \$15__t3 \$4__t3 \$14__t2 \$38 pfet L=4U W=8U AS=6.4P AD=6.4P PS=17.6U
+ PD=17.6U
* device instance $31 r0 *1 88.6,4 pfet
M$31 \$16__t3 \$5__t2 \$14__t1 \$38 pfet L=4U W=8U AS=6.4P AD=6.4P PS=17.6U
+ PD=17.6U
* device instance $32 r0 *1 49,8 pfet
M$32 \$11__t0 \$4__t1 \$10__t0 \$38 pfet L=4U W=16U AS=12.8P AD=12.8P PS=33.6U
+ PD=33.6U
* device instance $33 r0 *1 55.6,8 pfet
M$33 \$12__t3 \$24__t2 \$10__t1 \$38 pfet L=4U W=16U AS=12.8P AD=12.8P PS=33.6U
+ PD=33.6U
* device instance $34 r0 *1 35.8,20 pfet
M$34 IBIAS__t0 \$8__t0 VDD__t2 \$38 pfet L=4U W=40U AS=32P AD=32P PS=81.6U
+ PD=81.6U
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
* device instance cc__3__5 r0 *1 0,0 
Ccc__3__5 \$3 \$5 1.1805e-17
* device instance cc__3_VREF r0 *1 0,0 
Ccc__3_VREF \$3 VREF 1.1805e-17
* device instance cc__3_VSS r0 *1 0,0 
Ccc__3_VSS \$3 VSS 3.5416e-17
* device instance vsubs_dctie r0 *1 0,0 
Rvsubs_dctie vsubs 0 1e+12
.ENDS bias_core
