2AMLogic/gf180-temp-por/layout/reports/por_output_chain/extracted-parasitics.spice

* extracted by klt extract --deck gf180mcu
* parasitic model (--parasitics):
* - capacitance: net-to-ground for every net's own (non-coupled) area/perimeter, plus net-to-net for the vertical-overlap coupling `coupling` describes below -- a coupled net pair gets a direct capacitor between their two hub nodes, not just capacitors to the deck's ground/substrate net
* - coupling: vertical overlap (crossover) unconditionally -- where one net's conductor on an adjacent metal level sits directly over another *distinct* net's conductor, that overlap area is charged between the two nets instead of to ground (issue #760) -- plus lateral (same-layer, sidewall) coupling, but only for a net pair naming one of the caller's declared `--critical-net` nets (issue #976): facing-edge length within that layer's own minimum-spacing lookback is charged between the two nets, *additively* (not deducted from either net's substrate fringe term, unlike the vertical case -- a known simplification). Any same-layer pair with neither side named `--critical-net`, and fringe shielding in general, are still not modelled
* - resistance: single lumped series resistance per net, distributed as a star across that net's device terminals (issue #592) -- not a per-segment, distributed RC ladder, *unless* `--distributed-rc` names this net via `--critical-net` (issue #977, Epic #709 Phase 2b): then the net's terminals are ordered along their approximate physical spread and its total R/C is broken into a chain of per-segment resistors (segment length proportional to inter-terminal distance) with a ground capacitor at each terminal node (proportional to its adjacent segment length/2), instead of one star hub -- still an approximation (terminal position is a device-placement proxy, not true per-segment routing geometry), but a strictly finer-grained one than the single-hub star
* - frequency: quasi-static -- one frequency-independent R and C per net; no skin effect, no distributed transmission-line behavior
.GLOBAL vsubs

* cell por_output_chain
* pin IBIAS
* pin POR_RAW
* pin RESETn
* pin VDD
* pin VSS
* pin vsubs
.SUBCKT por_output_chain IBIAS POR_RAW RESETn VDD VSS vsubs
* device instance $1 r0 *1 19.9,0.25 nfet
M$1 \$2__t0 IBIAS__t0 VSS__t0 vsubs nfet L=25U W=0.5U AS=0.4P AD=0.4P PS=2.6U
+ PD=2.6U
* device instance $2 r0 *1 67.4,0.25 nfet
M$2 \$5__t2 \$12__t3 VSS__t1 vsubs nfet L=2U W=0.5U AS=0.4P AD=0.4P PS=2.6U
+ PD=2.6U
* device instance $3 r0 *1 79.6,0.25 nfet
M$3 \$6__t1 \$3__t0 VSS__t2 vsubs nfet L=10U W=0.5U AS=0.4P AD=0.4P PS=2.6U
+ PD=2.6U
* device instance $4 r0 *1 60.45,0.5 nfet
M$4 \$11__t2 POR_RAW__t1 \$10__t0 vsubs nfet L=0.5U W=1U AS=0.8P AD=0.8P
+ PS=3.6U PD=3.6U
* device instance $5 r0 *1 71.5,0.5 nfet
M$5 \$13__t4 \$5__t3 VSS__t3 vsubs nfet L=1U W=1U AS=0.8P AD=0.8P PS=3.6U
+ PD=3.6U
* device instance $6 r0 *1 87.7,0.5 nfet
M$6 \$14__t3 \$6__t3 VSS__t16 vsubs nfet L=1U W=1U AS=0.8P AD=0.8P PS=3.6U
+ PD=3.6U
* device instance $7 r0 *1 91.3,0.5 nfet
M$7 \$6__t2 RESETn__t2 VSS__t15 vsubs nfet L=1U W=1U AS=0.8P AD=0.8P PS=3.6U
+ PD=3.6U
* device instance $8 r0 *1 40,1 nfet
M$8 \$3__t1 \$3__t2 VSS__t4 vsubs nfet L=10U W=2U AS=1.6P AD=1.6P PS=5.6U
+ PD=5.6U
* device instance $9 r0 *1 63.55,1 nfet
M$9 \$12__t4 \$11__t3 VSS__t5 vsubs nfet L=0.5U W=2U AS=1.6P AD=1.6P PS=5.6U
+ PD=5.6U
* device instance $10 r0 *1 94.65,1 nfet
M$10 \$17__t4 \$14__t1 \$15__t1 vsubs nfet L=0.5U W=2U AS=1.6P AD=1.6P PS=5.6U
+ PD=5.6U
* device instance $11 r0 *1 97.75,1 nfet
M$11 \$15__t0 \$12__t5 VSS__t14 vsubs nfet L=0.5U W=2U AS=1.6P AD=1.6P PS=5.6U
+ PD=5.6U
* device instance $12 r0 *1 2.8,2 nfet
M$12 IBIAS__t1 IBIAS__t2 VSS__t6 vsubs nfet L=4U W=4U AS=3.2P AD=3.2P PS=9.6U
+ PD=9.6U
* device instance $13 r0 *1 52.6,5 nfet
M$13 \$10__t1 \$3__t3 VSS__t7 vsubs nfet L=10U W=10U AS=8P AD=8P PS=21.6U
+ PD=21.6U
* device instance $14 r0 *1 212.25,5 nfet
M$14 RESETn__t0 \$17__t0 VSS__t8 vsubs nfet L=0.5U W=10U AS=8P AD=8P PS=21.6U
+ PD=21.6U
* device instance $15 r0 *1 147.4,0.25 pfet
M$15 \$8__t0 \$2__t1 VDD__t0 \$19 pfet L=10U W=0.5U AS=0.4P AD=0.4P PS=2.6U
+ PD=2.6U
* device instance $16 r0 *1 160,0.25 pfet
M$16 \$14__t2 \$2__t6 VDD__t11 \$19 pfet L=10U W=0.5U AS=0.4P AD=0.4P PS=2.6U
+ PD=2.6U
* device instance $17 r0 *1 171.7,0.25 pfet
M$17 \$12__t0 \$11__t0 VDD__t1 \$19 pfet L=2U W=0.5U AS=0.4P AD=0.4P PS=2.6U
+ PD=2.6U
* device instance $18 r0 *1 196.8,0.25 pfet
M$18 \$17__t5 RESETn__t3 VDD__t10 \$19 pfet L=10U W=0.5U AS=0.4P AD=0.4P
+ PS=2.6U PD=2.6U
* device instance $19 r0 *1 167.85,0.5 pfet
M$19 \$11__t1 POR_RAW__t0 \$16__t0 \$19 pfet L=0.5U W=1U AS=0.8P AD=0.8P
+ PS=3.6U PD=3.6U
* device instance $20 r0 *1 204.9,0.5 pfet
M$20 RESETn__t1 \$17__t1 VDD__t2 \$19 pfet L=1U W=1U AS=0.8P AD=0.8P PS=3.6U
+ PD=3.6U
* device instance $21 r0 *1 109.6,1 pfet
M$21 \$2__t2 \$2__t3 VDD__t9 \$19 pfet L=10U W=2U AS=1.6P AD=1.6P PS=5.6U
+ PD=5.6U
* device instance $22 r0 *1 122.2,1 pfet
M$22 \$3__t4 \$2__t5 VDD__t3 \$19 pfet L=10U W=2U AS=1.6P AD=1.6P PS=5.6U
+ PD=5.6U
* device instance $23 r0 *1 175.55,1 pfet
M$23 \$5__t0 \$12__t1 VDD__t4 \$19 pfet L=0.5U W=2U AS=1.6P AD=1.6P PS=5.6U
+ PD=5.6U
* device instance $24 r0 *1 178.9,1 pfet
M$24 \$13__t5 \$5__t1 \$8__t1 \$19 pfet L=1U W=2U AS=1.6P AD=1.6P PS=5.6U
+ PD=5.6U
* device instance $25 r0 *1 182.5,1 pfet
M$25 \$6__t0 \$13__t6 VDD__t5 \$19 pfet L=1U W=2U AS=1.6P AD=1.6P PS=5.6U
+ PD=5.6U
* device instance $26 r0 *1 185.85,2 pfet
M$26 \$17__t2 \$14__t0 VDD__t6 \$19 pfet L=0.5U W=4U AS=3.2P AD=3.2P PS=9.6U
+ PD=9.6U
* device instance $27 r0 *1 188.95,2 pfet
M$27 \$17__t3 \$12__t2 VDD__t8 \$19 pfet L=0.5U W=4U AS=3.2P AD=3.2P PS=9.6U
+ PD=9.6U
* device instance $28 r0 *1 134.8,5 pfet
M$28 \$16__t1 \$2__t4 VDD__t7 \$19 pfet L=10U W=10U AS=8P AD=8P PS=21.6U
+ PD=21.6U
* device instance $29 r0 *1 68.8,37.7 cap_mim_2f0_m4m5_noshield
C$29 \$11__t4 VSS__t9 2.512752e-13
* device instance $30 r0 *1 15.7,46.2 cap_mim_2f0_m4m5_noshield
C$30 \$13__t0 VSS__t10 1.5868496e-12
* device instance $31 r0 *1 46.5,46.2 cap_mim_2f0_m4m5_noshield
C$31 \$13__t3 VSS__t13 1.5868496e-12
* device instance $32 r0 *1 15.7,77 cap_mim_2f0_m4m5_noshield
C$32 \$13__t2 VSS__t12 1.5868496e-12
* device instance $33 r0 *1 46.5,77 cap_mim_2f0_m4m5_noshield
C$33 \$13__t1 VSS__t11 1.5868496e-12
* device instance _10_t0 r0 *1 0,0 
R_10_t0 \$10__t0 \$10 1968.54035
* device instance _10_t1 r0 *1 0,0 
R_10_t1 \$10__t1 \$10 1968.54035
* device instance _10 r0 *1 0,0 
C_10 \$10 vsubs 3.4262384e-14
* device instance _11_t0 r0 *1 0,0 
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
* device instance VSS_t12 r0 *1 0,0 
RVSS_t12 VSS__t12 VSS 7.63062334399
* device instance VSS_t13 r0 *1 0,0 
RVSS_t13 VSS__t13 VSS 3.32329079362
* device instance VSS_t14 r0 *1 0,0 
RVSS_t14 VSS__t14 VSS 3.8192808638
* device instance VSS_t15 r0 *1 0,0 
RVSS_t15 VSS__t15 VSS 3.27701889261
* device instance VSS_t16 r0 *1 0,0 
RVSS_t16 VSS__t16 VSS 2.97645136535
* device instance VSS r0 *1 0,0 
CVSS VSS vsubs 1.24338142e-13
* device instance cc__11__12 r0 *1 0,0 
Ccc__11__12 \$11 \$12 4.7222e-17
* device instance cc__11__13 r0 *1 0,0 
Ccc__11__13 \$11 \$13 5.0173e-17
* device instance cc__11__14 r0 *1 0,0 
Ccc__11__14 \$11 \$14 4.7222e-17
* device instance cc__11__15 r0 *1 0,0 
Ccc__11__15 \$11 \$15 2.3611e-17
* device instance cc__11__17 r0 *1 0,0 
Ccc__11__17 \$11 \$17 7.0832e-17
* device instance cc__11__5 r0 *1 0,0 
Ccc__11__5 \$11 \$5 4.7222e-17
* device instance cc__11__6 r0 *1 0,0 
Ccc__11__6 \$11 \$6 4.7222e-17
* device instance cc__11__8 r0 *1 0,0 
Ccc__11__8 \$11 \$8 2.3611e-17
* device instance cc__11_RESETn r0 *1 0,0 
Ccc__11_RESETn \$11 RESETn 4.7222e-17
* device instance cc__11_VDD r0 *1 0,0 
Ccc__11_VDD \$11 VDD 1.5347e-16
* device instance cc__11_VSS r0 *1 0,0 
Ccc__11_VSS \$11 VSS 3.269281e-15
* device instance cc__13__14 r0 *1 0,0 
Ccc__13__14 \$13 \$14 4.7222e-17
* device instance cc__13__15 r0 *1 0,0 
Ccc__13__15 \$13 \$15 2.3611e-17
* device instance cc__13__17 r0 *1 0,0 
Ccc__13__17 \$13 \$17 7.0832e-17
* device instance cc__13__6 r0 *1 0,0 
Ccc__13__6 \$13 \$6 4.7222e-17
* device instance cc__13_RESETn r0 *1 0,0 
Ccc__13_RESETn \$13 RESETn 4.7222e-17
* device instance cc__13_VDD r0 *1 0,0 
Ccc__13_VDD \$13 VDD 1.5347e-16
* device instance cc__13_VSS r0 *1 0,0 
Ccc__13_VSS \$13 VSS 7.697882e-14
* device instance vsubs_dctie r0 *1 0,0 
Rvsubs_dctie vsubs 0 1e+12
.ENDS por_output_chain
