2AMLogic/gf180-temp-por/layout/reports/temp_core/extracted-parasitics.spice

* extracted by klt extract --deck gf180mcu
* parasitic model (--parasitics):
* - capacitance: net-to-ground for every net's own (non-coupled) area/perimeter, plus net-to-net for the vertical-overlap coupling `coupling` describes below -- a coupled net pair gets a direct capacitor between their two hub nodes, not just capacitors to the deck's ground/substrate net
* - coupling: vertical overlap (crossover) unconditionally -- where one net's conductor on an adjacent metal level sits directly over another *distinct* net's conductor, that overlap area is charged between the two nets instead of to ground (issue #760) -- plus lateral (same-layer, sidewall) coupling, but only for a net pair naming one of the caller's declared `--critical-net` nets (issue #976): facing-edge length within that layer's own minimum-spacing lookback is charged between the two nets, *additively* (not deducted from either net's substrate fringe term, unlike the vertical case -- a known simplification). Any same-layer pair with neither side named `--critical-net`, and fringe shielding in general, are still not modelled
* - resistance: single lumped series resistance per net, distributed as a star across that net's device terminals (issue #592) -- not a per-segment, distributed RC ladder, *unless* `--distributed-rc` names this net via `--critical-net` (issue #977, Epic #709 Phase 2b): then the net's terminals are ordered along their approximate physical spread and its total R/C is broken into a chain of per-segment resistors (segment length proportional to inter-terminal distance) with a ground capacitor at each terminal node (proportional to its adjacent segment length/2), instead of one star hub -- still an approximation (terminal position is a device-placement proxy, not true per-segment routing geometry), but a strictly finer-grained one than the single-hub star
* - frequency: quasi-static -- one frequency-independent R and C per net; no skin effect, no distributed transmission-line behavior
.GLOBAL vsubs

* cell temp_core
* pin CTAT
* pin EN
* pin ENB
* pin IBIAS
* pin M1D
* pin M2D
* pin M3D
* pin N1
* pin N2
* pin NA
* pin NB
* pin NBG
* pin NC
* pin ND
* pin NR
* pin NT
* pin NZ
* pin PB
* pin PCAS
* pin PG
* pin PTAT
* pin T0
* pin T1
* pin T2
* pin T3
* pin T4
* pin T5
* pin VDD
* pin VSS
.SUBCKT temp_core CTAT EN ENB IBIAS M1D M2D M3D N1 N2 NA NB NBG NC ND NR NT NZ
+ PB PCAS PG PTAT T0 T1 T2 T3 T4 T5 VDD VSS
* device instance $1 r0 *1 49.5,-2 nfet
M$1 VSS__t87 VSS__t88 VSS__t86 VSS__t59 nfet L=8U W=4U AS=3.2P AD=3.2P PS=9.6U
+ PD=9.6U
* device instance $2 r0 *1 59.6,-2 nfet
M$2 N1__t7 N1__t5 VSS__t119 VSS__t60 nfet L=8U W=4U AS=3.2P AD=3.2P PS=9.6U
+ PD=9.6U
* device instance $3 r0 *1 69.7,-2 nfet
M$3 N2__t5 N1__t2 VSS__t115 VSS__t61 nfet L=8U W=4U AS=3.2P AD=3.2P PS=9.6U
+ PD=9.6U
* device instance $4 r0 *1 79.8,-2 nfet
M$4 N2__t6 N1__t3 VSS__t116 VSS__t62 nfet L=8U W=4U AS=3.2P AD=3.2P PS=9.6U
+ PD=9.6U
* device instance $5 r0 *1 89.9,-2 nfet
M$5 N1__t6 N1__t4 VSS__t117 VSS__t63 nfet L=8U W=4U AS=3.2P AD=3.2P PS=9.6U
+ PD=9.6U
* device instance $6 r0 *1 100,-2 nfet
M$6 VSS__t114 VSS__t113 VSS__t118 VSS__t64 nfet L=8U W=4U AS=3.2P AD=3.2P
+ PS=9.6U PD=9.6U
* device instance $7 r0 *1 177.5,-4 nfet
M$7 PG__t0 N2__t0 VSS__t89 VSS__t65 nfet L=8U W=8U AS=6.4P AD=6.4P PS=17.6U
+ PD=17.6U
* device instance $8 r0 *1 190.7,-2 nfet
M$8 IBIAS__t1 NBG__t0 VSS__t90 VSS__t66 nfet L=2U W=4U AS=3.2P AD=3.2P PS=9.6U
+ PD=9.6U
* device instance $9 r0 *1 194.05,-1 nfet
M$9 IBIAS__t0 EN__t0 NBG__t1 VSS__t69 nfet L=0.5U W=2U AS=1.6P AD=1.6P PS=5.6U
+ PD=5.6U
* device instance $10 r0 *1 196.65,-1 nfet
M$10 NBG__t2 ENB__t6 VSS__t92 VSS__t70 nfet L=0.5U W=2U AS=1.6P AD=1.6P PS=5.6U
+ PD=5.6U
* device instance $11 r0 *1 200,-2 nfet
M$11 PB__t5 NBG__t4 VSS__t112 VSS__t67 nfet L=2U W=4U AS=3.2P AD=3.2P PS=9.6U
+ PD=9.6U
* device instance $12 r0 *1 210.2,-2 nfet
M$12 PCAS__t0 NBG__t3 VSS__t111 VSS__t68 nfet L=2U W=4U AS=3.2P AD=3.2P PS=9.6U
+ PD=9.6U
* device instance $13 r0 *1 226.25,-0.5 nfet
M$13 ENB__t0 EN__t1 VSS__t93 VSS__t72 nfet L=0.5U W=1U AS=0.8P AD=0.8P PS=3.6U
+ PD=3.6U
* device instance $14 r0 *1 239.7,-1 nfet
M$14 ND__t2 NR__t0 VSS__t94 VSS__t73 nfet L=2U W=2U AS=1.6P AD=1.6P PS=5.6U
+ PD=5.6U
* device instance $15 r0 *1 243.3,-2 nfet
M$15 PG__t1 ND__t0 VSS__t91 VSS__t75 nfet L=1U W=4U AS=3.2P AD=3.2P PS=9.6U
+ PD=9.6U
* device instance $16 r0 *1 253,-1 nfet
M$16 NR__t1 NR__t3 VSS__t109 VSS__t74 nfet L=2U W=2U AS=1.6P AD=1.6P PS=5.6U
+ PD=5.6U
* device instance $17 r0 *1 256.35,-1 nfet
M$17 ND__t3 ENB__t7 VSS__t110 VSS__t71 nfet L=0.5U W=2U AS=1.6P AD=1.6P PS=5.6U
+ PD=5.6U
* device instance $18 r0 *1 261.8,-0.5 nfet
M$18 PTAT__t0 ENB__t1 VSS__t95 VSS__t76 nfet L=1U W=1U AS=0.8P AD=0.8P PS=3.6U
+ PD=3.6U
* device instance $19 r0 *1 264.9,-0.5 nfet
M$19 CTAT__t1 ENB__t5 VSS__t108 VSS__t77 nfet L=1U W=1U AS=0.8P AD=0.8P PS=3.6U
+ PD=3.6U
* device instance $20 r0 *1 268,-1 nfet
M$20 N2__t1 ENB__t2 VSS__t96 VSS__t78 nfet L=1U W=2U AS=1.6P AD=1.6P PS=5.6U
+ PD=5.6U
* device instance $21 r0 *1 271.1,-1 nfet
M$21 NT__t11 ENB__t4 VSS__t107 VSS__t79 nfet L=1U W=2U AS=1.6P AD=1.6P PS=5.6U
+ PD=5.6U
* device instance $22 r0 *1 273.95,-16 nfet
M$22 T5__t0 VDD__t0 T4__t0 VSS__t80 nfet L=0.5U W=32U AS=25.6P AD=25.6P
+ PS=65.6U PD=65.6U
* device instance $23 r0 *1 276.55,-16 nfet
M$23 T3__t2 VSS__t121 T2__t3 VSS__t81 nfet L=0.5U W=32U AS=25.6P AD=25.6P
+ PS=65.6U PD=65.6U
* device instance $24 r0 *1 279.15,-16 nfet
M$24 T1__t2 VSS__t122 T0__t3 VSS__t82 nfet L=0.5U W=32U AS=25.6P AD=25.6P
+ PS=65.6U PD=65.6U
* device instance $25 r0 *1 281.75,-16 nfet
M$25 T0__t2 VSS__t123 VSS__t120 VSS__t83 nfet L=0.5U W=32U AS=25.6P AD=25.6P
+ PS=65.6U PD=65.6U
* device instance $26 r0 *1 284.35,-16 nfet
M$26 T2__t2 VSS__t124 T1__t3 VSS__t84 nfet L=0.5U W=32U AS=25.6P AD=25.6P
+ PS=65.6U PD=65.6U
* device instance $27 r0 *1 286.95,-16 nfet
M$27 T4__t3 VSS__t125 T3__t3 VSS__t85 nfet L=0.5U W=32U AS=25.6P AD=25.6P
+ PS=65.6U PD=65.6U
* device instance $28 r0 *1 2.8,42 pfet
M$28 NT__t1 NT__t10 NT__t0 \$28 pfet L=4U W=16U AS=12.8P AD=12.8P PS=33.6U
+ PD=33.6U
* device instance $29 r0 *1 8.9,42 pfet
M$29 N1__t0 NA__t0 NT__t4 \$28 pfet L=4U W=16U AS=12.8P AD=12.8P PS=33.6U
+ PD=33.6U
* device instance $30 r0 *1 15,42 pfet
M$30 N2__t4 NB__t4 NT__t8 \$28 pfet L=4U W=16U AS=12.8P AD=12.8P PS=33.6U
+ PD=33.6U
* device instance $31 r0 *1 21.1,42 pfet
M$31 N2__t3 NB__t3 NT__t7 \$28 pfet L=4U W=16U AS=12.8P AD=12.8P PS=33.6U
+ PD=33.6U
* device instance $32 r0 *1 27.2,42 pfet
M$32 N1__t1 NA__t5 NT__t6 \$28 pfet L=4U W=16U AS=12.8P AD=12.8P PS=33.6U
+ PD=33.6U
* device instance $33 r0 *1 33.3,42 pfet
M$33 NT__t3 NT__t9 NT__t5 \$28 pfet L=4U W=16U AS=12.8P AD=12.8P PS=33.6U
+ PD=33.6U
* device instance $34 r0 *1 41.4,44 pfet
M$34 NT__t2 PB__t0 VDD__t2 \$29 pfet L=4U W=20U AS=16P AD=16P PS=41.6U PD=41.6U
* device instance $35 r0 *1 108.1,36 pfet
M$35 VDD__t17 VDD__t19 VDD__t12 \$29 pfet L=4U W=4U AS=3.2P AD=3.2P PS=9.6U
+ PD=9.6U
* device instance $36 r0 *1 114.2,36 pfet
M$36 M1D__t0 PG__t10 VDD__t13 \$29 pfet L=4U W=4U AS=3.2P AD=3.2P PS=9.6U
+ PD=9.6U
* device instance $37 r0 *1 118.8,36 pfet
M$37 NA__t1 PCAS__t1 M1D__t1 \$29 pfet L=1U W=4U AS=3.2P AD=3.2P PS=9.6U PD=9.6U
* device instance $38 r0 *1 123.4,36 pfet
M$38 M2D__t3 PG__t11 VDD__t15 \$29 pfet L=4U W=4U AS=3.2P AD=3.2P PS=9.6U
+ PD=9.6U
* device instance $39 r0 *1 128,36 pfet
M$39 NB__t2 PCAS__t8 M2D__t1 \$29 pfet L=1U W=4U AS=3.2P AD=3.2P PS=9.6U PD=9.6U
* device instance $40 r0 *1 132.6,36 pfet
M$40 M3D__t3 PG__t2 VDD__t14 \$29 pfet L=4U W=4U AS=3.2P AD=3.2P PS=9.6U PD=9.6U
* device instance $41 r0 *1 137.2,36 pfet
M$41 PTAT__t3 PCAS__t7 M3D__t1 \$29 pfet L=1U W=4U AS=3.2P AD=3.2P PS=9.6U
+ PD=9.6U
* device instance $42 r0 *1 140.3,36 pfet
M$42 PTAT__t2 PCAS__t6 M3D__t0 \$29 pfet L=1U W=4U AS=3.2P AD=3.2P PS=9.6U
+ PD=9.6U
* device instance $43 r0 *1 144.9,36 pfet
M$43 M3D__t2 PG__t9 VDD__t1 \$29 pfet L=4U W=4U AS=3.2P AD=3.2P PS=9.6U PD=9.6U
* device instance $44 r0 *1 149.5,36 pfet
M$44 NB__t1 PCAS__t4 M2D__t0 \$29 pfet L=1U W=4U AS=3.2P AD=3.2P PS=9.6U PD=9.6U
* device instance $45 r0 *1 154.1,36 pfet
M$45 M2D__t2 PG__t8 VDD__t11 \$29 pfet L=4U W=4U AS=3.2P AD=3.2P PS=9.6U PD=9.6U
* device instance $46 r0 *1 158.7,36 pfet
M$46 NA__t4 PCAS__t5 M1D__t2 \$29 pfet L=1U W=4U AS=3.2P AD=3.2P PS=9.6U PD=9.6U
* device instance $47 r0 *1 163.3,36 pfet
M$47 M1D__t3 PG__t7 VDD__t10 \$29 pfet L=4U W=4U AS=3.2P AD=3.2P PS=9.6U PD=9.6U
* device instance $48 r0 *1 169.4,36 pfet
M$48 VDD__t18 VDD__t20 VDD__t16 \$29 pfet L=4U W=4U AS=3.2P AD=3.2P PS=9.6U
+ PD=9.6U
* device instance $49 r0 *1 185.6,39 pfet
M$49 PG__t3 PB__t1 VDD__t3 \$29 pfet L=4U W=10U AS=8P AD=8P PS=21.6U PD=21.6U
* device instance $50 r0 *1 205.1,39 pfet
M$50 PB__t4 PB__t2 VDD__t9 \$29 pfet L=4U W=10U AS=8P AD=8P PS=21.6U PD=21.6U
* device instance $51 r0 *1 217.3,34.5 pfet
M$51 PCAS__t3 PCAS__t2 VDD__t4 \$29 pfet L=8U W=1U AS=0.8P AD=0.8P PS=3.6U
+ PD=3.6U
* device instance $52 r0 *1 223.65,35 pfet
M$52 ENB__t3 EN__t2 VDD__t5 \$29 pfet L=0.5U W=2U AS=1.6P AD=1.6P PS=5.6U
+ PD=5.6U
* device instance $53 r0 *1 232.6,34.5 pfet
M$53 ND__t1 PB__t3 VDD__t8 \$29 pfet L=8U W=1U AS=0.8P AD=0.8P PS=3.6U PD=3.6U
* device instance $54 r0 *1 247.9,34.5 pfet
M$54 NR__t2 PG__t4 VDD__t6 \$29 pfet L=4U W=1U AS=0.8P AD=0.8P PS=3.6U PD=3.6U
* device instance $55 r0 *1 258.95,36 pfet
M$55 PG__t5 EN__t3 VDD__t7 \$29 pfet L=0.5U W=4U AS=3.2P AD=3.2P PS=9.6U PD=9.6U
* device instance $56 r0 *1 505,81 bjt
Q$56 VSS__t0 VSS__t97 NC__t1 bjt AE=100P PE=40U AB=144P PB=48U AC=144P PC=48U
+ NE=1
* device instance $57 r0 *1 519,81 bjt
Q$57 VSS__t1 VSS__t105 NC__t8 bjt AE=100P PE=40U AB=144P PB=48U AC=144P PC=48U
+ NE=1
* device instance $58 r0 *1 533,81 bjt
Q$58 VSS__t2 VSS__t98 NC__t2 bjt AE=100P PE=40U AB=144P PB=48U AC=144P PC=48U
+ NE=1
* device instance $59 r0 *1 505,95 bjt
Q$59 VSS__t3 VSS__t99 NC__t3 bjt AE=100P PE=40U AB=144P PB=48U AC=144P PC=48U
+ NE=1
* device instance $60 r0 *1 519,95 bjt
Q$60 VSS__t4 VSS__t100 NA__t3 bjt AE=100P PE=40U AB=144P PB=48U AC=144P PC=48U
+ NE=1
* device instance $61 r0 *1 533,95 bjt
Q$61 VSS__t5 VSS__t101 NC__t4 bjt AE=100P PE=40U AB=144P PB=48U AC=144P PC=48U
+ NE=1
* device instance $62 r0 *1 505,109 bjt
Q$62 VSS__t6 VSS__t102 NC__t5 bjt AE=100P PE=40U AB=144P PB=48U AC=144P PC=48U
+ NE=1
* device instance $63 r0 *1 519,109 bjt
Q$63 VSS__t7 VSS__t103 NC__t6 bjt AE=100P PE=40U AB=144P PB=48U AC=144P PC=48U
+ NE=1
* device instance $64 r0 *1 533,109 bjt
Q$64 VSS__t8 VSS__t104 NC__t7 bjt AE=100P PE=40U AB=144P PB=48U AC=144P PC=48U
+ NE=1
* device instance $65 r0 *1 206.7,68.7 cap_mim_2f0_m4m5_noshield
C$65 PG__t6 NZ__t1 2.979984e-13
* device instance $66 r0 *1 307,92.867 ppolyf_u
R$66 NB__t0 \$69__t0 VSS__t9 10453.625 ppolyf_u L=59.735U W=2U
* device instance $67 r0 *1 310,92.867 ppolyf_u
R$67 NC__t0 \$69__t1 VSS__t10 10453.625 ppolyf_u L=59.735U W=2U
* device instance $68 r0 *1 313,90.762 ppolyf_u
R$68 NA__t2 \$62__t0 VSS__t11 9716.875 ppolyf_u L=55.525U W=2U
* device instance $69 r0 *1 316,90.762 ppolyf_u
R$69 CTAT__t0 \$62__t1 VSS__t12 9716.875 ppolyf_u L=55.525U W=2U
* device instance $70 r0 *1 319,113 ppolyf_u
R$70 NZ__t0 \$70__t0 VSS__t13 17500 ppolyf_u L=100U W=2U
* device instance $71 r0 *1 322,113 ppolyf_u
R$71 \$30__t0 \$70__t1 VSS__t14 17500 ppolyf_u L=100U W=2U
* device instance $72 r0 *1 325,113 ppolyf_u
R$72 \$30__t1 \$71__t1 VSS__t15 17500 ppolyf_u L=100U W=2U
* device instance $73 r0 *1 328,113 ppolyf_u
R$73 \$31__t1 \$71__t0 VSS__t16 17500 ppolyf_u L=100U W=2U
* device instance $74 r0 *1 331,113 ppolyf_u
R$74 \$31__t0 \$72__t1 VSS__t17 17500 ppolyf_u L=100U W=2U
* device instance $75 r0 *1 334,113 ppolyf_u
R$75 \$32__t1 \$72__t0 VSS__t18 17500 ppolyf_u L=100U W=2U
* device instance $76 r0 *1 337,113 ppolyf_u
R$76 \$32__t0 \$73__t1 VSS__t19 17500 ppolyf_u L=100U W=2U
* device instance $77 r0 *1 340,113 ppolyf_u
R$77 \$33__t1 \$73__t0 VSS__t20 17500 ppolyf_u L=100U W=2U
* device instance $78 r0 *1 343,113 ppolyf_u
R$78 \$33__t0 \$74__t1 VSS__t21 17500 ppolyf_u L=100U W=2U
* device instance $79 r0 *1 346,113 ppolyf_u
R$79 N2__t2 \$74__t0 VSS__t22 17500 ppolyf_u L=100U W=2U
* device instance $80 r0 *1 349,118.262 ppolyf_u
R$80 PTAT__t1 \$75__t0 VSS__t23 19341.875 ppolyf_u L=110.525U W=2U
* device instance $81 r0 *1 352,118.262 ppolyf_u
R$81 \$34__t1 \$75__t1 VSS__t24 19341.875 ppolyf_u L=110.525U W=2U
* device instance $82 r0 *1 355,118.262 ppolyf_u
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
RNBG_t0 NBG__t0 NBG 319.655393327
* device instance NBG_t1 r0 *1 0,0 
RNBG_t1 NBG__t1 NBG 180.635494451
* device instance NBG_t2 r0 *1 0,0 
RNBG_t2 NBG__t2 NBG 74.3376726087
* device instance NBG_t3 r0 *1 0,0 
RNBG_t3 NBG__t3 NBG 497.957181646
* device instance NBG_t4 r0 *1 0,0 
RNBG_t4 NBG__t4 NBG 72.3456579667
* device instance NBG r0 *1 0,0 
CNBG NBG vsubs 2.6946068e-14
* device instance NC_t0 r0 *1 0,0 
RNC_t0 NC__t0 NC 58.0128241616
* device instance NC_t1 r0 *1 0,0 
RNC_t1 NC__t1 NC 5.17314575229
* device instance NC_t2 r0 *1 0,0 
RNC_t2 NC__t2 NC 12.3918471968
* device instance NC_t3 r0 *1 0,0 
RNC_t3 NC__t3 NC 2.88062399517
* device instance NC_t4 r0 *1 0,0 
RNC_t4 NC__t4 NC 11.6230131453
* device instance NC_t5 r0 *1 0,0 
RNC_t5 NC__t5 NC 5.29674321447
* device instance NC_t6 r0 *1 0,0 
RNC_t6 NC__t6 NC 8.50548296342
* device instance NC_t7 r0 *1 0,0 
RNC_t7 NC__t7 NC 12.4439514887
* device instance NC_t8 r0 *1 0,0 
RNC_t8 NC__t8 NC 8.42906808227
* device instance NC r0 *1 0,0 
CNC NC vsubs 1.06324522e-13
* device instance ND_t0 r0 *1 0,0 
RND_t0 ND__t0 ND 229.124892636
* device instance ND_t1 r0 *1 0,0 
RND_t1 ND__t1 ND 685.527951368
* device instance ND_t2 r0 *1 0,0 
RND_t2 ND__t2 ND 219.61306336
* device instance ND_t3 r0 *1 0,0 
RND_t3 ND__t3 ND 378.405592635
* device instance ND r0 *1 0,0 
CND ND vsubs 3.4769335e-14
* device instance NR_t0 r0 *1 0,0 
RNR_t0 NR__t0 NR 356.720721034
* device instance NR_t1 r0 *1 0,0
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
