2AMLogic/gf180-temp-por/layout/reports/temp_por_top/extracted-parasitics.spice

* extracted by klt extract --deck gf180mcu
* parasitic model (--parasitics):
* - capacitance: net-to-ground for every net's own (non-coupled) area/perimeter, plus net-to-net for the vertical-overlap coupling `coupling` describes below -- a coupled net pair gets a direct capacitor between their two hub nodes, not just capacitors to the deck's ground/substrate net
* - coupling: vertical overlap (crossover) unconditionally -- where one net's conductor on an adjacent metal level sits directly over another *distinct* net's conductor, that overlap area is charged between the two nets instead of to ground (issue #760) -- plus lateral (same-layer, sidewall) coupling, but only for a net pair naming one of the caller's declared `--critical-net` nets (issue #976): facing-edge length within that layer's own minimum-spacing lookback is charged between the two nets, *additively* (not deducted from either net's substrate fringe term, unlike the vertical case -- a known simplification). Any same-layer pair with neither side named `--critical-net`, and fringe shielding in general, are still not modelled
* - resistance: single lumped series resistance per net, distributed as a star across that net's device terminals (issue #592) -- not a per-segment, distributed RC ladder, *unless* `--distributed-rc` names this net via `--critical-net` (issue #977, Epic #709 Phase 2b): then the net's terminals are ordered along their approximate physical spread and its total R/C is broken into a chain of per-segment resistors (segment length proportional to inter-terminal distance) with a ground capacitor at each terminal node (proportional to its adjacent segment length/2), instead of one star hub -- still an approximation (terminal position is a device-placement proxy, not true per-segment routing geometry), but a strictly finer-grained one than the single-hub star
* - frequency: quasi-static -- one frequency-independent R and C per net; no skin effect, no distributed transmission-line behavior
.GLOBAL vsubs

* cell temp_por_top
* pin CTAT
* pin EN,RESETn
* pin PTAT
* pin VDD
* pin VSS
.SUBCKT temp_por_top CTAT EN|RESETn PTAT VDD VSS
* device instance $1 r0 *1 112.4,-399 nfet
M$1 \$8__t3 \$8__t2 VSS__t1 VSS__t176 nfet L=4U W=2U AS=1.6P AD=1.6P PS=5.6U
+ PD=5.6U
* device instance $2 r0 *1 119,-399 nfet
M$2 \$9__t2 \$8__t1 VSS__t75 VSS__t177 nfet L=4U W=2U AS=1.6P AD=1.6P PS=5.6U
+ PD=5.6U
* device instance $3 r0 *1 127.6,-398 nfet
M$3 \$12__t3 \$12__t1 VSS__t2 VSS__t182 nfet L=8U W=4U AS=3.2P AD=3.2P PS=9.6U
+ PD=9.6U
* device instance $4 r0 *1 138.2,-398 nfet
M$4 \$13__t0 \$12__t2 VSS__t68 VSS__t183 nfet L=8U W=4U AS=3.2P AD=3.2P PS=9.6U
+ PD=9.6U
* device instance $5 r0 *1 148.8,-396 nfet
M$5 \$6__t2 \$13__t1 VSS__t3 VSS__t190 nfet L=8U W=8U AS=6.4P AD=6.4P PS=17.6U
+ PD=17.6U
* device instance $6 r0 *1 159.4,-399.5 nfet
M$6 VDD__t43 VDD__t42 \$41__t2 VSS__t192 nfet L=8U W=1U AS=0.8P AD=0.8P PS=3.6U
+ PD=3.6U
* device instance $7 r0 *1 170,-399.5 nfet
M$7 \$41__t1 \$41__t0 \$42__t2 VSS__t193 nfet L=8U W=1U AS=0.8P AD=0.8P PS=3.6U
+ PD=3.6U
* device instance $8 r0 *1 180.6,-399.5 nfet
M$8 \$42__t1 \$42__t0 \$43__t2 VSS__t194 nfet L=8U W=1U AS=0.8P AD=0.8P PS=3.6U
+ PD=3.6U
* device instance $9 r0 *1 191.2,-399.5 nfet
M$9 \$43__t1 \$43__t0 \$44__t0 VSS__t195 nfet L=8U W=1U AS=0.8P AD=0.8P PS=3.6U
+ PD=3.6U
* device instance $10 r0 *1 201.8,-399.5 nfet
M$10 \$44__t1 \$44__t2 \$17__t3 VSS__t196 nfet L=8U W=1U AS=0.8P AD=0.8P
+ PS=3.6U PD=3.6U
* device instance $11 r0 *1 210.4,-399 nfet
M$11 \$39__t3 \$39__t2 VSS__t77 VSS__t178 nfet L=4U W=2U AS=1.6P AD=1.6P
+ PS=5.6U PD=5.6U
* device instance $12 r0 *1 217,-396 nfet
M$12 \$17__t0 \$39__t1 VSS__t4 VSS__t197 nfet L=4U W=8U AS=6.4P AD=6.4P
+ PS=17.6U PD=17.6U
* device instance $13 r0 *1 223.6,-399.5 nfet
M$13 \$6__t3 \$17__t1 VSS__t5 VSS__t198 nfet L=4U W=1U AS=0.8P AD=0.8P PS=3.6U
+ PD=3.6U
* device instance $14 r0 *1 230.2,-399 nfet
M$14 \$16__t2 \$16__t0 VSS__t76 VSS__t179 nfet L=4U W=2U AS=1.6P AD=1.6P
+ PS=5.6U PD=5.6U
* device instance $15 r0 *1 236.8,-399 nfet
M$15 \$15__t2 \$16__t1 VSS__t78 VSS__t180 nfet L=4U W=2U AS=1.6P AD=1.6P
+ PS=5.6U PD=5.6U
* device instance $16 r0 *1 241.9,-399 nfet
M$16 \$15__t0 \$17__t2 VSS__t6 VSS__t199 nfet L=1U W=2U AS=1.6P AD=1.6P PS=5.6U
+ PD=5.6U
* device instance $17 r0 *1 247,-399 nfet
M$17 \$40__t2 \$15__t1 VSS__t79 VSS__t181 nfet L=4U W=2U AS=1.6P AD=1.6P
+ PS=5.6U PD=5.6U
* device instance $18 r0 *1 251.85,-398 nfet
M$18 BIAS_OK__t0 \$40__t0 VSS__t7 VSS__t205 nfet L=0.5U W=4U AS=3.2P AD=3.2P
+ PS=9.6U PD=9.6U
* device instance $19 r0 *1 471.8,-399 nfet
M$19 \$20__t3 \$25__t2 \$24__t1 VSS__t200 nfet L=1U W=2U AS=1.6P AD=1.6P
+ PS=5.6U PD=5.6U
* device instance $20 r0 *1 475.4,-399 nfet
M$20 \$21__t4 VREF__t1 \$24__t2 VSS__t201 nfet L=1U W=2U AS=1.6P AD=1.6P
+ PS=5.6U PD=5.6U
* device instance $21 r0 *1 483.5,-399.5 nfet
M$21 \$24__t0 \$26__t0 VSS__t8 VSS__t206 nfet L=10U W=1U AS=0.8P AD=0.8P
+ PS=3.6U PD=3.6U
* device instance $22 r0 *1 492.1,-399 nfet
M$22 IBIAS__t1 \$26__t1 VSS__t9 VSS__t207 nfet L=2U W=2U AS=1.6P AD=1.6P
+ PS=5.6U PD=5.6U
* device instance $23 r0 *1 495.95,-399 nfet
M$23 IBIAS__t8 BIAS_OK__t3 \$26__t2 VSS__t210 nfet L=0.5U W=2U AS=1.6P AD=1.6P
+ PS=5.6U PD=5.6U
* device instance $24 r0 *1 499.05,-399 nfet
M$24 \$26__t3 BIAS_OKB__t1 VSS__t55 VSS__t211 nfet L=0.5U W=2U AS=1.6P AD=1.6P
+ PS=5.6U PD=5.6U
* device instance $25 r0 *1 502.4,-399.5 nfet
M$25 IBIAS__t2 BIAS_OKB__t2 VSS__t10 VSS__t218 nfet L=1U W=1U AS=0.8P AD=0.8P
+ PS=3.6U PD=3.6U
* device instance $26 r0 *1 505.75,-395 nfet
M$26 \$27__t1 \$23__t1 VSS__t11 VSS__t224 nfet L=0.5U W=10U AS=8P AD=8P
+ PS=21.6U PD=21.6U
* device instance $27 r0 *1 509.1,-399 nfet
M$27 \$21__t3 BIAS_OKB__t5 VSS__t66 VSS__t202 nfet L=1U W=2U AS=1.6P AD=1.6P
+ PS=5.6U PD=5.6U
* device instance $28 r0 *1 512.45,-399.5 nfet
M$28 \$23__t2 \$21__t1 VSS__t12 VSS__t226 nfet L=0.5U W=1U AS=0.8P AD=0.8P
+ PS=3.6U PD=3.6U
* device instance $29 r0 *1 515.55,-399.5 nfet
M$29 POR_RAW__t2 \$23__t3 VSS__t45 VSS__t227 nfet L=0.5U W=1U AS=0.8P AD=0.8P
+ PS=3.6U PD=3.6U
* device instance $30 r0 *1 523.35,-399.5 nfet
M$30 BIAS_OKB__t3 BIAS_OK__t1 VSS__t13 VSS__t230 nfet L=0.5U W=1U AS=0.5P
+ AD=0.8P PS=3U PD=3.6U
* device instance $31 r0 *1 922.8,-398 nfet
M$31 IBIAS__t3 IBIAS__t4 VSS__t14 VSS__t231 nfet L=4U W=4U AS=3.2P AD=3.2P
+ PS=9.6U PD=9.6U
* device instance $32 r0 *1 939.9,-399.75 nfet
M$32 \$28__t0 IBIAS__t5 VSS__t15 VSS__t232 nfet L=25U W=0.5U AS=0.4P AD=0.4P
+ PS=2.6U PD=2.6U
* device instance $33 r0 *1 960,-399 nfet
M$33 \$29__t0 \$29__t1 VSS__t16 VSS__t233 nfet L=10U W=2U AS=1.6P AD=1.6P
+ PS=5.6U PD=5.6U
* device instance $34 r0 *1 972.6,-395 nfet
M$34 \$30__t0 \$29__t2 VSS__t17 VSS__t234 nfet L=10U W=10U AS=8P AD=8P PS=21.6U
+ PD=21.6U
* device instance $35 r0 *1 980.45,-399.5 nfet
M$35 \$47__t4 POR_RAW__t1 \$30__t1 VSS__t228 nfet L=0.5U W=1U AS=0.8P AD=0.8P
+ PS=3.6U PD=3.6U
* device instance $36 r0 *1 983.55,-399 nfet
M$36 \$31__t2 \$47__t3 VSS__t58 VSS__t212 nfet L=0.5U W=2U AS=1.6P AD=1.6P
+ PS=5.6U PD=5.6U
* device instance $37 r0 *1 987.4,-399.75 nfet
M$37 \$32__t0 \$31__t0 VSS__t18 VSS__t235 nfet L=2U W=0.5U AS=0.4P AD=0.4P
+ PS=2.6U PD=2.6U
* device instance $38 r0 *1 991.5,-399.5 nfet
M$38 \$48__t6 \$32__t2 VSS__t51 VSS__t219 nfet L=1U W=1U AS=0.8P AD=0.8P
+ PS=3.6U PD=3.6U
* device instance $39 r0 *1 999.6,-399.75 nfet
M$39 \$33__t0 \$29__t3 VSS__t19 VSS__t236 nfet L=10U W=0.5U AS=0.4P AD=0.4P
+ PS=2.6U PD=2.6U
* device instance $40 r0 *1 1007.7,-399.5 nfet
M$40 \$49__t1 \$33__t3 VSS__t48 VSS__t220 nfet L=1U W=1U AS=0.8P AD=0.8P
+ PS=3.6U PD=3.6U
* device instance $41 r0 *1 1011.3,-399.5 nfet
M$41 \$33__t2 EN|RESETn__t3 VSS__t50 VSS__t221 nfet L=1U W=1U AS=0.8P AD=0.8P
+ PS=3.6U PD=3.6U
* device instance $42 r0 *1 1014.65,-399 nfet
M$42 \$37__t2 \$49__t2 \$34__t1 VSS__t213 nfet L=0.5U W=2U AS=1.6P AD=1.6P
+ PS=5.6U PD=5.6U
* device instance $43 r0 *1 1017.75,-399 nfet
M$43 \$34__t0 \$31__t3 VSS__t56 VSS__t214 nfet L=0.5U W=2U AS=1.6P AD=1.6P
+ PS=5.6U PD=5.6U
* device instance $44 r0 *1 1132.25,-395 nfet
M$44 EN|RESETn__t2 \$37__t3 VSS__t47 VSS__t225 nfet L=0.5U W=10U AS=8P AD=8P
+ PS=21.6U PD=21.6U
* device instance $45 r0 *1 49.5,-2 nfet
M$45 VSS__t63 VSS__t61 VSS__t74 VSS__t184 nfet L=8U W=4U AS=3.2P AD=3.2P
+ PS=9.6U PD=9.6U
* device instance $46 r0 *1 59.6,-2 nfet
M$46 N1__t5 N1__t3 VSS__t73 VSS__t185 nfet L=8U W=4U AS=3.2P AD=3.2P PS=9.6U
+ PD=9.6U
* device instance $47 r0 *1 69.7,-2 nfet
M$47 N2__t4 N1__t2 VSS__t72 VSS__t186 nfet L=8U W=4U AS=3.2P AD=3.2P PS=9.6U
+ PD=9.6U
* device instance $48 r0 *1 79.8,-2 nfet
M$48 N2__t3 N1__t1 VSS__t71 VSS__t187 nfet L=8U W=4U AS=3.2P AD=3.2P PS=9.6U
+ PD=9.6U
* device instance $49 r0 *1 89.9,-2 nfet
M$49 N1__t4 N1__t0 VSS__t70 VSS__t188 nfet L=8U W=4U AS=3.2P AD=3.2P PS=9.6U
+ PD=9.6U
* device instance $50 r0 *1 100,-2 nfet
M$50 VSS__t62 VSS__t60 VSS__t69 VSS__t189 nfet L=8U W=4U AS=3.2P AD=3.2P
+ PS=9.6U PD=9.6U
* device instance $51 r0 *1 177.5,-4 nfet
M$51 PG__t10 N2__t2 VSS__t67 VSS__t191 nfet L=8U W=8U AS=6.4P AD=6.4P PS=17.6U
+ PD=17.6U
* device instance $52 r0 *1 190.7,-2 nfet
M$52 IBIAS__t6 NBG__t0 VSS__t20 VSS__t237 nfet L=2U W=4U AS=3.2P AD=3.2P
+ PS=9.6U PD=9.6U
* device instance $53 r0 *1 194.05,-1 nfet
M$53 IBIAS__t7 EN|RESETn__t4 NBG__t4 VSS__t215 nfet L=0.5U W=2U AS=1.6P AD=1.6P
+ PS=5.6U PD=5.6U
* device instance $54 r0 *1 196.65,-1 nfet
M$54 NBG__t3 ENB__t2 VSS__t57 VSS__t216 nfet L=0.5U W=2U AS=1.6P AD=1.6P
+ PS=5.6U PD=5.6U
* device instance $55 r0 *1 200,-2 nfet
M$55 PB__t5 NBG__t2 VSS__t44 VSS__t238 nfet L=2U W=4U AS=3.2P AD=3.2P PS=9.6U
+ PD=9.6U
* device instance $56 r0 *1 210.2,-2 nfet
M$56 PCAS__t0 NBG__t1 VSS__t43 VSS__t239 nfet L=2U W=4U AS=3.2P AD=3.2P PS=9.6U
+ PD=9.6U
* device instance $57 r0 *1 226.25,-0.5 nfet
M$57 ENB__t4 EN|RESETn__t5 VSS__t46 VSS__t229 nfet L=0.5U W=1U AS=0.8P AD=0.8P
+ PS=3.6U PD=3.6U
* device instance $58 r0 *1 239.7,-1 nfet
M$58 ND__t2 NR__t2 VSS__t54 VSS__t208 nfet L=2U W=2U AS=1.6P AD=1.6P PS=5.6U
+ PD=5.6U
* device instance $59 r0 *1 243.3,-2 nfet
M$59 PG__t0 ND__t0 VSS__t21 VSS__t240 nfet L=1U W=4U AS=3.2P AD=3.2P PS=9.6U
+ PD=9.6U
* device instance $60 r0 *1 253,-1 nfet
M$60 NR__t0 NR__t1 VSS__t53 VSS__t209 nfet L=2U W=2U AS=1.6P AD=1.6P PS=5.6U
+ PD=5.6U
* device instance $61 r0 *1 256.35,-1 nfet
M$61 ND__t3 ENB__t3 VSS__t59 VSS__t217 nfet L=0.5U W=2U AS=1.6P AD=1.6P PS=5.6U
+ PD=5.6U
* device instance $62 r0 *1 261.8,-0.5 nfet
M$62 PTAT__t1 ENB__t1 VSS__t52 VSS__t222 nfet L=1U W=1U AS=0.8P AD=0.8P PS=3.6U
+ PD=3.6U
* device instance $63 r0 *1 264.9,-0.5 nfet
M$63 CTAT__t1 ENB__t0 VSS__t49 VSS__t223 nfet L=1U W=1U AS=0.8P AD=0.8P PS=3.6U
+ PD=3.6U
* device instance $64 r0 *1 268,-1 nfet
M$64 N2__t1 ENB__t6 VSS__t64 VSS__t203 nfet L=1U W=2U AS=1.6P AD=1.6P PS=5.6U
+ PD=5.6U
* device instance $65 r0 *1 271.1,-1 nfet
M$65 NT__t1 ENB__t7 VSS__t65 VSS__t204 nfet L=1U W=2U AS=1.6P AD=1.6P PS=5.6U
+ PD=5.6U
* device instance $66 r0 *1 273.95,-16 nfet
M$66 T5__t2 VDD__t31 T4__t3 VSS__t241 nfet L=0.5U W=32U AS=25.6P AD=25.6P
+ PS=65.6U PD=65.6U
* device instance $67 r0 *1 276.55,-16 nfet
M$67 T3__t2 VSS__t22 T2__t3 VSS__t242 nfet L=0.5U W=32U AS=25.6P AD=25.6P
+ PS=65.6U PD=65.6U
* device instance $68 r0 *1 279.15,-16 nfet
M$68 T1__t2 VSS__t41 T0__t3 VSS__t243 nfet L=0.5U W=32U AS=25.6P AD=25.6P
+ PS=65.6U PD=65.6U
* device instance $69 r0 *1 281.75,-16 nfet
M$69 T0__t2 VSS__t42 VSS__t23 VSS__t244 nfet L=0.5U W=32U AS=25.6P AD=25.6P
+ PS=65.6U PD=65.6U
* device instance $70 r0 *1 284.35,-16 nfet
M$70 T2__t2 VSS__t39 T1__t3 VSS__t245 nfet L=0.5U W=32U AS=25.6P AD=25.6P
+ PS=65.6U PD=65.6U
* device instance $71 r0 *1 286.95,-16 nfet
M$71 T4__t0 VSS__t40 T3__t3 VSS__t246 nfet L=0.5U W=32U AS=25.6P AD=25.6P
+ PS=65.6U PD=65.6U
* device instance $72 r0 *1 2.8,-396 pfet
M$72 \$63__t0 \$6__t0 VDD__t2 \$65 pfet L=4U W=8U AS=6.4P AD=6.4P PS=17.6U
+ PD=17.6U
* device instance $73 r0 *1 9.4,-396 pfet
M$73 \$7__t1 \$6__t6 VDD__t51 \$65 pfet L=4U W=8U AS=6.4P AD=6.4P PS=17.6U
+ PD=17.6U
* device instance $74 r0 *1 16,-396 pfet
M$74 VREF__t2 \$6__t7 VDD__t52 \$65 pfet L=4U W=8U AS=6.4P AD=6.4P PS=17.6U
+ PD=17.6U
* device instance $75 r0 *1 22.6,-399 pfet
M$75 \$8__t0 \$6__t1 VDD__t3 \$65 pfet L=4U W=2U AS=1.6P AD=1.6P PS=5.6U PD=5.6U
* device instance $76 r0 *1 29.2,-399 pfet
M$76 \$9__t5 \$9__t6 VDD__t48 \$65 pfet L=4U W=2U AS=1.6P AD=1.6P PS=5.6U
+ PD=5.6U
* device instance $77 r0 *1 35.8,-380 pfet
M$77 IBIAS__t0 \$9__t0 VDD__t1 \$65 pfet L=4U W=40U AS=32P AD=32P PS=81.6U
+ PD=81.6U
* device instance $78 r0 *1 42.4,-399 pfet
M$78 \$11__t2 \$9__t7 VDD__t49 \$65 pfet L=4U W=2U AS=1.6P AD=1.6P PS=5.6U
+ PD=5.6U
* device instance $79 r0 *1 49,-392 pfet
M$79 \$12__t0 \$63__t1 \$11__t0 \$65 pfet L=4U W=16U AS=12.8P AD=12.8P PS=33.6U
+ PD=33.6U
* device instance $80 r0 *1 55.6,-392 pfet
M$80 \$13__t3 \$18__t2 \$11__t1 \$65 pfet L=4U W=16U AS=12.8P AD=12.8P PS=33.6U
+ PD=33.6U
* device instance $81 r0 *1 62.2,-399 pfet
M$81 \$6__t5 \$9__t8 VDD__t50 \$65 pfet L=4U W=2U AS=1.6P AD=1.6P PS=5.6U
+ PD=5.6U
* device instance $82 r0 *1 68.8,-399.5 pfet
M$82 \$39__t0 \$9__t1 VDD__t4 \$65 pfet L=4U W=1U AS=0.8P AD=0.8P PS=3.6U
+ PD=3.6U
* device instance $83 r0 *1 75.4,-399.5 pfet
M$83 \$14__t0 \$9__t3 VDD__t45 \$65 pfet L=4U W=1U AS=0.8P AD=0.8P PS=3.6U
+ PD=3.6U
* device instance $84 r0 *1 82,-396 pfet
M$84 \$15__t3 \$63__t3 \$14__t1 \$65 pfet L=4U W=8U AS=6.4P AD=6.4P PS=17.6U
+ PD=17.6U
* device instance $85 r0 *1 88.6,-396 pfet
M$85 \$16__t3 \$7__t2 \$14__t2 \$65 pfet L=4U W=8U AS=6.4P AD=6.4P PS=17.6U
+ PD=17.6U
* device instance $86 r0 *1 95.2,-399.5 pfet
M$86 \$40__t3 \$9__t4 VDD__t46 \$65 pfet L=4U W=1U AS=0.8P AD=0.8P PS=3.6U
+ PD=3.6U
* device instance $87 r0 *1 101.8,-399.5 pfet
M$87 BIAS_OK__t4 \$40__t4 VDD__t47 \$65 pfet L=4U W=1U AS=0.8P AD=0.8P PS=3.6U
+ PD=3.6U
* device instance $88 r0 *1 451.3,-398 pfet
M$88 \$20__t0 \$20__t1 \$19__t0 \$51 pfet L=1U W=4U AS=3.2P AD=3.2P PS=9.6U
+ PD=9.6U
* device instance $89 r0 *1 454.9,-398 pfet
M$89 \$21__t2 \$20__t2 \$19__t2 \$51 pfet L=1U W=4U AS=3.2P AD=3.2P PS=9.6U
+ PD=9.6U
* device instance $90 r0 *1 458.25,-398 pfet
M$90 \$19__t1 BIAS_OKB__t0 VDD__t5 \$51 pfet L=0.5U W=4U AS=3.2P AD=3.2P
+ PS=9.6U PD=9.6U
* device instance $91 r0 *1 461.35,-399 pfet
M$91 \$23__t0 \$21__t0 VDD__t6 \$51 pfet L=0.5U W=2U AS=1.6P AD=1.6P PS=5.6U
+ PD=5.6U
* device instance $92 r0 *1 464.45,-399 pfet
M$92 POR_RAW__t3 \$23__t4 VDD__t37 \$51 pfet L=0.5U W=2U AS=1.6P AD=1.6P
+ PS=5.6U PD=5.6U
* device instance $93 r0 *1 1029.6,-399 pfet
M$93 \$28__t1 \$28__t2 VDD__t7 \$53 pfet L=10U W=2U AS=1.6P AD=1.6P PS=5.6U
+ PD=5.6U
* device instance $94 r0 *1 1042.2,-399 pfet
M$94 \$29__t4 \$28__t6 VDD__t35 \$53 pfet L=10U W=2U AS=1.6P AD=1.6P PS=5.6U
+ PD=5.6U
* device instance $95 r0 *1 1054.8,-395 pfet
M$95 \$35__t0 \$28__t3 VDD__t8 \$53 pfet L=10U W=10U AS=8P AD=8P PS=21.6U
+ PD=21.6U
* device instance $96 r0 *1 1067.4,-399.75 pfet
M$96 \$36__t1 \$28__t4 VDD__t9 \$53 pfet L=10U W=0.5U AS=0.4P AD=0.4P PS=2.6U
+ PD=2.6U
* device instance $97 r0 *1 1080,-399.75 pfet
M$97 \$49__t0 \$28__t5 VDD__t33 \$53 pfet L=10U W=0.5U AS=0.4P AD=0.4P PS=2.6U
+ PD=2.6U
* device instance $98 r0 *1 1087.85,-399.5 pfet
M$98 \$47__t0 POR_RAW__t0 \$35__t1 \$53 pfet L=0.5U W=1U AS=0.8P AD=0.8P
+ PS=3.6U PD=3.6U
* device instance $99 r0 *1 1091.7,-399.75 pfet
M$99 \$31__t1 \$47__t1 VDD__t10 \$53 pfet L=2U W=0.5U AS=0.4P AD=0.4P PS=2.6U
+ PD=2.6U
* device instance $100 r0 *1 1095.55,-399 pfet
M$100 \$32__t3 \$31__t5 VDD__t36 \$53 pfet L=0.5U W=2U AS=1.6P AD=1.6P PS=5.6U
+ PD=5.6U
* device instance $101 r0 *1 1098.9,-399 pfet
M$101 \$48__t0 \$32__t1 \$36__t0 \$53 pfet L=1U W=2U AS=1.6P AD=1.6P PS=5.6U
+ PD=5.6U
* device instance $102 r0 *1 1102.5,-399 pfet
M$102 \$33__t1 \$48__t1 VDD__t32 \$53 pfet L=1U W=2U AS=1.6P AD=1.6P PS=5.6U
+ PD=5.6U
* device instance $103 r0 *1 1105.85,-398 pfet
M$103 \$37__t5 \$49__t3 VDD__t41 \$53 pfet L=0.5U W=4U AS=3.2P AD=3.2P PS=9.6U
+ PD=9.6U
* device instance $104 r0 *1 1108.95,-398 pfet
M$104 \$37__t4 \$31__t4 VDD__t40 \$53 pfet L=0.5U W=4U AS=3.2P AD=3.2P PS=9.6U
+ PD=9.6U
* device instance $105 r0 *1 1116.8,-399.75 pfet
M$105 \$37__t1 EN|RESETn__t1 VDD__t34 \$53 pfet L=10U W=0.5U AS=0.4P AD=0.4P
+ PS=2.6U PD=2.6U
* device instance $106 r0 *1 1124.9,-399.5 pfet
M$106 EN|RESETn__t0 \$37__t0 VDD__t11 \$53 pfet L=1U W=1U AS=0.8P AD=0.8P
+ PS=3.6U PD=3.6U
* device instance $107 r0 *1 2.8,42 pfet
M$107 NT__t2 NT__t4 NT__t9 \$100 pfet L=4U W=16U AS=12.8P AD=12.8P PS=33.6U
+ PD=33.6U
* device instance $108 r0 *1 8.9,42 pfet
M$108 N1__t6 NA__t4 NT__t8 \$100 pfet L=4U W=16U AS=12.8P AD=12.8P PS=33.6U
+ PD=33.6U
* device instance $109 r0 *1 15,42 pfet
M$109 N2__t6 NB__t4 NT__t7 \$100 pfet L=4U W=16U AS=12.8P AD=12.8P PS=33.6U
+ PD=33.6U
* device instance $110 r0 *1 21.1,42 pfet
M$110 N2__t5 NB__t3 NT__t6 \$100 pfet L=4U W=16U AS=12.8P AD=12.8P PS=33.6U
+ PD=33.6U
* device instance $111 r0 *1 27.2,42 pfet
M$111 N1__t7 NA__t5 NT__t10 \$100 pfet L=4U W=16U AS=12.8P AD=12.8P PS=33.6U
+ PD=33.6U
* device instance $112 r0 *1 33.3,42 pfet
M$112 NT__t3 NT__t5 NT__t11 \$100 pfet L=4U W=16U AS=12.8P AD=12.8P PS=33.6U
+ PD=33.6U
* device instance $113 r0 *1 41.4,44 pfet
M$113 NT__t0 PB__t0 VDD__t14 \$101 pfet L=4U W=20U AS=16P AD=16P PS=41.6U
+ PD=41.6U
* device instance $114 r0 *1 108.1,36 pfet
M$114 VDD__t23 VDD__t22 VDD__t24 \$101 pfet L=4U W=4U AS=3.2P AD=3.2P PS=9.6U
+ PD=9.6U
* device instance $115 r0 *1 114.2,36 pfet
M$115 M1D__t0 PG__t3 VDD__t25 \$101 pfet L=4U W=4U AS=3.2P AD=3.2P PS=9.6U
+ PD=9.6U
* device instance $116 r0 *1 118.8,36 pfet
M$116 NA__t3 PCAS__t4 M1D__t3 \$101 pfet L=1U W=4U AS=3.2P AD=3.2P PS=9.6U
+ PD=9.6U
* device instance $117 r0 *1 123.4,36 pfet
M$117 M2D__t0 PG__t4 VDD__t26 \$101 pfet L=4U W=4U AS=3.2P AD=3.2P PS=9.6U
+ PD=9.6U
* device instance $118 r0 *1 128,36 pfet
M$118 NB__t1 PCAS__t6 M2D__t2 \$101 pfet L=1U W=4U AS=3.2P AD=3.2P PS=9.6U
+ PD=9.6U
* device instance $119 r0 *1 132.6,36 pfet
M$119 M3D__t0 PG__t5 VDD__t27 \$101 pfet L=4U W=4U AS=3.2P AD=3.2P PS=9.6U
+ PD=9.6U
* device instance $120 r0 *1 137.2,36 pfet
M$120 PTAT__t2 PCAS__t5 M3D__t2 \$101 pfet L=1U W=4U AS=3.2P AD=3.2P PS=9.6U
+ PD=9.6U
* device instance $121 r0 *1 140.3,36 pfet
M$121 PTAT__t3 PCAS__t8 M3D__t3 \$101 pfet L=1U W=4U AS=3.2P AD=3.2P PS=9.6U
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
Q$154 VSS__t98 VSS__t31 NC__t5 bjt AE=100P PE=40U AB=144P PB=48U AC=144P PC=48U
+ NE=1
* device instance $155 r0 *1 988.8,-362.3 cap_mim_2f0_m4m5_noshield
C$155 \$47__t2 VSS__t25 2.512752e-13
* device instance $156 r0 *1 935.7,-353.8 cap_mim_2f0_m4m5_noshield
C$156 \$48__t2 VSS__t24 1.5868496e-12
* device instance $157 r0 *1 966.5,-353.8 cap_mim_2f0_m4m5_noshield
C$157 \$48__t5 VSS__t38 1.5868496e-12
* device instance $158 r0 *1 292.4,-329.3 cap_mim_2f0_m4m5_noshield
C$158 VDD__t12 \$40__t1 7.73592e-14
* device instance $159 r0 *1 276.6,-322.3 cap_mim_2f0_m4m5_noshield
C$159 \$6__t4 \$45__t0 8.15064e-13
* device instance $160 r0 *1 935.7,-323 cap_mim_2f0_m4m5_noshield
C$160 \$48__t4 VSS__t37 1.5868496e-12
* device instance $161 r0 *1 966.5,-323 cap_mim_2f0_m4m5_noshield
C$161 \$48__t3 VSS__t36 1.5868496e-12
* device instance $162 r0 *1 206.7,68.7 cap_mim_2f0_m4m5_noshield
C$162 PG__t2 NZ__t0 2.979984e-13
* device instance $163 r0 *1 307,92.867 ppolyf_u
R$163 NB__t0 \$141__t0 VSS__t99 10453.625 ppolyf_u L=59.735U W=2U
* device instance $164 r0 *1 310,92.867 ppolyf_u
R$164 NC__t0 \$141__t1 VSS__t100 10453.625 ppolyf_u L=59.735U W=2U
* device instance $165 r0 *1 313,90.762 ppolyf_u
R$165 NA__t0 \$139__t0 VSS__t101 9716.875 ppolyf_u L=55.525U W=2U
* device instance $166 r0 *1 316,90.762 ppolyf_u
R$166 CTAT__t0 \$139__t1 VSS__t102 9716.875 ppolyf_u L=55.525U W=2U
* device instance $167 r0 *1 319,113 ppolyf_u
R$167 NZ__t1 \$142__t0 VSS__t103 17500 ppolyf_u L=100U W=2U
* device instance $168 r0 *1 322,113 ppolyf_u
R$168 \$102__t0 \$142__t1 VSS__t104 17500 ppolyf_u L=100U W=2U
* device instance $169 r0 *1 325,113 ppolyf_u
R$169 \$102__t1 \$143__t0 VSS__t105 17500 ppolyf_u L=100U W=2U
* device instance $170 r0 *1 328,113 ppolyf_u
R$170 \$103__t0 \$143__t1 VSS__t106 17500 ppolyf_u L=100U W=2U
* device instance $171 r0 *1 331,113 ppolyf_u
R$171 \$103__t1 \$144__t0 VSS__t107 17500 ppolyf_u L=100U W=2U
* device instance $172 r0 *1 334,113 ppolyf_u
R$172 \$104__t1 \$144__t1 VSS__t108 17500 ppolyf_u L=100U W=2U
* device instance $173 r0 *1 337,113 ppolyf_u
R$173 \$104__t0 \$145__t1 VSS__t109 17500 ppolyf_u L=100U W=2U
* device instance $174 r0 *1 340,113 ppolyf_u
R$174 \$105__t1 \$145__t0 VSS__t110 17500 ppolyf_u L=100U W=2U
* device instance $175 r0 *1 343,113 ppolyf_u
R$175 \$105__t0 \$146__t1 VSS__t111 17500 ppolyf_u L=100U W=2U
* device instance $176 r0 *1 346,113 ppolyf_u
R$176 N2__t0 \$146__t0 VSS__t112 17500 ppolyf_u L=100U W=2U
* device instance $177 r0 *1 349,118.262 ppolyf_u
R$177 PTAT__t0 \$147__t0 VSS__t113 19341.875 ppolyf_u L=110.525U W=2U
* device instance $178 r0 *1 352,118.262 ppolyf_u
R$178 \$106__t1 \$147__t1 VSS__t114 19341.875 ppolyf_u L=110.525U W=2U
* device instance $179 r0 *1 355,118.262 ppolyf_u
R$179 \$106__t0 \$148__t0 VSS__t115 19341.875 ppolyf_u L=110.525U W=2U
* device instance $180 r0 *1 358,118.262 ppolyf_u
R$180 \$107__t1 \$148__t1 VSS__t116 19341.875 ppolyf_u L=110.525U W=2U
* device instance $181 r0 *1 361,118.262 ppolyf_u
R$181 \$107__t0 \$149__t0 VSS__t117 19341.875 ppolyf_u L=110.525U W=2U
* device instance $182 r0 *1 364,118.262 ppolyf_u
R$182 \$108__t1 \$149__t1 VSS__t118 19341.875 ppolyf_u L=110.525U W=2U
* device instance $183 r0 *1 367,118.262 ppolyf_u
R$183 \$108__t0 \$150__t1 VSS__t119 19341.875 ppolyf_u L=110.525U W=2U
* device instance $184 r0 *1 370,118.262 ppolyf_u
R$184 \$109__t1 \$150__t0 VSS__t120 19341.875 ppolyf_u L=110.525U W=2U
* device instance $185 r0 *1 373,118.262 ppolyf_u
R$185 \$109__t0 \$151__t1 VSS__t121 19341.875 ppolyf_u L=110.525U W=2U
* device instance $186 r0 *1 376,118.262 ppolyf_u
R$186 \$110__t1 \$151__t0 VSS__t122 19341.875 ppolyf_u L=110.525U W=2U
* device instance $187 r0 *1 379,118.262 ppolyf_u
R$187 \$110__t0 \$152__t1 VSS__t123 19341.875 ppolyf_u L=110.525U W=2U
* device instance $188 r0 *1 382,118.262 ppolyf_u
R$188 \$111__t1 \$152__t0 VSS__t124 19341.875 ppolyf_u L=110.525U W=2U
* device instance $189 r0 *1 385,118.262 ppolyf_u
R$189 \$111__t0 \$153__t1 VSS__t125 19341.875 ppolyf_u L=110.525U W=2U
* device instance $190 r0 *1 388,118.262 ppolyf_u
R$190 \$112__t0 \$153__t0 VSS__t126 19341.875 ppolyf_u L=110.525U W=2U
* device instance $191 r0 *1 391,118.262 ppolyf_u
R$191 \$112__t1 \$154__t1 VSS__t127 19341.875 ppolyf_u L=110.525U W=2U
* device instance $192 r0 *1 394,118.262 ppolyf_u
R$192 \$113__t1 \$154__t0 VSS__t128 19341.875 ppolyf_u L=110.525U W=2U
* device instance $193 r0 *1 397,118.262 ppolyf_u
R$193 \$113__t0 \$155__t1 VSS__t129 19341.875 ppolyf_u L=110.525U W=2U
* device instance $194 r0 *1 400,118.262 ppolyf_u
R$194 \$114__t1 \$155__t0 VSS__t130 19341.875 ppolyf_u L=110.525U W=2U
* device instance $195 r0 *1 403,118.262 ppolyf_u
R$195 \$114__t0 \$156__t1 VSS__t131 19341.875 ppolyf_u L=110.525U W=2U
* device instance $196 r0 *1 406,118.262 ppolyf_u
R$196 \$115__t1 \$156__t0 VSS__t132 19341.875 ppolyf_u L=110.525U W=2U
* device instance $197 r0 *1 409,118.262 ppolyf_u
R$197 \$115__t0 \$157__t1 VSS__t133 19341.875 ppolyf_u L=110.525U W=2U
* device instance $198 r0 *1 412,118.262 ppolyf_u
R$198 \$116__t1 \$157__t0 VSS__t134 19341.875 ppolyf_u L=110.525U W=2U
* device instance $199 r0 *1 415,118.262 ppolyf_u
R$199 \$116__t0 \$158__t1 VSS__t135 19341.875 ppolyf_u L=110.525U W=2U
* device instance $200 r0 *1 418,118.262 ppolyf_u
R$200 T5__t1 \$158__t0 VSS__t136 19341.875 ppolyf_u L=110.525U W=2U
* device instance $201 r0 *1 421,120.427 ppolyf_u
R$201 T5__t0 \$159__t0 VSS__t137 20099.625 ppolyf_u L=114.855U W=2U
* device instance $202 r0 *1 424,120.427 ppolyf_u
R$202 T4__t2 \$159__t1 VSS__t138 20099.625 ppolyf_u L=114.855U W=2U
* device instance $203 r0 *1 427,91.672 ppolyf_u
R$203 T4__t1 \$140__t0 VSS__t139 10035.375 ppolyf_u L=57.345U W=2U
* device instance $204 r0 *1 430,91.672 ppolyf_u
R$204 T3__t1 \$140__t1 VSS__t140 10035.375 ppolyf_u L=57.345U W=2U
* device instance $205 r0 *1 433,77.295 ppolyf_u
R$205 T3__t0 \$131__t0 VSS__t141 5003.25 ppolyf_u L=28.59U W=2U
* device instance $206 r0 *1 436,77.295 ppolyf_u
R$206 T2__t1 \$131__t1 VSS__t142 5003.25 ppolyf_u L=28.59U W=2U
* device instance $207 r0 *1 439,70.105 ppolyf_u
R$207 T2__t0 \$127__t0 VSS__t143 2486.75 ppolyf_u L=14.21U W=2U
* device instance $208 r0 *1 442,70.105 ppolyf_u
R$208 T1__t1 \$127__t1 VSS__t144 2486.75 ppolyf_u L=14.21U W=2U
* device instance $209 r0 *1 445,66.507 ppolyf_u
R$209 T1__t0 \$123__t0 VSS__t145 1227.625 ppolyf_u L=7.015U W=2U
* device instance $210 r0 *1 448,66.507 ppolyf_u
R$210 T0__t1 \$123__t1 VSS__t146 1227.625 ppolyf_u L=7.015U W=2U
* device instance $211 r0 *1 451,64.712 ppolyf_u
R$211 T0__t0 \$122__t0 VSS__t147 599.375 ppolyf_u L=3.425U W=2U
* device instance $212 r0 *1 454,64.712 ppolyf_u
R$212 VSS__t26 \$122__t1 VSS__t148 599.375 ppolyf_u L=3.425U W=2U
* device instance $213 r0 *1 607,-326.549 ppolyf_u_1k
R$213 \$25__t0 VDD__t0 VSS__t149 3948720 ppolyf_u_1k L=7897.44U W=2U
* device instance $214 r0 *1 759,-331.96 ppolyf_u_1k
R$214 \$27__t0 \$25__t1 VSS__t150 3384615 ppolyf_u_1k L=6769.23U W=2U
* device instance $215 r0 *1 860,-381.13 ppolyf_u_1k
R$215 VSS__t0 \$27__t2 VSS__t151 387500 ppolyf_u_1k L=775U W=2U
* device instance $216 r0 *1 342.9,-258.75 ppolyf_u_1k
R$216 VREF__t0 \$71__t0 VSS__t152 128250 ppolyf_u_1k L=256.5U W=2U
* device instance $217 r0 *1 345.9,-258.75 ppolyf_u_1k
R$217 \$54__t1 \$71__t1 VSS__t153 128250 ppolyf_u_1k L=256.5U W=2U
* device instance $218 r0 *1 348.9,-258.75 ppolyf_u_1k
R$218 \$54__t0 \$72__t1 VSS__t160 128250 ppolyf_u_1k L=256.5U W=2U
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
