2AMLogic/gf180-temp-por/sim/bias-core-designer-check/testbench-postlayout/tb_bias_core.spice

* tb_bias_core -- GENERATED by sim/build_tb.py
* Do not edit. Sources:
*   sim/bias-core-designer-check/testbench/stimulus.spice
*   layout/postlayout/bias_core.spice  (sha256 8e3b70ffd40338a7d820f3081b68939c54ef88915968a8af243aba8af6a7453c)
* Regenerate with:
*   python3 sim/build_tb.py

* bias-core-designer-check -- stimulus half of the testbench fragment.
*
* The other half is a verbatim copy of design/netlist/bias_core.spice,
* appended by sim/build_tb.py to produce tb_bias_core.spice. Edit THIS file
* (or the schematic), never the generated fragment.
*
* Netlist FRAGMENT: no .include / .lib / .temp / .control / .end -- the
* harness owns those. Parameters it supplies: vdd_val, vdd_nom, temp_c.
*
* bias_core has NO enable pin and no off state, so there is only one Iq
* state to measure: the always-on one. That is exactly the state
* spec/target-spec.md SS5 rule 1 quotes por-iq in, which is why this record
* can charge the whole of branch 1's supply current to that row without any
* apportionment argument.
*
* FIVE branches, all in one transient so every number below comes from one
* corner point:
*
*   1. xst   STATIC DUT at this point's vdd_val, DC supply. Supplies the
*            settled numbers (VREF, IBIAS, Iq, BIAS_OK) AND the degenerate-
*            state check: this deck does NOT use `uic`, so ngspice solves a
*            real operating point at t=0 with this branch already at full
*            rail. `vref_op_v` samples that solution. A bandgap loop has a
*            zero-current solution as well as its intended one, and the DC
*            solver is free to land on it -- design/temp_core.md records
*            exactly that happening to #9's first revision. If it lands
*            there here, vref_op_v reads ~0 and the check fails.
*
*   2. xs    SLOW ramp (0 -> vdd_val in 500 us), then held. Supplies settling
*            time, the core's dropout voltage, and BIAS_OK's assertion point
*            measured against the reference's OWN settled value at the same
*            corner (branch 1's), not against a hardcoded target.
*
*   3. xf    FAST ramp: 0 -> vdd_val in 3.63 us, i.e. exactly 1.0 V/us at
*            the 3.63 V rail -- spec/target-spec.md#por-ramp-rate's ratified
*            FAST LIMIT, not beyond it. This is where a reference that is
*            still settling could let the POR comparator release early, so
*            both ramps carry the release guard and the false-valid integral
*            below.
*
*   4. xb    SHALLOW BROWNOUT: settle, dip to 0.5 V (rail low but nodes
*            still charged -- the classic latch trap), recover, hold.
*            `bo_shallow_ppm` compares the reference before and after.
*
*   5. xd    DEEP BROWNOUT: settle, collapse to 0 V, recover, hold.
*            `bo_deep_ppm` compares the reference before and after;
*            `ok_bo_dip_mv` / `t_bo_recover_us` / `ok_bo_end_droop_mv` are
*            taken here.
*
* WHY 4 AND 5 ARE SEPARATE DUTS, AND WHY THE TRANSIENT RUNS TO 30 ms
* (issue #185). Both were one serialized branch on a 2 ms transient until
* the post-layout re-run (#84) made the cost of that visible: this cell's
* own documented STARVED-LOOP WINDOW (design/bias_core.md) is longer than
* 2 ms at many corners once real interconnect parasitics are in the netlist,
* so the 2 ms deck was shorter than the phenomenon it was measuring. Three
* separate symptoms, all one cause:
*
*   - `t_bo_recover_us` read NEGATIVE at 34 of 81 points in record
*     20260811-063744-5ff219c -- a recovery before the rail returned, which
*     is impossible. `when v(bias_okb)=1.4 rise=last` had no genuine
*     post-collapse crossing inside 2 ms to find, so it returned the
*     capacitive blip BIAS_OK makes while the rail's own 10 us return ramp
*     drags the high-impedance node through 1.4 V.
*   - `t_false_ok_fast_us` and `t_false_ok_brownout_us` SATURATED against
*     the integration window (14 points each within 25 us of the ceiling),
*     understating the false-valid time by up to an order of magnitude.
*     design/bias_core.md's own text already recorded a 4.4 ms starved
*     window at sf/-40 C, i.e. longer than the deck that was measuring it.
*   - `bo_shallow_ppm`, `bo_deep_ppm` and `ok_bo_end_droop_mv` are fixed
*     wall-clock samples that consequently landed INSIDE the starved window
*     rather than after it, so they reported the starved loop instead of the
*     property in their own descriptions. At tt/27 C/3.63 V the 1.95 ms
*     `ok_bo_end` sample landed in the 113 us notch during which BIAS_OK is
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
