2AMLogic/gf180-temp-por/sim/tests/test_characterize.py

#!/usr/bin/env python3
"""Unit tests for sim/characterize.py (`make characterize`'s driver, #292).

No PDK and no ngspice required -- these only exercise discovery, argument
handling, and the --list dry-run path, never a real ngspice invocation.
"""

from __future__ import annotations

import contextlib
import io
import subprocess
import sys
import unittest
from types import SimpleNamespace
from unittest import mock
from pathlib import Path

SIM_DIR = Path(__file__).resolve().parents[1]
REPO_ROOT = SIM_DIR.parent
sys.path.insert(0, str(SIM_DIR))

import characterize  # noqa: E402
from harness import cliutil  # noqa: E402


class ExperimentDiscoveryTests(unittest.TestCase):
    def test_experiments_matches_run_corners_and_run_mc_discovery(self):
        """characterize.experiments() must partition the same set discover()
        returns, with the mc/grid split matching each testbench's own 'mc' key
        -- two independent driver scripts silently diverging on what "every
        experiment" means would be exactly the kind of gap #292 exists to
        close."""
        found = characterize.experiments()
        self.assertGreater(len(found), 0)

        slugs = {d.name for d, _ in found}
        self.assertIn("smoke-bias", slugs)
        self.assertIn("por-vth", slugs)

        mc_slugs = {d.name for d, mc in found if mc}
        self.assertEqual(
            mc_slugs,
            {"por-threshold-mc", "temp-accuracy-mc",
             "por-threshold-mc-defect", "temp-accuracy-mc-defect"},
        )

        # testbench-postlayout/ re-runs are deliberately out of scope (module
        # docstring) -- discover() only walks testbench/, so no slug here
        # should ever resolve to a postlayout manifest.
        for directory, _ in found:
            self.assertTrue((directory / "testbench" / "tb.json").is_file())

    def test_list_mode_exits_zero_and_names_every_experiment(self):
        proc = subprocess.run(
            [sys.executable, str(SIM_DIR / "characterize.py"), "--list"],
            cwd=REPO_ROOT, capture_output=True, text=True,
        )
        self.assertEqual(proc.returncode, cliutil.EXIT_OK, proc.stdout + proc.stderr)
        for directory, _ in characterize.experiments():
            self.assertIn(directory.name, proc.stdout)

    def test_only_restricts_to_the_named_slug(self):
        proc = subprocess.run(
            [sys.executable, str(SIM_DIR / "characterize.py"), "--list", "--only", "smoke-bias"],
            cwd=REPO_ROOT, capture_output=True, text=True,
        )
        self.assertEqual(proc.returncode, cliutil.EXIT_OK, proc.stdout + proc.stderr)
        self.assertIn("smoke-bias", proc.stdout)
        self.assertNotIn("por-vth", proc.stdout)

    def test_unknown_only_slug_is_an_environment_error(self):
        proc = subprocess.run(
            [sys.executable, str(SIM_DIR / "characterize.py"), "--list", "--only", "not-a-real-experiment"],
            cwd=REPO_ROOT, capture_output=True, text=True,
        )
        self.assertEqual(proc.returncode, cliutil.EXIT_ENVIRONMENT, proc.stdout + proc.stderr)


class ExitAggregationTests(unittest.TestCase):
    """Child return codes are mocked; no ngspice or PDK is involved."""

    def _run(self, codes):
        exps = [(Path(f"/nonexistent/exp{i}"), False) for i in range(len(codes))]
        it = iter(codes)
        out, err = io.StringIO(), io.StringIO()
        with mock.patch.object(characterize, "experiments", return_value=exps), \
             mock.patch.object(characterize.subprocess, "run",
                               side_effect=lambda *a, **k: SimpleNamespace(returncode=next(it))) as run, \
             mock.patch.object(characterize.time, "monotonic", return_value=0.0), \
             contextlib.redirect_stdout(out), contextlib.redirect_stderr(err):
            rc = characterize.main([])
        self.assertEqual(run.call_count, len(codes))
        return rc, out.getvalue(), err.getvalue()

    def test_sole_signal_fails(self):
        rc, out, err = self._run([-9])
        self.assertEqual(rc, cliutil.EXIT_SIM_ERROR)
        self.assertNotIn("all experiments passed", out)
        self.assertIn("FAILED", err)
        self.assertIn("SIGNAL 9", out)
        self.assertIn("killed by signal 9", out)

    def test_mixed_order_fails(self):
        for codes in ([0, -9], [-9, 0], [0, -11, 0]):
            with self.subTest(codes=codes):
                rc, out, _ = self._run(codes)
                self.assertEqual(rc, cliutil.EXIT_SIM_ERROR)
                self.assertNotIn("all experiments passed", out)

    def test_positive_codes_keep_max_semantics(self):
        self.assertEqual(self._run([1, 0])[0], 1)
        self.assertEqual(self._run([1, 3, 2])[0], 3)
        self.assertEqual(self._run([1, -9])[0], cliutil.EXIT_SIM_ERROR)
        self.assertEqual(self._run([-9, 3])[0], 3)

    def test_all_zero_passes(self):
        rc, out, err = self._run([0, 0])
        self.assertEqual(rc, cliutil.EXIT_OK)
        self.assertIn("all experiments passed", out)
        self.assertNotIn("FAILED", err)


if __name__ == "__main__":
    unittest.main()
