2AMLogic/gf180-temp-por/(commit log)

2026-07-29 Scaffold canary block: Temperature sensor + power-on-reset pair on gf180mcu
    Selected by the scored block matrix (marketing repo strategy/).
    Draft spec pending engineering ratification.
2026-07-31 Add decision records: supply flavor, temp interface, POR pulse, reset polarity (#20)
    Four proposed (unratified) decision records under spec/decision-records/,
    one per open scope question blocking #8 and #12:
    - DR-001: pins the 3.3 V gf180mcu flavor, with the 2.73 V worst-high
    threshold vs. 2.97 V worst-low-rail margin arithmetic, the rejected 5 V
    alternative, and explicit ±10 % (2.97-3.63 V) steady-state accuracy bounds
    for #13's supply sweep.
    - DR-002: commits wave-1 to analog-only, both PTAT/CTAT pads, with accuracy
    measured at pin voltage (not post-conversion code); SAR pairing stays
    stretch.
    - DR-003: fixed >=1 ms reset pulse for wave 1 (programmable stays stretch),
    with th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
2026-07-31 docs: add temp-sensor + POR architecture survey decision record (#21)
    Recommends a ΔVBE/VBE PTAT-CTAT core (plain, single-point trim) for
    the temp sensor and a bandgap-referenced comparator with hysteresis,
    gated by a native/subthreshold startup-assist leg, for POR. Argues
    one shared bias core plus a 6-step startup ordering that resolves the
    POR chicken-and-egg constraint (#11), and settles/scopes the
    consumer decision points for #8-#12.
    Filed as spec/decision-records/DR-005-... — DR-001..004 are already
    claimed by #7's open PR (#20) at authoring time.
2026-07-31 feat: add gf180mcu PVT corner runner with append-only Markdown evidence records (#23)
    * feat: add gf180mcu PVT corner runner and append-only evidence records
    Ports the sim harness from the gf180-bandgap sister repo (their issue #2 /
    PR #23) as CLAUDE.md mandates, rather than inventing one.
    - sim/harness/ — corner definitions, PDK discovery, deck composition,
    ngspice execution, and the Markdown record writer. pdk.py, runner.py,
    report.py and cli.py are near-verbatim ports.
    - sim/run_corners.py — stdlib python3 CLI (no venv): --check-env, --list,
    --print-env, per-axis overrides, --subset-reason, --supersedes.
    - sim/env.sh, sim/pdk.json, sim/selftest.sh, sim/tests/ — PDK env expor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
    [run_corners.py, test_harness.py]
2026-07-31 Add Apache-2.0 LICENSE and rewrite README for public audience (#26)
    Pre-publication prep for the open-PDK canary go-public decision
    (coordination: 2amlogic/marketing#22). Adds a standard, unmodified
    Apache License 2.0. Rewrites README.md for a public audience: drops
    the internal "PRIVATE" banner and the headline spec-value table
    (engineering detail lives in spec/decision-records/, unaffected by
    this change), states the honest early-stage status, and states the
    agent-native build process as a feature rather than a hedge, with a
    link to klayout-tools.
    Full git-history and issues/PRs audit findings are reported as a
    comment on #25, not as a diff here (audit is read-only investigation).
    Part o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
2026-07-31 feat: add gf180mcu vertical-PNP, resistor, and MOS characterization decks (#22)
    Adds parameterized ngspice decks (pnp_vbe.spice, res_tc.spice,
    mos_vt_sub.spice) plus a Python runner that sweeps corner x temperature
    (x device/polarity for MOS) via plain token substitution, and appends
    results as CSV evidence under sim/devchar/results/ with raw per-run
    ngspice logs preserved. SUMMARY.md ties the recorded physics sanity
    anchors (VBE range, dVBE/dT, delta-VBE vs. Vt*ln(N), corner-spread
    direction) to concrete device recommendations for the sensing core, POR
    divider, comparator input pair, and low-Iq bias branches, and documents a
    PDK model finding (PNP par= only scales mismatch, not nominal area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
    [mos_vt_sub.csv, pnp_vbe.csv, res_tc.csv]
2026-07-31 feat: add xschem block hierarchy and deterministic ngspice netlist export (#29)
    * feat: add xschem block hierarchy and deterministic ngspice netlist export
    Enter the temperature-sensor + POR block in xschem under design/: a
    top-level cell carrying the ratified pad interface (VDD/VSS, PTAT, CTAT,
    RESETn) and four sub-circuit cells matching the design sub-issues 1:1
    (bias_core, temp_core, por_comparator, por_output_chain), each with its
    own symbol so a testbench can instantiate one half of the block on its
    own.
    Sub-circuit internals are placeholders -- correct ports, 1 Tohm output
    terminations so the stubs are ERC-clean and DC-solvable, and a comment
    block that reaches the netlist saying so.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
    [bias_core.sch, por_comparator.sch, por_output_chain.sch, temp_core.sch, temp_por_top.sch]
2026-07-31 ci: add GitHub Actions workflow for headless + PDK-dependent self-checks (#31)
    Adds .github/workflows/ci.yml with two jobs: `checks` runs the harness
    unit tests via sim/selftest.sh on every push/PR without needing the PDK
    or xschem (the sim-smoke stage auto-skips when the PDK is absent);
    `pdk-checks` installs xschem/ngspice/gf180mcu and runs
    design/netlist.py --check plus the full end-to-end PVT smoke, gated to
    a nightly schedule and manual dispatch so no PR blocks on a PDK
    download. Wires package.json's placeholder test/check:ci scripts to
    the real commands and drops the check:all/lint placeholders that have
    no real equivalent in this repo.
2026-07-31 fix: verify appended CSV row count in run_devchar.py's CsvWriter (#34)
    CsvWriter now tracks how many rows it wrote and, on close(), re-reads
    the CSV from disk and raises CsvWriteVerificationError if the on-disk
    row count doesn't match what was actually appended. All three device
    decks (PNP, resistor, MOS) share this writer, so the guard applies
    uniformly rather than being scoped to the PNP path where the
    discrepancy was originally observed. The runner no longer prints a
    success line until the corresponding CsvWriter.close() has verified
    its append.
    Adds sim/tests/test_run_devchar.py covering lost-write and
    concurrent-writer row-count mismatches for the PNP, resistor, and MOS
    field sets, plu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
    [test_run_devchar.py]
2026-07-31 feat: design the PTAT/CTAT sensing core with a current-referenced startup detector (#35)
    * feat: design the PTAT/CTAT sensing core with a current-referenced startup detector
    Fills design/temp_core.sch, until now a ports-only placeholder, with the
    DVBE/VBE bandgap-style core DR-005 selected: an 8:1 pnp_10p00x10p00 emitter-area
    pair (eight parallel unit cells, not par=8 -- sim/devchar/SUMMARY.md records that
    par= scales only the model's mismatch term), a PMOS-input error amplifier that
    forces the ratio pair to equal emitter voltages, a cascoded 1:1:1 PMOS mirror,
    and a same-flavour ppolyf_u R2/R1 gain ratio so absolute value and tempco cancel.
    Startup is a current-referenced dead-loop detect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
    [temp_core.sch]
2026-08-01 feat: design the POR threshold comparator with resistor-ratio hysteresis (#37)
    * feat: replace por_comparator's placeholder with a ratio-hysteresis comparator
    Draw the real internals of design/por_comparator.sch: a three-segment
    ppolyf_u_3k divider off VDD compared against VREF by an NMOS-input 5T OTA,
    with hysteresis produced by feeding POR_RAW back into the DIVIDER RATIO
    (MHSW shorts the RHYS segment out while POR_RAW is low) rather than by
    injecting a bias-referenced current into the sense node.
    Both thresholds and their difference then reduce to VREF times a ratio of
    same-flavour, same-width resistors:
    VPOR^ = VREF*(RTOP+RBOT)/RBOT
    VPORv = VREF*(RTOP+RBOT+RHYS)/(RBOT+RHYS)
    V_hys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
    [por_comparator.sch]
2026-08-01 feat: design the POR output chain with a nA-starved deglitch, one-shot and push-pull driver (#38)
    * feat: draw the POR output chain deglitch, one-shot and push-pull driver
    Replaces the ports-only por_output_chain placeholder (#29) with real
    internals: a current-starved deglitch filter, a nA-charged one-shot that
    stretches the reset pulse past 1 ms, and a push-pull output stage whose
    below-floor startup-assist pull-down holds RESETn low from 0 V without
    being gated by POR_RAW.
    Three blocks, per DR-004/DR-005:
    - Deglitch: 50 nA tails driving a 242 fF MIM, then two ratio-skewed
    restoring inverters. The skew fixes each node's dead-circuit leakage
    default so the chain settles into the rese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
    [por_output_chain.sch]
2026-08-01 spec: correct por-reset-pulse and por-reset-valid-floor binding corners (#40)
    * spec: correct por-reset-pulse and por-reset-valid-floor binding corners (DR-009)
    The ratified table predicted binding corners for a generic fixed-trip
    one-shot; the implemented one-shot trips at VDD - V_sg(2.5 nA), which
    is rail-referenced, so the measured fastest-timer corner is
    FF/-40C/2.97V, not FF/+125C/3.63V. The reset-valid floor's ratio and
    absolute-mV sub-quantities also bind at different corners (SF/+125C
    and SS/-40C respectively) rather than the single FF/+125C the row
    stated. Values are unchanged; only the binding-corner text is
    corrected, backed by the two cited sim/ records.
    * spec: mark DR-009 pro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
2026-08-01 feat: design the shared bias/reference core with a current-referenced startup kick (#42)
    * feat: design the shared bias/reference core with a current-referenced startup kick
    Replace bias_core's ports-only placeholder with a three-leg bandgap core:
    an 8:1 vertical-PNP DVBE pair setting I = DVBE/R1, a matched third leg
    dropping that current on R2 into a ninth PNP for VREF = VEB + (R2/R1)*DVBE,
    a PMOS-input two-stage Miller-compensated amplifier, a 20:1 IBIAS output
    leg, a current-referenced dead-loop startup kick, and a settle detector
    driving BIAS_OK off a 5 % tap on R1.
    Only the four core mirror legs hang off the amplifier's output node; every
    wide-gate current source is gated from a secon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
    [bias_core.sch]
2026-08-01 fix: remove temp_core's IBIAS clamp so the shared bias node survives reset (#45)
    temp_core's disabled state clamped the shared IBIAS pin to VSS through an
    ENB-gated XMDIB. EN is RESETn, so the clamp was engaged for the whole pre-POR
    window: por_comparator's tail mirror starved, POR_RAW could not go high,
    RESETn never released, and temp_core was therefore never enabled to lift its
    own clamp. A closed bias-vs-POR lockup, measured at 1.0-6.6 mV on the shared
    node across all 81 PVT points.
    Delete the clamp, and ratify the contract behind it in DR-010: a consumer of
    the shared IBIAS net presents high impedance to it whenever it is disabled --
    it may gate its own internal fan-out off the node, ne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
    [temp_core.sch]
2026-08-01 evidence: bias_core quasi-static branch-tracking sweep finds BIAS_OK failure at all 27 corner/temperature combinations (issue #43) (#47)
    Builds sim/bias-core-startup/, a fresh port of PR #44's superseded
    branch-tracking DC-sweep methodology onto the schematic actually on main
    (the 50-device, three-leg PNP-clamped-input cell from #42). The sweep runs
    at 20 mV steps rather than #44's 2 mV, and needs gmin=1e-9 (vs. ngspice's
    1e-12 default) to converge through the circuit's own low-voltage turn-on
    region -- both documented as compute-budget concessions in
    sim/bias-core-startup/testbench/stimulus.spice.
    The branch-selection defect issue #43 describes reproduces against this
    schematic, and is far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
    [build_tb.py]
2026-08-01 sim: measure the assembled-path temp-sensor accuracy/Iq/supply grid (#48)
    * test: add the assembled-path temp-sensor PVT testbench and its trim derivation
    Adds sim/temp-accuracy-vt/, the first temperature-sensor measurement taken on
    the real four-cell assembly (design/netlist/temp_por_top.spice) rather than
    against sim/temp-core-designer-check/'s idealised 500 nA IBIAS source. The
    assembled path only became measurable with #41/DR-010, which removed the
    disabled-state clamp that had kept RESETn from ever releasing.
    The testbench sweeps -40/25/27/125 C x 3 supplies x 9 corners (108 points, the
    mandated 81-point grid plus a 25 C trim-reference plane) and carries a SECOND,
    identical temp_por_t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
    [build_tb.py]
2026-08-01 fix: root-cause the BIAS_OK quasi-static failure to the testbench's gmin aid (#49)
    * test: re-found bias-core-startup on a quasi-static transient ramp instead of a gmin-aided .dc sweep
    The .dc continuation sweep this experiment used could only be made to
    converge by raising gmin from ngspice's default 1e-12 to 1e-9. At 1 nS and
    3.3 V of rail that is ~2.7 nA of parallel current per device junction, and
    the settle comparator under test resolves a ~0.55 nA imbalance between two
    ~7 nA branches. NOKO carries one junction (XMOKC's drain) that its
    reference-side counterpart NOKL does not, so the aid injected ~0.6 nA of
    DIFFERENTIAL error -- larger than the signal, and enough to invert the
    comparat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
2026-08-01 sim: add the full-assembly POR testbench suite and publish por-iq / iq-total (#51)
    * sim: add full-assembly POR testbenches for threshold, ramp rate, brownout and glitch immunity
    Five new experiment directories under sim/, each mapping one ratified POR
    row of spec/target-spec.md onto its own named claim, all against the real
    four-cell assembly (design/netlist/temp_por_top.spice) rather than an
    idealised sub-circuit:
    - por-vth/ quasi-static up/down triangle ramp; VPOR-up, VPOR-down and
    V_hys extracted at the same corner point off POR_RAW
    - por-ramp-rate/ four monotonic 0->VDD ramps (1 V/s, 10 V/s, 0.1 V/us,
    1 V/us) in one transient; single clean relea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
    [build_tb.py]
2026-08-01 sim: give the POR decks the 1 Tohm PTAT/CTAT leak paths the assembly needs (#53)
    Every working full-assembly testbench in this repo (sim/temp-por-top-release/,
    sim/temp-accuracy-vt/) loads the two analogue pads with 1 pF AND a 1 Tohm DC
    leak. The four POR decks added by #51 carried only the capacitor. While RESETn
    is asserted temp_core is disabled and drives its outputs high impedance
    (DR-010's disabled-consumer contract), so PTAT and CTAT become capacitively
    coupled floating nodes and ngspice's truncation-error control collapses the
    timestep trying to track them: measured, the decks without these four lines
    burned >450 s of CPU per PVT point without completing a single one, against
    ~36 s fo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
2026-08-01 sim: close #50's Gap 1 -- re-run bias-core-startup with --supersedes (#54)
    The 27/27 FAIL record 20260801-111049-bc599be had no forward pointer in
    sim/ to the record that corrects it: 20260801-144500-ab081eb (issue #46's
    re-founding on a quasi-static transient) carried Supersedes: (none).
    Records are append-only, so the fix is a fresh, identical re-run that
    properly chains back via --supersedes:
    python3 sim/run_corners.py bias-core-startup -j 8 \
    --supersedes 20260801-111049-bc599be
    New record 20260801-230642-c320628: 81/81 PASS, and every measurement is
    bit-identical to ab081eb's -- this is an evidence-hygiene correction only,
    not a re-measurement. design/bias_core.md now cites th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
2026-08-02 sim: record full-PVT corner-sweep results for the POR testbench suite (#14) (#57)
    1 V/us) in one transient; single clean releas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
2026-08-02 feat: add Monte Carlo mismatch sampling and resolve the five [3σ] spec rows (#58)
    * sim: add a Monte Carlo local-mismatch sampling mode to the harness
    sim/harness/ only enumerated deterministic .lib corner bundles with
    sw_stat_mismatch pinned to 0, so the [3sigma] rows spec/target-spec.md
    section 2 ratifies (process plus local mismatch, MC, N >= 500, at the
    row's own binding corner) had no way to be measured.
    - sim/harness/montecarlo.py: binding-point manifest loading, the
    (binding point x sample) grid with reproducible per-sample seeds,
    MC deck composition (sw_stat_mismatch=1 emitted after the corner .lib
    includes so it wins the duplicate-.param race), the runner, the
    per-sample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
    [build_tb.py, run_mc.py, test_montecarlo.py]
2026-08-02 spec: root-cause por-brownout to a falling-slew limit and file DR-011 (#62)
    * spec: root-cause por-brownout to a falling-slew limit and file DR-011
    sim/por-brownout's 0/81 failure was attributed to the 1.0 V dip target
    sitting below bias_core's DC operating floor. A one-variable-at-a-time
    control at tt/27C/3.30V refutes that and identifies the real discriminator:
    - Depth is not it. A dip to 2.30 V -- above vdd_ref90_v's 1.788 V worst
    case at every corner -- fails identically.
    - Duration is not it. Held below VPOR-down,min for 5 ms (500x T_dip,min)
    at the deck's 1 us edge, RESETn still never asserts during the dip.
    - The rail's FALLING SLEW RATE is it, with a sharp boundary between 7.67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
2026-08-02 layout: bring up the klt DRC/LVS flow, proven clean on one real cell (#63)
    `layout/` was empty. It now carries a repeatable, klayout-tools-driven
    DRC/LVS invocation and the evidence that it works, so the floorplan and
    post-layout verification work inherits a flow instead of rediscovering it.
    - `layout/run_checks.sh` is the invocation and the source of truth: it
    gates on both generated inputs being current, runs `klt drc`, `klt
    extract` and `klt lvs`, and then re-runs LVS against two independently
    corrupted references, requiring both to be reported as mismatches. A
    mis-wired LVS that compares nothing also reports "match", so the clean
    run alone is not evidence -- the controls are w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
2026-08-02 layout: add the block floorplan sketch and matching plan (#65)
    Ranks the temp_core amplifier input pair/load mirror, PTAT gain
    ratio, and PNP array for common-centroid/interdigitated treatment
    per issue #15's MC mismatch attribution, documents the data-driven
    de-prioritization of the POR comparator's input pair and divider
    (100% MC yield despite larger absolute offset), lays out the
    always-on POR domain vs. gated temp-sensor domain guard-ring plan
    (with an explicit note that well/tie correctness is not covered by
    the DRC/LVS flow per klayout-tools#281), and places the five
    ratified pins.
2026-08-02 ci: run layout/tests in the headless checks job (#66)
    The headless `checks` job ran sim/build_tb.py --check and
    sim/selftest.sh (which covers sim/tests via its step 1) but never ran
    layout/tests/test_lvs_reference.py's 16 stdlib-only unittest cases,
    even though package.json's "test" script does. Add a dedicated
    `python3 -m unittest discover -s layout/tests -t layout/tests` step
    to the checks job (the minimal fix from the issue's Implementation
    Guidance), rather than swapping to `npm test`, which would silently
    drop sim/selftest.sh's env-check/smoke-run stage (steps 2/3) from the
    headless job.
    sim/selftest.sh's env-check/smoke-run stage still executes unchanged
    in the headless job (auto-skip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
2026-08-02 sim: characterize the por-brownout falling-slew boundary across 81 corners (#73)
    Runs the DR-011-proposed falling-slew ladder for por-brownout clause (c)
    across the full 81-point PVT grid in a new sim/por-brownout-slew/
    experiment, bisecting toward the binding corner (SS/-40C/2.97V) to bracket
    dVDD/dt|fall,max between a confirmed 81/81 PASS at 3.40 mV/us and a
    confirmed FAIL from 3.4795 mV/us -- a knife-edge, non-monotonic transition
    rather than a single clean threshold, so the ratified bound sits on the
    safe side of the whole band rather than at a bisected midpoint.
    Adds analyze_boundary.py to derive a per-corner boundary bracket + binding
    corner from the eight rung records without hand-tr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
    [build_tb.py]
2026-08-02 layout: draw and DRC/LVS-clean bias_core's 34 MOS devices (#75)
    Adds the first real sub-circuit layout to layout/cells/: all 34 MOS
    devices of design/bias_core.sch, DRC-clean against klt's curated gf180mcu
    deck and LVS-clean (34/34 devices, 26/26 nets, 6/6 pins) against a
    reference derived mechanically from design/netlist/bias_core.spice, with
    both negative controls detected.
    What is deliberately not drawn: bias_core's 10 vertical PNPs, 4 poly
    resistors and 2 MiM caps. The curated extraction deck models nfet/pfet
    only, and drawing a poly resistor body would make the report *worse* --
    the extractor reads it as interconnect and silently shorts its terminal
    nets, which then reads as a layout b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
2026-08-02 layout: draw and DRC/LVS-clean por_comparator's 18 MOS devices (#76)
    Adds the second real sub-circuit layout to layout/cells/: all 18 MOS
    devices of design/por_comparator.sch, DRC-clean against klt's curated
    gf180mcu deck and LVS-clean (18/18 devices, 18/18 nets, 8/8 pins) against
    a reference derived mechanically from design/netlist/por_comparator.spice,
    with both negative controls detected.
    The BIAS_OKB inverter is not re-drawn: the cell instances #16's already
    verified por_comparator_bias_okb_inv. Extraction and DRC both flatten, so
    the instance joins the parent's connectivity graph -- including its labels,
    which is why BIAS_OKB extracts as a pin of por_comparator rather than an
    internal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
2026-08-02 layout: draw and DRC/LVS-clean temp_core (#78)
    Draws temp_core's full MOS network (55 devices: input pair + load mirror
    common-centroid quad, cascoded PMOS mirror interleaved 1-2-3-3-2-1, trim
    ladder, startup detector, bias/enable network) per layout/floorplan.md's
    ranked matching plan, plus two sibling top cells in the same GDS stream
    (temp_core_r2_ladder, temp_core_pnp_array) for the resistor gain ladder
    and vertical-PNP centroid array that the curated gf180mcu extraction deck
    cannot represent as devices -- klt drc checks every top cell in a stream,
    so that geometry is still verified even though it sits outside klt
    extract/klt lvs's --top compare.
    Registers temp_core in build_cells.py/CEL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
2026-08-02 sim: map and root-cause the por-brownout-slew non-monotonic transition band (#74) (#79)
    Three additional full-grid rungs (3.42/3.44/3.46 mV/us) narrow the earliest
    observed grid FAIL down to 3.46 mV/us (ss/-40C/2.97V, previously 3.4795), and
    an event-timing control at the ss/-40C binding family turns
    20260802-120940-3c3e728-boundary.md's phase-relationship hypothesis into a
    measured mechanism: a race between the shrinking dip window and
    por_output_chain's deglitch dwell, which runs far past its documented
    ceiling because the near-boundary edge has not finished falling when
    POR_RAW trips. The race's winner differs slightly by supply, which is the
    non-monotonicity itself. Confirmed not a solve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
2026-08-02 layout: draw and DRC/LVS-clean por_output_chain's 27 MOS devices (#77)
    Adds the second real sub-circuit layout to the klt-driven flow: all 27 MOS
    devices of design/por_output_chain.sch, DRC-clean, LVS-matched 27/27 devices
    / 20/20 nets / 6/6 pins against the schematic-derived reference, with both
    negative controls detected (device-param now classifies as device.property
    at 27 devices, as it does at 34).
    The cell's other 2 devices -- the MiM caps XCDG and XCTIM -- are not drawn:
    the curated gf180mcu deck still models nfet/pfet only at klt 0.1.0 and
    declares one metal level, and drawn unmodelled geometry is absorbed into
    interconnect silently. Unlike bias_core that costs no *net* here (NDG an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
2026-08-02 sim: confirm the intermediate falling-slew spurious POR_RAW assert across the full 81-point grid (#61) (#80)
    sim/por-brownout/control/results.md Part B found, at one PVT point, that
    falling-edge rates slower than DR-011's own dip-latch boundary but faster
    than a very slow control reference assert POR_RAW above VPOR-uparrow,max --
    a spurious reset at a rail still inside the ratified operating range. This
    mints a sim/run_corners.py-produced 81-point record (three parallel dip
    branches reproducing the control's own three Part-B points) that confirms
    the effect is pervasive, not a one-corner curiosity: 56%/91%/19% of the grid
    fails at the control's 7.67/2.30/0.77 mV/us rates respectively -- incl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
    [build_tb.py]
2026-08-02 layout: assemble and DRC/LVS-clean temp_por_top from the four sub-circuits (#81)
    * layout: assemble temp_por_top from the four sub-circuits, DRC/LVS-clean
    Instances bias_core, por_comparator, por_output_chain and temp_core's MOS
    network into one block-level cell with the domain-seam moat, the perimeter
    guard ring, the VDD/VSS rails and the ratified 5-pad pinout. 134 devices,
    78 nets, 6 pins; DRC clean, LVS match, both negative controls detected.
    Every sub-circuit is instanced unmodified -- all four committed GDS files are
    byte-identical -- so the assembly inherits their recorded results rather than
    re-opening them. temp_core is split into _temp_core_mos plus its two sibling
    top cells, beca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
2026-08-02 docs: root-cause por-ramp-rate chatter and por-glitch stuck-low (#56) (#59)
    Two committed control experiments (sim/por-ramp-rate/control/,
    sim/por-glitch/control/) trace the internal release path on the real
    four-cell assembly and settle both open questions from #14's corner sweeps:
    - por-ramp-rate's release-edge chatter is NOT bias_core's starved-loop
    mechanism at smaller scale. bias_core/por_comparator settle cleanly before
    the chatter window opens; TRIP/RSTB chatter in lock-step with RESETn
    entirely inside por_output_chain's own trip detector / release-NAND /
    XMAST loop, is ramp-rate independent (same window a decade apart in rate)
    and temperature-dependent -- a likely-fixable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
2026-08-02 layout: draw por_output_chain's 2 MiM caps as real devices (#96)
    `por_output_chain` reserved 70 x 62 um of floor area on annotation layer
    200/0 for its deglitch and one-shot MiM caps, because the curated `klt`
    gf180mcu deck recognised `nfet`/`pfet` only. `klt 0.1.0` declares
    `cap_mim_2f0_m4m5_noshield`, so draw them.
    - build_cells.py: add the MiM stack layers (Metal4 46/0, FuseTop 75/0,
    CAP_MK 117/5, MIM_L_MK 117/10) and `_mim_cap` / `_mim_block`. Plate
    sizes and the m= multiplier come out of the golden netlist's own
    c_width/c_length, so `XCTIM` draws as a 2x2 array of its own plate and
    `XCDG` as a single one. Spacing and bottom-plate enclosure hold the
    DRM's MIMTM.1/MIMTM.3 minim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
2026-08-02 layout: fold temp_core's PNP array and R2 ladder into the extracted cell (#98)
    Draw the marker-layer geometry the curated gf180mcu extraction deck needs to
    recognise this cell's passives, and put that geometry inside temp_core rather
    than in the two sibling top cells that used to hold it:
    - resistor bodies get SAB (49/0) + RES_MK (110/5) over Pplus'd Poly2, so the
    deck cuts them out of poly connectivity and extracts ppolyf_u devices
    instead of shorting each body's own two terminals;
    - the nine active PNP emitters get per-emitter DRC_BJT (127/5) patches, so
    Nwell & DRC_BJT scopes the base to a real device region -- a marker over
    the whole array turns the shared n+ base ring into a 26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
2026-08-02 layout: draw por_comparator's marker-layer geometry for its 3-segment sense divider (#99)
    Draws XRTOP/XRBOT/XRHYS as real RES_MK/SAB/Resistor(62,0)-marked poly
    resistors (klt's ppolyf_u_1k class) instead of the reserved placeholder
    rectangle from #69, folding each into a zig-zag serpentine whose drawn
    area reconstructs the schematic's own r_length exactly.
    Routes SNS/SNSB across the divider on Metal2 rather than Poly2/Metal1 --
    a same-layer path was shorting both nets to VDD via the supply rails'
    old full-width reach, and separately merging the divider's own leg-gaps
    into the routing tracks, which is why the resistors were extracting as
    "resistor shape ignored" rather than real devices.
    Ad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
2026-08-02 fix: latch por_output_chain's release against the shared-IBIAS step (por-ramp-rate 81/81) (#101)
    * fix: latch por_output_chain's release so the shared IBIAS step cannot walk it back
    RESETn's own release enables temp_core (temp_core's EN pin IS RESETn at the
    top level), adding a mirror diode to the shared IBIAS node and stepping it
    down ~34 mV. por_output_chain's nA starve references follow, which walks its
    trip detector's stage-A balance point back up until TRIP collapses and RESETn
    re-asserts -- disabling temp_core again and restarting the cycle. A relaxation
    oscillation whose loop leaves the cell entirely.
    Adds XMRLK (nfet 1u/1u, ND1 -> VSS, gate RESETn): the counterpart of the
    XMAST kee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
    [por_output_chain.sch]
2026-08-02 layout: draw bias_core's 10 PNPs, 4 poly resistors and 2 MiM caps as real devices (#100)
    `bias_core` reserved a blank 130 x 130 um rectangle on annotation layer 200/0
    for its 16 non-MOS devices, because the curated `klt` gf180mcu deck recognised
    `nfet`/`pfet` only and a drawn-but-unrecognised poly resistor body extracts as
    interconnect that shorts its own two terminal nets. `klt 0.1.0` declares `bjt`,
    `ppolyf_u_1k` and `cap_mim_2f0_m4m5_noshield`, so draw them. The cell is now
    whole: all 50 schematic devices extracted and compared.
    - build_cells.py: add the resistor stack (Pplus 31/0, SAB 49/0, Resistor 62/0,
    RES_MK 110/5) and the bipolar mark (DRC_BJT 127/5), plus `_poly_resistor`,
    `_p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
2026-08-02 layout: guard layout/reports/ against silent klt deck-hash drift (#104)
    * layout: guard layout/reports/ against silent klt deck-hash drift (#103)
    por_comparator's committed DRC report claims clean while a current klt
    build finds 2x poly2.enclosing.contact.1 -- root-caused to an
    enclosing/enclosed check false negative on zero-overlap escapes,
    already filed generically and fixed upstream
    (klayout-tools#318/PR #327), not a rule tightening or a new false
    positive. The actual layout fix is #102's, already in flight; this
    adds lvs_reference.check_deck_hash_consistency() (wired into
    run_checks.sh as an unscoped gate, tolerant of temp_por_top while
    frozen behind #97) so committed reports disagreein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
2026-08-02 fix: enclose por_comparator's SNS/SNSB escape contacts, and pin frozen cells instead of aborting the staleness gate (#105)
    Two independent fixes to the layout verification flow, both for problems that
    reproduced on `main` with no new geometry.
    **1. por_comparator's committed report claimed clean over a dirty stream.**
    The `SNS`/`SNSB` Metal2-escape landing contacts sit at `div_trunk_x0`, and both
    nets' Poly2 routing tracks *ended* on that same x -- so the Poly2 covered only
    each contact's west half and left the east half bare: two
    `poly2.enclosing.contact.1` (DRM `CO.3`) violations in the committed GDS, under
    a committed `drc.json` recording `status: clean, violation_count: 0`. Both
    tracks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
2026-08-03 layout: tie DRC/extract reports to the GDS stream they describe (#109)
    * layout: tie DRC/extract reports to the GDS stream they describe
    layout/run_checks.sh now splices sha256(gds) into drc.json's and
    extract.json's provenance.gds_sha256 right after klt drc/klt extract
    write them, mirroring lvs.json's existing environment.layout_sha256.
    lvs_reference.py gains check_gds_hash() / --check-gds-hash, wired into
    run_checks.sh's gate sequence, to recompute each committed cell's .gds
    digest and fail loudly if it disagrees with the digest recorded in
    that cell's drc.json/extract.json/lvs.json -- unlike the deck-hash
    gate, this one is not tolerant of frozen cells, since a freeze pins
    the GDS itself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
2026-08-04 docs: correct README status for drawn, LVS-clean sub-cells (#116)
    The four sub-circuits (bias_core, por_comparator, por_output_chain,
    temp_core) now carry real drawn/extracted/LVS-matched device geometry,
    so the 'proven clean on one real cell' and 'sub-circuits are still
    placeholders' claims are both stale. Restate the status section against
    layout/README.md's status block, keep the temp_core MiM cap caveat, and
    keep temp_por_top's top-level reassembly explicitly outstanding.
2026-08-07 fix: restore four missing Loom hooks in .claude/settings.json (#120)
    Commit 2b69d98 ("Upgrade Loom to 0.16.0") deleted the entire `hooks`
    key from .claude/settings.json without restoring any entries. A
    same-day commit (70403f0, "Install Repo Skills v0.7.0") re-added a
    `hooks` key but only wired the Repo Skills guard-destructive.sh
    (PreToolUse) and session-start-handoff.sh (SessionStart), leaving four
    hooks from the original Loom install (215e4f0) silently unwired since
    2026-07-29:
    - .loom/hooks/guard-loom-workflow.sh (PreToolUse, Bash) — now runs
    alongside the canonical Repo Skills guard-destructive.sh rather than
    replacing it.
    - .loom/hooks/skill-router.sh (UserPromptSubmit)
    - .loom/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
2026-08-08 fix: analyze_boundary.py's stale record filter excluded only -boundary, not -transition-band (#127)
    analyze_boundary.py filtered records/*.md with a single-suffix check
    (`not p.stem.endswith("-boundary")`), which didn't exclude the newer
    -transition-band derived-record kind introduced by analyze_transition_band.py
    (#74). Running analyze_boundary.py against the current records/ dir crashed
    trying to parse a -transition-band record as an 81-point ladder rung.
    Move the exclusion list to a shared DERIVED_SUFFIXES tuple and
    is_source_record() predicate in _rung_record.py (the same module that
    already centralizes rung-record parsing per #121/#123), and have both
    analyze_boundary.py and analyze_tr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
2026-08-08 fix: derive analyze_boundary.py's non-monotonic-zone narrative from data (#128)
    The "Non-monotonic transition zone" paragraph in analyze_boundary.py
    hardcoded specific mV/us values (3.40, 3.4795, 3.613) and a "SS/-40C
    family" description as literal prose, so it went stale as soon as new
    rungs shifted the ratified bound -- it kept citing "81/81 PASS at
    3.40 mV/us" after the ratified bound moved to 3.44 mV/us.
    Derive the band extent and family description from the same rows/
    corner-ids data the rest of the record already computes, and split the
    paragraph into derived facts (band bracket, ratified-bound callback)
    and clearly-labeled hand-maintained interpretive commentary (the
    DR-011 mechanism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
2026-08-08 refactor: dedupe sha256/git_describe/measurement-parsing helpers into sim/harness (#130)
    sha256(path), the ngspice m_<name>=<value> measurement-line parser, and a
    "HEAD + is-the-tree-dirty" git_describe() were each independently
    reimplemented across several sim/*/control/ and analysis scripts. Add
    sha256_file() and a parameterized git_describe(repo_root, generated) to
    sim/harness/runner.py (parse_measurements already existed there), and
    switch the following over to import the shared versions instead of
    carrying their own copies:
    - sha256 + git_describe: run_chatter_probe.py, run_glitch_probe.py,
    run_depth_sweep.py, run_gmin_control.py, run_mismatch_switch.py
    - sha256 only: run_dip_rootcau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
2026-08-09 refactor: dedupe wrdata parse_trace() into sim/harness's parse_wrdata_trace() (#134)
    The three por-glitch/por-ramp-rate control scripts each defined an
    identical parse_trace() for ngspice's wrdata output, differing only in
    the hardcoded probe count. Move it to sim/harness/runner.py as
    parse_wrdata_trace(text, n_probes), parameterized on n_probes instead,
    next to the existing parse_measurements(). Add unit coverage in
    sim/tests/test_harness.py.
    [test_harness.py]
2026-08-09 refactor: dedupe _fmt/_has_manifest/_resolve_tb_path into sim/harness/cliutil.py (#136)
    _fmt, _has_manifest and _resolve_tb_path were independently copy-pasted
    across sim/run_mc.py, sim/harness/cli.py, sim/harness/report.py and
    sim/harness/mc_report.py. Add sim/harness/cliutil.py as their one shared
    home:
    - fmt() is the mc_report.py bool-handling superset (None -> "n/a",
    bool -> "yes"/"no", float -> scientific/fixed by magnitude); all four
    call sites now alias `_fmt = cliutil.fmt` so existing `_fmt(...)` call
    sites are unchanged.
    - has_manifest()/resolve_tb_path() take over path resolution for
    run_mc.py and harness/cli.py. resolve_tb_path() keeps harness/cli.py's
    richer FileNotFou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
    [run_mc.py]
2026-08-09 fix: count marker-less fallback comments and tool-enforce marker append (#146)
    judge-fallback-guard.sh's MARKER_COUNT only ever matched the exact
    <!-- loom:fallback-evaluated sha=... --> marker, so a comment that skipped
    it (free-form paraphrase instead of reproducing the heredoc verbatim) was
    invisible to the lifetime cap and velocity alert. On PR #118, ~44 of ~45
    fallback-mode comments over ~54h omitted the marker, leaving MARKER_COUNT=1
    despite the volume.
    - judge-fallback-guard.sh: also count a comment as a fallback evaluation if
    its body contains the case-insensitive phrase "evaluated in fallback
    mode" even without the exact marker (immediate backstop on the read
    side); such comm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
2026-08-09 chore: remove ruff-flagged dead imports/locals across 5 files (#157)
    Drops 7 unused imports and local variables found via
    `ruff check . --select F401,F841,F811`: two unused imports and one
    unused local in sim/harness/mc_report.py, an unused exception binding
    in sim/run_mc.py, an unused test-scoped import in
    sim/tests/test_montecarlo.py, an unused `field` import in
    sim/devchar/run_devchar.py, and an unused local in
    layout/tests/test_lvs_reference.py (kept the call for its
    GDS-writing side effect). Zero behavior change; ruff now reports zero
    hits for these rules.
    [run_mc.py, test_montecarlo.py]
2026-08-09 test: extract fake_pdk() fixture into sim/tests/testutil.py (#163)
    test_harness.py and test_montecarlo.py each defined a byte-identical
    fake_pdk() helper. Move the single definition to a new testutil.py
    module and import it from both call sites, matching the existing
    SIM_DIR sys.path convention.
    [test_harness.py, test_montecarlo.py, testutil.py]
2026-08-09 refactor(sim): dedupe corner-id parsing into harness.parse_corner_id() (#166)
    `sim/harness/corners.py` already owns the forward direction of the
    ratified `<process>_<temp>c_<supply>v` corner-id naming
    (`PvtPoint.corner_id`, documented in `sim/README.md`). The reverse
    direction was hand-rolled twice: `sim/temp-accuracy-vt/analyze_derived.py`
    and `sim/por-iq/analyze_por_iq.py` each carried a byte-identical private
    `_CORNER_ID_RE` plus its own match-and-unpack.
    Add `corners.parse_corner_id()` -- the same regex verbatim, wrapped so it
    returns `(process, temp_c, supply)` or `None` for a name in some other
    shape -- and route both analysis scripts through it. The supply is still
    handed back as the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
    [test_harness.py]
2026-08-09 refactor(sim): dedupe KEEPER_HEAD netlist line-removal into runner.remove_netlist_device() (#171)
    sim/por-ramp-rate/control/run_chatter_probe.py and
    sim/por-glitch/control/run_depth_sweep.py each carried a byte-identical
    find-the-one-KEEPER_HEAD-line-plus-its-'+'-continuations-and-delete-it
    block in their arm_netlist() functions. Both call sites now delegate to
    a new sim/harness/runner.remove_netlist_device(text, head, source)
    helper (matching the existing deck_preamble()/parse_wrdata_trace()/
    sha256_file() dedup convention), which raises the same "expected
    exactly one '...' line in ..., found N" SystemExit on a bad match
    count. KEEPER_HEAD stays defined locally in each script.
    Verified byt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
    [test_harness.py]
2026-08-09 refactor(layout): dedupe riser() closure into _make_riser() factory (#174)
    bias_core(), por_output_chain(), and por_comparator() each defined an
    identical nested riser(x_centre, net, y_low, y_high) closure. Replace
    all three with a shared module-level _make_riser(b, vdd_y1, vss_y0,
    track_y) factory that returns the same closure, bound to each cell's
    own supply-rail y-coordinates and Poly2 track map.
    Verified byte-identical GDS output (matching sha256 for all three
    cells) and identical DRC/LVS pass/fail pattern vs main before/after
    the change, plus a full layout/tests/ pass (136 tests).
    Closes #172
2026-08-11 layout: build and smoke-verify a post-layout netlist per extracted cell (#82) (#180)
    `klt extract --parasitics` now recovers every non-MOS device this block
    draws, and `klt lvs` now reports the net correspondence it matched on
    (klayout-tools#311, landed in klt 0.2.0). Both are things #82's original
    plan had to work around; neither is a workaround any more.
    So this takes the direct route the issue's requeue comment asked for.
    `layout/postlayout.py` runs `klt extract --parasitics` + `klt lvs` per
    cell and translates the result into `layout/postlayout/<cell>.spice`: the
    drawn devices as PDK subcircuit calls at their drawn dimensions, the
    drawn topology, first-order interconnect R/C, and the sc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
2026-08-11 sim: re-run POR output-chain suite against the post-layout por_output_chain netlist (#183)
    * sim: add extracted-netlist testbench provenance and por_output_chain post-layout fragments
    sim/harness/testbench.py + report.py gain a "netlist_provenance"
    manifest field ("schematic"/"extracted") and a "netlist_provenance_note"
    caveat, rendered into records/<id>.md's "Netlist provenance" line instead
    of the previously hardcoded "schematic (.../testbench/...)" string --
    needed so a post-layout re-run can honestly say "extracted" and carry
    the layout/postlayout/AUDIT.md caveat sim/README.md requires, without
    touching any existing schematic-provenance record's rendering.
    sim/build_tb.py grows a POSTL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
2026-08-11 sim: record post-layout re-runs of the bias_core testbench suite (#84) (#186)
    Re-runs the three bias_core-domain testbenches (bias-core-designer-check,
    bias-core-startup, bias-core-ibias-sharing) against the klt-extracted
    netlists layout/postlayout/{bias_core,temp_core,por_comparator}.spice
    (#82/PR #180) instead of the schematic exports, and records the results as
    three new append-only 81-point-PVT records carrying
    `Netlist provenance: extracted`.
    Uses the POSTLAYOUT_FRAGMENTS mechanism #86 (PR #183) already landed on
    main rather than a parallel one: each experiment gets a POSTLAYOUT_FRAGMENTS
    entry in sim/build_tb.py, whose fragment is built from
    layout/postlayout/<cell>.spice into a sibli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
2026-08-11 fix: derive default sim -j/--jobs from available cores instead of a fixed 8 (#190)
    sim/harness/cli.py and sim/run_mc.py each independently defaulted
    -j/--jobs to min(8, os.cpu_count() or 2). On an 8-core host that pins
    every unqualified run_corners.py/run_mc.py invocation to 8 concurrent
    ngspice processes; three agents each following the documented -j 8
    recipe put 24 requested jobs on 8 cores, driving load-per-core well
    past the daemon's 2.50 self-protection threshold and halting fleet
    dispatch for every repo the host manages.
    Add cliutil.default_jobs(): half the host's logical cores (floor,
    minimum 1), used by both call sites. This leaves headroom for a
    single process instead of claiming e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
    [run_mc.py, test_harness.py]
2026-08-11 sim: post-layout re-run of the POR comparator + threshold testbench suite (#85) (#192)
    * sim: add por_comparator/threshold-domain post-layout fragments (#85)
    Extends #86's testbench-postlayout/ convention (build_tb.py's
    POSTLAYOUT_FRAGMENTS map + the harness's existing netlist_provenance
    field, both already merged via #183/#186) to the three testbenches
    issue #85 covers: sim/por-comparator-designer-check, sim/por-threshold-mc,
    sim/por-vth. Each gets a testbench-postlayout/tb.json (netlist_provenance:
    extracted, carrying the layout/postlayout/AUDIT.md caveat) plus its
    generated fragment inlining layout/postlayout/por_comparator.spice or
    layout/postlayout/temp_por_top.spice in place of the sc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
    [build_tb.py]
2026-08-11 sim: fix render_mc_record()'s hardcoded schematic provenance (#194) (#195)
    sim/harness/mc_report.py's render_mc_record() built its Netlist provenance
    sentence as a literal "schematic (...)" around the module-level
    TESTBENCH_DIR = "testbench" constant, and used the same constant for both
    Links -> Testbench paths. It was never updated for #86's
    testbench-postlayout/ convention, unlike its deterministic-grid sibling
    report.py's render_record(), which reads directory / netlist_provenance /
    netlist_provenance_note off the testbench manifest.
    Consequence: any Monte Carlo run against a testbench-postlayout/ directory
    wrote a record that called its own extracted netlist schematic, dropped the
    manif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
    [test_montecarlo.py]
2026-08-11 fix: refuse to write a sim record when every PVT point failed (#197)
    sim/run_corners.py wrote a full evidence record -- records/, the netlist
    snapshot, and per-corner logs -- even when every point in the run died
    (e.g. --timeout too short for the deck), and would happily record that
    against --supersedes over a passing record. Add report.total_failure()
    and refuse the write in that case (cleaning up the corner logs run_grid
    already wrote), exiting EXIT_ENVIRONMENT instead of EXIT_SIM_ERROR, the
    same treatment the existing --subset-reason gate gives an unjustified
    PVT subset. A mixed result (some points ok, some not) is unaffected.
    [test_harness.py]
2026-08-11 sim: post-layout re-run of the temp-sensing testbench suite (#83) (#198)
    * sim: post-layout testbench siblings for the four temp-sensing experiments
    Adds the #83 half of the #86/#84 post-layout mechanism: four
    POSTLAYOUT_FRAGMENTS entries and their hand-authored
    testbench-postlayout/tb.json manifests, so temp-core-designer-check,
    temp-core-startup, temp-accuracy-vt and temp-accuracy-mc can be re-run
    against layout/postlayout/<cell>.spice instead of design/netlist/<cell>.spice.
    temp_core for the three cell-level experiments, temp_por_top (the whole
    four-cell assembly) for temp-accuracy-vt.
    Nothing under testbench/ moves. Each post-layout manifest is its schematic
    sibling's, with 'netlist' n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
2026-08-11 sim: post-layout re-run of the full-assembly POR dynamic-behaviour suite (#87) (#196)
    * sim: add post-layout testbench manifests for the full-assembly POR suite
    Six testbench-postlayout/ directories -- por-ramp-rate, por-brownout,
    por-brownout-slew, por-brownout-spurious, por-glitch and
    temp-por-top-release -- each pointing at layout/postlayout/temp_por_top.spice
    (#82/PR #180's direct klt extraction of the whole four-cell assembly) instead
    of the schematic export, using the extracted-provenance mechanism #86
    introduced.
    Every manifest is a byte-for-byte copy of its schematic sibling apart from
    `netlist`, `netlist_provenance`, `netlist_provenance_note` and the appended
    claim/description tex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
    [build_tb.py]
2026-08-11 design(por_output_chain): root-cause the post-layout deglitch asymmetry to tail-node charge sharing, and measure why CDG cannot grow (#201)
    * design(por_output_chain): root-cause the post-layout deglitch-dwell asymmetry to tail-node charge sharing
    Three control experiments under sim/por-output-chain-deglitch/control/
    diagnose the schematic-vs-extracted deglitch delta recorded by #86, and
    they refute the standing hypothesis:
    - run_deglitch_asym_probe.py decomposes each POR_RAW edge's dwell into
    (V_trip - V0)/slope and ablates the extraction's three deglitch-node
    capacitances one group at a time. XMG1's trip point moves under 1 % on
    either edge -- it cannot move, since the extraction's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
2026-08-11 spec: re-cost por-iq to <3.0 uA against the measured apportionment overrun (DR-018) (#203)
    por-iq has missed its <1 uA ceiling at 54/81 corners on the assembled
    block at both the schematic and post-layout netlist levels, tracking
    design/bias_core.md's already-owned 2.37x apportionment overrun. Adds
    DR-018, re-costing the target to <3.0 uA (20.5% margin over the measured
    2.385 uA worst case, matching the margin convention already used for
    temp-iq), and updates target-spec.md and design/bias_core.md to reflect
    it. iq-total's <21 uA ceiling and its 13% measured margin are unaffected
    (no circuit changed), but its "por-iq + temp-iq" formula is retired since
    the two sub-ceilings no longer sum to i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
2026-08-11 refactor(layout): dedupe por_comparator's inline tile placement/draw onto shared helpers (#204)
    por_comparator() reimplemented _place_tiles()/_tile_x1()/_draw_tiles()
    inline instead of calling them like bias_core() and por_output_chain()
    already do. Switch it to the shared helpers, dropping the redundant
    per-tile "pmos" key in favor of the group index _place_tiles() already
    provides.
    Verified behavior-preserving: the rebuilt por_comparator.gds is
    byte-identical to the committed one (sha256 45b4b149...), and
    layout/run_checks.sh reports DRC clean / LVS match / all negative
    controls detected for every cell.
    Closes #202
2026-08-11 sim(por-output-chain-deglitch): promote the glitch-rejection width margin from a control onto the 81-point PVT grid (#205)
    * sim(por-output-chain-deglitch): measure the glitch-rejection width margin on the PVT grid
    The grid checked the deglitch filter's lower bound at exactly one stimulus
    width -- three 1 us glitches, asserted through pgdg_min_during_chatter >=
    2.5 V. That answers "is 1 us rejected?" and nothing about by how much, which
    stopped being academic post-layout: the same measurement's grid minimum fell
    from 2.94 V to 2.54 V against that unchanged 2.5 V bound. The margin itself
    was only ever measured in control/width_results.md, which by sim/README.md's
    own rules runs at two corner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
2026-08-11 docs: close out the post-layout re-run with a roll-up that states what it does and does not establish (#212)
    * design(temp_por_top): add the issue #18 closing roll-up for the post-layout re-run
    Ties together all six re-run children (#82-#87) into one summary that
    names the required watch-item findings explicitly instead of letting a
    "suite green" reading round them off: the IR/crosstalk watch item is
    untestable with today's klt extraction model (no DC path, no net-to-net
    capacitor), the ~2% uniform reset-timing lengthening from per-net RC
    loading, #61/DR-013's spurious POR_RAW assert surviving at 33/81 corners
    on its worst branch, and temp_core's undrawn XCC as the one remaining
    schematic-i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
2026-08-11 spec: re-cost por-brownout's falling-slew bound to 2.30 mV/us post-layout (DR-019) (#217)
    * sim(por-brownout-slew): generate the post-layout manifest alongside the schematic one
    gen_rung.py rewrote only testbench/tb.json per rung, while the extracted
    sibling testbench-postlayout/tb.json was hand-authored once (#87). Every rung
    shifts the per-supply measurement windows -- the edge duration that realizes a
    given slew depends on the rung -- so a hand-maintained post-layout copy runs
    the new rung's stimulus against the previous rung's windows.
    Emit both manifests from the same render_manifest() output instead. The only
    differences are the netlist name, the two provenance fields the harness
    req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
2026-08-11 sim(por-iq): re-cost the publishing script to DR-018's <3.0 uA ceiling and mint the post-layout record (#207) (#220)
    analyze_por_iq.py's TARGET_POR_IQ_UA still hardcoded the withdrawn <1 uA
    ceiling DR-018 (PR #203) moved to <3.0 uA, so the next run would have minted
    a record that contradicts the ratified spec at the moment it's written. Moves
    the constant (citing DR-018 inline) and adds sim/tests/test_por_iq_spec_sync.py
    so the constant and spec/target-spec.md's own Target column can't drift apart
    silently again.
    Runs the now-unblocked post-layout re-derivation against #83/PR #198's
    extracted temp-accuracy-vt record (20260811-084152-68c0017), minting
    sim/por-iq/records/20260811-084152-68c00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
    [test_por_iq_spec_sync.py]
2026-08-11 design(por_output_chain): resolve the deglitch floor's two open hand-offs, and route the unresolvable one to #1 (#219)
    por_output_chain's post-layout POR_RAW glitch-rejection floor sits at only
    1.00x the 1 us chatter it is designed against (issue #182). Whether that
    margin is adequate turned on two things owned elsewhere: bias_core's actual
    IBIAS tolerance, and the real-world width of a POR_RAW excursion near
    por_comparator's threshold.
    The IBIAS question resolves favorably from evidence already on record:
    bias_core's own designer-check testbench already measures IBIAS's output
    current (ibias_na) across the full 81-point PVT grid, and post-layout it
    spans 0.594x-2.236x nominal -- comfortabl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
2026-08-11 design(por_comparator): root-cause the full-assembly hysteresis reading to a ramp-rate VREF displacement, and leave the divider alone (#218)
    * design(por_comparator): root-cause the full-assembly hysteresis reading to a ramp-rate VREF displacement, and leave the divider alone
    sim/por-vth/'s post-layout record measures v_hys_mv = 261.092 mV at
    ss_-40c_3.63v, 11.1 mV over the ratified 250 mV ceiling. A new one-corner
    control (sim/por-vth/control/, 15 runs) shows the reading is three quantities,
    not one, and that neither candidate mechanism is the answer.
    The deck traverses vdd_val - 2.0 V in a fixed 4 ms, so its supply axis is
    simultaneously a ramp-rate axis (242.5 / 325 / 407.5 V/s). Swept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
2026-08-11 spec(area): record the measured post-layout footprint and its not-met disposition (#211) (#223)
    spec/target-spec.md#area carried a [TBD-#17] placeholder and a ≤0.05 mm²
    wave-1 planning bound with no measured number behind it, even though #17
    closed the layout months ago. `klt stats` against the committed
    temp_por_top.gds puts the assembled footprint at 1.059 mm² (1 059 196 µm²),
    21.2x the planning bound.
    - layout/run_checks.sh gains a new `klt stats` step (per cell, no PDK deck
    needed) that writes layout/reports/<cell>/stats.json, gated by the same
    provenance.gds_sha256 drift check as drc.json/extract.json
    (lvs_reference.GDS_HASH_FIELDS), so the area number this record ratifies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
2026-08-11 sim: run the bias_core brownout deck past its own starved-loop window (#222)
    * sim: run the bias_core brownout deck past its own starved-loop window
    The bias-core-designer-check transient ran to 2 ms. This cell's documented
    starved-loop window is longer than that once real interconnect parasitics are
    in the netlist, so on the post-layout re-run (#84) the deck was shorter than
    the phenomenon it was measuring. Three symptoms in record
    20260811-063744-5ff219c, one cause:
    - t_bo_recover_us read NEGATIVE at 34 of 81 points -- a recovery completing
    before the rail returns. `when v(bias_okb)=1.4 rise=last` had no genuine
    post-collapse crossing inside 2 ms to find, so it returned the cap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
2026-08-11 spec: narrow DR-011's brownout recovery claim to what XMRLK actually costs (DR-023) (#225)
    DR-011's "the block recovers; it does not latch up or stay released" is
    unqualified, and sim/por-brownout/control/recovery_results.md now shows
    8/81 corners (schematic) and 1/81 (extracted) not reaching RESETn
    valid-low inside the 55 ms run window after XMRLK (DR-016) started
    holding the release one-way. POR_RAW still asserts on the recovery edge
    in every measured arm (+46 to +53 us) -- the decision is intact; what
    XMRLK costs is propagation latency, not the decision, and RESETn never
    latches up asserted at any corner.
    Adds DR-023 to narrow DR-011's sentence via cross-reference (repo
    convention: super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
2026-08-11 sim(por-vth, por-comparator-designer-check): re-cut the ramp at a constant dVDD/dt, and add a quasi-staticity guard (#226)
    * sim(por-vth, por-comparator-designer-check): re-cut the ramp at a constant dVDD/dt, and add a quasi-staticity guard (issue #206)
    Both decks held the DURATION of each quasi-static ramp segment fixed, so
    dVDD/dt was itself a function of vdd_val: 242.5/325/407.5 V/s at
    2.97/3.30/3.63 V for por-vth (a 1.68x spread), 297/330/363 V/s for
    por-comparator-designer-check. Their supply axes were therefore
    simultaneously ramp-rate axes, and no measurement on either 81-point grid
    could separate "this corner's threshold is different" from "this corner's
    rail moved faster while cros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
2026-08-11 sim harness: force single-threaded ngspice via a per-run .spiceinit (#216) (#228)
    A locally-built ngspice can link libgomp and open an OpenMP team sized
    to the host's core count for device-model loading -- a nested layer of
    parallelism underneath this harness's own process-level -j that only
    adds contention. Measured on one post-layout point: 83.9s wall with
    ngspice's default thread team vs. 3.7s with `set num_threads=1` (22x
    slower, bit-identical results). Across a full grid this silently blows
    past --timeout on every point. OMP_NUM_THREADS does not fix it --
    ngspice's own num_threads variable calls omp_set_num_threads() itself,
    overriding the environment.
    run_point() now writes a .spicein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
    [test_harness.py]
2026-08-11 sim: force single-threaded ngspice in the Monte Carlo path too (#229) (#233)
    PR #228 (#216) added a per-run .spiceinit forcing `set num_threads=1`
    to runner.run_point, but run_mc_point (sim/harness/montecarlo.py)
    never called it. run_mc_point invokes ngspice directly and runs under
    run_mc_grid's ThreadPoolExecutor, the same process/thread -j model
    that made ngspice's own nested OpenMP team costly in #216 -- so the
    Monte Carlo path (sim/run_mc.py) was exposed to the same
    slowdown/timeout-storm class the deterministic-grid fix addressed.
    Mirror the fix: import write_run_spiceinit from .runner and call it
    in run_mc_point before subprocess.run, same as runner.run_point does.
    Add a test (RunMcPo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
    [test_montecarlo.py]
2026-08-11 sim: measure the IBIAS the assembly actually delivers to por_output_chain, and re-cut the deglitch ceiling to it (DR-024) (#238)
    * sim(por-output-chain): add the ibias-sharing splice and re-cut the deglitch stress DUT to it
    Extends sim/build_tb.py's fragment set with a por-output-chain-ibias-sharing
    testbench that instantiates bias_core+temp_core+por_comparator+por_output_chain
    together and meters each consumer's own IBIAS leg, so the current
    por_output_chain actually receives on the shared node (DR-010) can be
    measured directly instead of inferred from bias_core's single-consumer
    designer-check deck.
    Re-cuts por-output-chain-deglitch's stress DUT (xdut2) from the idealised
    0.5x nominal (2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
2026-08-11 fix: select largest-magnitude down-ramp corner as ramp-feedthrough "worst" (#245)
    run_ramp_feedthrough.py's render() picked worst_dn via max() on tau_dn_us,
    which is stored as negative values -- max() returns the value closest to
    zero (mildest corner) rather than the most negative (largest magnitude,
    i.e. actually worst). Switch to min() so worst_dn resolves to the row with
    the largest-magnitude down-ramp coefficient, matching the up-ramp logic's
    intent and design/bias_core.md's existing correct prose ("The worst corner
    in both directions is ss/-40C").
    Regenerated ramp_feedthrough_results.md and re-ran the full 324-point grid
    (results.json is byte-identical; decks/logs reflect ngspice's nor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
2026-08-11 sim(por-brownout-slew): bound the ideal-por-interconnect edge above 2.50 mV/us (#232) (#246)
    Add run_por_edge_check.py, a sibling control that re-runs the ss/-40C/2.97V
    failing corner against control/netlists/na-por.spice (the por-ideal netlist
    #214's run_net_attribution.py generates) at 2.50 (reproduction), 2.8 and
    3.0 mV/us, reusing run_band_mechanism.py's deck()/internal() unmodified.
    Reproduces the published baselines exactly (ext -45.0us FAIL, por +303.4us
    PASS at 2.50 mV/us) before trusting the new rungs: por passes 2.8 mV/us
    (+178.0us margin) and fails 3.0 mV/us, bracketing the ideal-por-interconnect
    edge between 2.8 and 3.0 mV/us -- past the issue's own ~2.6 mV/us
    not-worth-it estim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
2026-08-11 docs(decision-record): record why a uniform XMBD-family width scale for issue #235 is not landed (#247)
    Attempted lever 2 from DR-024 by scaling por_output_chain's XMBD and its
    ratioed internal legs by a uniform 10x, which clears the ibias-sharing
    0.44x floor (0.182x -> 0.496x released worst case) but reopens the
    release-edge relaxation loop DR-016 fixed for issue #56: RESETn
    re-asserts spontaneously well before the qualifying brownout dip on most
    PVT points at nominal IBIAS, which sim/por-output-chain-deglitch/ surfaces
    as widespread "out of interval" measurement failures rather than a clean
    dwell-margin miss.
    No netlist, layout, or testbench change is committed here -- the resize
    regresse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
2026-08-11 refactor: dedupe build()/build_postlayout() fragment assembly in build_tb.py (#249)
    build() and build_postlayout() had identical header/hash/append/footer
    logic, differing only in which manifest dict, source directory, and
    header label they used. Collapse that shared body into a single
    _assemble() helper and reimplement both public functions as thin
    wrappers over it, keeping their names since main() calls them by name.
    Closes #248
2026-08-11 sim(por-brownout): pin T_dip,min at 30 µs by a full-grid dwell sweep at the real delivered IBIAS (DR-027 §5) (#252)
    * sim(por-brownout): measure the deglitch dwell at the real bias and re-cut the qualifying dip to it (DR-027 §5)
    The `por-output-chain-deglitch` deck applied a 10 µs qualifying `POR_RAW`
    dip -- the outgoing `T_dip,min`. Since #221 re-cut its stress DUT to the
    91.0251 nA the assembly actually delivers (DR-024), the deglitch filter does
    not reach its 1.0 V trip inside that window at 54/81 PVT points, and a
    crossing-time `.meas` errors out of its search interval rather than reporting
    the miss.
    Add `control/run_dwell_sweep.py`, which measures the dwell instead of
    extrapolatin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
2026-08-19 refactor: extract shared evidence-write footer and main() error tail into cliutil (#257)
    sim/harness/cli.py's run()/main() and sim/run_mc.py's run()/main() carried
    character-for-character identical blocks: the write-evidence-and-print-footer
    tail of run() (differing only in report.write_record vs
    mc_report.write_mc_record), and main()'s try/except around run(args). Both
    are now cliutil.finish_run() and cliutil.run_and_report(), called from both
    entry points. No behavior change.
    [run_mc.py]
2026-08-19 spec: record DR-028 — draw temp_core's XCC; both recorded reasons for leaving it out have expired (#261)
    `temp_core`'s MiM cap `XCC` is the one golden device this block does not
    draw, so `layout/postlayout/{temp_core,temp_por_top}.spice` splice it in
    ideal and every claim resting on the amplifier's compensation pole is a
    schematic claim rather than a post-layout one.
    `layout/README.md`, `layout/build_cells.py` and `layout/lvs_reference.py`
    all stated two independent blockers for that omission. Re-measured against
    the installed toolchain, neither survives:
    * the m3m4 -> m4m5 stack substitution (klayout-tools#315) is real but is
    not a differentiator — `lvs_reference.CAP_CLASS` already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
2026-08-19 layout: pin the klt build the evidence answers to, and gate on it live (#265)
    Every report under layout/reports/ named `klt 0.1.0` and a gf180mcu deck
    content hash that no klayout-tools release ships. The reports were not
    inconsistent -- they agreed perfectly with each other, which is all the
    deck-hash gate ever checked. What none of them agreed with was a *release*.
    Root cause: `klt --version` is not a build identity. A source build made after
    a release tag still carries that tag's package version, so a post-tag build of
    klayout-tools and the release it was built after both self-report the same
    `klt <version>` string while shipping different decks. The evidence base was
    produced by such a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
2026-08-19 fix: correct PROMPT_DIR path in role-prompt-wiring tests (#262) (#267)
    test-app-permission-fallback.sh and test-forge-helpers-rate-limit-
    fallback.sh both computed PROMPT_DIR as
    $HELPERS_DIR/../.claude/commands/loom, which resolves to
    .loom/.claude/commands/loom (doesn't exist). The real repo-root
    .claude/commands/loom needs one more ../. Under set -euo pipefail,
    the failing cd aborted the script mid-run, so every assertion in the
    "role-prompt wiring" section silently never executed.
    Add one more ../ to both PROMPT_DIR assignments, and a directory
    existence check right before the cd so future path drift fails with
    a clear message instead of an opaque `cd: No such file or directory`.
    Closes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
2026-08-19 fix: skip forge_cmd.rs assertion in rate-limit-fallback test when loom-daemon/src isn't vendored (#268)
    The final assertion in test-forge-helpers-rate-limit-fallback.sh checks
    loom-daemon/src/forge_cmd.rs -- Loom framework source that this repo,
    a downstream .loom/ consumer, has never vendored. The check was
    structurally unable to pass here, always falling through to FAIL.
    Skip (pass-through) the assertion when loom-daemon/src doesn't exist
    locally, and keep enforcing it when the directory is present (e.g. run
    inside the Loom framework repo itself).
2026-08-19 layout: route the four drawn MiM caps' plates to their schematic nets (#269)
    bias_core's XCC/XCOK and por_output_chain's XCDG/XCTIM were drawn floating
    (FuseTop + CAP_MK + MIM_L_MK over a Metal4 bottom plate, no routing to
    either plate), so a clean LVS proved plate area/capacitance but nothing
    about plate connectivity. klt 0.2.0's CapacitorDevice now declares
    top_plate_via/top_plate_via_metal (Via4 up to Metal5), so a routed plate
    lands on the connectivity graph.
    Route each drawn unit's two plates onto the schematic nodes its golden
    card names: bottom plate via Metal4->Via3->Metal3->Via2->Metal2->Via1->
    Metal1, top plate via FuseTop->Via4->Metal5->Via4->a second Metal4
    island->...->Metal1.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
2026-08-19 layout: draw temp_core's MiM cap XCC, routed onto PG/NZ (#271)
    temp_core's 12 x 12 um compensation cap XCC was the one golden device
    anywhere in this block that the layout did not draw, so layout/postlayout/
    spliced it in ideal and any post-layout claim resting on the amplifier's
    compensation pole was really a schematic claim. Both reasons recorded for
    leaving it out had expired (DR-028): the m3m4 -> m4m5 stack substitution is
    one this block already makes for its four other golden MiM cards, and
    klayout-tools#314 -- plates outside the deck's connectivity stack -- is
    closed, with #258 pinning the published klt 0.2.0 that ships the fix and
    #264 establishing the Via4/Metal5 plate routing on tho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
2026-08-19 sim: re-run compensation-pole campaigns post-#259 (temp_core's XCC drawn) (#275)
    * sim: update post-layout provenance notes for temp_core's drawn XCC (#270)
    layout/postlayout/AUDIT.md now reports 0 ideal (undrawn) devices for both
    temp_core and temp_por_top since #259/PR #271 drew temp_core's MiM
    compensation cap XCC. Refresh each testbench-postlayout/tb.json's
    netlist_provenance_note to quote the current AUDIT.md row instead of the
    stale "XCC is NOT DRAWN" caveat, ahead of re-running the campaigns whose
    claims turn on the amplifier's compensation pole against a clean tree.
    Part of #270.
    * sim: re-run compensation-pole campaigns post-#259 (temp_core's XCC drawn) (#270)
    layout/postlayout/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
2026-08-19 sim: temp_core loop-stability .ac testbench (issue #274) (#277)
    * sim: add temp_core loop-stability .ac testbench (issue #274)
    Adds sim/temp-core-loop-stability/, a small-signal .ac loop-gain
    testbench for temp_core's error-amplifier loop. Breaks the loop at PG
    per the issue's verified guidance: the amplifier's own output stays on
    PG (XMS2N/XMS2P drains, XCC/XRZ compensation), and only the two mirror
    gate connections that actually close the loop (XMP1, XMP2) move to a
    new PG_FB node the testbench injects an AC test signal onto (XMP3's
    gate, a dead-end PTAT-readout leg that does not feed back into the
    amplifier's inputs, stays on PG).
    testbench/tb_temp_core_loop_stability.spice is a hand-ma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
2026-08-19 sim: dedupe the derived-record append-only write guard into cliutil (#278)
    sim/por-iq/analyze_por_iq.py, sim/postlayout_delta.py,
    sim/temp-accuracy-mc/analyze_breakdown.py, and
    sim/temp-accuracy-vt/analyze_derived.py each hand-rolled the same
    "write a derived record, refuse to overwrite an existing one" footer,
    and had already drifted into two message/exit-code variants (1 vs. 2).
    Add harness.cliutil.write_derived_record(), the derived-record
    counterpart to report.write_record()'s append-only guard (#175), which
    raises the existing report.RecordExists on collision. Update the four
    call sites to call it and catch RecordExists in main(), converging on
    one message ("<path> already exists; reco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
    [postlayout_delta.py]
2026-08-21 docs: fix stale issue-status table in temp_por_top's post-layout roll-up (#280)
    The "Regressions and follow-ups" table in design/temp_por_top.md still
    listed issues #185, #187 and #199/#200 as "Open" as of its last edit
    (2026-08-19, #275), even though all four closed on 2026-08-11 -- the same
    staleness #255's 2026-08-15 T1/bronze checklist re-read flagged as item 8's
    caveat. Re-verified against current issue state (gh issue view) and each
    resolving PR (#222, #218/DR-021, #205/DR-020) before writing the resolution
    text, matching the style already used for the #189/#188 rows in the same
    table.
    The per-row spec table this document feeds (spec/target-spec.md) was
    already current -- only this su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
2026-08-21 docs: cite closed #274 loop-stability testbench in temp_por_top's post-layout roll-up (#282)
    design/temp_por_top.md's "Loop stability" paragraph still said a quantified
    phase/gain-margin testbench had never been measured and that the gap was
    tracked by open issue #274. PR #277 (merged 2026-08-19) closed #274 by
    adding sim/temp-core-loop-stability/, a schematic-level .ac loop-gain
    testbench that measures exactly that across the full 81-point PVT grid
    (record 20260819-182610-a4eebe7: phase margin 34.2-47.1 deg, gain margin
    4.43-7.50 dB). Update the paragraph to cite the closed issue and the
    measured ranges, while disclosing what remains open: no post-layout
    (extracted-netlist) re-run of this s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
2026-08-21 spec: renumber temp-accuracy decision record DR-011 -> DR-029 (#283)
    Two unrelated decision records collided on DR-011: the por-brownout
    falling-slew-limit record and the temp-accuracy mismatch-not-met record.
    Renumber the lower-blast-radius temp-accuracy record to the next free
    slot, DR-029, per the curated issue's recommendation, and update its
    four inbound citations (design/temp_core.md, sim/devchar/SUMMARY.md,
    DR-022, and the temp-accuracy-related citations in spec/target-spec.md).
    The brownout record keeps DR-011 unchanged.
    Closes #281
2026-08-23 fix: verdict-staleness-guard.sh requests nonexistent gh pr view 'merged' field (#287)
    `gh pr view --json` has no boolean `merged` field (only `mergedAt` /
    `mergedBy` / `mergeCommit`), so every guard invocation failed with
    `Unknown JSON field: "merged"` on gh 2.98.0, before ever reaching the
    #6781 NOT_OPEN short-circuit it was meant to protect.
    Switch the --json field list to `mergedAt` and derive the merged
    boolean from whether it is non-null/non-empty, preserving the existing
    NOT_OPEN short-circuit (merged and closed-unmerged PRs both still
    short-circuit to exit 14 with no label/comment writes). Update the
    test suite's mocked gh pr view stubs to match.
    This is a local patch to the vendore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
2026-08-25 Add Chipalooza Challenge #3 proposal for the temp sensor + POR block (#291)
    Adds docs/chipalooza/challenge-3-proposal.md: an email-ready proposal
    covering block type, I/O mapped to the challenge's slot budget, functional
    description, a target-spec table re-derived from this repo's own sim/
    evidence at the challenge rails (rows unmet or not yet characterized at
    5.0 V are marked explicitly, per DR-001's 3.3V-core device-flavor
    constraint), a test-plan outline for the packaged part, and the
    combined-macro category note distinguishing this entry from Challenge #2's
    split PVT-sensor/voltage-supervisor pair. Links from README under a new
    "Chipalooza" heading.
    Closes #290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
2026-08-26 Chipalooza design-review bar: make check/smoke/characterize + README verification section (#293)
    * Add make check/smoke/characterize + README Chipalooza verification section
    Chipalooza's schematic-review bar (2AMLogic/2am#542, issue #292) needs a
    single command line that reproduces this repo's full simulation evidence
    from a fresh clone. Adds a root Makefile (check/smoke/characterize, thin
    wrappers over the existing sim/ harness), sim/characterize.py (the
    characterize driver: every schematic-level PVT-grid and Monte Carlo
    experiment discovered under sim/*/testbench/, run with its manifest's own
    defaults), and a README "Independent verification (Chipalooza)" section
    (prerequisites, the three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
    [characterize.py, test_characterize.py]
2026-09-05 feat(champion): standing authorization for design-evidence auto-merge (#6850)
    Operator ruling 2026-09-05: Judge-approved, green-CI PRs whose entire
    changed-file set lives in design/, sim/, layout/, measurements/,
    verification/, or docs/ auto-merge without the four-axis human hold.
    Rationale: canary design evidence is fully revertible with no fleet-infra
    blast radius, and the held-PR pattern (sky130-sar-adc#123 sat mergeable for
    days as the sole blocker of a layout chain) costs more than it protects
    here. spec/ and every tool surface fall outside the patterns, so the
    exact-subset rule keeps them on the four-axis judgment automatically.
    C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
2026-09-10 sim: post-layout re-run of temp_core's loop-stability testbench (#298) (#299)
    * sim: add post-layout testbench for temp_core loop-stability (issue #298)
    Hand-forked testbench-postlayout/ sibling of the schematic-level
    temp-core-loop-stability .ac loop-break testbench, against
    layout/postlayout/temp_core.spice. Also extends postlayout_delta.py to
    locate the extracted source netlist from a hand-maintained fragment's
    own provenance header when the experiment has no POSTLAYOUT_FRAGMENTS
    entry (build_tb.py's verbatim-copy mechanism can't produce a fragment
    that edits ports inside the subcircuit body).
    * sim: post-layout re-run of temp_core's loop-stability testbench (#298)
    Runs the extracted t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
    [postlayout_delta.py]
2026-09-20 signoff: commit a klt signoff block manifest as the T1 verdict of record (#302)
    This block's "gap to T1" state was hand-written prose (issue #145, re-read
    by hand three times, closing at 10/10 pass). A hand-read goes stale the
    moment either the evidence or the checklist moves, and both have: the
    klayout-tools checklist grew an eleventh item on 2026-09-17.
    Commit the machine-readable claim instead, and have CI re-grade it.
    - signoff/block-manifest.json declares block `gf180-temp-por`, kind
    `analog` (single analog partition -- the POR output chain is logic, but
    hand-captured and hand-drawn, so no Digital-column artifact exists and
    there is no partition boundary to declare), and cites e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
2026-09-20 layout(temp_por_top): add T1 item 11 klt erc supply spec + report (#300) (#303)
    Adds the klt erc supply spec and report T1 item 11 ("power delivery,
    structural", klayout-tools#2025) requires:
    - layout/cells/temp_por_top.erc-supply-spec.json: Poly2/Comp gate role,
    Metal1-Metal5 stackup, Contact/Via1-4, VDD/VSS declared kind:"supply".
    Layer numbers cross-checked against both build_cells.py's own constants
    and the installed PDK's libs.tech/klayout/tech/gf180mcu.lyp. label_layer
    is declared on Metal1 (34/10) and Metal2 (36/10) -- verified against this
    block's own merged GDS text (klt layers --include-text), not assumed --
    Metal5 carries no pin text here (it is MiM-plate escape routi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
2026-09-21 layout(temp_por_top): clear the T1 item-11 ERC supply verdict with devices[] (#304)
    The committed `klt erc` supply run for `temp_por_top` reported one
    `erc.supply_short` naming VDD/VSS. It was never a power-delivery defect:
    `klt erc` registers no device extraction, so this block's drawn poly
    resistors -- `temp_core`'s R2 gain ladder, `bias_core`'s bias resistors and
    `por_comparator`'s supply-sensing sense divider -- read as plain wires
    bridging the rails. That was filed upstream as klayout-tools#2183, and
    upstream fixed it in klayout-tools#2205 (commit ddf47e78) by adding an
    optional `devices[]` spec array: a declared device-body marker layer is
    subtracted from a conductor role *before* conn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
2026-10-01 chore: resync installed Loom surfaces
    resynced_by: fleet-resync
    invocation: fleet-resync.sh --fleet-only --push
    <!-- loom:provenance v1 build=unknown 19f4e67fd0a0afbd3d8b6606ca91ceac911377a3 clean prompts=none sweep=none story=none trace=78a5dfbdfd8c530aecd1bb436fd096df host=loom-worker-2 base=75c763cf02c2a6152f643e460cfcc73667050d1f run=loom-run/v1:timer:loom-worker-2/fleet-resync:67c759f7ef3c43e38d3fa8d5f19a2dd1 installs=0.19.593 658650a4f0eff932ac66a8f690eaedf8123fc83b -->
    Loom-Story: none
    Loom-Trace-Id: 78a5dfbdfd8c530aecd1bb436fd096df
    Loom-Build: unknown 19f4e67fd0a0afbd3d8b6606ca91ceac911377a3 clean
2026-10-01 chore: resync installed Loom surfaces
    <!-- loom:provenance v1 build=unknown 56435bf476452911283e43940ecfd9a30f804af9 clean prompts=none sweep=none story=none trace=342405c5ebc99bdbf17afbd983c0c41c host=loom-worker-2 base=17982e035cc8ea81ceedc784711a5d2d06f404fe run=loom-run/v1:timer:loom-worker-2/fleet-resync:20c09f231d424cd5b57ca7991848dd8a installs=0.19.603 8c39bf7cde8a8c03d1aaee441f397c017b6a3a9e -->
    Loom-Trace-Id: 342405c5ebc99bdbf17afbd983c0c41c
    Loom-Build: unknown 56435bf476452911283e43940ecfd9a30f804af9 clean
    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
2026-10-01 chore: resync installed Loom surfaces
    <!-- loom:provenance v1 build=unknown f2868e6b4d60d11a8ab47d25cad9e248229d2f66 clean prompts=none sweep=none story=none trace=4e2766ed5160781df891476246a9be2e host=robb-studio base=8fbac3760bc6814e39dc4b896724b7cffaa8b1ec run=loom-run/v1:timer:robb-studio/fleet-resync:2d3851d5-1673-43ae-bcc6-e5c971b37f33 installs=0.19.603 74778a6aeea5d9e06b489400942b35f33c8bb766 -->
    Loom-Trace-Id: 4e2766ed5160781df891476246a9be2e
    Loom-Build: unknown f2868e6b4d60d11a8ab47d25cad9e248229d2f66 clean
    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
2026-10-01 chore: resync installed Loom surfaces
    <!-- loom:provenance v1 build=unknown d6714830391f7596338b8de40ee2d0f45dcd12f5 clean prompts=none sweep=none story=none trace=af273f717e759e690d07f372734e9278 host=robb-pro base=397a37fcbba96f28f4226616f12fa95b736c67ed run=loom-run/v1:timer:robb-pro/fleet-resync:92e2f9ba-d083-411b-833b-ae52d169ef04 installs=0.19.605 6eb2b65a4496b7becb84ef1f944493a541fd01cd -->
    Loom-Trace-Id: af273f717e759e690d07f372734e9278
    Loom-Build: unknown d6714830391f7596338b8de40ee2d0f45dcd12f5 clean
    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
2026-10-01 chore: resync installed Loom surfaces
    <!-- loom:provenance v1 build=unknown 617257919edc1b9b9ee27532c5ec1b8a64523388 clean prompts=none sweep=none story=none trace=cb047565635d880cd4ae328b5cfaaf68 host=loom-worker-1 base=060ba51ce3d2caf02bac223ab8c66d3d5f5046d1 run=loom-run/v1:script:loom-worker-1/fleet-resync:9973280a-d0de-4196-8cdb-f221825edc41 installs=0.19.609 ff30576dacc8c2734b1c7434bedd29c47122caeb -->
    Loom-Trace-Id: cb047565635d880cd4ae328b5cfaaf68
    Loom-Build: unknown 617257919edc1b9b9ee27532c5ec1b8a64523388 clean
    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
2026-10-01 chore: resync installed Loom surfaces
    <!-- loom:provenance v1 build=unknown 617257919edc1b9b9ee27532c5ec1b8a64523388 clean prompts=none sweep=none story=none trace=dbafe4f8526617aa07c890721298a080 host=robb-studio base=f84bfd6e556b07d911579c225bc4762197307cc2 run=loom-run/v1:timer:robb-studio/fleet-resync:1817df66-02cc-4b27-927d-a38485da550a installs=0.19.610 c94891dd526cf6db5ee02045424c6913be522048 -->
    Loom-Trace-Id: dbafe4f8526617aa07c890721298a080
    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
2026-10-01 chore: resync installed Loom surfaces
    <!-- loom:provenance v1 build=unknown a2a39ac2736eb2686e2c65412d939e67c0438a7d clean prompts=none sweep=none story=none trace=fc1a121767151aae5bd7427c683b7db6 host=robb-pro base=c76f76c372d2f074d372672cd7abac8ee80cda46 run=loom-run/v1:timer:robb-pro/fleet-resync:708eb7c8-469d-4783-80b7-bafe142df3c4 installs=0.19.612 d25614656adcf70162da95c5e1035e99a0639a1a -->
    Loom-Trace-Id: fc1a121767151aae5bd7427c683b7db6
    Loom-Build: unknown a2a39ac2736eb2686e2c65412d939e67c0438a7d clean
    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
2026-10-01 chore(tooling): update repo-skills to v0.19.5
    Fleet-wide Repo Skills rollout (2026-10-01). compute-drift's axis 6
    reported repo-skills at 11 different versions across the fleet's
    checkouts; this brings gf180-temp-por from v0.10.0 to v0.19.5 (rjwalters/repo
    @ ff282cd), staging only the installer's own surface.
    Loom-Trace-Id: 038dce5d677bceeeca3c111787ac5b68
    Loom-Build: unknown unknown unknown
    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
2026-10-01 chore: resync installed Loom surfaces
    <!-- loom:provenance v1 build=unknown 126c80914e42f913c4fc778d3ddce96daa2c7a77 clean prompts=none sweep=none story=none trace=15a20fbea7a00d0922b943088c80e19d host=loom-worker-1 base=0a6827adaa2d925f5a54a407b0f2bf42a43adf43 run=loom-run/v1:script:loom-worker-1/fleet-resync:ecc423da-4625-49de-b25a-692fd669a029 installs=0.19.612 d47e0c57a6bea6f7b61ef9ce62632d70c39ef5d5 -->
    Loom-Trace-Id: 15a20fbea7a00d0922b943088c80e19d
    Loom-Build: unknown 126c80914e42f913c4fc778d3ddce96daa2c7a77 clean
    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
2026-10-01 chore: resync installed Loom surfaces
    <!-- loom:provenance v1 build=unknown 126c80914e42f913c4fc778d3ddce96daa2c7a77 clean prompts=none sweep=none story=none trace=a0a42bd10fcfa6d7cbcc9c021c406848 host=loom-worker-2 base=f848c9230adaaeb47d2b3ab784589c4cba7f65c0 run=loom-run/v1:timer:loom-worker-2/fleet-resync:9e174e6bb0fa41d786e4a86e45632b6f installs=0.19.612 6f0871dc66e62b36d8382ced980d2805bfd97e50 -->
    Loom-Trace-Id: a0a42bd10fcfa6d7cbcc9c021c406848
    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
2026-10-01 chore: resync installed Loom surfaces
    <!-- loom:provenance v1 build=unknown 6f3411c8a63e68097dde01bce8a8422230f54218 clean prompts=none sweep=none story=none trace=9aa0a46bb352b9665fdaa5f5b3b85dd7 host=robb-pro base=f083c01a82cb1c5d20ab42c98d79d6d376ec538a run=loom-run/v1:timer:robb-pro/fleet-resync:ca419e1d-6646-4678-ac7a-b263e4b5119e installs=0.19.612 7731400b3e3e1df39074564166edf656feb0999c -->
    Loom-Trace-Id: 9aa0a46bb352b9665fdaa5f5b3b85dd7
    Loom-Build: unknown 6f3411c8a63e68097dde01bce8a8422230f54218 clean
    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
2026-10-01 layout: re-transcribe lvs_reference.py for klt 0.6.0's gf180mcu deck
    Moves layout/toolchain.json's klt pin from 0.2.0 to 0.6.0 (deck
    sha256:95c2eb91...cb637) and brings lvs_reference.py's deck-imposed
    rewrites and MiM capacitance law in line with what the new deck
    actually models, so the pin bump's --regen-all run goes back to
    LVS match on every cell instead of mismatch on four of six:
    - Re-transcribe MIM_AREA_CAP_F_UM2/MIM_PERIM_CAP_F_UM to the deck's
    two-term law (1.99e-15 F/um^2, 2.383e-16 F/um) and re-check every
    downstream consumer (postlayout.py's inverse area solve now pins
    its own frozen v0.2.0-law constants explicitly, since that module's
    evidence is produced out-of-band an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
2026-10-02 chore: resync installed Loom surfaces
    <!-- loom:provenance v1 build=unknown 13c0a3ef467a888520a6529ab34486ab8be826be clean prompts=none sweep=none story=none trace=41356080f367e491d5ff03f17bb98c27 host=loom-worker-2 base=4ce0ffbe413ef779c780cc988f0b6df68f531552 run=loom-run/v1:timer:loom-worker-2/fleet-resync:44455fbcbab745abb92cea192fafbb1d installs=0.19.614 3c79f7b1d0cc14723e049cff4250ff7330804326 -->
    Loom-Trace-Id: 41356080f367e491d5ff03f17bb98c27
    Loom-Build: unknown 13c0a3ef467a888520a6529ab34486ab8be826be clean
    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
2026-10-02 chore: resync installed Loom surfaces
    <!-- loom:provenance v1 build=unknown ea2dd21f2ba310ec007d047ddfecc6cd27d220ac clean prompts=none sweep=none story=none trace=f04a67f3922788d2ccdd66578c8d18f9 host=loom-worker-1 base=fcdb5ae740a9771bf06e696e9f2093fc410c713a run=loom-run/v1:timer:loom-worker-1/fleet-resync:1c3b601dd998488595adc09040c007d4 installs=0.19.614 79f4897c5d3c78dbfc1b022f77d244838dbf4ccb -->
    Loom-Trace-Id: f04a67f3922788d2ccdd66578c8d18f9
    Loom-Build: unknown ea2dd21f2ba310ec007d047ddfecc6cd27d220ac clean
    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
2026-10-02 chore: resync installed Loom surfaces
    <!-- loom:provenance v1 build=unknown 6f3411c8a63e68097dde01bce8a8422230f54218 clean prompts=none sweep=none story=none trace=acb28d0049e0cc75536f96d503f6e814 host=robb-studio base=6bc43b3d5c578ae01435ba1ebfe56dd4a9bc6f28 run=loom-run/v1:timer:robb-studio/fleet-resync:85d2b1b5-e81d-40c3-ab6a-9a00efbc4ee2 installs=0.19.616 d86523eeadb32b95777f3cd3a76dd2f72f0bf792 -->
    Loom-Trace-Id: acb28d0049e0cc75536f96d503f6e814
    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
2026-10-02 chore: resync installed Loom surfaces
    <!-- loom:provenance v1 build=unknown 2b50bd69eddd038dd738465aa58a9ebca11410ac clean prompts=none sweep=none story=none trace=324e4f607054d0396cfdf8fdc01e93ae host=robb-pro base=921df06cee9e2b38d4c48b1cba2ea19d5deb2389 run=loom-run/v1:timer:robb-pro/fleet-resync:a63799f1-2ad7-4946-b81d-2ec231bc2d2f installs=0.19.617 81cb2ad7e091b19d6a2b95d1add6938c2100d46b -->
    Loom-Trace-Id: 324e4f607054d0396cfdf8fdc01e93ae
    Loom-Build: unknown 2b50bd69eddd038dd738465aa58a9ebca11410ac clean
    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
2026-10-02 chore: resync installed Loom surfaces
    <!-- loom:provenance v1 build=unknown 00d92b326aed50280cd90dc116b7caec27668251 clean prompts=none sweep=none story=none trace=9a5d23cc82b6d3a1c83bfee47bd04970 host=loom-worker-2 base=2820596e47bf5c1cf4fe2859e0e6cdfb02095db6 run=loom-run/v1:timer:loom-worker-2/fleet-resync:12136a7a025d49f3a60b5edb04a3ff81 installs=0.19.619 4c0f505e4f0b76f8ccec07bda6d8b839030c077b -->
    Loom-Trace-Id: 9a5d23cc82b6d3a1c83bfee47bd04970
    Loom-Build: unknown 00d92b326aed50280cd90dc116b7caec27668251 clean
    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
2026-10-02 layout: regenerate postlayout evidence against the pinned klt 0.6.0
    `layout/postlayout.py`'s committed evidence (`layout/reports/*/
    extracted-parasitics.*`, `layout/postlayout/*.spice`) is produced out of band
    by its own `--extract`/regenerate cycle, so #311/#312's `layout/toolchain.json`
    pin move did not carry it forward. This regenerates all five cells against the
    pinned `klt 0.6.0` and teaches the parser the four output changes that move
    blocked.
    **The parasitic model is now a star per net** (klayout-tools#592). A net that
    carries drawn interconnect keeps its own name as a hub node and grows one
    `<net>__t<k>` node per device terminal on it; its single lumped series
    resistance is split ac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
2026-10-02 layout: declare ties[] in temp_por_top's erc supply spec (T1 item 11)
    klt erc's ties[] tie-collapse bug (klayout-tools#2169) that justified
    omitting ties[] from this spec is fixed upstream. Declare four ties[]
    entries covering every substrate/well tie in the design:
    - device_body_wells -> VDD: every ordinary PMOS device-body Nwell,
    via well_excludes (drops the two PNP base tubs) and
    well_excludes_boxes (drops temp_core's NW2, see below). tap_boxes
    names each well's own dedicated tie-strap comp -- this stream draws
    no implant layer on any MOS device, so tap_requires cannot name a
    real tap boolean here.
    - pnp_base_tubs -> VSS: the two vertical-PNP arrays' own base tubs,
    selected b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
2026-10-02 layout: correct the ties[] falsifiability prose to match what klt erc does
    Judge review on #318 found the ERC result sound but three committed-prose
    claims about it wrong. All three are accuracy fixes; no geometry, no spec
    field, and no verdict changes.
    1. The broken-tie probe described in the spec's `_comment`, in
    layout/README.md's methodology note, and in the PR body claimed that
    emptying a `tap_boxes` entry "reports a real erc.missing_tie". It does
    not. Run against this GDS, an emptied (or key-dropped) `tap_boxes`
    grades `degenerate_tap_declaration`: the entry moves into
    `erc_coverage.skipped`, `erc_status` degrades to `clean_partial`, and
    `erc_findings` / `erc_finding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
2026-10-02 chore: resync installed Loom surfaces
    <!-- loom:provenance v1 build=unknown 456dad6d90259846313dc3bb80bf4e5471ef2d76 clean prompts=none sweep=none story=none trace=bb9688c03fb5211d06f48c8838a5505c host=robb-studio base=4682d0b15727f303a2d4378b2af91cea9e455449 run=loom-run/v1:timer:robb-studio/fleet-resync:e965c017-8ec7-485d-b46e-aeb399b81fb4 installs=0.19.620 0d28ba49f5a88fdb37271de9cb0144eb3442c6e3 -->
    Loom-Trace-Id: bb9688c03fb5211d06f48c8838a5505c
    Loom-Build: unknown 456dad6d90259846313dc3bb80bf4e5471ef2d76 clean
    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
2026-10-02 chore: resync installed Loom surfaces
    <!-- loom:provenance v1 build=unknown 6c6d2b6565dc13eff4c6811b9c670f452106516b clean prompts=none sweep=none story=none trace=539be979ae694d66ede516a7b5d17e41 host=robb-pro base=16876ad6a87837831009fde5f5b939dc60a9603e run=loom-run/v1:timer:robb-pro/fleet-resync:9444d216-de08-442f-8352-ba59f6e81bb3 installs=0.19.621 a90dc1d794eb9ff70aaf939ebf495abe716f3bdd -->
    Loom-Trace-Id: 539be979ae694d66ede516a7b5d17e41
    Loom-Build: unknown 6c6d2b6565dc13eff4c6811b9c670f452106516b clean
    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
2026-10-02 sim: re-derive the net-shorting manipulation for the star parasitic model
    `klt` 0.6.0 (pinned in `layout/toolchain.json` since #314) models a net's
    drawn interconnect as a per-net star: the net's own name is the hub, each
    device terminal on it is a `<net>__t<k>` node, the net's lumped series
    resistance is split across the `R<net>_t<k>` arms joining them, its lumped C
    sits on the hub, and vertical-overlap coupling is a direct `Ccc__<a>__<b>`.
    The retired model put the same totals on one dangling R-C leg per net.
    `run_net_attribution.py`'s control answers "which nets' parasitics carry the
    post-layout falling-slew shift" by making named nets' interconnect ideal one
    group at a time. Under the d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
    [test_postlayout_forks.py, test_run_net_attribution.py]
2026-10-02 chore: resync installed Loom surfaces
    <!-- loom:provenance v1 build=unknown f6d28134bfe476967e005d97424073085f55e8a3 clean prompts=none sweep=none story=none trace=27eb90670d441065f593e941066ee005 host=loom-worker-2 base=879b1d2d2786b6c87270c66ba79fd400282cc45c run=loom-run/v1:timer:loom-worker-2/fleet-resync:04001bba930241cf9e325bf304a9270a installs=0.19.623 ccc19c2bbe2aa65328427730fa53f70eb56128c6 -->
    Loom-Trace-Id: 27eb90670d441065f593e941066ee005
    Loom-Build: unknown f6d28134bfe476967e005d97424073085f55e8a3 clean
    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
2026-10-02 sim: correct the por-output-chain-pulse post-layout provenance note
    `testbench-postlayout/tb.json`'s `netlist_provenance_note` is rendered
    verbatim into every record `sim/run_corners.py` mints from this manifest,
    so it is a provenance claim about the netlist under test, not a comment.
    It still described the pre-#314 extraction: 18/30 nets, SigmaR 66322 Ohm,
    SigmaC 828.6 fF, 12 body/plate/well ties.
    `layout/postlayout/AUDIT.md` reads 18/20 nets across 131 cards, SigmaR
    66418 Ohm, SigmaC 901.4 fF of which 81.195 fF is direct inter-net
    coupling, and 2 ties (`NW1`->`VDD`, `vsubs`->`VSS`) -- the other ten
    became real routed plate connections in #269. Restate the note from the
    committed `AUDIT.md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
2026-10-02 sim: re-measure the XMBD/IBIAS watch item under the star parasitic model
    New append-only record `20261002-145833-6dc0f39` under
    `sim/por-output-chain-pulse/`: the `tt` process column (3 temperatures x
    3 supplies) of the post-layout pulse/Iq testbench, run against the
    current `layout/postlayout/por_output_chain.spice`.
    WHY A RE-RUN WAS DUE. `design/por_output_chain.md`'s `XMBD`/`IBIAS`
    watch item asks whether the extraction introduces a spurious series
    device into the `IBIAS` path, where the local mirror diode has none by
    design. It was answered on two legs: a measurement, and a topology
    argument that the dangling-leg model could not put an extracted R
    between two terminals of the same net.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
2026-10-02 design: close the XMBD/IBIAS watch item on a measurement, not a model argument
    The watch item asks whether the extraction introduces a spurious series
    device into the `IBIAS` path, where `XMBD`'s local mirror diode has none
    by design. It was answered on two legs: a 4-ppm `iq_asserted_1x_na`
    delta, and the observation that the dangling-leg parasitic model could
    not put an extracted R between two terminals of the same net. #314's
    star model retired the second leg -- `RIBIAS_t1` lands on X12's drain
    and `RIBIAS_t2` on X12's gate, terminals the schematic shorts -- so
    #316 reopened the item pending a re-run.
    Record `20261002-145833-6dc0f39` is that re-run. Restate the section
    as two dated answer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
2026-10-02 chore: resync installed Loom surfaces
    <!-- loom:provenance v1 build=unknown bc461736314499b6c2c4c0ad51fb2294f60336f5 clean prompts=none sweep=none story=none trace=c3ea68717dd3a908dbbd60a35bc8b5d6 host=robb-studio base=73fe45fafbe5d1912e0f04a0dd524491c2454450 run=loom-run/v1:timer:robb-studio/fleet-resync:8d4c49e2-3258-4080-b0c8-082499053654 installs=0.19.623 a50aaf70069f8897c41a64b7d90783c5ab8294e0 -->
    Loom-Trace-Id: c3ea68717dd3a908dbbd60a35bc8b5d6
    Loom-Build: unknown bc461736314499b6c2c4c0ad51fb2294f60336f5 clean
    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
2026-10-02 sim: correct the deglitch and floor post-layout provenance notes
    Both manifests still described the extraction that #314 retired
    (18/30 nets, ΣR 66322 Ω, ΣC 828.6 fF, 12 ties). The netlist in
    layout/postlayout/ today is the star-model extraction AUDIT.md
    describes: 18/20 nets across 131 cards, ΣR 66418 Ω, ΣC 901.4 fF of
    which 81.195 fF is inter-net coupling, 2 ties. The note now matches the
    one #319 already put in the pulse manifest.
    The note is rendered verbatim into every record minted from the
    manifest, and editing it changes the manifest sha256 those records pin,
    so it moves here together with the full-grid re-runs that mint new
    records from it (#322) rather than ahead of them.
    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
2026-10-02 sim: full-grid post-layout por_output_chain records on the star extraction
    Three 81-point grids against the current layout/postlayout/
    por_output_chain.spice (the post-#314 star-model extraction), each
    superseding the 20260811-* record taken on the retired extraction:
    - por-output-chain-pulse 20261002-175842-1b8a4da, supersedes
    20260811-055201-d0ee17d. 81/81 PASS, clean tree.
    - por-output-chain-deglitch 20261002-180124-1b8a4da, supersedes
    20260811-210344-5ea1df3. 81/81 PASS.
    - por-output-chain-floor 20261002-180712-1b8a4da, supersedes
    20260811-125812-8e43e14. 81/81 PASS.
    The deglitch and floor records were run back-to-back after the pulse
    grid, while the pulse grid's own output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
2026-10-02 sim: clean-tree re-run of the post-layout deglitch grid on the star extraction
    Record 20261002-180956-d4369b3 supersedes 20260811-210344-5ea1df3 and
    reproduces the dirty-tree-stamped 20261002-180124-1b8a4da's result and
    spread tables byte-for-byte, so its numbers are the citable ones. 81/81
    PASS.
    Loom-Story: 2AMLogic/gf180-temp-por#322
    Loom-Trace-Id: 222719f11b4ad2acb34f1a2327472ea3
    Loom-Build: 0.19.623 ccc19c2bbe2aa65328427730fa53f70eb56128c6 clean
2026-10-02 sim: clean-tree re-run of the post-layout floor grid on the star extraction
    Record 20261002-181248-add3577 supersedes 20260811-125812-8e43e14 and
    reproduces the dirty-tree-stamped 20261002-180712-1b8a4da's result and
    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
2026-10-02 design: restate the post-layout pulse/dwell/floor claims from the star-extraction grids
    "The pulse-width / dwell-time delta" now publishes the three full-grid
    records taken against the current layout/postlayout/por_output_chain.spice,
    with the pre-#314 and schematic numbers beside them:
    - por-reset-pulse: +1.78 % to +2.26 % over the retired extraction, a
    widening at all 81 points but not uniform across the process axis.
    The binding minimum is re-identified from the grid, and is still
    ff_-40c_2.97v: 4.41377 ms at nominal IBIAS, 1.65314 ms at 3x.
    - por-reset-valid-floor: within -0.05 % to +0.03 % at every point.
    - Deglitch: both edges lengthen, the falling edge by +7.4 % to +13.3 %.
    T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
2026-10-02 chore: resync installed Loom surfaces
    <!-- loom:provenance v1 build=unknown bc461736314499b6c2c4c0ad51fb2294f60336f5 clean prompts=none sweep=none story=none trace=8bee8a664bfc89e0bbfbb3c2de7342ba host=loom-worker-2 base=338e4f817f3236fd52de032c8a60183845c19331 run=loom-run/v1:timer:loom-worker-2/fleet-resync:de2ceceb48ea4927a1334d08dc0082fe installs=0.19.624 5f49564fa78ae06f8c48d5224dae9ded04200bb7 -->
    Loom-Trace-Id: 8bee8a664bfc89e0bbfbb3c2de7342ba
    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
2026-10-03 chore: resync installed Loom surfaces
    <!-- loom:provenance v1 build=unknown 752d316233ed1a3da9e4f69ad760eb99bb477747 clean prompts=none sweep=none story=none trace=7851839b67c00a023e97cbdea1f580e1 host=robb-pro base=7dc1947232e668b7edddf225b15efc717e26e3e4 run=loom-run/v1:timer:robb-pro/fleet-resync:ae492b66-dca0-4da4-acab-8d26778f2d5c installs=0.19.624 121fac45f5006879bf58a18c951b9243d9099a18 -->
    Loom-Trace-Id: 7851839b67c00a023e97cbdea1f580e1
    Loom-Build: unknown 752d316233ed1a3da9e4f69ad760eb99bb477747 clean
    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
2026-10-03 chore: resync installed Loom surfaces
    <!-- loom:provenance v1 build=unknown b34a08286a42f47f917ec46647d4d167c1f5207c clean prompts=none sweep=none story=none trace=a8e453124b899b440f42c9d83837c7b6 host=loom-worker-2 base=c7de85ce59b4ed4e81d38a7cb3673557ce63ab3b run=loom-run/v1:timer:loom-worker-2/fleet-resync:f02dd5df715347fe90fe14b9353a1b66 installs=0.19.624 98c193cf0d12d68d3770edc1baad808c40bb5fd4 -->
    Loom-Trace-Id: a8e453124b899b440f42c9d83837c7b6
    Loom-Build: unknown b34a08286a42f47f917ec46647d4d167c1f5207c clean
    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
2026-10-03 chore: resync installed Loom surfaces
    <!-- loom:provenance v1 build=unknown 3437cece5ab759f772122f8d18a6d2f05d246cde clean prompts=none sweep=none story=none trace=1bd6b75d1c0daff2b433adf5999546a3 host=loom-worker-1 base=7955d42dcf8d15c69b6a0415d24e3010fb86693d run=loom-run/v1:timer:loom-worker-1/fleet-resync:4c0abac1c29646eaa8502afa223bdd2b installs=0.19.624 0162badc662fb30c070e70611aa8ff74a8486d54 -->
    Loom-Trace-Id: 1bd6b75d1c0daff2b433adf5999546a3
    Loom-Build: unknown 3437cece5ab759f772122f8d18a6d2f05d246cde clean
    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
2026-10-03 sim: route remaining control scripts through runner.run_deck_raw
    Add an optional timeout_s to run_deck_raw (default: no timeout) and migrate
    the ten control scripts that still carried their own write-deck / ngspice -b /
    write-log block, preserving each script's timeout and wrdata handling. Deck
    text is produced by the same compose functions and is unchanged.
    Loom-Story: 2AMLogic/gf180-temp-por#326
    Loom-Trace-Id: 5f84d12f2e46c99dbed3b9d6d38dccf2
    Loom-Build: 0.19.613 d6f32c257ca7cce3da20ff97d432b09c5b74a4c8 clean
2026-10-03 chore: resync installed Loom surfaces
    <!-- loom:provenance v1 build=unknown 3437cece5ab759f772122f8d18a6d2f05d246cde clean prompts=none sweep=none story=none trace=bba21427f750636f851279cfae92b4e5 host=loom-worker-1 base=8124be950ffc15d765b84eb93a8cea91350684ad run=loom-run/v1:timer:loom-worker-1/fleet-resync:9440cda9476f404caa282e360a81ee03 installs=0.19.636 e41edfbb52c13982f7d8b0577f42957427a6514c -->
    Loom-Trace-Id: bba21427f750636f851279cfae92b4e5
    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
2026-10-03 chore: resync installed Loom surfaces
    <!-- loom:provenance v1 build=unknown 28040ed11a4369e20f3b7b0154a3fb2a2c35d38c clean prompts=none sweep=none story=none trace=0cd87d01c45d97a2ee57a99363fc0db2 host=robb-studio base=97c3fe4117050b477c4c4d9df9df0289c9ef8189 run=loom-run/v1:timer:robb-studio/fleet-resync:74b93657-6b04-4ac5-bc77-e0a1682b0595 installs=0.19.636 e41edfbb52c13982f7d8b0577f42957427a6514c -->
    Loom-Trace-Id: 0cd87d01c45d97a2ee57a99363fc0db2
    Loom-Build: unknown 28040ed11a4369e20f3b7b0154a3fb2a2c35d38c clean
    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
2026-10-03 chore: resync installed Loom surfaces
    <!-- loom:provenance v1 build=unknown 388c7fe0cad997f7a887f70c9f2cfe8781a2d512 clean prompts=none sweep=none story=none trace=2046ffd42f138a06b914f34851de3440 host=loom-worker-2 base=46d31ef378f8d97638dd8a64625cf7fce3943676 run=loom-run/v1:timer:loom-worker-2/fleet-resync:17c9456bb1934c70a545b12081496cce installs=0.19.647 d1fe5dead4202be12a964ab891fd5980e7836170 -->
    Loom-Trace-Id: 2046ffd42f138a06b914f34851de3440
    Loom-Build: unknown 388c7fe0cad997f7a887f70c9f2cfe8781a2d512 clean
    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
2026-10-03 chore: resync installed Loom surfaces
    <!-- loom:provenance v1 build=unknown 8078c29e691123d91cd761a786f99cfd25f1809d clean prompts=none sweep=none story=none trace=45869a6374635c036a11a6f379fe31a4 host=robb-pro base=be140236651d06a62db03a8384abba444cc2177c run=loom-run/v1:timer:robb-pro/fleet-resync:b0a94991-052d-4e7d-ba2b-78b971096849 installs=0.19.647 709ca4396e074e5a4d1c5e19721f6ddac7154ca2 -->
    Loom-Trace-Id: 45869a6374635c036a11a6f379fe31a4
    Loom-Build: unknown 8078c29e691123d91cd761a786f99cfd25f1809d clean
    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
2026-10-03 chore: resync installed Loom surfaces
    <!-- loom:provenance v1 build=unknown f9cba29b0602624a23daa17ae04d31d82e10fa91 clean prompts=none sweep=none story=none trace=754b3688f97b6c34894d8cfbf272b81a host=loom-worker-1 base=676d7d61b36143eced2eb75d9d0734564ccb2bba run=loom-run/v1:script:loom-worker-1/fleet-resync:11eb117a-9ff3-4411-88d4-fdd7d6748639 installs=0.19.649 6f2f13b1c31ce420e2250ae040d8e1050c0e761b -->
    Loom-Trace-Id: 754b3688f97b6c34894d8cfbf272b81a
    Loom-Build: unknown f9cba29b0602624a23daa17ae04d31d82e10fa91 clean
    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
2026-10-03 chore: resync installed Loom surfaces
    <!-- loom:provenance v1 build=unknown f9cba29b0602624a23daa17ae04d31d82e10fa91 clean prompts=none sweep=none story=none trace=544a028e3829d4020b8aaa144e5fa628 host=robb-studio base=0ba573c17471df9fcbbdf794e2588367719a34bc run=loom-run/v1:script:robb-studio/fleet-resync:5b5b8b83-7139-447d-88bd-417dcf375aa6 installs=0.19.649 6f2f13b1c31ce420e2250ae040d8e1050c0e761b -->
    Loom-Trace-Id: 544a028e3829d4020b8aaa144e5fa628
    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
2026-10-03 chore: resync installed Loom surfaces
    <!-- loom:provenance v1 build=unknown f9cba29b0602624a23daa17ae04d31d82e10fa91 clean prompts=none sweep=none story=none trace=1057aaaf811f6dd2d64a3bb6d4b3ac49 host=robb-pro base=456055cf3d89d497a5235e0237954a02a2b32d0e run=loom-run/v1:timer:robb-pro/fleet-resync:785c1ea0-d7f2-4810-99e9-cd9368aebe0c installs=0.19.649 2118aabb5a925f1ec4669b4d3d31176a46d8f2a6 -->
    Loom-Trace-Id: 1057aaaf811f6dd2d64a3bb6d4b3ac49
    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
2026-10-03 chore: resync installed Loom surfaces
    <!-- loom:provenance v1 build=unknown 72f61d9aa0fe08f1ef59f1a97a314e474455801e clean prompts=none sweep=none story=none trace=577d2185973ec59f059fa15bf5b5e514 host=loom-worker-1 base=ec0bfd4fb6e9f67e4ab77001ab1578e37a4d4f0e run=loom-run/v1:script:loom-worker-1/fleet-resync:5728a930-137f-4d2f-a962-1cdd7a6a1d46 installs=0.19.652 235a64727b907d65529151af0a962b14f16462a0 -->
    Loom-Trace-Id: 577d2185973ec59f059fa15bf5b5e514
    Loom-Build: unknown 72f61d9aa0fe08f1ef59f1a97a314e474455801e clean
    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
2026-10-03 chore: resync installed Loom surfaces
    <!-- loom:provenance v1 build=unknown 72f61d9aa0fe08f1ef59f1a97a314e474455801e clean prompts=none sweep=none story=none trace=845aaa0eb340f80f12095e2e8b421ed1 host=robb-pro base=19f9b0f7a27703a9b63555fdbbe8cff8e045b125 run=loom-run/v1:script:robb-pro/fleet-resync:344add4b-df8a-49e8-8563-2765673acc76 installs=0.19.652 235a64727b907d65529151af0a962b14f16462a0 -->
    Loom-Trace-Id: 845aaa0eb340f80f12095e2e8b421ed1
    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
2026-10-03 chore: resync installed Loom surfaces
    <!-- loom:provenance v1 build=unknown 61870b40779d205c1555e801c6e1d95df083cdea clean prompts=none sweep=none story=none trace=cfd2c16d2cd3651ad0d068a28bbf62b8 host=loom-worker-1 base=34a5f8d04901806fd10e8c55ff8749b476237db7 run=loom-run/v1:timer:loom-worker-1/fleet-resync:fd27683751ca428cb28a8d58a04fc51a installs=0.19.652 235a64727b907d65529151af0a962b14f16462a0 -->
    Loom-Trace-Id: cfd2c16d2cd3651ad0d068a28bbf62b8
    Loom-Build: unknown 61870b40779d205c1555e801c6e1d95df083cdea clean
    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
2026-10-03 chore: resync installed Loom surfaces
    <!-- loom:provenance v1 build=unknown 61870b40779d205c1555e801c6e1d95df083cdea clean prompts=none sweep=none story=none trace=f8c6a615535e3729d749bc44ac28436c host=robb-studio base=54a41fb3e176f4848b8f8cc80dfc36543aa62c1b run=loom-run/v1:script:robb-studio/fleet-resync:66678e69-bbef-41df-8a24-1d1ac846c831 installs=0.19.652 235a64727b907d65529151af0a962b14f16462a0 -->
    Loom-Trace-Id: f8c6a615535e3729d749bc44ac28436c
    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
2026-10-03 chore: resync installed Loom surfaces
    <!-- loom:provenance v1 build=unknown 21130104346fe9c464ce8a3fdf82c1d3e9667639 clean prompts=none sweep=none story=none trace=36308fff5a3c323c3d1bf6fffb6cd122 host=robb-studio base=594a091fa306d8b4d6e102a8abb2290a67bd05c9 run=loom-run/v1:timer:robb-studio/fleet-resync:89972fbd-0774-4402-bbb7-26c33a851735 installs=0.19.652 fb69233bd8f1dfc2bdee37d8b934f99274dc0193 -->
    Loom-Trace-Id: 36308fff5a3c323c3d1bf6fffb6cd122
    Loom-Build: unknown 21130104346fe9c464ce8a3fdf82c1d3e9667639 clean
    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
2026-10-04 chore: resync installed Loom surfaces
    <!-- loom:provenance v1 build=unknown 61870b40779d205c1555e801c6e1d95df083cdea clean prompts=none sweep=none story=none trace=fb9213e215442932d2af05f3b14977de host=robb-pro base=88f511d988efdfb8080a35d68ca7579887f74378 run=loom-run/v1:timer:robb-pro/fleet-resync:4c70cd1d-08cd-4add-8e2a-9a75160d163f installs=0.19.655 36c39e3c6f56e1979647ec235b4bd19c77db22f3 -->
    Loom-Trace-Id: fb9213e215442932d2af05f3b14977de
    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
2026-10-04 chore: resync installed Loom surfaces
    <!-- loom:provenance v1 build=unknown 61870b40779d205c1555e801c6e1d95df083cdea clean prompts=none sweep=none story=none trace=baa6c2cfcae1a320917c00ff2eb8b630 host=loom-worker-2 base=9c6b17ef93017ff49e622ebaf3ecbe80a141792c run=loom-run/v1:timer:loom-worker-2/fleet-resync:741a7f0f16df4fb1be4e657aeacd1244 installs=0.19.655 fc667a4faae1227f8a6837431f8a0c2d0aeaa7dd -->
    Loom-Trace-Id: baa6c2cfcae1a320917c00ff2eb8b630
    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
2026-10-04 chore: resync installed Loom surfaces
    <!-- loom:provenance v1 build=unknown b922acb2ac655cbccd71daa9e3f05a325a094ca5 clean prompts=none sweep=none story=none trace=833eeb34d4ca65c3f8c6f7824ddca3a3 host=robb-studio base=b0981802d0d13bf3493f6f63ffe83b564e1e7a24 run=loom-run/v1:timer:robb-studio/fleet-resync:0d44f6dc-6a62-4d43-b49d-7cfdd7dbd823 installs=0.19.663 0a51e373e7fe1be156c5774b2c827d4b745368a3 -->
    Loom-Trace-Id: 833eeb34d4ca65c3f8c6f7824ddca3a3
    Loom-Build: unknown b922acb2ac655cbccd71daa9e3f05a325a094ca5 clean
    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
2026-10-04 chore: resync installed Loom surfaces
    <!-- loom:provenance v1 build=unknown 746ecb5f9d7e64ba1d2526f1e997530ad4f3dd43 clean prompts=none sweep=none story=none trace=f09501431241df2ec5688e334ba43dfe host=loom-worker-2 base=c2f8c1e66dd99e3469cca919953a4f2a02c79c74 run=loom-run/v1:timer:loom-worker-2/fleet-resync:70797dad61fb4e21806716d54f1ce910 installs=0.19.669 59a1f84e3742827a8033bb153ebbedc1759bee72 -->
    Loom-Trace-Id: f09501431241df2ec5688e334ba43dfe
    Loom-Build: unknown 746ecb5f9d7e64ba1d2526f1e997530ad4f3dd43 clean
    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
2026-10-04 chore: resync installed Loom surfaces
    <!-- loom:provenance v1 build=unknown 8080d0485cc1312129ee642b084944c56d1be074 clean prompts=none sweep=none story=none trace=ed180bcab6828041123ad54d8ddb4037 host=robb-pro base=f8c1118d6cff7556d5562d33e12ed7f8fbd2b101 run=loom-run/v1:timer:robb-pro/fleet-resync:e97b2f08-4ad9-4b66-a166-5b19820e2d1f installs=0.19.669 59a1f84e3742827a8033bb153ebbedc1759bee72 -->
    Loom-Trace-Id: ed180bcab6828041123ad54d8ddb4037
    Loom-Build: unknown 8080d0485cc1312129ee642b084944c56d1be074 clean
    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
2026-10-04 chore: resync installed Loom surfaces
    <!-- loom:provenance v1 build=unknown 83cb6647167ffc000d2c2f479b4e816b68f863f4 clean prompts=none sweep=none story=none trace=ccabffa1e1ba495895b262086030816c host=robb-studio base=cded3b39db7630335dd48f91cddf9347f095ca35 run=loom-run/v1:timer:robb-studio/fleet-resync:88a78f1f-d978-47b5-99c3-2aabde811d17 installs=0.19.676 cd4f30bd892ea2595d8218b08150633504b0dd14 -->
    Loom-Trace-Id: ccabffa1e1ba495895b262086030816c
    Loom-Build: unknown 83cb6647167ffc000d2c2f479b4e816b68f863f4 clean
    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
2026-10-04 chore: resync installed Loom surfaces
    <!-- loom:provenance v1 build=unknown 32174d0f7e80508fa66c1a11a2c0fb28c515607e clean prompts=none sweep=none story=none trace=436d7c19b10cd5807625a7ce7190a82f host=loom-worker-2 base=4b871a434382e26dff4a475801a21613d731a91e run=loom-run/v1:timer:loom-worker-2/fleet-resync:19ae50771cc04d8db7b1403c1e66bbea installs=0.19.682 9eccfa110fa294fa32a62ffe8eff669cfcf1a3a6 -->
    Loom-Trace-Id: 436d7c19b10cd5807625a7ce7190a82f
    Loom-Build: unknown 32174d0f7e80508fa66c1a11a2c0fb28c515607e clean
    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
2026-10-04 chore: resync installed Loom surfaces
    <!-- loom:provenance v1 build=unknown 72290fa960e0773b2c50d74042e24914c7327637 clean prompts=none sweep=none story=none trace=f7b6952a649a174398a48b90b6ab4793 host=robb-pro base=fdc34653394a8e7fb84d3a46275e230a28982c02 run=loom-run/v1:timer:robb-pro/fleet-resync:72f32482-5cc4-4b38-ab9e-4d2ef0b64e94 installs=0.19.684 bdb8fb331eb51c7def4cdd2c38b611af06f25f6d -->
    Loom-Trace-Id: f7b6952a649a174398a48b90b6ab4793
    Loom-Build: unknown 72290fa960e0773b2c50d74042e24914c7327637 clean
    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
2026-10-04 chore: resync installed Loom surfaces
    <!-- loom:provenance v1 build=unknown 76cda58637be0e74c4cb5b4c8dbc2000e2a9c3d4 clean prompts=none sweep=none story=none trace=614cbada5ce873c2b34a511816309cfc host=robb-studio base=4d8d9ac0fb227b5f37ee8f3517215a2a5cfd2d7d run=loom-run/v1:timer:robb-studio/fleet-resync:7e559a3b-ffdd-409b-8dd2-ae906a273b0a installs=0.19.692 d4974b9f5ff7843a3cfc06378ea2a69bc120e0f4 -->
    Loom-Trace-Id: 614cbada5ce873c2b34a511816309cfc
    Loom-Build: unknown 76cda58637be0e74c4cb5b4c8dbc2000e2a9c3d4 clean
    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
2026-10-04 chore: resync installed Loom surfaces
    <!-- loom:provenance v1 build=unknown f84bac5c232c093f83c1adc2533d8c75b021cda2 clean prompts=none sweep=none story=none trace=e687830614e4bd1c551ab6cf6186f8f3 host=loom-worker-2 base=ea86af663502aee23af8b13f48a0e5d8e605cf8a run=loom-run/v1:timer:loom-worker-2/fleet-resync:2db2c4373ac24de1b7a364e69eaea1ca installs=0.19.695 b0d5b09f207fda439390ea1dd249ad10e7009dfc -->
    Loom-Trace-Id: e687830614e4bd1c551ab6cf6186f8f3
    Loom-Build: unknown f84bac5c232c093f83c1adc2533d8c75b021cda2 clean
    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
2026-10-04 chore: resync installed Loom surfaces
    <!-- loom:provenance v1 build=unknown ac5c275d1c616a9723e747f5a66de93dc80d3512 clean prompts=none sweep=none story=none trace=c777c3912bd31972e9aa3ccab712ae01 host=loom-worker-1 base=9d414dd74694b20ac28cee7e2cb664d88cdec92a run=loom-run/v1:script:loom-worker-1/fleet-resync:b51a1b33-4958-4408-be36-166e12e8360b installs=0.19.697 ada83a5c7ff66b56b0060ef0be368c9fe56eb3c6 -->
    Loom-Trace-Id: c777c3912bd31972e9aa3ccab712ae01
    Loom-Build: unknown ac5c275d1c616a9723e747f5a66de93dc80d3512 clean
    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
2026-10-04 chore: resync installed Loom surfaces
    <!-- loom:provenance v1 build=unknown a19f642f5c09599c4c64827d81d228eb031be73e clean prompts=none sweep=none story=none trace=34a80e22764eb5055e37faec0eaf65fb host=robb-pro base=fac51b8310a94d6943cf32d81e7119545f1b1ca3 run=loom-run/v1:script:robb-pro/fleet-resync:689be620-3ff2-4ff5-a2ce-f6825f6379e2 installs=0.19.697 ada83a5c7ff66b56b0060ef0be368c9fe56eb3c6 -->
    Loom-Trace-Id: 34a80e22764eb5055e37faec0eaf65fb
    Loom-Build: unknown a19f642f5c09599c4c64827d81d228eb031be73e clean
    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
2026-10-04 chore: resync installed Loom surfaces
    <!-- loom:provenance v1 build=unknown 693bdd794cb34afdefd7f0c4596824cd53078a61 clean prompts=none sweep=none story=none trace=7e7be58c80b40f1ac882b00139fb0ca0 host=robb-pro base=6099a9a63a51fdefd8feba4ba86a132c54df9a8b run=loom-run/v1:timer:robb-pro/fleet-resync:d64fbd6b-5d9b-491d-9e17-742b375bfba7 installs=0.19.698 aa619a1d07e36e8d90ac01fea63dc39285c93567 -->
    Loom-Trace-Id: 7e7be58c80b40f1ac882b00139fb0ca0
    Loom-Build: unknown 693bdd794cb34afdefd7f0c4596824cd53078a61 clean
    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
2026-10-04 chore: resync installed Loom surfaces
    <!-- loom:provenance v1 build=unknown 693bdd794cb34afdefd7f0c4596824cd53078a61 clean prompts=none sweep=none story=none trace=aa18f1ec102a98d77ffc51c9be6ffbb3 host=robb-studio base=477921046e220df4eeb2ee49fbe747f02a16b78c run=loom-run/v1:script:robb-studio/fleet-resync:3cb89ca8-62c2-4a69-8434-c4aaa3b64eaf installs=0.19.698 a58f00e0681c50d6bfc5089d0af4b3715198319f -->
    Loom-Trace-Id: aa18f1ec102a98d77ffc51c9be6ffbb3
    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
2026-10-04 chore: resync installed Loom surfaces
    <!-- loom:provenance v1 build=unknown 7a41c2e69ef89d60ed3bd190b94838021bf18d0f clean prompts=none sweep=none story=none trace=d0f04f38b507d85402723643fcf47197 host=loom-worker-1 base=e9f9dc880d37f11ee11a929c626810e3e5a8d183 run=loom-run/v1:script:loom-worker-1/fleet-resync:8fdc8c1c-f844-4c33-bc80-b424e5b4cf3d installs=0.19.703 89d5a428c652f957d7fad8a546589042d39911bc -->
    Loom-Trace-Id: d0f04f38b507d85402723643fcf47197
    Loom-Build: unknown 7a41c2e69ef89d60ed3bd190b94838021bf18d0f clean
    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
2026-10-05 chore: resync installed Loom surfaces
    <!-- loom:provenance v1 build=unknown ebb37db560de172930e261675a35bd52e429f650 clean prompts=none sweep=none story=none trace=a40e86a64366c7a1e36aea026901334f host=loom-worker-2 base=fc9adde0cbbc262dce6038961f51fae11c2a22a4 run=loom-run/v1:script:loom-worker-2/fleet-resync:90b6cd74-6cc0-4f58-98ee-6ede0ac6f50c installs=0.19.703 f63c3c82e6bf202f2ca7b205b532f681c5ebb2c8 -->
    Loom-Trace-Id: a40e86a64366c7a1e36aea026901334f
    Loom-Build: unknown ebb37db560de172930e261675a35bd52e429f650 clean
    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
2026-10-05 chore: resync installed Loom surfaces
    <!-- loom:provenance v1 build=unknown 7a41c2e69ef89d60ed3bd190b94838021bf18d0f clean prompts=none sweep=none story=none trace=fc04851db12f586b5d58155325131b6e host=robb-studio base=82dc86621affb4bb05c7dda07a0fadd4058d722c run=loom-run/v1:timer:robb-studio/fleet-resync:a7d5da6f-a896-4d6f-8d00-aebf47f9b266 installs=0.19.703 2ad9a08fb93de4d7dfac9d2b501d12c684c9c2cc -->
    Loom-Trace-Id: fc04851db12f586b5d58155325131b6e
    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
2026-10-05 chore: resync installed Loom surfaces
    <!-- loom:provenance v1 build=unknown afe7e99e397c242cc319fa80702fb3b23e23f5a7 clean prompts=none sweep=none story=none trace=e46782e1dd9c94461b4cf934ce05296b host=loom-worker-2 base=0c4becc9f1c484760a688576c059d08a640311f2 run=loom-run/v1:timer:loom-worker-2/fleet-resync:caa89259b1fd414ebd2f07500621166d installs=0.19.703 972fe7321be6a9efe2653579379ea3bc40b899b2 -->
    Loom-Trace-Id: e46782e1dd9c94461b4cf934ce05296b
    Loom-Build: unknown afe7e99e397c242cc319fa80702fb3b23e23f5a7 clean
    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
2026-10-05 chore: resync installed Loom surfaces
    <!-- loom:provenance v1 build=unknown b44cb904ebb599db793066ccc631c846862abfbd clean prompts=none sweep=none story=none trace=9590fed7c1b1c9f549ccf3cba24292d7 host=robb-pro base=2bfe90c1492a5d35bb8cde6ef687d49d628b2f0e run=loom-run/v1:timer:robb-pro/fleet-resync:dbc6174e-403d-422d-98b6-73a4b6dbf44f installs=0.19.708 dc8faf1eae3143feda6301887c303b1ee45db7f4 -->
    Loom-Trace-Id: 9590fed7c1b1c9f549ccf3cba24292d7
    Loom-Build: unknown b44cb904ebb599db793066ccc631c846862abfbd clean
    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
2026-10-05 chore: resync installed Loom surfaces
    <!-- loom:provenance v1 build=unknown 4548905848fcb7cb875c1c0518f2fd88eb65818e clean prompts=none sweep=none story=none trace=aff5e139797705f6fa0811f102ecd103 host=loom-worker-1 base=359438988833c68b3cbb2b95cde2e75202e9a5bb run=loom-run/v1:timer:loom-worker-1/fleet-resync:ba6a9e5686a64abaa842d71acaeae2ca installs=0.19.718 00d99344506bcf00e1aec7e910abe3d13df2d240 -->
    Loom-Trace-Id: aff5e139797705f6fa0811f102ecd103
    Loom-Build: unknown 4548905848fcb7cb875c1c0518f2fd88eb65818e clean
    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
2026-10-05 chore: resync installed Loom surfaces
    <!-- loom:provenance v1 build=unknown e7efbaa6e7b97a7d72da6032044c67525291f4d1 clean prompts=none sweep=none story=none trace=d74a33a6f35e329b3e795991e790ebfd host=robb-studio base=def3d7223385d399698ebb93301479a7bd11a1f3 run=loom-run/v1:timer:robb-studio/fleet-resync:304f49c8-5b3e-46a9-a557-945b9ae177f0 installs=0.19.718 00d99344506bcf00e1aec7e910abe3d13df2d240 -->
    Loom-Trace-Id: d74a33a6f35e329b3e795991e790ebfd
    Loom-Build: unknown e7efbaa6e7b97a7d72da6032044c67525291f4d1 clean
    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
2026-10-05 chore: resync installed Loom surfaces
    <!-- loom:provenance v1 build=unknown 347b71e65e709d9fd49aba75d3fb67877fc08818 clean prompts=none sweep=none story=none trace=f9653dd318724c98136e7cef63e551ed host=robb-pro base=7a67895cf001a859479f728c88d9250ca39a2e8d run=loom-run/v1:timer:robb-pro/fleet-resync:cdc95970-9fb1-49fa-a0e6-037a3fab2099 installs=0.19.728 991dcebf6f6b2de6571f1d3400bec083498c6438 -->
    Loom-Trace-Id: f9653dd318724c98136e7cef63e551ed
    Loom-Build: unknown 347b71e65e709d9fd49aba75d3fb67877fc08818 clean
    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
2026-10-05 chore: resync installed Loom surfaces
    <!-- loom:provenance v1 build=unknown 5c0d18101f48fecb656f10fa37afa9b09bf41631 clean prompts=none sweep=none story=none trace=ddcf49552af364cbf6e884bd59584c1f host=loom-worker-1 base=1d3b58545fae4a05c3b4bfe974f0ec758f989775 run=loom-run/v1:timer:loom-worker-1/fleet-resync:5eb526a05f244f1985770579e7620ff1 installs=0.19.731 7484b71fce5179a025950e71a82855afaf6fd730 -->
    Loom-Trace-Id: ddcf49552af364cbf6e884bd59584c1f
    Loom-Build: unknown 5c0d18101f48fecb656f10fa37afa9b09bf41631 clean
    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
2026-10-05 chore: resync installed Loom surfaces
    <!-- loom:provenance v1 build=unknown 0b160514b6658e3ab26a71c6525791da25b46fcf clean prompts=none sweep=none story=none trace=311c3eb2c0ab9550d3de38df5523f3d7 host=robb-studio base=b7240ec51bb3a082803c1b4e8595b1d8b6345ca0 run=loom-run/v1:timer:robb-studio/fleet-resync:e6dec631-b42b-4cf2-b854-cc363cfde6e0 installs=0.19.731 d6146becf339a3d4e55e26e8807ac4571213a00b -->
    Loom-Trace-Id: 311c3eb2c0ab9550d3de38df5523f3d7
    Loom-Build: unknown 0b160514b6658e3ab26a71c6525791da25b46fcf clean
    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
2026-10-05 chore: resync installed Loom surfaces
    <!-- loom:provenance v1 build=unknown 5c0d18101f48fecb656f10fa37afa9b09bf41631 clean prompts=none sweep=none story=none trace=f1e8d4c6e73b8eec3e87a8da52e10f2d host=robb-pro base=98a00ce6a41732b1efb27ce4075c02e1f1207941 run=loom-run/v1:timer:robb-pro/fleet-resync:5518fd33-81cb-479f-93f0-287ea4b08876 installs=0.19.732 8592cf72c2d9172ec658f717173b6b18c439d06d -->
    Loom-Trace-Id: f1e8d4c6e73b8eec3e87a8da52e10f2d
    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
2026-10-05 chore: resync installed Loom surfaces
    <!-- loom:provenance v1 build=unknown ca170d11544ef499cc9500a45bbad152edacfbd1 clean prompts=none sweep=none story=none trace=6dcfc713b6a851b40932158c2eeb70af host=loom-worker-3 base=4dac912caf695f5f960e70d04411f99a56353cf1 run=loom-run/v1:timer:loom-worker-3/fleet-resync:20ce0908ea5a468a9e055470104047ed installs=0.19.734 7ba6ea50c36dfdd2b5e2922dd22c65560980a5a2 -->
    Loom-Trace-Id: 6dcfc713b6a851b40932158c2eeb70af
    Loom-Build: unknown ca170d11544ef499cc9500a45bbad152edacfbd1 clean
    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
2026-10-05 chore: resync installed Loom surfaces
    <!-- loom:provenance v1 build=unknown 03f1c42302d15f8a83425a84a4e36ca484f3f625 clean prompts=none sweep=none story=none trace=f1bc879f8aa652d550764ffcd36e27d1 host=loom-worker-1 base=198ddf892654b71ed5622a7dca16236579572517 run=loom-run/v1:timer:loom-worker-1/fleet-resync:f302a3cc8558413492093df510b02418 installs=0.19.734 967abe71d019ce6606018b4e57dee0223b84d96f -->
    Loom-Trace-Id: f1bc879f8aa652d550764ffcd36e27d1
    Loom-Build: unknown 03f1c42302d15f8a83425a84a4e36ca484f3f625 clean
    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
2026-10-05 chore: resync installed Loom surfaces
    <!-- loom:provenance v1 build=unknown ce7557ba58624d48fedbca2bc037dfa8ce3943e7 clean prompts=none sweep=none story=none trace=e1f2558834c47835cd9a53ec8c9a2ffa host=loom-worker-3 base=99794b78f6c1f4308f141342b281ee6d1fd8f860 run=loom-run/v1:timer:loom-worker-3/fleet-resync:50f5f0046e2c4890961b3221bd360247 installs=0.19.734 ba9edb650872e5265eaca0c47f75e3cb828ecad2 -->
    Loom-Trace-Id: e1f2558834c47835cd9a53ec8c9a2ffa
    Loom-Build: unknown ce7557ba58624d48fedbca2bc037dfa8ce3943e7 clean
    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
2026-10-05 chore: resync installed Loom surfaces
    <!-- loom:provenance v1 build=unknown f92eaec38470a7b0732e065f4864faec9a1905d6 clean prompts=none sweep=none story=none trace=07aa020a8179d52651250562e9808b98 host=robb-studio base=6da3e2a827e4482fdd800a28417c3305a579cdb8 run=loom-run/v1:timer:robb-studio/fleet-resync:3b3ebdf2-b5f7-48ed-b7bb-5fb945094061 installs=0.19.734 78f3e99c44d0af6d4598adf7577bb6676baf3e8f -->
    Loom-Trace-Id: 07aa020a8179d52651250562e9808b98
    Loom-Build: unknown f92eaec38470a7b0732e065f4864faec9a1905d6 clean
    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
2026-10-06 chore: resync installed Loom surfaces
    <!-- loom:provenance v1 build=unknown ca170d11544ef499cc9500a45bbad152edacfbd1 clean prompts=none sweep=none story=none trace=fca9c14d74d6d634726f5823c51bc62a host=loom-worker-2 base=f6fb0ded07eb02b1e2d6598f4ff2bbdc1549c4dc run=loom-run/v1:timer:loom-worker-2/fleet-resync:23a23f0878c1494cb720941baddfea81 installs=0.19.741 3cede3920c6b567d5400789187a904970d46b0fb -->
    Loom-Trace-Id: fca9c14d74d6d634726f5823c51bc62a
    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
2026-10-06 chore: resync installed Loom surfaces
    <!-- loom:provenance v1 build=unknown e38a22941348fd8e83d1f4b06130d2a214adfb50 clean prompts=none sweep=none story=none trace=a7fe3a9a1fedfce89846c20f2e98ac31 host=robb-pro base=a1b2f8b803972aaf9af41d76167d014a69c690c5 run=loom-run/v1:timer:robb-pro/fleet-resync:2d770a42-f0e7-4695-abfa-b912e75382e6 installs=0.19.744 8bc5bcce93c4d9721817387afe8b4b6d79f26054 -->
    Loom-Trace-Id: a7fe3a9a1fedfce89846c20f2e98ac31
    Loom-Build: unknown e38a22941348fd8e83d1f4b06130d2a214adfb50 clean
    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
2026-10-06 chore: resync installed Loom surfaces
    <!-- loom:provenance v1 build=unknown f66ea90ff1bdec51aa4c8dc3f4b2e8d26e3dfd2d clean prompts=none sweep=none story=none trace=66d96c3bb00b04fae967865ee02fc4de host=loom-worker-3 base=d1a255aea245ed4996d37bf2f56daf91b0def906 run=loom-run/v1:timer:loom-worker-3/fleet-resync:eb2dceb410e848a19d58f96f678c995e installs=0.19.749 6135634b053dc30ef5aa8e6d733bfe79bb2ac734 -->
    Loom-Trace-Id: 66d96c3bb00b04fae967865ee02fc4de
    Loom-Build: unknown f66ea90ff1bdec51aa4c8dc3f4b2e8d26e3dfd2d clean
    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
2026-10-06 chore: resync installed Loom surfaces
    <!-- loom:provenance v1 build=unknown ade8a2c60cc8370d04d72f331141acb6fb32e121 clean prompts=none sweep=none story=none trace=6245fb88b5bdf9f7ccecb6b2168dc335 host=robb-studio base=ee63e4da7a650382cefbb03cdbff0b018b96ce5c run=loom-run/v1:timer:robb-studio/fleet-resync:b305aed2-1a25-4576-aca7-9b017ac4377e installs=0.19.755 8d97d322e1cb3723988504337089beca73d0511c -->
    Loom-Trace-Id: 6245fb88b5bdf9f7ccecb6b2168dc335
    Loom-Build: unknown ade8a2c60cc8370d04d72f331141acb6fb32e121 clean
    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
2026-10-06 chore: resync installed Loom surfaces
    <!-- loom:provenance v1 build=unknown 2489bb7d5203844b3fbe8efbe007f44aa074685d clean prompts=none sweep=none story=none trace=0b5c9263a55c09e6fbd870b2d9ff5d9b host=loom-worker-2 base=634ae8164b877e822f6ad2788f4669f4ccb44000 run=loom-run/v1:timer:loom-worker-2/fleet-resync:d3f5a5beb1144f72ac8be575767b3e03 installs=0.19.760 3a509582b179d91c2d5b5a65a7ba4650c3c08985 -->
    Loom-Trace-Id: 0b5c9263a55c09e6fbd870b2d9ff5d9b
    Loom-Build: unknown 2489bb7d5203844b3fbe8efbe007f44aa074685d clean
    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
2026-10-06 chore: resync installed Loom surfaces
    <!-- loom:provenance v1 build=unknown 986d16b700174622774ff68af4ef323e8d0e23ba clean prompts=none sweep=none story=none trace=cb518f1f5785c258556383940a46c461 host=loom-worker-1 base=8da5325ddbc33c919df078c1402824e1b45f0383 run=loom-run/v1:timer:loom-worker-1/fleet-resync:97df92c5eca846de85e979810663a94b installs=0.19.765 c6cec65c4f320f11153c72e840e49a5d6a6f1afc -->
    Loom-Trace-Id: cb518f1f5785c258556383940a46c461
    Loom-Build: unknown 986d16b700174622774ff68af4ef323e8d0e23ba clean
    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
2026-10-06 chore: resync installed Loom surfaces
    <!-- loom:provenance v1 build=unknown 85e52221261264d7f7643251de706f00c8db289f clean prompts=none sweep=none story=none trace=a2434124d73d8cca0ca77230fc85adf5 host=robb-pro base=f4f48557e7539e19d66cce4dfa3d9ff313a9c815 run=loom-run/v1:timer:robb-pro/fleet-resync:abffb067-59ed-4a6e-94b6-8cf3500c935c installs=0.19.768 c9f7ca975144d991bce40f492403b8292e8b7fae -->
    Loom-Trace-Id: a2434124d73d8cca0ca77230fc85adf5
    Loom-Build: unknown 85e52221261264d7f7643251de706f00c8db289f clean
    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
2026-10-06 chore: resync installed Loom surfaces
    <!-- loom:provenance v1 build=unknown 31b34ebfd7d4539094523eaa7b56a104bebe5fc0 clean prompts=none sweep=none story=none trace=16fac36f144dc183c71465eb36c89afc host=loom-worker-3 base=948da2f6433c3379a61de5c16f6fcc3b1f33a362 run=loom-run/v1:timer:loom-worker-3/fleet-resync:c763e24590314b918c8ee8df5d2de1db installs=0.19.769 af995a5725fdadf708127f006aa8f248b482d7d7 -->
    Loom-Trace-Id: 16fac36f144dc183c71465eb36c89afc
    Loom-Build: unknown 31b34ebfd7d4539094523eaa7b56a104bebe5fc0 clean
    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
2026-10-06 chore: resync installed Loom surfaces
    <!-- loom:provenance v1 build=unknown 7bed309263b3785eae46a9cbc53b3b24a52b10d2 clean prompts=none sweep=none story=none trace=843adbd5eac450c43d3a2c43da1bf729 host=robb-studio base=b3e7693343aa77506b3cecef8aa95a4dc8836d8d run=loom-run/v1:timer:robb-studio/fleet-resync:f83d5ba4-81f7-479a-9768-6af33d4cc825 installs=0.19.783 a9b459e0c2b1916ceb116db33053e7eb0df57e7b -->
    Loom-Trace-Id: 843adbd5eac450c43d3a2c43da1bf729
    Loom-Build: unknown 7bed309263b3785eae46a9cbc53b3b24a52b10d2 clean
    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
2026-10-06 chore: resync installed Loom surfaces
    <!-- loom:provenance v1 build=unknown 07bc40ba9ab0f7dfe7cd0990377b7ac07a52d220 clean prompts=none sweep=none story=none trace=563f186108419cf03cef002a62c3b201 host=loom-worker-2 base=bcccda594cb7eeac1382c80100b48a1b2138c5de run=loom-run/v1:timer:loom-worker-2/fleet-resync:944beccd157a4197b81feafdd19f443e installs=0.19.785 2f0a9dbb4f06053f747b8a5615a3519f8e30b527 -->
    Loom-Trace-Id: 563f186108419cf03cef002a62c3b201
    Loom-Build: unknown 07bc40ba9ab0f7dfe7cd0990377b7ac07a52d220 clean
    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
2026-10-06 chore: resync installed Loom surfaces
    <!-- loom:provenance v1 build=unknown 31b34ebfd7d4539094523eaa7b56a104bebe5fc0 clean prompts=none sweep=none story=none trace=ea6600df41a4b420b6d8e967f839ccfd host=loom-worker-3 base=7c5fa57b4a082478d19cbe97f356425654bbc4d3 run=loom-run/v1:timer:loom-worker-3/fleet-resync:c80415b48fd5404bbd599c4f6cc8a448 installs=0.19.793 7ceff96944c39d33e3c2f1141ca650c2c4c05679 -->
    Loom-Trace-Id: ea6600df41a4b420b6d8e967f839ccfd
    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
2026-10-06 chore: resync installed Loom surfaces
    <!-- loom:provenance v1 build=unknown 596a53e525683919daae1b43e6babe9bf847a02f clean prompts=none sweep=none story=none trace=b9c0cb42a5a72ecc21726229c957ef1f host=loom-worker-2 base=f6bb48d4c821c2263d5e1b396f76bf816c4274e0 run=loom-run/v1:timer:loom-worker-2/fleet-resync:21d578f5cc0b4b7ba5f10759f5f30ae8 installs=0.19.801 524bdb33cb26c8355454d7550413c89e72c06fae -->
    Loom-Trace-Id: b9c0cb42a5a72ecc21726229c957ef1f
    Loom-Build: unknown 596a53e525683919daae1b43e6babe9bf847a02f clean
    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
2026-10-06 chore: resync installed Loom surfaces
    <!-- loom:provenance v1 build=unknown 40b591a33adb895d4f46977105f9b264d8a2599b clean prompts=none sweep=none story=none trace=e41c725fe0c176312eb412bc69fe5b01 host=robb-studio base=876dfa52ebe0cbffa07634d615c14ed49b1b58e0 run=loom-run/v1:timer:robb-studio/fleet-resync:37d704dd-4dfd-4341-adb4-6551637ad147 installs=0.19.802 72ce1f7385747dd773d1644408ec22072b8a5d20 -->
    Loom-Trace-Id: e41c725fe0c176312eb412bc69fe5b01
    Loom-Build: unknown 40b591a33adb895d4f46977105f9b264d8a2599b clean
    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
2026-10-06 chore: resync installed Loom surfaces
    <!-- loom:provenance v1 build=unknown 31b34ebfd7d4539094523eaa7b56a104bebe5fc0 clean prompts=none sweep=none story=none trace=5ad0480c4b21b80f9c852c448319e7a1 host=loom-worker-3 base=68a238961c65f1147197b63af71bd5866a68bdd7 run=loom-run/v1:timer:loom-worker-3/fleet-resync:48e836f11f9547ddb96de5aa0d072a05 installs=0.19.810 933f828e779602e492e4e157812988a4b8128111 -->
    Loom-Trace-Id: 5ad0480c4b21b80f9c852c448319e7a1
    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
2026-10-07 chore: resync installed Loom surfaces
    <!-- loom:provenance v1 build=unknown f71cf25de9e75bae6060da4a599df8fbabe75890 clean prompts=none sweep=none story=none trace=64943e35511da4833bbd385cf288be8a host=loom-worker-2 base=75e23f8bc26ecb8e6fd4bf942fbd38620b82b420 run=loom-run/v1:timer:loom-worker-2/fleet-resync:d69eb1b87d4849ae810a145b1b667d2f installs=0.19.822 1c6969ea8726c800a353c236d9f23456a5706f1a -->
    Loom-Trace-Id: 64943e35511da4833bbd385cf288be8a
    Loom-Build: unknown f71cf25de9e75bae6060da4a599df8fbabe75890 clean
    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
2026-10-07 chore: resync installed Loom surfaces
    <!-- loom:provenance v1 build=unknown 31b34ebfd7d4539094523eaa7b56a104bebe5fc0 clean prompts=none sweep=none story=none trace=cb192cb8f72cf6f2711f73f7ee12bebc host=loom-worker-3 base=40dd992a7b76e2bf425b6e19f5fefede0a261a23 run=loom-run/v1:timer:loom-worker-3/fleet-resync:c1e385c3607e43ad8bed9c7d29811c66 installs=0.19.830 a966f7b89b714704fa1225b96e2dbee50480a4c6 -->
    Loom-Trace-Id: cb192cb8f72cf6f2711f73f7ee12bebc
    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
2026-10-07 docs: align README with current extraction and ERC evidence
2026-10-07 chore: resync installed Loom surfaces
    <!-- loom:provenance v1 build=unknown 8abdd34fddc879aff407380278baa713eca6b758 clean prompts=none sweep=none story=none trace=ea945665dad5ccb3880de51c4448e8b9 host=robb-pro base=d8504fd7451a9c377d7f47438956726f9120b25b run=loom-run/v1:timer:robb-pro/fleet-resync:1466e397-b80c-46ea-a42c-26a7fbd4e00e installs=0.19.831 61814c9c1912925cdff7418842ff3ea17cd56fe4 -->
    Loom-Trace-Id: ea945665dad5ccb3880de51c4448e8b9
    Loom-Build: unknown 8abdd34fddc879aff407380278baa713eca6b758 clean
    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
2026-10-07 chore: resync installed Loom surfaces
    <!-- loom:provenance v1 build=unknown 628be5bb140bcff803d159201bd61e1b868901b0 clean prompts=none sweep=none story=none trace=093df1dc315c5e78dcccfca9d699d5f5 host=loom-worker-2 base=285a805ac3ace6f845f40491f7b394e4779085c1 run=loom-run/v1:timer:loom-worker-2/fleet-resync:0b0ea5e184c0429a9c431fcca6c791ad installs=0.19.832 1a0fc15974bf0575a9155fb8276f7529fc813542 -->
    Loom-Trace-Id: 093df1dc315c5e78dcccfca9d699d5f5
    Loom-Build: unknown 628be5bb140bcff803d159201bd61e1b868901b0 clean
    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
2026-10-07 chore: resync installed Loom surfaces
    <!-- loom:provenance v1 build=unknown 069e3b45d86c08f0d60c8fc2b0096de441e99bdc clean prompts=none sweep=none story=none trace=b1ba9d6b2b581e47827d9c099f717b04 host=loom-worker-1 base=28791306cc294ea9be41d6d9de075119a49f4b2f run=loom-run/v1:timer:loom-worker-1/fleet-resync:aada8278bd4843bcaecce69fdf91251e installs=0.19.837 9504f1e9b05e05ce908dd5cffad2aae723621f63 -->
    Loom-Trace-Id: b1ba9d6b2b581e47827d9c099f717b04
    Loom-Build: unknown 069e3b45d86c08f0d60c8fc2b0096de441e99bdc clean
    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
2026-10-07 chore: resync installed Loom surfaces
    <!-- loom:provenance v1 build=unknown 31b34ebfd7d4539094523eaa7b56a104bebe5fc0 clean prompts=none sweep=none story=none trace=ef030e94bce76f728497f5927960865f host=loom-worker-3 base=13626cf83af89d24dfea3071d22a1e6222b1eac4 run=loom-run/v1:timer:loom-worker-3/fleet-resync:28ba4284bfa446c888b501714eda0509 installs=0.19.840 59b533a2a1ed5e186fbf8446b5acbe42d7231854 -->
    Loom-Trace-Id: ef030e94bce76f728497f5927960865f
    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
2026-10-07 chore: resync installed Loom surfaces
    <!-- loom:provenance v1 build=unknown bc59c70c3412a87b31a0dbe65cd6abf968744328 clean prompts=none sweep=none story=none trace=766033e4e881801f24971d664c490ea3 host=robb-studio base=1fd5afc6b88204a56ce251d40a2d9412c2f886bc run=loom-run/v1:timer:robb-studio/fleet-resync:6b3b079a-890e-4a79-9c3a-0b4bb33ff7c4 installs=0.19.840 59b533a2a1ed5e186fbf8446b5acbe42d7231854 -->
    Loom-Trace-Id: 766033e4e881801f24971d664c490ea3
    Loom-Build: unknown bc59c70c3412a87b31a0dbe65cd6abf968744328 clean
    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
2026-10-07 chore: resync installed Loom surfaces
    <!-- loom:provenance v1 build=unknown a068938e7a6c13759bcb3943e408273a3d352257 clean prompts=none sweep=none story=none trace=76bec863c8f6aff2d49b3aa2be128619 host=robb-pro base=ea5d34b8cfbe8100bdd261c9534b01a3766d7449 run=loom-run/v1:timer:robb-pro/fleet-resync:d9927fc6-ee80-4b6a-ba2b-f13576bd5f9b installs=0.19.846 837b14d7440b89ae8a2cec6d045483ac33659af5 -->
    Loom-Trace-Id: 76bec863c8f6aff2d49b3aa2be128619
    Loom-Build: unknown a068938e7a6c13759bcb3943e408273a3d352257 clean
    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
2026-10-07 chore: resync installed Loom surfaces
    <!-- loom:provenance v1 build=unknown 628be5bb140bcff803d159201bd61e1b868901b0 clean prompts=none sweep=none story=none trace=5a6f676b4652a1a750bbce1386c68d06 host=loom-worker-2 base=d6de107056a20b8a051efb0dbd67be195dda14d6 run=loom-run/v1:timer:loom-worker-2/fleet-resync:bd416e653be04ef4b13353430625e379 installs=0.19.850 3bb4bfc90603b6ad65cabca9b3eb42a59f1a9d3a -->
    Loom-Trace-Id: 5a6f676b4652a1a750bbce1386c68d06
    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
2026-10-07 chore: resync installed Loom surfaces
    <!-- loom:provenance v1 build=unknown 40215645df8a13508180b248b44244dc488bb078 clean prompts=none sweep=none story=none trace=29fde30615e6e47f39b41aa314c2c883 host=loom-worker-1 base=7e7191d388c35959eefec8a7cd89e523fc816498 run=loom-run/v1:timer:loom-worker-1/fleet-resync:d1fbedfcc7824ae59233c0ea94dc4650 installs=0.19.853 2889d5ed585b4da0935543cb916381cc03b19746 -->
    Loom-Trace-Id: 29fde30615e6e47f39b41aa314c2c883
    Loom-Build: unknown 40215645df8a13508180b248b44244dc488bb078 clean
    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
2026-10-07 chore: resync installed Loom surfaces
    <!-- loom:provenance v1 build=unknown 31b34ebfd7d4539094523eaa7b56a104bebe5fc0 clean prompts=none sweep=none story=none trace=cdf49c615da3f5ce46e9fcda1a24f787 host=loom-worker-3 base=58579c1b750932bbe7d7de3eb0eaa0d8564283f4 run=loom-run/v1:timer:loom-worker-3/fleet-resync:cab31e05b8a24df09bc88f53ee3fb501 installs=0.19.857 7a0b529e6f57a79713f6924bf58d8392ff404259 -->
    Loom-Trace-Id: cdf49c615da3f5ce46e9fcda1a24f787
    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
2026-10-07 chore: resync installed Loom surfaces
    <!-- loom:provenance v1 build=unknown 4b44e7c5db0de1d2b5927de7de229120d546aad3 clean prompts=none sweep=none story=none trace=dfa656ee3483a044378501f49d36f812 host=robb-studio base=2003bc23acca2475f24bd17aac1953303cab38b5 run=loom-run/v1:timer:robb-studio/fleet-resync:d80d6bc0-eb68-4a07-8226-2d947d328b3a installs=0.19.859 0aefebd79aba8ab33470f1af4b96847fc794bd0d -->
    Loom-Trace-Id: dfa656ee3483a044378501f49d36f812
    Loom-Build: unknown 4b44e7c5db0de1d2b5927de7de229120d546aad3 clean
    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
2026-10-07 chore: resync installed Loom surfaces
    <!-- loom:provenance v1 build=unknown b591c8cf436f0d4aa5870a9bc7cd5f7194e0e778 dirty prompts=none sweep=none story=none trace=6eca4b0c47205457aae7a3d721c17f17 host=robb-pro base=9a5c5e003481f5ee4247d11c04c53cc6f6366ddc run=loom-run/v1:timer:robb-pro/fleet-resync:64af20b3-58cb-47f2-b770-117197cb41e9 installs=0.19.864 128a7eba2bb5f7bcf8891ba284b14cb7ebf8dd3d -->
    Loom-Trace-Id: 6eca4b0c47205457aae7a3d721c17f17
    Loom-Build: unknown b591c8cf436f0d4aa5870a9bc7cd5f7194e0e778 dirty
    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
2026-10-07 chore: resync installed Loom surfaces
    <!-- loom:provenance v1 build=unknown b551219fd5b8347113c0cbc79ea416e81c39fa9d clean prompts=none sweep=none story=none trace=5ac7c8c62dad54841e21dd94f0920de3 host=loom-worker-2 base=696d19291552469fc99fe20d639cf86a729335cd run=loom-run/v1:timer:loom-worker-2/fleet-resync:d10fb10789e94930ab1af368c15a8f8b installs=0.19.864 128a7eba2bb5f7bcf8891ba284b14cb7ebf8dd3d -->
    Loom-Trace-Id: 5ac7c8c62dad54841e21dd94f0920de3
    Loom-Build: unknown b551219fd5b8347113c0cbc79ea416e81c39fa9d clean
    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
2026-10-07 chore: resync installed Loom surfaces
    <!-- loom:provenance v1 build=unknown 90fbd167e4e376894396e651676cf58fc9aa223a clean prompts=none sweep=none story=none trace=196876656e912171b28029ceca9f772d host=loom-worker-1 base=0d7cbf40b730002d44d595100669f6229cccad48 run=loom-run/v1:timer:loom-worker-1/fleet-resync:7b46720ff3a84a8184f2f2b3bc039260 installs=0.19.868 ee904e1c151bc9cf15b0eb55dfe9d57ad6136cff -->
    Loom-Trace-Id: 196876656e912171b28029ceca9f772d
    Loom-Build: unknown 90fbd167e4e376894396e651676cf58fc9aa223a clean
    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
2026-10-08 chore: resync installed Loom surfaces
    <!-- loom:provenance v1 build=unknown 5a3df331a0612dee585ef905015af01d08e3467f clean prompts=none sweep=none story=none trace=5690fa95febe608e500a46dde8a6ee92 host=loom-worker-2 base=c0a8b58e5d17bd50ff49e79f929297238de170ab run=loom-run/v1:timer:loom-worker-2/fleet-resync:5c9c35d59b704bff9d8bf096ee7ba7be installs=0.19.876 b16d54e63fbbec4d7f15f13c1f43a5e5b38145ce -->
    Loom-Trace-Id: 5690fa95febe608e500a46dde8a6ee92
    Loom-Build: unknown 5a3df331a0612dee585ef905015af01d08e3467f clean
    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
2026-10-08 chore: resync installed Loom surfaces
    <!-- loom:provenance v1 build=unknown 134eb3ff06c1a86f49a911c6c17464f55e719736 clean prompts=none sweep=none story=none trace=c7df110d490314040dcd1347b2481843 host=loom-worker-1 base=0fea452810bd509ee19e491ddfa5416da3235bdd run=loom-run/v1:timer:loom-worker-1/fleet-resync:53d0cec2cd61484eb9a0f8fb1f24ac5e installs=0.19.879 c15619905bdd8a24506c3853f45490d26e8f1cad -->
    Loom-Trace-Id: c7df110d490314040dcd1347b2481843
    Loom-Build: unknown 134eb3ff06c1a86f49a911c6c17464f55e719736 clean
    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
2026-10-08 chore: resync installed Loom surfaces
    <!-- loom:provenance v1 build=unknown 8f86de23319d8f6cf049557dcc9cf2e321211d9d clean prompts=none sweep=none story=none trace=17de45f778fbfd714af8afad02c96375 host=loom-worker-3 base=3770aa0666d1fa8370e75119a1f620a06037707e run=loom-run/v1:timer:loom-worker-3/fleet-resync:9e3e5d4a08824de3b7bc02940be2a0da installs=0.19.882 c9f85af3d967986cdd7a3f27e088a16f88712b05 -->
    Loom-Trace-Id: 17de45f778fbfd714af8afad02c96375
    Loom-Build: unknown 8f86de23319d8f6cf049557dcc9cf2e321211d9d clean
    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
2026-10-08 chore: resync installed Loom surfaces
    <!-- loom:provenance v1 build=unknown 4a5fb2b6276e17ff26ee1382acfe2ea7360ebea5 clean prompts=none sweep=none story=none trace=67857e1b7189785825a2dfc70921cf85 host=loom-worker-2 base=d7497986d6dcbaa85279b5c5b66d8b9facfc446f run=loom-run/v1:timer:loom-worker-2/fleet-resync:dd6a5f3dceff4d8d8602a07a1dc89c95 installs=0.19.892 ce93e8a919d79a6f027bab268846a52084f9d94e -->
    Loom-Trace-Id: 67857e1b7189785825a2dfc70921cf85
    Loom-Build: unknown 4a5fb2b6276e17ff26ee1382acfe2ea7360ebea5 clean
    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
2026-10-08 chore: resync installed Loom surfaces
    <!-- loom:provenance v1 build=unknown b591c8cf436f0d4aa5870a9bc7cd5f7194e0e778 dirty prompts=none sweep=none story=none trace=28e7ca5fdb768489aa38bf002407d5a5 host=robb-pro base=8506a70f99f8b9ab02a79360fc8ac35be04b519b run=loom-run/v1:timer:robb-pro/fleet-resync:eb5f838e-a774-4e20-8102-c37ee3ff31ca installs=0.19.895 9b30d293bcba1e79d49cabfc1c5bb5b6f4c0dc77 -->
    Loom-Trace-Id: 28e7ca5fdb768489aa38bf002407d5a5
    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
2026-10-08 chore: resync installed Loom surfaces
    <!-- loom:provenance v1 build=unknown 5684fc8c8ac418d95ad66a002d001eaea1283c9a clean prompts=none sweep=none story=none trace=c864acd3b9a5dbb419fddd8bd2a6283b host=loom-worker-3 base=022e66ae665aae6bf71b1dbd86a561804d68b1c9 run=loom-run/v1:timer:loom-worker-3/fleet-resync:4771e7c630c34445b7f28539669d76e3 installs=0.19.898 3d55b9a1669c132d130d98f10a292c1325322c30 -->
    Loom-Trace-Id: c864acd3b9a5dbb419fddd8bd2a6283b
    Loom-Build: unknown 5684fc8c8ac418d95ad66a002d001eaea1283c9a clean
    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
2026-10-08 sim/harness: fail-closed klt sim batch backend (#331)
    Add sim/harness/klt_batch.py and an explicit batch mode for run_corners.py,
    run_net_attribution.py and run_dwell_sweep.py. Local ngspice stays the
    default. In batch mode decks are re-expressed as klt sim requests, submitted
    with --backend batch, and the returned raw logs are copied byte-for-byte to
    their existing paths. Any submission, report, timeout, missing/duplicate
    result or non-pass outcome is an error and never falls back to a local run.
    Loom-Story: 2AMLogic/gf180-temp-por#331
    Loom-Trace-Id: 3b828fc7b2deeab0d23be5751805b24a
    Loom-Build: 0.19.898 3d55b9a1669c132d130d98f10a292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
    [test_harness.py, test_klt_batch.py]
2026-10-08 sim/harness: close fail-open paths found by live klt batch probes (#331)
    Single-deck probes on the batch fleet turned up three problems in the
    merged klt_batch adapter. This change fixes them.
    - Analysis braces: klt runs the analysis as a .control command, and
    ngspice does not expand .param braces there. `tran 2e-06 {stop_s}`
    (every dwell-sweep deck) therefore aborted with TSTOP=0.
    translate_deck now substitutes the deck's own plain-number .param text
    and refuses expressions, unknown names and lifted parameters before
    submission.
    - Aborted run graded ok: the corner above came back with only
    `measurement` diagnostics, and tolerate_absent=True graded it ok with
    every value missi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
    [test_klt_batch.py]
2026-10-08 characterize: fail the campaign when an experiment is killed by a signal
    A child terminated by a signal reports a negative return code, which
    max(worst, returncode) ignored, so the campaign could print 'all
    experiments passed' and exit 0. Negative codes now aggregate as
    EXIT_SIM_ERROR; the raw code is kept and rendered as 'SIGNAL n' in the
    summary. Sequential execution and positive-code max semantics are
    unchanged. Adds mocked tests (no PDK or ngspice needed).
    Closes #333
    Loom-Story: 2AMLogic/gf180-temp-por#333
    Loom-Trace-Id: 198de348d66ca2d09710e805a34adb99
    Loom-Build: 0.19.898 3d55b9a1669c132d130d98f10a292c1325322c30 clean
    [characterize.py, test_characterize.py]
2026-10-08 signoff: verify supply ERC evidence hashes against current GDS and spec
    Re-hash the GDS and supply spec named by the cited erc_supply.json and
    compare to its recorded provenance hashes; missing inputs or hashes fail.
    Stdlib only; verdict and hashes unchanged.
    Loom-Story: 2AMLogic/gf180-temp-por#334
    Loom-Trace-Id: b7d486d526643da6458ea4ba5b2ddbd0
    Loom-Build: 0.19.868 ee904e1c151bc9cf15b0eb55dfe9d57ad6136cff clean
2026-10-08 signoff: document the ERC freshness gate
    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
2026-10-08 sim harness: reserve record IDs atomically before runs
    Allocation previously only checked for the final summary record, so two
    concurrent runs in the same second at the same commit could pick the same
    ID and share raw-log paths, and an interrupted run's logs were invisible to
    allocation. Writing runs now exclusively create corners/<record-id>/ before
    any simulation starts, existing logs or snapshots occupy an ID, and the
    timestamp advances on collision (ID format unchanged). Snapshot, record,
    and derived-record writes use exclusive creation. --no-write runs reserve
    nothing in the evidence tree and claim their scratch directory exclusively.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
    [test_harness.py]
2026-10-08 fix: reject contradictory or malformed klt batch corner results
    run_units is the validation boundary for klt sim batch reports, but _judge
    only rejected error diagnostics through its status != "pass" branch and
    treated a requested measurement as present whenever its value was not
    None. A corner labelled "pass" with an error-level netlist or timeout
    diagnostic, or carrying a string, boolean, NaN or infinite measurement
    value, could therefore come back "ok" with its raw log copied as an
    accepted result. Malformed nested fields (measurements, diagnostics,
    artifacts, runtime_s, supply_v) could also escape as TypeError/ValueError
    instead of a batch failure.
    _judge now, before any raw log is copi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
    [test_klt_batch.py]
2026-10-08 docs: refresh work log and current proposal backlog
2026-10-08 chore: resync installed Loom surfaces
    <!-- loom:provenance v1 build=unknown 04a1189116c7320def7d9ce357d2d9268405ae92 clean prompts=none sweep=none story=none trace=8e55b27fc60ffb045554bd413ad8f3c8 host=robb-pro base=a6aff8f1239bb6ad4eab24319004a3351587f5a7 run=loom-run/v1:timer:robb-pro/fleet-resync:83b69005-7c5b-44b3-96f8-33f07bf82f4b installs=0.19.917 d3c1ea3a4c81e01ce5487dc3e4bbdd86534e677e -->
    Loom-Trace-Id: 8e55b27fc60ffb045554bd413ad8f3c8
    Loom-Build: unknown 04a1189116c7320def7d9ce357d2d9268405ae92 clean
    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
2026-10-08 signoff: move the T1 grader pin to klt 0.6.0 (item 11 now graded)
    Re-grades existing evidence; produces none. t1_item_count 10 -> 11,
    t1_met_count 3 -> 4 (item 11 met). Items 3, 4, 8 stay met. The block
    manifest is unchanged.
    Also corrects the item 3 coverage disclosure in signoff/README.md to match
    drc.json's own coverage block, and the stale note that item 4 carries no
    content_hash pin (0.6.0 quotes provenance.input).
    Closes #342
    Loom-Story: 2AMLogic/gf180-temp-por#342
    Loom-Trace-Id: 6a62b8ec8766c3f7928eea357cf095dc
    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
2026-10-08 Add make test as the single source of truth for unit-test suites
    make check and npm test skipped the signoff suite that CI runs. Add a
    make test target covering sim, layout and signoff; make check and npm test
    now delegate to it. Add a guard test that every */tests dir is listed, note
    the source of truth in ci.yml, and fix the stale signoff/check.sh reference
    in signoff/toolchain.json (the script is check.py).
    Loom-Story: 2AMLogic/gf180-temp-por#345
    Loom-Trace-Id: 743d32f1293c739d1cbb9b13f2153711
    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
    [test_make_test_lists_suites.py]
2026-10-08 chore: resync installed Loom surfaces
    <!-- loom:provenance v1 build=unknown d2a55ce217b3ad1793611a2c54946676bb55b512 clean prompts=none sweep=none story=none trace=459637e4e8503593bdf58360865a7524 host=robb-pro base=1a2216d49cacb08f684f4b8abe83d5afa222a5bc run=loom-run/v1:timer:robb-pro/fleet-resync:95b3cf92-9cd9-4c36-8bbd-bdcace7c3874 installs=0.19.935 d347079cd0bad2db2c11ee4f0b760f04b2601d21 -->
    Loom-Trace-Id: 459637e4e8503593bdf58360865a7524
    Loom-Build: unknown d2a55ce217b3ad1793611a2c54946676bb55b512 clean
    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
2026-10-08 ci: run the headless checks job on Python 3.9 and 3.11
    README documents python3 >= 3.9 for the stdlib-only harness but CI only
    exercised 3.11, so the floor was unverified. Add a 3.9/3.11 matrix to the
    checks job; the klt grader install and signoff/check.py stay on 3.11.
    The unit-test suites (sim, layout, signoff) and build_tb.py --check were
    verified to pass locally under CPython 3.9.25.
    Loom-Story: 2AMLogic/gf180-temp-por#354
    Loom-Trace-Id: d0cc7653b2b1508bf69c9e101c580e7d
    Loom-Build: 0.19.929 e0381fd31734743649019281f22b12223f853f41 clean
2026-10-09 chore: resync installed Loom surfaces
    <!-- loom:provenance v1 build=unknown 05dba463c5b293d38f0ca071725983862498b3f3 clean prompts=none sweep=none story=none trace=14298316053024bcf5120bff695771ab host=robb-pro base=afd3f1fc7ce095c397388f20f691ad816075646c run=loom-run/v1:timer:robb-pro/fleet-resync:2f384483-6d77-4ba2-9888-aa1e4b5be36c installs=0.19.953 b93d7a955d63411cb4c94b986fd5138d27dedb0f -->
    Loom-Trace-Id: 14298316053024bcf5120bff695771ab
    Loom-Build: unknown 05dba463c5b293d38f0ca071725983862498b3f3 clean
    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
2026-10-09 chore: resync installed Loom surfaces
    <!-- loom:provenance v1 build=unknown 7f06b288b150f2fe0a4b24c331a9b3ec093d709d clean prompts=none sweep=none story=none trace=a90c217ff3a3bd9e3a30282b8cadc24d host=robb-pro base=e42bff22c56028de2c6c53cf9adfc524d160f721 run=loom-run/v1:timer:robb-pro/fleet-resync:6e5ec9f3-d6ef-4953-80f7-c93035e2d359 installs=0.19.966 9bed656320e53ba6c64305daa60613431a7ed02d -->
    Loom-Trace-Id: a90c217ff3a3bd9e3a30282b8cadc24d
    Loom-Build: unknown 7f06b288b150f2fe0a4b24c331a9b3ec093d709d clean
    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
2026-10-09 chore: resync installed Loom surfaces
    <!-- loom:provenance v1 build=unknown 30c7a7ee2f74a6a2b5bb0f19fd9f049ec8ae8b5c clean prompts=none sweep=none story=none trace=7bc5ba399ff199d049d83d711920a157 host=robb-pro base=904b873fd220c77c7e9f4325d0330af01598a059 run=loom-run/v1:timer:robb-pro/fleet-resync:8e237160-c4d0-4ce3-85ac-c96aff5cf221 installs=0.19.982 2bc4cba624b9053535663441e6f0daf08a7acf2e -->
    Loom-Trace-Id: 7bc5ba399ff199d049d83d711920a157
    Loom-Build: unknown 30c7a7ee2f74a6a2b5bb0f19fd9f049ec8ae8b5c clean
    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
2026-10-10 chore: resync installed Loom surfaces
    <!-- loom:provenance v1 build=unknown 03c1cb521a10d5101bd8aa2c52a47cebfb0e795b clean prompts=none sweep=none story=none trace=09ccab293fce5c1a7b4aa907c7197bec host=robb-studio base=76e98f6b1c787795466becb5fd2cf87d5acf735b run=loom-run/v1:timer:robb-studio/fleet-resync:ed2be6c5-20fe-4228-a206-940d35a4858f installs=0.19.996 0d2be7e9ae05753e2c9232a83b7399d45de5396e -->
    Loom-Trace-Id: 09ccab293fce5c1a7b4aa907c7197bec
    Loom-Build: unknown 03c1cb521a10d5101bd8aa2c52a47cebfb0e795b clean
    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
2026-10-10 chore: resync installed Loom surfaces
    <!-- loom:provenance v1 build=unknown a7d2b01d8eb7d09e597a4638e5cb3cdd8bab9156 clean prompts=none sweep=none story=none trace=35c1337ee84607e87ba2038523d63198 host=robb-pro base=183774304f1f85a62934b8bb51e65a30bce42825 run=loom-run/v1:timer:robb-pro/fleet-resync:6bf32a81-6c4a-48c5-a51e-1ad65c6bedfd installs=0.19.999 20513e3064fa3a7c4b3f1c641d97a00446e9ba78 -->
    Loom-Trace-Id: 35c1337ee84607e87ba2038523d63198
    Loom-Build: unknown a7d2b01d8eb7d09e597a4638e5cb3cdd8bab9156 clean
    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
2026-10-10 chore: resync installed Loom surfaces
    <!-- loom:provenance v1 build=unknown c156f673e072832aaacb4cd1ec65b742e7f45867 clean prompts=none sweep=none story=none trace=9de99c124c651049199abe9a75070dc7 host=robb-pro base=4bd3316f3e164a5e972f2949fdc4ef6cac613060 run=loom-run/v1:timer:robb-pro/fleet-resync:f790885c-7154-4b3d-acd9-71fd537cd20b installs=0.19.1010 d1d5fcecb79550fe39658555a4419f98cec060fb -->
    Loom-Trace-Id: 9de99c124c651049199abe9a75070dc7
    Loom-Build: unknown c156f673e072832aaacb4cd1ec65b742e7f45867 clean
    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
2026-10-10 chore: resync installed Loom surfaces
    <!-- loom:provenance v1 build=unknown 52f79668bb5f93c1828b7f1ea4f7013b917b847b clean prompts=none sweep=none story=none trace=7057f3175071f1f6e34b354fab40a0ce host=robb-studio base=bfecc8cf6ea554f210e7c81b33b0db42f0602ad3 run=loom-run/v1:timer:robb-studio/fleet-resync:d8918779-1625-4202-b151-71f64465e8cd installs=0.19.1010 d1d5fcecb79550fe39658555a4419f98cec060fb -->
    Loom-Trace-Id: 7057f3175071f1f6e34b354fab40a0ce
    Loom-Build: unknown 52f79668bb5f93c1828b7f1ea4f7013b917b847b clean
    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
2026-10-10 chore: resync installed Loom surfaces
    <!-- loom:provenance v1 build=unknown 525fe43b7b1b2a0271084bba444c934a1541a8d8 clean prompts=none sweep=none story=none trace=0d4424bd058cf912b74934ec0e7bf37e host=robb-pro base=b925f59484152d79b89a93dd439450df68742f42 run=loom-run/v1:timer:robb-pro/fleet-resync:4812047c-8b9b-4da2-a5dc-13e6f6420a04 installs=0.19.1018 13e54f1cfc513507a7ef84ec6908085638d9c187 -->
    Loom-Trace-Id: 0d4424bd058cf912b74934ec0e7bf37e
    Loom-Build: unknown 525fe43b7b1b2a0271084bba444c934a1541a8d8 clean
    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
2026-10-10 chore: resync installed Loom surfaces
    <!-- loom:provenance v1 build=unknown 525fe43b7b1b2a0271084bba444c934a1541a8d8 clean prompts=none sweep=none story=none trace=d4059def94f46d8d158946acddd4d602 host=robb-studio base=c84ea9cd2d357cdef5aa06fe71237d7ff7e12d9f run=loom-run/v1:timer:robb-studio/fleet-resync:4a4d1995-968e-44c5-b5fe-804b4d477795 installs=0.19.1018 13e54f1cfc513507a7ef84ec6908085638d9c187 -->
    Loom-Trace-Id: d4059def94f46d8d158946acddd4d602
    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
2026-10-10 chore: resync installed Loom surfaces
    <!-- loom:provenance v1 build=unknown 5d5f41d89eef35adf478b92b96af06c6d86d27a6 clean prompts=none sweep=none story=none trace=05d2a40831b35ba1c48afada00c29519 host=robb-pro base=1de1b0a93643b2d90f6c6a7b72749757ac1ef520 run=loom-run/v1:timer:robb-pro/fleet-resync:c58bb82e-a213-439d-b829-04234e141de9 installs=0.19.1027 59bb53f01eb99187ce25f22be1a64da5c877d115 -->
    Loom-Trace-Id: 05d2a40831b35ba1c48afada00c29519
    Loom-Build: unknown 5d5f41d89eef35adf478b92b96af06c6d86d27a6 clean
    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
2026-10-10 chore: resync installed Loom surfaces
    <!-- loom:provenance v1 build=unknown aa536103d6239818bb974a51d2f7f268eff38bad clean prompts=none sweep=none story=none trace=126a1328a3664e2119a0978086db9bea host=robb-studio base=34a631b76ea8b36c6104a74e5b5c2570b2f01a0b run=loom-run/v1:timer:robb-studio/fleet-resync:fbc4e361-e290-4d81-ae3a-8b5fde796815 installs=0.19.1031 286d609f09342e7c84f2e23771edbac5b1914659 -->
    Loom-Trace-Id: 126a1328a3664e2119a0978086db9bea
    Loom-Build: unknown aa536103d6239818bb974a51d2f7f268eff38bad clean
    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
2026-10-11 chore: resync installed Loom surfaces
    <!-- loom:provenance v1 build=unknown cf08873555e2eb95da295dcbee98b0dc34473381 clean prompts=none sweep=none story=none trace=67fbc483c3ca3e442d7928804c11ff06 host=robb-pro base=5939d30dcc0652fd88aa98bae0dbbf04b681c196 run=loom-run/v1:timer:robb-pro/fleet-resync:e3f97888-2b26-404a-bd47-86fd28a4eced installs=0.19.1041 b65c266b47d796bf37d1c04c6f616be0bc699056 -->
    Loom-Trace-Id: 67fbc483c3ca3e442d7928804c11ff06
    Loom-Build: unknown cf08873555e2eb95da295dcbee98b0dc34473381 clean
    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
2026-10-11 chore: resync installed Loom surfaces
    <!-- loom:provenance v1 build=unknown e91831edf7b55b29d3a2d88e266916fab9ce2563 clean prompts=none sweep=none story=none trace=f72dd67520a2c3802aa0495b80ac65a5 host=robb-studio base=e3e01e3dd8cf39cfd571c0c522b9b1a61f57a3d3 run=loom-run/v1:timer:robb-studio/fleet-resync:91d2434e-eae5-45de-9305-d78c43fc7c7a installs=0.19.1042 5b6ebdcc40bfccc9357e15196984061f1d5e6178 -->
    Loom-Trace-Id: f72dd67520a2c3802aa0495b80ac65a5
    Loom-Build: unknown e91831edf7b55b29d3a2d88e266916fab9ce2563 clean
    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
2026-10-11 chore: resync installed Loom surfaces
    <!-- loom:provenance v1 build=unknown 5ec729b9f7dd55a2082752611e4c4964f49661fb clean prompts=none sweep=none story=none trace=efc2abc8b72538df6d1a6ea9d329603d host=robb-pro base=99ed609f4b13879a1c24487ef9aec0ee1678fc84 run=loom-run/v1:timer:robb-pro/fleet-resync:0d396c06-f26e-423e-97ac-6d3ac04a8e51 installs=0.19.1054 f6a73bc7fc942d7b297514b2e3f57a0ca2076010 -->
    Loom-Trace-Id: efc2abc8b72538df6d1a6ea9d329603d
    Loom-Build: unknown 5ec729b9f7dd55a2082752611e4c4964f49661fb clean
    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
2026-10-11 chore: resync installed Loom surfaces
    <!-- loom:provenance v1 build=unknown 745f69d0daad6c23e76cc006720fa4fbeaa3d887 clean prompts=none sweep=none story=none trace=3baabc4a039fd85029fff227a6ae690a host=robb-studio base=c7c08f3a00a94ab1cf5601627f59498dff3467b7 run=loom-run/v1:timer:robb-studio/fleet-resync:3b3207d7-055d-49b5-a387-db375213668d installs=0.19.1058 00ceead491dd1ae20db00db16a650ea43dd0c09b -->
    Loom-Trace-Id: 3baabc4a039fd85029fff227a6ae690a
    Loom-Build: unknown 745f69d0daad6c23e76cc006720fa4fbeaa3d887 clean
    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
2026-10-11 chore: resync installed Loom surfaces
    <!-- loom:provenance v1 build=unknown b37a005ac1889262fb9e5338f7cff4e9ed4987da clean prompts=none sweep=none story=none trace=25c158d7e9591610b251780caaff1c5f host=robb-pro base=399958886ad3fd6c0bcfbc2e20d73b85ad118215 run=loom-run/v1:timer:robb-pro/fleet-resync:7f020bca-6920-47f7-a5e4-bbd5c82d9bb8 installs=0.19.1072 29b48db1ead9c4501304e0114a5c33310e1d589f -->
    Loom-Trace-Id: 25c158d7e9591610b251780caaff1c5f
    Loom-Build: unknown b37a005ac1889262fb9e5338f7cff4e9ed4987da clean
    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
2026-10-11 chore: resync installed Loom surfaces
    <!-- loom:provenance v1 build=unknown 81a6b4499cb57b3620785bc1625c300da34f0735 clean prompts=none sweep=none story=none trace=d08bbd290651d7bcbda8b216c0dfbcdf host=robb-studio base=80d63af1539313192e8918e1fefb53c630962f29 run=loom-run/v1:timer:robb-studio/fleet-resync:71e05e3d-931c-46b4-b6d2-5f3f992c1e19 installs=0.19.1073 abb0872ba7d1d3f6f3a14f71f51a562e89308181 -->
    Loom-Trace-Id: d08bbd290651d7bcbda8b216c0dfbcdf
    Loom-Build: unknown 81a6b4499cb57b3620785bc1625c300da34f0735 clean
    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
2026-10-12 chore: resync installed Loom surfaces
    <!-- loom:provenance v1 build=unknown ddfb67ccf9a5115d62dd86924613a468b9328f44 clean prompts=none sweep=none story=none trace=772605234b9d8cafd6a4049200f7425c host=robb-pro base=b4f39bbbcc85b2af86f15ff512fd0327d3f53d88 run=loom-run/v1:timer:robb-pro/fleet-resync:1ef28ffc-0277-424f-9224-7ee6eca46377 installs=0.19.1081 be16cedf6a394661d3b1400531335927f5eb4519 -->
    Loom-Trace-Id: 772605234b9d8cafd6a4049200f7425c
    Loom-Build: unknown ddfb67ccf9a5115d62dd86924613a468b9328f44 clean
    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
2026-10-12 chore: resync installed Loom surfaces
    <!-- loom:provenance v1 build=unknown be358990895362019614bd207bcbe36bc9eeff2c clean prompts=none sweep=none story=none trace=f1dc643b95859c8f26e892ddb5e2c5d7 host=robb-studio base=77d3a9c8025d037d64ccf6fcc078e2085dcf272f run=loom-run/v1:timer:robb-studio/fleet-resync:da486ca2-3e94-4a85-abd3-88707942489a installs=0.19.1086 d8cb20101a985145fb167c1933758075a14ce1ab -->
    Loom-Trace-Id: f1dc643b95859c8f26e892ddb5e2c5d7
    Loom-Build: unknown be358990895362019614bd207bcbe36bc9eeff2c clean
    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
2026-10-12 chore: resync installed Loom surfaces
    <!-- loom:provenance v1 build=unknown a579728c137cc11d08a48b178e0ff9aa21683e72 clean prompts=none sweep=none story=none trace=10832f2750dbcd63f6c6f301a6f4da9b host=loom-worker-2 base=602ef8e47681aa3ac74ec3d30b5d999c9f02c41d run=loom-run/v1:timer:loom-worker-2/fleet-resync:180f6d5054f0479ab3990b86ab4522a5 installs=0.19.1087 51ac271f990b317a52ebf27cc21f34561e1179fb -->
    Loom-Trace-Id: 10832f2750dbcd63f6c6f301a6f4da9b
    Loom-Build: unknown a579728c137cc11d08a48b178e0ff9aa21683e72 clean
    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
2026-10-12 chore: resync installed Loom surfaces
    <!-- loom:provenance v1 build=unknown 02ecafe7734bf5faa945ce88940589f00eca78e9 clean prompts=none sweep=none story=none trace=5f71c537126994dc4c45179122427514 host=robb-pro base=d4011f465950fda6ef9bb7f3fd20e6c2aed652be run=loom-run/v1:timer:robb-pro/fleet-resync:6293e6da-8a67-45aa-b277-c9ef85ddb810 installs=0.19.1100 cb68783ad2c0695020e726d2ad67dac2fa9e501e -->
    Loom-Trace-Id: 5f71c537126994dc4c45179122427514
    Loom-Build: unknown 02ecafe7734bf5faa945ce88940589f00eca78e9 clean
    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
2026-10-12 chore: resync installed Loom surfaces
    <!-- loom:provenance v1 build=unknown 5918da96dcd60c9a677a195737c86ea38972d215 clean prompts=none sweep=none story=none trace=49bb7a8942d6a23bf41754ca27ff2368 host=loom-worker-2 base=1982d4af49ecbb2d58378dd8f7471b660ca53abc run=loom-run/v1:timer:loom-worker-2/fleet-resync:2e973f04abd1447d8ee4b696c2e7d2b4 installs=0.19.1105 e2b4f1275335364979ea8d4f1364e7a9c30cf3f3 -->
    Loom-Trace-Id: 49bb7a8942d6a23bf41754ca27ff2368
    Loom-Build: unknown 5918da96dcd60c9a677a195737c86ea38972d215 clean
    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
2026-10-12 chore: resync installed Loom surfaces
    <!-- loom:provenance v1 build=unknown 9885e6bbba36f53328e04be83140734c6eda9f58 clean prompts=none sweep=none story=none trace=72f34c4066d6ca844a10c33035a775bd host=loom-worker-1 base=33aa8a3001b5ad7432817e12e36167268bb074c7 run=loom-run/v1:timer:loom-worker-1/fleet-resync:8f5732bc51fd43379e17e0de51e86bae installs=0.19.1108 72427939d156341080a7006ae6fbb5ec96b2368e -->
    Loom-Trace-Id: 72f34c4066d6ca844a10c33035a775bd
    Loom-Build: unknown 9885e6bbba36f53328e04be83140734c6eda9f58 clean
    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
2026-10-12 chore: resync installed Loom surfaces
    <!-- loom:provenance v1 build=unknown 01467247f32c59822968bf02d3214d9a3d613452 clean prompts=none sweep=none story=none trace=0e97e9733eef09a33959cf96e6271f40 host=robb-studio base=75ca23d8567b9dee25bdfa10122c4619d83126a5 run=loom-run/v1:timer:robb-studio/fleet-resync:53a4d390-3842-4216-9018-5dced9d0ea17 installs=0.19.1109 d9498fcd419776b2517e30b99c88e76bbe92d2f4 -->
    Loom-Trace-Id: 0e97e9733eef09a33959cf96e6271f40
    Loom-Build: unknown 01467247f32c59822968bf02d3214d9a3d613452 clean
    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
2026-10-12 chore: resync installed Loom surfaces
    <!-- loom:provenance v1 build=unknown acadc2b4b0e852f2d889ac9dec616e1548705802 clean prompts=none sweep=none story=none trace=a69edb348af7f0e67b3bc77bc33b1bfc host=loom-worker-2 base=f6807812d42cc63b46a8fc2e2df6a93f39e0f74b run=loom-run/v1:timer:loom-worker-2/fleet-resync:0923627ffda84cf69ec2486475772b10 installs=0.19.1126 7736d1276b6d01778fba3461114c858ef1bf5e2d -->
    Loom-Trace-Id: a69edb348af7f0e67b3bc77bc33b1bfc
    Loom-Build: unknown acadc2b4b0e852f2d889ac9dec616e1548705802 clean
    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
2026-10-12 chore: resync installed Loom surfaces
    <!-- loom:provenance v1 build=unknown 8d832cc8035d4ba07872510416468da0790332cd clean prompts=none sweep=none story=none trace=09a53bf60e96fc30a753caffd1de8c92 host=robb-studio base=f3d5199179aaeb6a1502996750812a10d07b591a run=loom-run/v1:timer:robb-studio/fleet-resync:baf4c30c-65d9-4d4e-a740-f6a80cbb975c installs=0.19.1132 8695bdd2b7b963dca9b76f4643a9d7c744294426 -->
    Loom-Trace-Id: 09a53bf60e96fc30a753caffd1de8c92
    Loom-Build: unknown 8d832cc8035d4ba07872510416468da0790332cd clean
    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
2026-10-12 chore: resync installed Loom surfaces
    <!-- loom:provenance v1 build=unknown aa1ed0d7d5499d2705977d971673d919dbbbaf4e clean prompts=none sweep=none story=none trace=2522608826ef5d5e4a88a9667055aeb7 host=loom-worker-2 base=b61b78ebae5c3ef8d24eb59b29b73473de160ecb run=loom-run/v1:timer:loom-worker-2/fleet-resync:8f26b719c712455381744111c50e90b4 installs=0.19.1142 b91ae5d1b5204f499a1abb875a6cf5bffc1d90b1 -->
    Loom-Trace-Id: 2522608826ef5d5e4a88a9667055aeb7
    Loom-Build: unknown aa1ed0d7d5499d2705977d971673d919dbbbaf4e clean
    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
2026-10-12 chore: resync installed Loom surfaces
    <!-- loom:provenance v1 build=unknown 8b64614d017d6ce7491c3a2ac9da51e5e2901c97 clean prompts=none sweep=none story=none trace=66044c049ba635bcd6a4797c3a77e84b host=robb-pro base=1b1a2970eff83f2d53e6831d7572709fdd6c26e8 run=loom-run/v1:timer:robb-pro/fleet-resync:68f56594-05d0-4cc0-9c07-36263359d698 installs=0.19.1144 9e4381cbbd2386393e44c7a979583252948a3998 -->
    Loom-Trace-Id: 66044c049ba635bcd6a4797c3a77e84b
    Loom-Build: unknown 8b64614d017d6ce7491c3a2ac9da51e5e2901c97 clean
    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
2026-10-13 chore: resync installed Loom surfaces
    <!-- loom:provenance v1 build=unknown 98d08ab78cc223361354ee9947d996b1cb914b30 clean prompts=none sweep=none story=none trace=8b73addcdeaa8fbd65998649f42a8c50 host=loom-worker-2 base=6b3907342045cecb2fe64a4b3764ab9f2682dfb0 run=loom-run/v1:timer:loom-worker-2/fleet-resync:3bfb13d52fca425f9cfced4541954cb6 installs=0.19.1148 1448fdfa79ac2dcab7fad6b95b72697b450f2a4a -->
    Loom-Trace-Id: 8b73addcdeaa8fbd65998649f42a8c50
    Loom-Build: unknown 98d08ab78cc223361354ee9947d996b1cb914b30 clean
    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
2026-10-13 chore: resync installed Loom surfaces
    <!-- loom:provenance v1 build=unknown d0bfbbc7ac309581d7abe02c4a269c7704010ee0 clean prompts=none sweep=none story=none trace=0ad6d167235000f3b5648cbd63d761ce host=robb-pro base=e9a1737d3d45cf0761bea2b6c6fa5820c8116fca run=loom-run/v1:timer:robb-pro/fleet-resync:4f7cbe22-40b6-49ff-8811-003ae8577c28 installs=0.19.1151 08ee0f8708464aa8e0768640d56955d7f4fcbc98 -->
    Loom-Trace-Id: 0ad6d167235000f3b5648cbd63d761ce
    Loom-Build: unknown d0bfbbc7ac309581d7abe02c4a269c7704010ee0 clean
    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
2026-10-13 chore: resync installed Loom surfaces
    <!-- loom:provenance v1 build=unknown 7916c4043a1b57e97a53bc5c111e74c5038a1091 clean prompts=none sweep=none story=none trace=20b27ffb08c4130dc9836ee8d9d97b97 host=loom-worker-2 base=b01b21f43f1a9a976c1c9a2c7df9e6166e81e6a6 run=loom-run/v1:timer:loom-worker-2/fleet-resync:d34532ec625a4162ae8b58dde1a6738f installs=0.19.1151 f7d1deaab02a9c483fce1ced33fadb1af6d86f59 -->
    Loom-Trace-Id: 20b27ffb08c4130dc9836ee8d9d97b97
    Loom-Build: unknown 7916c4043a1b57e97a53bc5c111e74c5038a1091 clean
    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
2026-10-13 chore: resync installed Loom surfaces
    <!-- loom:provenance v1 build=unknown ac0bbcf6eda99918e88a0b8893d9762b106a2e45 clean prompts=none sweep=none story=none trace=8597ab8a51d68f9f8ee864fa71904bff host=robb-studio base=769a0a4d4559e181cd0d5a0691b8e6e51780e376 run=loom-run/v1:timer:robb-studio/fleet-resync:2ea9dd71-a6b2-4d0c-86aa-859a0728c9b3 installs=0.19.1151 f7d1deaab02a9c483fce1ced33fadb1af6d86f59 -->
    Loom-Trace-Id: 8597ab8a51d68f9f8ee864fa71904bff
    Loom-Build: unknown ac0bbcf6eda99918e88a0b8893d9762b106a2e45 clean
    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
2026-10-13 chore: resync installed Loom surfaces
    <!-- loom:provenance v1 build=unknown 7916c4043a1b57e97a53bc5c111e74c5038a1091 clean prompts=none sweep=none story=none trace=a48d70df8e7252b46c71b88e90ebed02 host=loom-worker-3 base=2d3b6fe2d0aaa1ae86c4d7e28a7aab6b8b1c6f5d run=loom-run/v1:timer:loom-worker-3/fleet-resync:08e4e415b6434bf1ba0456ba59477467 installs=0.19.1151 f7d1deaab02a9c483fce1ced33fadb1af6d86f59 -->
    Loom-Trace-Id: a48d70df8e7252b46c71b88e90ebed02
    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
2026-10-13 chore: resync installed Loom surfaces
    <!-- loom:provenance v1 build=unknown 7916c4043a1b57e97a53bc5c111e74c5038a1091 clean prompts=none sweep=none story=none trace=773e9e41a5730d2f79f2381ad2cde068 host=robb-pro base=2cc41cf04996200ccac58eed7c3443c2775ce6cc run=loom-run/v1:timer:robb-pro/fleet-resync:b7ca0d34-434e-4536-85b9-57adfa603a8d installs=0.19.1151 a885af872d054695b81e8458dfc7bd717cbddba8 -->
    Loom-Trace-Id: 773e9e41a5730d2f79f2381ad2cde068
    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
2026-10-13 chore: resync installed Loom surfaces
    <!-- loom:provenance v1 build=unknown f57244868aa20ef22c18aa8025972184aaea43e4 clean prompts=none sweep=none story=none trace=8e03b78fe6cb43a017c4a4823362ffa7 host=loom-worker-2 base=dd7b13071fbc124d3b91d9fd0191c73970b065e0 run=loom-run/v1:timer:loom-worker-2/fleet-resync:eb553d2fc2a54589aa37879f12b18ed5 installs=0.19.1151 4b3b3e77e5ef42971b3c0c3e68c000736a0c7c21 -->
    Loom-Trace-Id: 8e03b78fe6cb43a017c4a4823362ffa7
    Loom-Build: unknown f57244868aa20ef22c18aa8025972184aaea43e4 clean
    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
2026-10-13 chore: resync installed Loom surfaces
    <!-- loom:provenance v1 build=unknown 9cd23bf22bf48ed3837f643ea76ec2e5f01ae46a clean prompts=none sweep=none story=none trace=ab3a71ce89f6ba9ad4c2753c3377bcf1 host=loom-worker-1 base=02b0ad0bffc153391e82e0704fbe1f76c8053a18 run=loom-run/v1:timer:loom-worker-1/fleet-resync:79a3b089c6f54c91bd32db3274e8133c installs=0.19.1151 a9d9bfc13e966655d6d847cb6876af523bc4a4c4 -->
    Loom-Trace-Id: ab3a71ce89f6ba9ad4c2753c3377bcf1
    Loom-Build: unknown 9cd23bf22bf48ed3837f643ea76ec2e5f01ae46a clean
    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
2026-10-13 chore: resync installed Loom surfaces
    <!-- loom:provenance v1 build=unknown 6fe43c87955e02019c2bc8dfad4fbd160b89170c clean prompts=none sweep=none story=none trace=49a4590bf54e81899c26d965f682504c host=robb-studio base=81a298bdeee5fc646c707b54175684a7a58b54ac run=loom-run/v1:timer:robb-studio/fleet-resync:459197b3-0050-4335-893e-e47b638eb819 installs=0.19.1151 4ec7e046f71ff70b92c88ed647cff72d6a9d1e85 -->
    Loom-Trace-Id: 49a4590bf54e81899c26d965f682504c
    Loom-Build: unknown 6fe43c87955e02019c2bc8dfad4fbd160b89170c clean
    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
2026-10-13 signoff: grade item 11 on released klt 0.7.0; regenerate its ERC evidence
    PR #351's operator ruling declined item 11's met while its evidence rested
    on an unreleased build: regenerate layout/reports/temp_por_top/erc_supply.json
    with the released klt 0.7.0, move the grader pin to 0.7.0, and regrade.
    - Grader pin (signoff/toolchain.json), CI install, check.py hint and the
    grader-naming README lines move to klayout-tools==0.7.0.
    layout/toolchain.json (the DRC/LVS producer pin) is unchanged at 0.6.0.
    - klt 0.7.0 rejects unknown erc-spec keys (klayout-tools#2243) and has no
    comment convention, so the spec's 291-line inline _comment justification
    block moved verbatim to
    layout/cells/tem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
2026-10-13 chore: resync installed Loom surfaces
    <!-- loom:provenance v1 build=unknown 5dc3a07d084d0ec4034f0782d572925dcad86af7 clean prompts=none sweep=none story=none trace=cbc11657acadf58858409fe543c342e1 host=robb-pro base=f699671282d8f0432df626586bb786001a8f00a4 run=loom-run/v1:timer:robb-pro/fleet-resync:be586137-d91e-4e2c-82d6-3164d43aa9de installs=0.19.1152 2d5fe17958dca799058f16bdd74a12336990bec0 -->
    Loom-Trace-Id: cbc11657acadf58858409fe543c342e1
    Loom-Build: unknown 5dc3a07d084d0ec4034f0782d572925dcad86af7 clean
    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
2026-10-13 chore: resync installed Loom surfaces
    <!-- loom:provenance v1 build=unknown 27a266d5a27885323290840d2a837d73fcf4bcc6 clean prompts=none sweep=none story=none trace=e77cdd5477ef6bfc65fba6cc233788e0 host=loom-worker-2 base=b17235a7f354ccfa4f7100a878e34040462c59ed run=loom-run/v1:timer:loom-worker-2/fleet-resync:7fac7d82f298441a91761382ac989183 installs=0.19.1152 43f03f1fe0988c7870431d6bba187c13018b4420 -->
    Loom-Trace-Id: e77cdd5477ef6bfc65fba6cc233788e0
    Loom-Build: unknown 27a266d5a27885323290840d2a837d73fcf4bcc6 clean
    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
2026-10-13 chore: resync installed Loom surfaces
    <!-- loom:provenance v1 build=unknown f2b62a2cf576d7d37092147b2281da809f8b5cf5 clean prompts=none sweep=none story=none trace=8adfa75521c72dded43e2932febb6329 host=loom-worker-3 base=7c8bac3ef86c91a453abfb43389cc6222d00f10f run=loom-run/v1:timer:loom-worker-3/fleet-resync:8a8198f8f80e4703bc7365a5e10595e0 installs=0.19.1152 8d16eec5f10d705602ac4d1ab871c57266f1aa45 -->
    Loom-Trace-Id: 8adfa75521c72dded43e2932febb6329
    Loom-Build: unknown f2b62a2cf576d7d37092147b2281da809f8b5cf5 clean
    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
2026-10-13 chore: resync installed Loom surfaces
    <!-- loom:provenance v1 build=unknown 84d11f248d368cae5e04a2255f6897a406c50089 clean prompts=none sweep=none story=none trace=8e50b4ccc3dc58f709a732f69d58fd44 host=robb-studio base=3a31acc9b8d522a6d77417e3e381633802a6c083 run=loom-run/v1:timer:robb-studio/fleet-resync:05c9f3b1-eee2-412f-8996-5fbf02793d9e installs=0.19.1153 d8429a4fabdc955107af1cbc22c548e23eecf9b1 -->
    Loom-Trace-Id: 8e50b4ccc3dc58f709a732f69d58fd44
    Loom-Build: unknown 84d11f248d368cae5e04a2255f6897a406c50089 clean
    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
2026-10-15 feat(signoff): cite audited, hash-bound evidence for T1 items 1, 2, 9, 10
    Adds four generic envelopes bound to audited artifacts (klt 0.7.0 artifact
    binding): design-source, testbench and repo-hygiene inventories that carry
    a sha256 per member file, and the assembled top-cell GDS for layout.
    signoff/inventories.py is the only writer and the verifier; check.py now
    fails on a changed, deleted or newly added member and on any
    manifest/envelope/artifact disagreement, and --regen refuses to write
    when the audit fails. Verdict moves from 4/11 to 8/11.
    Loom-Story: 2AMLogic/gf180-temp-por#348
    Loom-Trace-Id: 61fd7b824a843360c5fa038c79f7399a
    L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
2026-10-15 feat(sim): add --klt-pin to pin the batch client to the runner's klt version
    sim/selftest.sh and the harness CLIs can now submit with a throwaway
    uvx environment at an explicit klayout-tools version, and selftest
    forwards --klt / --klt-pin. Runner/client mismatch refusal is unchanged.
    Loom-Story: 2AMLogic/gf180-temp-por#346
    Loom-Trace-Id: a933df96b1798653b80bd10f30048c80
    Loom-Build: 0.19.1166 8a9aad12e32504cea9a7c7d2ed774749c487f875 clean
2026-10-15 chore(signoff): regenerate testbench inventory for harness README change
    sim/harness/README.md documents the new --klt-pin option; the T1 item 9
    inventory pins its hash. Regenerated with python3 signoff/check.py --regen
    (inventory, item-9 envelope, block manifest binding). No spec change.
    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
2026-10-15 fix(sim): make --klt and --klt-pin mutually exclusive in either order
    Use an argparse mutually exclusive group instead of an order-dependent
    check inside the --klt-pin action, so '--klt-pin V --klt X' is rejected
    too. Add the reverse-order case to the test.
    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
2026-10-21 ci: pin checks job to ubuntu-24.04 so the Python 3.9 leg can install
    ubuntu-latest now resolves to Ubuntu 26.04, for which the
    actions/python-versions manifest has no 3.9 build, failing setup-python
    on every run. Pin the checks job only; the 3.9 floor is unchanged.
2026-10-21 signoff: re-inventory ci.yml after runner-image pin
    Regenerated with python3 signoff/check.py --regen under the pinned
    klt 0.7.0; only the ci.yml hash and the item-10 pins that bind it change.
2026-10-23 feat: send new sim evidence bytes to the artifact store, commit a manifest
    Raw per-corner logs and the netlist snapshot of a new run are staged in a
    git-ignored directory and stored with klt artifact put; git keeps
    manifests/artifacts/<experiment>-<record-id>.manifest.json and the summary
    record. The writers fail closed (no broker, no artifact put, failed put).
    Adds scripts/check_artifact_manifests.py to CI and DR-030. Existing
    committed evidence is untouched.
2026-10-27 chore(signoff): pin grader to klt 0.8.0 and declare item 5 spec_rows as gaps
    Move the grading pin from klt 0.7.0 to 0.8.0, the only release newer than
    0.7.0 and the first that reads spec_rows. Declare every measured/derived
    row of the testbench inventory as a gap under spec_rows."5", each naming
    the issue that will cover it. Regenerate tier-report.json with the pinned
    tool; item verdicts are unchanged (item 5 stays unmet/no_evidence until an
    envelope is cited).
2026-10-27 feat(sim): stage klt pex requests and a measure-command driver for temp_por_top
    Adds sim/pex/build_requests.py (re-expresses a full-assembly experiment as a
    klt sim request whose DUT is a single .include) and sim/pex/measure.py (the
    klt pex --measure-command driver; patches the extracted leg's bipolar model
    and well ties, and runs both legs through klt sim).
2026-10-27 feat(signoff): cite a klt pex report for T1 item 7 (met, 9 of 11)
    Cites layout/reports/temp_por_top/pex.json (por-vth, 81 corners, run on the
    batch fleet) for item 7, declares the other post-layout rows as gaps, and
    states body_bias: unbiased and the extracted-leg patches in signoff/README.md.
    Regenerates tier-report.json with the 0.8.0 grader; only item 7 and the
    item 9 inventory pin change.
2026-10-27 chore: remove truncated .loom/manifest.json.tmp install leftover
    The file is an interrupted atomic-write temp file from an installer run.
    It is not valid JSON (truncated at char 39103), has no final-manifest
    counterpart, and nothing reads it. .gitignore already ignores .loom/*.tmp,
    so no ignore change is needed.
2026-10-27 fix(design): install klt in pdk-checks, report missing klt as ExportError
    - ci.yml: pdk-checks installs a pinned klayout-tools (separate pin from the
    signoff grader) so design/netlist.py --check can run klt netlist.
    - netlist.py: a missing klt raises ExportError instead of a traceback.
    - design/README.md: list klt as a requirement; rewrap the edited paragraph.
2026-10-27 chore(signoff): regenerate repo-hygiene inventory for ci.yml quoting
    The only ci.yml change in this PR is quoting the manifest-check step name
    so the workflow parses. Regenerated with signoff/check.py --regen; only the
    ci.yml hash binding changed (inventory-repo-hygiene, t1-item-10, manifest pin).
2026-10-27 chore(signoff): re-pin repo-hygiene inventory after merging main
2026-10-28 fix(signoff): refresh stale item-10 hash, fail on stale citation hashes, correct README verdict
    Regenerate signoff/tier-report.json with the pinned klt 0.8.0 so item 10's
    citation and artifact_binding hashes match the current repo-hygiene
    inventory. README now states 9 of 11 items met (items 5 and 6 unmet) and
    points at signoff/toolchain.json for the grader pin instead of a
    hard-coded version.
    check.py now also fails when a content hash cited by the committed report
    differs from the freshly graded one, even when every verdict is unchanged;
    projection() is left as-is so new citation fields still do not count as rot.
2026-10-28 fix(pex): stage brownout/ramp-rate/accuracy requests; keep no-value meas and good report
    Extend the default slug set to por-brownout, por-ramp-rate and
    temp-accuracy-vt and stage their klt sim requests. A .meas that yields no
    value (threshold never crossed) is now passed on as value=null/status=error
    instead of aborting the measurement driver, and run_pex.sh only replaces the
    committed report on klt pex exit 0 or 4. Default the sim client to 0.8.0 to
    match the batch runner.
2026-10-29 feat(pex): klt pex evidence for brownout, ramp-rate and temp-accuracy-vt
    Regenerate layout/reports/temp_por_top/pex.json over four temp_por_top
    experiments (351 corner decks, 9153 delta rows, 48 errored) via
    klt pex --backend batch. Drop the eight covered spec_rows."7" gaps, re-point
    the cell-level gaps at #393 and keep temp-accuracy-trimmed as a named gap
    (derived, not re-expressed as a .meas). Item 7 now grades unmet/check_failed
    because the schematic leg yields no value for six por-brownout measurements
    at eight corners; the README says so rather than relaxing anything.
2026-10-29 docs(por-brownout): root-cause the schematic leg's missing re-assert at 8 corners
    Single-corner waveform shows RESETn tracking the rail through the 1 us-edge
    dip and the post-recovery POR_RAW pulse (~16 us) falling short of the
    deglitch dwell, so the schematic never re-asserts while the extracted leg
    does. set wnflag=1 changes nothing. Item 7 grade stands.
2026-11-06 feat(signoff): grade the [3σ] rows with klt yield reports (T1 item 6)
    Re-express the committed N=500 Monte Carlo logs as klt yield sample sets,
    commit one report per row set, declare spec_rows."6", and move the grader
    pin to klayout-tools[yield] 0.9.1. Item 6 now grades unmet/check_failed with
    no row uncovered: the temperature rows miss their target yield and the POR
    rows are undersized for a 99.73 % claim at N=500. No limit or spec row changed.
2026-11-06 layout: remove the one-point postlayout smoke script and re-point its citations
    The nominal-corner smoke script and its SMOKE.md table are superseded by the
    81-point post-layout re-run records under sim/*/testbench-postlayout. The
    design docs that cited SMOKE.md for the +2.0 % reset-release shift now cite
    the schematic and extracted grid records at tt_27c_3.30v (10.068 ms ->
    10.2704 ms, +2.01 %). The generated layout/reports/*/postlayout-smoke.json
    reports are results and stay unchanged.
2026-11-06 feat(sim): route run_mc.py samples through the klt sim batch backend
    Add --backend {local,batch,auto} (and KLT_SIM_BACKEND) to run_mc.py. Under
    batch each Monte Carlo sample is submitted as its own klt sim request and the
    returned raw log is copied byte-for-byte to the usual per-sample path; no
    local ngspice is started and any batch failure is an error outcome. Seeds
    and the record format are unchanged. Local stays the default.
2026-11-06 test(sim): make the fake klt's request numbering race-free
    The fake klt picked its req-N/body-N index with a glob count, a
    check-then-write race once the MC grid runs it with jobs=2: two processes
    could take the same index and one body overwrote the other (5 bodies for
    6 samples). Claim the index with an exclusive create instead.
2026-11-06 feat(sim): define seeded known-bad variants of the two yield campaigns
    Add sim/temp-accuracy-mc-defect/ and sim/por-threshold-mc-defect/: each is
    its nominal Monte Carlo testbench plus one top-level shunt resistor (a
    10 Mohm leak from temp_core's NB node, a 100 Mohm leak from por_comparator's
    SNS node), an independent seed range and the unchanged row limits. A guard
    test pins that nothing else differs from the nominal sibling.
    No sampled control run is recorded yet, so the sample sets still declare no
    negative_control; the signoff README says so. The temperature deck needs two
    dc solves per die (klt sim takes one analysis per request) and the POR
    campaign submits one request per sample, far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
2026-11-06 refactor(sim): share one local grid loop and drop single-call batch wrappers
    Add runner.run_local_grid for the ordered, optionally threaded loop used by
    run_grid and run_mc_grid, and inline run_batch_grid into each dispatcher,
    removing run_grid_batch and run_mc_grid_batch. No behavior change.
2026-11-07 sim: submit MC samples via one klt --batch-set and accept multi-solve decks
    run_mc.py --backend batch now stages every sample as a request file and
    hands the whole set to a single `klt sim --batch-set` call (bounded
    --max-in-flight, --wait-for-capacity, --capacity-retries) instead of one
    blocking request per sample. A refused or malformed member becomes a
    per-sample error record; it is never dropped.
    Decks with more than one control-block solve (the 25 C + binding-point
    temperature readings) are translated into klt's analysis_steps[] with
    derived measurements carrying the deck's own print names, so
    derive_temp_trim sees the same inputs. Local behavior is unchanged.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
2026-11-10 refactor(sim): route Monte Carlo samples through run_point via compose=
    Add a compose keyword to runner.run_point and call it from run_mc_grid
    with compose_mc_deck, deleting the near-verbatim run_mc_point copy. A
    failed MC sample's message now carries the ngspice exit code and the
    shared error regex. The spiceinit test is folded into test_harness and
    parametrised over both composers.
2026-11-10 chore(signoff): regenerate T1 item 9 testbench inventory after sim/harness changes
    Ran python3 signoff/check.py --regen with klayout-tools 0.9.1 (the CI pin).
    Only content-hash pins changed; verdicts are unchanged (8/11).
2026-11-13 refactor(sim): add runner.run_decks and call it from the seven control-script pools
    Seven control scripts each carried the same "run a list of named decks in a
    thread pool and key the measurements by deck name" block around
    runner.run_deck, differing only in the worker cap and in whether the backend
    arguments were forwarded. Only two of the seven could reach the batch backend,
    because adding it meant hand-editing each script's pool block.
    Move that loop next to run_deck as runner.run_decks(jobs, control_dir,
    workers, backend=..., batch=...) and call it from all seven sites. Each
    caller keeps the cap it already passed (8, 6, 4, or args.jobs), so local
    behavior is unchanged; run_net_attributi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
2026-11-13 fix(sim): sweep the lifted vdd_val on klt's parameter axis, not its supply axis
    `translate_deck(..., lift_params=("vdd_val",))` dropped the `.param
    vdd_val=...` card from the staged body and `_build_request` emitted the
    per-corner values as `corners.supply_v`. klt's supply axis is an `alter
    <source>=<value>` on a voltage source, so a `.param` name on it addresses
    nothing: klt refused every smoke-bias batch request before dispatch with
    "corners.supply_v key 'vdd_val' names no element and no .param".
    Sweep the values on `corners.params` instead (`alterparam` + `reset`), and
    keep a top-level `.param <name>=0` declaration in the staged body, which
    that axis requires. The sentinel is constant ac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
2026-11-13 fix(pex): refuse a swept supply axis under either klt request key
    `sim/pex/build_requests.py` stages one `klt sim` request per (temperature,
    supply) with `.param vdd_val` written into the body as a literal, and
    guarded that assumption with an inline check on `corners.supply_v` plus
    `exclude`.
    Which key carries a lifted `.param` is an implementation detail of
    `klt_batch._build_request`, and it moved: as of #466 (merged
    2026-11-13) a lifted parameter lands under `corners.params`, so the
    `supply_v` half of the guard can no longer fire. The guard is not reached
    today -- `stage()` passes `lift_params=()`, so neither key is present --
    but a later change that lifted `vdd_val` on this path with a d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
2026-11-13 fix(sim): pass --wait-for-capacity on the single-request batch submit path
    `invoke_klt` built its `klt sim` command without `--wait-for-capacity`, so
    every submit not going through `--batch-set` got exactly one launch attempt
    and failed outright when the vCPU-budgeted fleet refused it. Its existing
    re-submit loop only matches `exceeds BATCH_MAX_CONCURRENT_INSTANCES`, so a
    `BATCH_MAX_VCPU` refusal was never retried either. Every `BatchConfig` built
    without `batch_set=True` goes through that path: `run_corners.py` via
    `cli.py`, two control scripts, and `runner.run_deck_raw`.
    Pass `--wait-for-capacity cfg.wait_for_capacity_s` (default 600) there, and
    add the same term to the client-side subpro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
2026-11-13 feat(sim): refuse a batch result whose runner read a different PDK build
    On the batch backend the device models come from the fleet runner's own PDK
    image, but the harness recorded the install `find_pdk()` resolved on the
    submitting host. The two differ on the current worker image (two gf180mcuD
    installs, different open_pdks builds), so a record could name a build the
    simulation never read.
    `klt_batch._collect_group` now compares the SHA-256 of `cfg.pdk.model_lib`
    with `environment.remote.runner_models_lib_sha256` and refuses klt's own
    `models_lib_comparison: "mismatch"`, in the one seam every batch path passes
    through, next to the existing `runner_compatibility` check. A difference
    raises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
2026-11-13 chore(signoff): regenerate T1 item 9 testbench inventory after the README change
    This PR edits sim/harness/README.md, which is a cold-start doc anchored in
    signoff/evidence/inventory-testbenches.json, so signoff/check.py failed with
    "sim/harness/README.md: changed since it was inventoried" and took the four
    signoff/tests cases that drive the gate down with it on both Python legs.
    Ran python3 signoff/check.py --regen with klayout-tools 0.9.1 -- the grader
    pin in signoff/toolchain.json, which is also what CI installs -- from a
    throwaway venv, not the host's newer klt. Regenerating with the host build
    would have rewritten the whole tier-report `build` block and its
    grading_ruleset_id to a non-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
2026-11-13 test(layout): drop the retired #97 drift fallback from the temp_por_top assembly check
    `TempPorTopAssemblyTest.test_reference_matches_the_committed_file` carried a
    74-line workaround for a gap that closed when #97 re-derived the assembly's
    floorplan: a fresh `lr.build("temp_por_top")` was expected to run ahead of the
    committed reference by #90's and #91's drawn passives and issue #56's XMRLK, so
    the test pruned those from `lr.CELLS` and compared a re-derived "pre-drift"
    build instead.
    On the current tree `lr.build("temp_por_top")` equals the committed 244-line
    reference byte for byte, so the method's early return is always taken and the
    fallback below it is dead -- and were it ever reached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
2026-11-13 refactor: drop unused RESERVED layer, add_cell and RESISTOR_MODEL
    Three definitions in the layout generator had no caller, and each carried
    prose presenting behaviour the code no longer has:
    - `RESERVED = (200, 0)`, the repo-local annotation layer. Never passed to
    `CellBuilder._layer()`, so no cell ever drew on it; DR-028 already records
    it as "used by no cell". The module docstring still listed it as a live
    layer and pointed the reader at `bias_core`'s and `por_comparator`'s
    docstrings for reservations that #90/#91/#92 replaced with drawn devices.
    - `CellBuilder.add_cell()`, which started a sibling top cell. `temp_core`'s
    own docstring has recorded the sibling top cells as gone s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
2026-11-13 docs: describe the drawn divider in the SNS/SNSB track comment
    The comment above POR_COMPARATOR_TRACKS called the sense divider
    "(undrawn)" and said both tracks run out to a "reserved divider region".
    Neither is true since #91/#92: por_comparator draws the divider via
    _divider_resistor_lengths(), and layout/README.md records every reserved
    region as gone.
    Reword the two lines to describe what the code actually does. SNS and
    SNSB stop just east of the device row and escape onto Metal2 there,
    because a Poly2 track spanning the divider would bridge the folded
    resistor legs -- the constraint the SNS/SNSB escape block in
    por_comparator already explains at the point it is implemented.
    Comment-on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
2026-11-13 refactor(sim): drop the unreachable commit-the-bytes write path from the harness
    DR-030 retired committing a run's raw logs and netlist snapshot and
    deliberately left no fallback that does, but the harness still carried
    that fallback as a default-off keyword on two shared helpers, so the code
    read as if a run could choose between two storage modes. Both entry
    points (sim/harness/cli.py, sim/run_mc.py) always staged, so the arm was
    reachable only from unit tests calling the helpers with their old
    defaults.
    Removed:
    - `stage` on `cliutil.provision_record` / `cliutil.finish_run`, with the
    tracked-`corners/` `log_dir` arm and the unstaged write arm it selected.
    `provision_record`'s `experi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
2026-11-13 refactor(sim): drop five unread constants from three control scripts
    `VDD_SAMPLE_UP_V`, `VDD_SAMPLE_DN_V`, `PARENT_TSTOP_S`,
    `FALSE_VALID_ERR_V` and `DIVIDER_RATIO` were each assigned once and read
    nowhere. Every deck line they appeared to govern carries its own literal:
    the two sample points live in `run_ramp_feedthrough.py`'s `.meas` strings,
    the 100 mV false-valid threshold lives in `starved_window.spice`'s `Bfob`,
    and the divider ratio is already computed from the drawn resistor lengths
    as `TAP_SHORTED` / `TAP_RELEASED`. `PARENT_TSTOP_S` governed nothing at
    all; Part B's stop time is `PART_B_TSTOP_MS`.
    The cost was not the lines but the false affordance: editing one of these
    to re-run a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
2026-11-13 refactor(sim): drop selftest.sh --quick, whose single point always fails the grid checks
    sim/smoke-bias carries two grid-scoped min_spread_pct checks (vbias >= 5%,
    vbe >= 20%) that assert the corner/temperature sweep actually moved. --quick
    restricted the run to one tt/27C/nominal point, so the spread was always 0 and
    both checks always failed: the mode could not pass, and --quick --record would
    have minted an append-only FAIL record under sim/smoke-bias/records/.
    Removes the usage line, the QUICK flag and its option arm, the single-point
    --corners/--temps/--supply-tol override and the --subset-reason block, and
    narrows the -h range to match the shorter usage block. --quick is now rejected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
2026-11-14 signoff: re-anchor T1 item 10 after the README verdict-line fix
    README.md is pinned by content_hash in
    signoff/evidence/inventory-repo-hygiene.json (T1 item 10), so this PR's
    one-line correction of the T1 verdict sentence invalidated the anchor and
    took the ERC freshness gate red on both Python legs:
    FAIL signoff/evidence/inventory-repo-hygiene.json:
    README.md: changed since it was inventoried
    Regenerated with `python3 signoff/check.py --regen` under the grader
    signoff/toolchain.json pins (klt 0.9.1, installed into a throwaway venv --
    the host carries a 0.9.2.dev build, and regenerating under it rewrites the
    whole build block as noise; same trap as PR #473). The run reported
    "ok g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
